2AMLogic/sky130-gcedram/design/README.md

# design

First design-sources increment (issue #14, T1 item 1 of the gap tracker,
#13): the 2T gain-cell bitcell schematic and its derived SPICE netlist.
Per [`docs/design-evidence-tiers.md`](https://github.com/2AMLogic/klayout-tools/blob/main/docs/design-evidence-tiers.md),
the pass condition is committed design sources **plus** a derived netlist
that is regenerated on design change -- presence and reproducibility, not a
one-off drop. This directory establishes that convention for the block; it
has no prior xschem usage to pattern-match against.

## What's here

| File | Purpose |
|---|---|
| [`gain_cell_2t.sch`](gain_cell_2t.sch) | xschem schematic: the ratified 2T gain-cell bitcell (see "Topology" below). |
| [`gain_cell_2t.spice`](gain_cell_2t.spice) | SPICE netlist **derived** from the schematic above via [`regen_netlist.sh`](regen_netlist.sh) -- not hand-written. Carries a provenance header (sha256 of the source `.sch`). |
| [`sense_latch.sch`](sense_latch.sch) / [`sense_latch.spice`](sense_latch.spice) | xschem schematic and derived netlist (same provenance-header convention) of the sense latch with footer/header (issue #109); see "Sense latch" below. |
| [`column_periphery.sch`](column_periphery.sch) / [`column_periphery.spice`](column_periphery.spice) | xschem schematic and derived netlist (issue #114, revised by #117) of the column-periphery slice: RBL and reference-side precharge PMOS, WBL write driver, rbl/ref nfet isolation gates. Sizing rationale, the ideal-vs-real comparison and the #117 isolation/driver sweep: [`sim/column-periphery/README.md`](../sim/column-periphery/README.md). |
| [`test_column_periphery.py`](test_column_periphery.py) | Stdlib drift test: the slice devices of the final variant (`f00_*`) of the #117 study deck must equal `column_periphery.spice`; the study baseline (`i00_*`) must equal the frozen #114 deck (which the revised schematic no longer equals); the latch devices of every instance must equal `sense_latch.sch`'s netlist; the netlist provenance hash must match the schematic. |
| [`regen_netlist.sh`](regen_netlist.sh) | Regenerates every netlist (bitcell, sense latch, column periphery) from its schematic (`--check` verifies each committed netlist is not stale). This is the "reproducible on design change" mechanism. |
| [`normalize_netlist.py`](normalize_netlist.py) | Evaluates xschem `expr()` geometry params and rewraps lines, so the netlist is identical across xschem versions (3.4.4 leaves them unevaluated). |
| [`test_sense_latch.py`](test_sense_latch.py) | Stdlib drift test: the latch devices in `sense_latch.spice` must equal those in `sim/sense-stage/sense_stage.spice`. |
| [`xschemrc`](xschemrc) | Project-local xschem config: resolves the sky130 PDK's symbol library without depending on `~/.xschem`. |
| [`env.sh`](env.sh) | Exports `PDK_ROOT`/`PDK` for interactive `xschem` sessions and for `regen_netlist.sh`. |

The PDK version pin itself (same `open_pdks` commit as `sim/leakage/` and
`sim/bitcell-transient/`) lives in [`docs/pdk-pin.md`](../docs/pdk-pin.md),
not a per-directory `pdk.json` -- see that doc for the single canonical
source and the shell/Tcl mirror `env.sh`/`xschemrc` above carry.

## Topology: 2T, ratified

This is the **2T** gain-cell bitcell (`2T-min`), per
[`spec/retention-refresh-budget.md`](../spec/retention-refresh-budget.md)
Section 6 ("this macro's baseline bitcell topology is ratified as 2T
(`2T-min`)"). It is **not** 3T -- the schematic deliberately has no third,
dedicated read-access device between the read transistor's drain and the
read bitline (the classic 3T addition that spec Section 6 explicitly
declines to adopt as the baseline).

Two devices, both `sky130_fd_pr__nfet_01v8` (the sky130 core 1.8 V NMOS --
no other `sky130_fd_pr` flavour appears anywhere in this schematic):

| Device | Gate | Drain | Source | Body | Sizing |
|---|---|---|---|---|---|
| `M_WR` (write-access) | `wl` | `sn` | `bl` | GND | W=0.42 µm, L=0.15 µm |
| `M_RD` (read) | `sn` | `rbl` | `rwl` | GND | W=0.42 µm, L=0.15 µm |

`M_WR`'s geometry is **identical, not merely similar**, to the access
device already measured in
[`sim/leakage/tb_access_leakage.spice.tmpl`](../sim/leakage/tb_access_leakage.spice.tmpl)
(W=0.42 µm, L=0.15 µm, the minimum drawn size the shipped model supports --
see [`sim/leakage/README.md`](../sim/leakage/README.md) "Device choice").
This is a deliberate reuse, not a fresh/independent sizing choice: it keeps
this schematic's write-access device the same physical device the
retention/refresh evidence chain
([`spec/retention-refresh-budget.md`](../spec/retention-refresh-budget.md))
already characterized, so capturing this schematic does not imply or
require a new leakage re-derivation.

`M_RD`'s sizing reuses the same minimum geometry as a first-pass
placeholder. This is **not** yet driven by a read-current or sense-margin
analysis -- no sense-amplifier design exists yet in this repo (the same
pre-design caveat [`sim/retention/README.md`](../sim/retention/README.md)
already carries for its `C_SN`/`delta_V` assumptions). Read-path sizing is
out of scope for this issue and expected to be revisited once sense-amp
work begins.

## Node naming

Kept consistent with [`sim/leakage/README.md`](../sim/leakage/README.md)'s
bias-condition table, since downstream testbenches reference those exact
names:

- **`wl`** -- (write) wordline, gate of `M_WR`. Same name/role as the
  leakage testbench's `wl`.
- **`sn`** -- storage node, drain of `M_WR` / gate of `M_RD`. Same name as
  the leakage testbench's `sn`. **Intentionally not a hierarchical port** --
  it is a genuine internal 2-pin net in the schematic (no external pin),
  matching real silicon, where the storage node has no accessible pin.
- **`bl`** -- (write) bitline, source of `M_WR`. Same name as the leakage
  testbench's `bl`.
- **`rwl`, `rbl`** -- read wordline / read bitline, source/drain of `M_RD`.
  New names (the leakage testbench only exercises the write/access device
  in isolation, so it has no read-path nodes to match); the `r`-prefix
  keeps them unambiguous against `wl`/`bl` while staying in the same
  naming family.

## Wordline drive scheme: plain 1.8 V (not boosted)

Recorded explicitly, per the repo README's "Supply" row ("boosted wordline
is a design decision to record"): **this schematic assumes a plain 1.8 V
wordline** -- `wl` and `rwl` both swing 0 V / `VDD` (the sky130 standard
core rail), **not** a boosted-above-`VDD` scheme.

Consequence, stated rather than silently absorbed: an NMOS pass device
(`M_WR`) driven by a plain-`VDD` wordline can only pull the storage node up
to `VDD - Vgs(M_WR)`, a threshold-voltage drop below a full logic '1' --
now measured and committed across all 15 PVT corners by
[`sim/bitcell-transient/`](../sim/bitcell-transient/README.md) (issue #27),
which supersedes the earlier uncommitted `tt`-only DC smoke check quoted
here (`v(sn) ≈ 1.39 V`): that figure is the `t -> infinity` DC asymptote, and
a real 20 ns wordline pulse reaches only 1.184 V at `tt`/27 °C, of which
wordline-to-storage-node feedthrough leaves 1.030 V retained -- with the
0.9 V sense margin `sim/retention/` assumes unattainable at three corners
(`fs`/-40 °C, `ss`/-40 °C, `fs`/27 °C). This schematic does not attempt to
compensate for that drop
(no charge pump / level-shifter is included) -- that is an open item for a
future write-margin analysis, not a claim that plain-`VDD` writing is
lossless. It does **not** change any already-ratified retention number:
[`spec/retention-refresh-budget.md`](../spec/retention-refresh-budget.md)'s
worst-case leakage/retention chain evaluates the storage node held at a
full `VDD` (a written logic '1'), independent of how that level got
written.

## Regenerating the netlist

Requires a stock `open_pdks` sky130 install (via `volare`, pinned in
[`docs/pdk-pin.md`](../docs/pdk-pin.md)) and `xschem` on `PATH`.

```bash
# 1. Install/enable the pinned PDK commit (skip if already enabled):
volare enable --pdk sky130 c6d73a35f524070e85faff4a6a9eef49553ebc2b

# 2. Export PDK_ROOT / PDK (defaults to ~/.volare / sky130A if unset):
source design/env.sh

# 3. Regenerate design/gain_cell_2t.spice and design/sense_latch.spice
#    from their .sch sources:
./design/regen_netlist.sh

# 4. Verify the committed netlist is not stale relative to the schematic
#    (no diff => reproducible; this is the check to run in CI/pre-merge):
./design/regen_netlist.sh --check
```

`regen_netlist.sh` also fails if any device instance in the regenerated
netlist resolves to a `sky130_fd_pr` flavour other than `nfet_01v8` -- a
deliberate deviation from the leakage study's device choice would need
this check updated alongside a PR description explicitly calling it out,
per this issue's acceptance criteria.

Interactive editing:

```bash
source design/env.sh
xschem --rcfile design/xschemrc design/gain_cell_2t.sch
```

## Sense latch (issue #109)

[`sense_latch.sch`](sense_latch.sch) is the design source of record for the
latch sense stage that `sim/sense-stage/`, `sim/sense-mismatch/` and
`sim/loaded-column/` characterize (previously it existed only as generated
SPICE under `sim/`). Ports: `rbl`, `ref`, `en`, `enb`, `vdd` (global `GND`);
`vn`/`vp` are internal virtual rails. The ideal precharge switch and the
matched dummy reference are **testbench elements and are not part of this
cell**.

| Device | Type | W (um) | L (um) | D | G | S | B |
|---|---|---|---|---|---|---|---|
| `MN1` | nfet_01v8 (latch) | 1.0 | 0.15 | `rbl` | `ref` | `vn` | GND |
| `MN2` | nfet_01v8 (latch) | 1.0 | 0.15 | `ref` | `rbl` | `vn` | GND |
| `MP1` | pfet_01v8 (latch) | 2.0 | 0.15 | `rbl` | `ref` | `vp` | `vdd` |
| `MP2` | pfet_01v8 (latch) | 2.0 | 0.15 | `ref` | `rbl` | `vp` | `vdd` |
| `MNF` | nfet_01v8 (footer) | 2.0 | 0.15 | `vn` | `en` | GND | GND |
| `MPH` | pfet_01v8 (header) | 4.0 | 0.15 | `vp` | `enb` | `vdd` | `vdd` |

**These sizes are provisional first-pass choices, not optimized.** They are
frozen exactly as `sim/sense-stage/gen_sense_stage.py` instantiates them so
provenance is fixed; this schematic makes no sizing claim, and a later
sizing issue may change them. `python3 -I design/test_sense_latch.py`
fails if the derived netlist and the sense-stage deck (names, model, W/L,
nets) ever diverge. In the deck, per-instance nets carry an `_<instance>`
suffix and ground is `0` (schematic `GND`); the test normalizes both.

## What's out of scope here

Per this issue's non-goals: layout, DRC/LVS, PVT corner sweeps of the full
cell, sense-amplifier design, and array/periphery integration are all
follow-on increments (items 2-7 of the #13 gap tracker) once these design
sources exist. This directory is schematic-capture + netlist-derivation
only.
