2AMLogic/sky130-gcedram/layout/README.md

# layout

First layout increment (issue #15, T1 item 2 of the gap tracker, #13): the
sky130 geometry for the ratified 2T gain-cell bitcell, built from the
schematic/netlist committed by issue #14
([`design/gain_cell_2t.sch`](../design/gain_cell_2t.sch),
[`design/gain_cell_2t.spice`](../design/gain_cell_2t.spice)). Per
[`docs/design-evidence-tiers.md`](https://github.com/2AMLogic/klayout-tools/blob/main/docs/design-evidence-tiers.md)
item 2, the pass condition is a committed GDS **plus** reproducibility from
sources -- presence and reproducibility, not a one-off manual drop, the same
bar item 1 (#14) already established for the schematic/netlist pair.

**Scope**: geometry capture only. This is *not* a formal, reported-and-signed
-off DRC/LVS pass, a PVT corner sweep, or characterization -- those are
separate, later T1 items (#13's checklist items 3-8). The informal `klt
drc`/`klt extract`/`klt lvs` iteration below exists to get the geometry
right, per this issue's own non-goals. Post-layout storage-node *parasitic
extraction* (previously also out of scope here) was added by issue #7 --
see [`gain_cell_2t.extract.parasitics.json`](gain_cell_2t.extract.parasitics.json)
below and [`sim/retention/README.md`](../sim/retention/README.md) for how
it feeds the retention-time re-derivation.

## What's here

| File | Purpose |
|---|---|
| [`gain_cell_2t.gds`](gain_cell_2t.gds) | The `2T-min` bitcell layout -- the top cell (`gain_cell_2t_layout_0`) this issue delivers. |
| [`generate.sh`](generate.sh) | Regenerates every artifact in this directory from `design/gain_cell_2t.spice`'s topology via `klt gen`/`klt gen-compose` (this is the "reproducible from sources" mechanism -- not a one-off manual drop). `--check` reruns into a scratch directory and asserts DRC-clean + LVS-match without touching the committed files. |
| [`gain_cell_2t_mos.gds`](gain_cell_2t_mos.gds) / [`.json`](gain_cell_2t_mos.json) | Intermediate `klt gen mos_array` block: the two transistors (`U0`=`M_WR`, `U1`=`M_RD`), before placement/routing. |
| [`gain_cell_2t_tap.gds`](gain_cell_2t_tap.gds) / [`.json`](gain_cell_2t_tap.json) | Intermediate `klt gen guard_ring` block: a P-substrate tap (`add_well=false`), so extraction resolves both devices' body terminal to a real `GND` net instead of the deck's synthesized global substrate net -- see "Topology mapping" below. |
| [`gain_cell_2t.layout.request.json`](gain_cell_2t.layout.request.json) | `klt gen-compose` request: places the two blocks above, routes the `sn` net, and labels `wl`/`bl`/`rwl`/`rbl`/`GND` as top-level pins. |
| [`gain_cell_2t.layout.json`](gain_cell_2t.layout.json) | `klt gen-compose` response for `gain_cell_2t.gds` -- placement/routing/port record. |
| [`gain_cell_2t.lvs_reference.spice`](gain_cell_2t.lvs_reference.spice) | Hand-transcribed plain-element (schematic-equivalent) copy of `design/gain_cell_2t.spice`'s two devices, in the shape `klt lvs` requires (see "Informal DRC/LVS iteration" below). A check fixture, not a second design source. |
| [`gain_cell_2t.lvs.request.json`](gain_cell_2t.lvs.request.json) | `klt lvs` request comparing `gain_cell_2t.gds` against `gain_cell_2t.lvs_reference.spice`. |
| [`gain_cell_2t.drc.result.json`](gain_cell_2t.drc.result.json), [`gain_cell_2t.extract.spice`](gain_cell_2t.extract.spice) / [`.json`](gain_cell_2t.extract.json), [`gain_cell_2t.lvs.result.json`](gain_cell_2t.lvs.result.json) | Captured results of the informal `klt drc`/`klt extract`/`klt lvs` iteration used to get this geometry right -- see below. Informal evidence, not a formal sign-off record. |
| [`gain_cell_2t.extract.parasitics.spice`](gain_cell_2t.extract.parasitics.spice) / [`.json`](gain_cell_2t.extract.parasitics.json) | Issue #7: post-layout first-order lumped RC parasitics extraction (`klt extract --parasitics --critical-net sn`) against this GDS, feeding the extracted `2T-min` storage-node capacitance (`C_SN`) used in [`sim/retention/derive_retention.py`](../sim/retention/derive_retention.py)'s retention-time re-derivation. Not part of the informal DRC/LVS iteration below (a separate, later extraction run against the same committed geometry). |

## Topology mapping: exactly #14's 2T schematic, no extra devices

`gain_cell_2t.gds`'s top cell (`gain_cell_2t_layout_0`) draws exactly the two
`sky130_fd_pr__nfet_01v8` devices `design/gain_cell_2t.sch` declares, same
connectivity, same sizing (W=0.42 um, L=0.15 um) -- built from two `klt gen
mos_array` unit devices (`U0`, `U1`), not a hand-drawn or one-off layout:

| Schematic device (#14) | Layout instance | Gate | Drain | Source | Body |
|---|---|---|---|---|---|
| `M_WR` (write-access) | `mos_array` unit `U0` | `wl` | `sn` | `bl` | `GND` (via the tap block) |
| `M_RD` (read) | `mos_array` unit `U1` | `sn` | `rbl` | `rwl` | `GND` (via the tap block) |

No third device is drawn -- this is the ratified `2T-min` topology per
[`spec/retention-refresh-budget.md`](../spec/retention-refresh-budget.md)
Section 6, not the 3T alternative that section explicitly declines to adopt
as baseline. `klt extract --deck sky130` against `gain_cell_2t.gds` confirms
`device_count: 2`, both class `nfet`:

```
$ klt extract gain_cell_2t.gds --deck sky130 --top gain_cell_2t_layout_0 -o gain_cell_2t.extract.spice
.SUBCKT gain_cell_2t_layout_0 GND bl rbl rwl sn wl
M$1 sn wl bl GND nfet L=0.15U W=0.42U AS=0.1974P AD=0.1974P PS=1.78U PD=1.78U
M$2 rbl sn rwl GND nfet L=0.15U W=0.42U AS=0.1974P AD=0.1974P PS=1.78U PD=1.78U
.ENDS gain_cell_2t_layout_0
```

`M$1`'s `d/g/s/b` = `sn/wl/bl/GND` and `M$2`'s `d/g/s/b` = `rbl/sn/rwl/GND`
match `design/gain_cell_2t.spice`'s `XM_WR sn wl bl GND ...` / `XM_RD rbl sn
rwl GND ...` node-for-node (`sn` is `M_WR`'s drain **and** `M_RD`'s gate in
both the schematic and this extraction, exactly the "gain" connection
[`design/README.md`](../design/README.md) describes). Both devices'
`b` (body) terminal resolves to the real net `GND`, matching the schematic's
explicit `body=GND` on both instances -- sky130's curated deck otherwise ties
an un-tapped NMOS body to a synthesized global substrate net rather than a
named one (see `klt extract`'s own "NMOS body" documentation in
[2AMLogic/klayout-tools](https://github.com/2AMLogic/klayout-tools/blob/main/docs/cli/extract.md)),
which is exactly why `generate.sh` composes a P-substrate tap
(`gain_cell_2t_tap.gds`, `add_well=false`) alongside the two transistors and
labels it `GND`.

`sn` (the storage node) is **not** promoted as a top-level pin here either --
consistent with `design/gain_cell_2t.sch`'s own choice (see that schematic's
"Node naming": no hierarchical port for `sn`, matching real silicon, where
the storage node has no accessible pin). `klt extract`'s default behaviour
promotes every top-level-labelled net to a `.SUBCKT` pin regardless
(`sn` included, above) -- a layout-tool-level difference from the schematic's
own pin list, not a topology difference; every *device* connection is
unchanged.

## Bill of devices / layers (informational)

`gain_cell_2t.gds`'s bounding box is `5.42 x 1.84` um -- a `mos_array` block
(`U0`/`U1`, `2.58 x 1.24` um) placed beside a `guard_ring` substrate-tap
block (`1.84 x 1.84` um), 1.0 um apart, per
[`gain_cell_2t.layout.request.json`](gain_cell_2t.layout.request.json)'s
`placement.strategy: "row"`. This is a single bitcell in isolation, not an
array cell with a shared tap row -- array/periphery integration (sharing one
tap ring across many bitcells) was explicitly out of scope for *this*
issue (see `design/README.md`'s own "What's out of scope here", items 2-7 of
the #13 gap tracker). A first, proof-of-technique shared-tap array built
from this same ratified cell now exists (issue #34, "Array (issue #34)"
below) -- see that section for how the shared tap changes this picture; full
macro-level array/periphery integration remains out of scope here.

## Regenerating the layout

Requires `klt` (klayout-tools) on `PATH` and a resolvable sky130A PDK (same
pin as `design/`'s -- see [`docs/pdk-pin.md`](../docs/pdk-pin.md)):

```bash
# 1. Install/enable the pinned PDK commit (skip if already enabled) and
#    export PDK_ROOT/PDK:
pip install ciel==2.6.1
ciel enable --pdk-family sky130 -l sky130_fd_pr f6eeac7dad085ffcc829ccfd721f7b4ce39edcf7
source design/env.sh

# 2. Regenerate every layout/*.gds/*.json artifact in place:
./layout/generate.sh

# 3. Check-only mode: regenerate into a scratch directory and assert
#    DRC-clean + LVS-match, without touching the committed files:
./layout/generate.sh --check
```

`generate.sh` runs, in order: `klt gen mos_array` (the two transistors),
`klt gen guard_ring` (the substrate tap), `klt gen-compose` (placement +
routing + pin labelling), then the informal `klt drc`/`klt extract`/`klt lvs`
iteration below -- failing loudly (nonzero exit) if DRC is not `clean` or LVS
is not `match`, so "reproducible from sources" is a checkable fact here too,
the same spirit as `design/regen_netlist.sh --check`'s staleness gate (though
not a byte-for-byte diff: a GDSII stream embeds a generation timestamp per
the format's own spec, so unlike `design/gain_cell_2t.spice`'s plain-text
netlist, a fresh `gain_cell_2t.gds` is not expected to diff byte-identical
against the committed one -- DRC/LVS status is the reproducibility gate
instead).

### Manual visual verification

Open the committed layout directly in KLayout to confirm the topology above
by eye (device count, gate/source/drain routing, the `sn` connection from
`M_WR`'s drain to `M_RD`'s gate):

```bash
klayout layout/gain_cell_2t.gds
```

## Informal DRC/LVS iteration (not a formal sign-off)

Per this issue's non-goals, the results below are the informal iteration
used to get this geometry right -- not a formally reported, signed-off
verification pass (that is a separate, later T1 item). Captured by
`generate.sh`, reproducible via `./layout/generate.sh --check`:

- **`klt drc --deck sky130`**
  ([`gain_cell_2t.drc.result.json`](gain_cell_2t.drc.result.json)): `status:
  "clean"`, `violation_count: 0` under klt 0.9.1 (the committed report's pin
  since #275) and under klt 0.8.0 after the issue #244 regeneration (the
  0.4.0-generated geometry gave `violations`, 34, under 0.8.0; it was `clean`,
  0, under 0.5.0) -- see "DRC under klt 0.8.0" and "DRC/LVS/ERC under klt
  0.9.1" below.
- **`klt extract --deck sky130`**
  ([`gain_cell_2t.extract.json`](gain_cell_2t.extract.json) /
  [`.spice`](gain_cell_2t.extract.spice)): `device_count: 2`, both `nfet`,
  connectivity as shown above.
- **`klt lvs`**
  ([`gain_cell_2t.lvs.result.json`](gain_cell_2t.lvs.result.json)) against
  [`gain_cell_2t.lvs_reference.spice`](gain_cell_2t.lvs_reference.spice) (a
  plain-element transcription of `design/gain_cell_2t.spice`'s two devices,
  in the schematic-equivalent shape `klt lvs` requires -- see that file's own
  header comment for why a transcription is needed rather than comparing
  against `design/gain_cell_2t.spice` directly): `status: "match"`,
  `devices: 2/2 matched`, `nets: 6/6 matched`. The nonzero `mismatch_count:
  2` is two `severity: "warning"` `topology` entries for the deck's
  always-registered-but-unused `pfet` device class (this bitcell is
  NMOS-only) -- the same known, non-blocking quirk
  [2AMLogic/klayout-tools' own worked example](https://github.com/2AMLogic/klayout-tools/blob/main/examples/design-pipeline/README.md)
  documents, not a real mismatch.

## Post-layout storage-node parasitic extraction (issue #7)

Not part of the informal DRC/LVS iteration above -- a separate, later
extraction run against the same committed `gain_cell_2t.gds`, feeding
`sim/retention/derive_retention.py`'s retention-time re-derivation:

```
$ klt extract layout/gain_cell_2t.gds --deck sky130 \
    --top gain_cell_2t_layout_0 --parasitics --critical-net sn \
    -o layout/gain_cell_2t.extract.parasitics.spice --format json \
    > layout/gain_cell_2t.extract.parasitics.json
```

Verified against the locally installed `klt 0.3.0` as of 2026-08-25 --
matches the flags documented in
[docs/cli/extract.md](https://github.com/2AMLogic/klayout-tools/blob/main/docs/cli/extract.md)
in 2AMLogic/klayout-tools, no discrepancy to file. `--parasitics` adds one
series R + one ground C per net (from the deck's curated sheet-resistance/
capacitance table); `--critical-net sn` additionally scopes the lateral
(same-layer sidewall) coupling-capacitance pass onto the storage node,
since `sn` couples to the adjacent `bl`/`rwl` routing. The storage node
`sn`'s reported parasitics
([`gain_cell_2t.extract.parasitics.json`](gain_cell_2t.extract.parasitics.json)'s
`parasitics.nets[]` entry for `sn`):

| Component | Value |
|---|---|
| Ground capacitance (junction + overlap + routing-to-substrate) | 0.586490 fF |
| Lateral coupling to `bl` | 0.010710 fF |
| Lateral coupling to `rwl` | 0.008154 fF |
| **Total `C_SN` (extracted)** | **0.605354 fF** |
| Series resistance (star, both device terminals) | 170.3519 Ω |

**Superseded by issue #244.** The table above records the extraction of the
pre-#244 geometry (klt 0.3.0). The committed
[`gain_cell_2t.extract.parasitics.json`](gain_cell_2t.extract.parasitics.json)
now holds the extraction of the klt-0.8.0-regenerated cell (klt 0.8.0): ground
0.655316 fF + coupling 0.017425 fF (`bl` + `rwl`) = **0.672741 fF**, star
resistance 199.3743 Ω. The pre-#244 GDS extracted with klt 0.8.0 reproduces
0.605354 fF exactly
([`results/gain_cell_2t.extract.parasitics_pre244_geometry_klt0.8.0_20261028.json`](results/gain_cell_2t.extract.parasitics_pre244_geometry_klt0.8.0_20261028.json)),
so the +0.067 fF is geometry, not the extractor. Re-ratifying 0.672741 fF is a
proposed spec decision, not yet ratified:
[`spec/c-sn-re-ratification-PROPOSED.md`](../spec/c-sn-re-ratification-PROPOSED.md).
See [`sim/retention/README.md`](../sim/retention/README.md) "Storage-node
capacitance" for how this total feeds the retention-time re-derivation.

## klayout-tools friction encountered

None blocking. `klt gen`/`klt gen-compose` (headless PCell generation +
placement/routing, see
[docs/cli/gen.md](https://github.com/2AMLogic/klayout-tools/blob/main/docs/cli/gen.md)
/
[docs/cli/gen-compose.md](https://github.com/2AMLogic/klayout-tools/blob/main/docs/cli/gen-compose.md)
in that repo) covered this two-transistor cell's geometry capture directly --
no hand-drawn polygons were needed. Two non-blocking rough edges worth
recording here for context (neither filed against klayout-tools: both are
already-documented, expected behaviour of shipped features, not gaps):

- `gen-compose`'s router rejects a same-block self-net (here, `sn`: `M_WR`'s
  drain to `M_RD`'s gate, both unit ports of the *same* `mos_array` block)
  on the base metal layer, since the Manhattan backbone would cross the
  intervening unit's own pad and draw a silent short -- resolved by routing
  that one net on a second metal level via `routing.cross_block_layer_role`
  (documented under gen-compose.md's "Cross-block bus routing"), not by
  filing anything.
- `klt lvs` requires the plain-element (schematic-equivalent) netlist form;
  `design/gain_cell_2t.spice` is in the simulation (X-card subcircuit-call)
  form with its `.subckt`/`.ends` wrapper deliberately commented out (`sn`
  has no external pin), so a hand-transcribed
  [`gain_cell_2t.lvs_reference.spice`](gain_cell_2t.lvs_reference.spice) was
  written for this comparison instead -- the same pattern
  klayout-tools' own worked example
  ([`examples/design-pipeline/07-reference.spice`](https://github.com/2AMLogic/klayout-tools/blob/main/examples/design-pipeline/07-reference.spice))
  already uses for exactly this reason, documented in `klt lvs`'s own
  "Netlist form" section rather than a surprise.

**Issue #7 (post-layout parasitics extraction) update**: no friction. `klt
extract --parasitics --critical-net sn` (see "Post-layout storage-node
parasitic extraction" above) behaved exactly as documented in
`docs/cli/extract.md` -- flag names, JSON `parasitics` block shape, and the
per-net ground/coupling capacitance breakdown all matched with no surprises.
Nothing filed against 2AMLogic/klayout-tools for this step.

## Array (issue #34): a shared-tap N_ROWS x N_COLS bitcell array

A second layout artifact, built from the **same** ratified 2T-min bitcell
above, replicated into a shared-tap array -- the first step of #24's item 1
("Array") toward a Chipalooza-submittable macro. This is a
**proof-of-technique increment, not a macro-sized array**: it demonstrates
that a shared substrate tap and per-row/per-column bus routing compose
cleanly from the same ratified device, at a size chosen to exercise that
technique -- it is explicitly **not** a ratification of
[`spec/retention-refresh-budget.md`](../spec/retention-refresh-budget.md)
Section 7's `N_rows`/`t_row_refresh_op` (that section states plainly neither
is ratified "until an array/periphery design lands" -- this is that design's
first increment, not its sign-off). Sense amplifier, refresh controller, SPI
interface, and formal macro-level DRC/LVS sign-off (#24 items 2-5) are all
still out of scope here.

### What's here

| File | Purpose |
|---|---|
| [`array_topology.py`](array_topology.py) | Single source of truth for the array's net map (row/column buses, per-cell `sn`), consumed by both the `klt gen-compose` request and the generated LVS reference netlist below -- so those two artifacts can never silently drift apart. Run standalone (`python3 array_topology.py --help`) or via `generate_array.sh`. |
| [`generate_array.sh`](generate_array.sh) | Regenerates every `gain_cell_2t_array*` artifact from `design/gain_cell_2t.spice`'s topology, mirroring [`generate.sh`](generate.sh)'s pattern (`klt gen mos_array` -> `klt gen-compose` -> `klt drc`/`extract`/`lvs`). `--check` reruns into a scratch directory and asserts DRC-clean + LVS-match without touching committed files. `N_ROWS`/`N_COLS` env vars override the default `4x4` (verified sizes: `2x2` and `4x4` -- see "Array dimensions" below). |
| [`gain_cell_2t_array_mos.gds`](gain_cell_2t_array_mos.gds) / [`.json`](gain_cell_2t_array_mos.json) | The intermediate `klt gen mos_array` block: all `2 * N_ROWS * N_COLS` transistors on one uniform grid, `add_guard_ring=true` -- **one** shared substrate tap ring around the whole array (contrast with the single-cell layout's own per-cell tap, "Bill of devices/layers" above). |
| [`gain_cell_2t_array.layout.request.json`](gain_cell_2t_array.layout.request.json) | `klt gen-compose` request generated by `array_topology.py --emit compose-request`: places the one `mos_array` block and routes every `wl_<r>`/`rwl_<r>`/`bl_<c>`/`rbl_<c>`/`sn_<r>_<c>` net. |
| [`gain_cell_2t_array.layout.json`](gain_cell_2t_array.layout.json) | `klt gen-compose` response for `gain_cell_2t_array.gds` -- placement/routing/port record; `unrouted_nets: []`. |
| [`gain_cell_2t_array.gds`](gain_cell_2t_array.gds) | The array layout -- the top cell (`gain_cell_2t_array_<R>x<C>_layout_0`) this issue delivers. |
| [`gain_cell_2t_array.lvs_reference.spice`](gain_cell_2t_array.lvs_reference.spice) | **Generated** (not hand-transcribed) plain-element LVS reference netlist -- `array_topology.py --emit lvs-reference` mechanically replicates `design/gain_cell_2t.spice`'s two-device subcircuit `N_ROWS x N_COLS` times with the same row/column bus net renaming the compose request uses, mirroring [`design/regen_netlist.sh`](../design/regen_netlist.sh)'s and [`gain_cell_2t.lvs_reference.spice`](gain_cell_2t.lvs_reference.spice)'s own precedent (a generated/transcribed check fixture, never a second hand-authored design source). Carries a sha256 provenance header against `design/gain_cell_2t.spice`, same convention as `design/gain_cell_2t.spice`'s own header. |
| [`gain_cell_2t_array.lvs.request.json`](gain_cell_2t_array.lvs.request.json), [`gain_cell_2t_array.drc.result.json`](gain_cell_2t_array.drc.result.json), [`gain_cell_2t_array.lvs.result.json`](gain_cell_2t_array.lvs.result.json) | Captured results of the informal `klt drc`/`klt lvs` iteration -- see below. Informal evidence, not a formal macro-level sign-off record (that is #24 item 5). |
| [`gain_cell_2t_array.extract.parasitics.spice`](gain_cell_2t_array.extract.parasitics.spice) / [`.json`](gain_cell_2t_array.extract.parasitics.json) | Issue #80: `klt extract --parasitics` of the committed `4x4` GDS, every signal net named `--critical-net`. See "Array bitline/wordline/storage-node parasitics (issue #80)" below. |
| [`gain_cell_2t_array.parasitics.summary.json`](gain_cell_2t_array.parasitics.summary.json) | Issue #80: per-net table, comparison against the 10 fF `C_RBL` and 0.605354 fF `C_SN` values, and the row-count scaling fit. Written by [`array_parasitics.py`](array_parasitics.py). |
| [`extract_array_parasitics.sh`](extract_array_parasitics.sh) | Issue #80: regenerates the three files above. It also rebuilds `2x4`/`4x4`/`8x4` arrays in a scratch directory for the scaling fit. |

### Array dimensions chosen, and why

`generate_array.sh` defaults to **`N_ROWS=4, N_COLS=4`** (32 transistors, 16
bitcells). This repo verified the technique at two sizes during this issue:

- **`2x2`** first, to validate the shared-tap + bus-routing mechanism with
  the smallest non-trivial case (every row/column bus still has 2 distinct
  endpoints, i.e. is a genuine multi-cell shared net, not a single pin).
- **`4x4`** next (`N_ROWS=2 N_COLS=2 ./layout/generate_array.sh --check` and
  the default `./layout/generate_array.sh --check` both pass as of this
  commit), chosen as the **committed** size because it is the larger of the
  two sizes issue #34's own implementation guidance suggested prototyping,
  and because it exercises a genuine 4-endpoint bus per row/column (not just
  2), a materially stronger proof that the technique -- not merely a
  2-cell special case -- generalizes.

Neither size is a macro-level commitment: `spec/retention-refresh-budget.md`
Section 7 explicitly defers ratifying `N_rows`/`t_row_refresh_op` to a later
array/periphery design pass, and this issue's own non-goals exclude that
ratification. `4x4` is a size chosen to be checkable in one CI-speed `klt
drc`/`klt lvs` iteration, nothing more.

### Topology mapping

Every bitcell (row `r`, column `c`) is exactly the single-cell layout's own
`M_WR`/`M_RD` pair (same device sizing, same connectivity shape), replicated
onto a `rows=N_ROWS, cols=2*N_COLS` `mos_array` grid (`topology="array"`,
row-major unit numbering): grid column `2*c` is `M_WR`, grid column `2*c+1`
is `M_RD` (unit index `idx = r*(2*N_COLS) + grid_col`) -- see
`array_topology.py`'s `mos_idx()`. This is the single-cell `mos_array`
shape (`cols=2`, `U0`=`M_WR`, `U1`=`M_RD`) tiled `N_ROWS x N_COLS` times, not
a new indexing scheme.

| Net | Connects | Shared across |
|---|---|---|
| `wl_<r>` | every `M_WR` gate in row `r` | every column `c` in that row |
| `rwl_<r>` | every `M_RD` source in row `r` | every column `c` in that row |
| `bl_<c>` | every `M_WR` source in column `c` | every row `r` in that column |
| `rbl_<c>` | every `M_RD` drain in column `c` | every row `r` in that column |
| `sn_<r>_<c>` | that one bitcell's `M_WR` drain to its own `M_RD` gate | nothing -- per-cell, internal |
| `GND` | the shared tap ring's `TAP_W` port | the whole array (one ring, not one tap per cell) |

`sn_<r>_<c>` is **not** promoted as a top-level pin (no `pins[]` entry) --
matching `design/gain_cell_2t.sch`'s and the single-cell layout's own
convention for `sn` ("Topology mapping" above). `klt gen-compose` still
labels every routed `connectivity[]` net (including `sn_<r>_<c>`) with its
net name, and `klt extract`'s default behaviour promotes every labelled net
to a `.SUBCKT` pin regardless -- the same layout-tool-level (not
topology-level) quirk already documented above for the single cell, not new
here. Every device's body terminal resolves to the real net `GND` via the
one shared tap ring, the same check "Topology mapping" above performs for
the single cell's own dedicated tap.

### Bill of devices/layers (informational, `4x4`)

`gain_cell_2t_array.gds`'s bounding box is `13.91 x 9.75` um (`bbox_um`
`{-1.195, -1.195}` to `{12.715, 8.555}`; `13.66 x 8.30` before issue #244) -- one `mos_array` block (32 transistors
on a uniform grid, `add_guard_ring=true`) with its own shared tap ring drawn
around it. `klt extract --deck sky130` confirms `device_count: 32`, all
class `nfet`, matching `2 * N_ROWS * N_COLS = 2*4*4 = 32`.

### Regenerating the array layout

Prerequisites: `source design/env.sh` (PDK at the pinned open_pdks commit)
and the two pinned klt toolchains below. Since issue #91 the script does
**not** use `klt` from `PATH`. See "Reproducing the committed array" next.

```bash
# One-time: create the pinned toolchain venvs (under .toolchains/, gitignored)
python3 layout/generation_toolchain.py install --role generation
python3 layout/generation_toolchain.py install --role check

# Regenerate every gain_cell_2t_array* artifact in place (default 4x4):
./layout/generate_array.sh

# Check-only mode (scratch dir, does not touch committed files): compares the
# regenerated geometry/connectivity with the committed 4x4 AND gates on
# routing/DRC/LVS/ERC. --record writes the run record.
./layout/generate_array.sh --check [--record PATH]

# A different array size (only 2x2/4x4 verified as of #34). This validates
# the generated size only; it does not reproduce the committed 4x4 baseline.
N_ROWS=2 N_COLS=2 ./layout/generate_array.sh --check
```

### Reproducing the committed array (issue #91)

The committed `gain_cell_2t_array.gds` (sha256 `4a1155...d4cd`) was built
in #34 with a klt that the scripts never recorded. The DRC/LVS reports
committed with it said `0.4.0`, and later ones said `0.6.0`, but neither
release reproduces it:

| Generation toolchain (KLayout 0.30.12) | `gain_cell_2t_array.gds` vs committed |
|---|---|
| PyPI `klayout-tools==0.4.0` | fails: `mos_array` has no `add_guard_ring` parameter |
| PyPI `0.5.0` / `0.6.0` | 24 met1 cross-block route segments drawn 140 nm wide, committed 170 nm |
| PyPI `0.7.0` | as above, plus every licon/mcon cut 0.17 um, committed 0.22 um |
| git `5826244d` (parent of the #1620 width change) | GDS byte-identical; `_mos.gds` has extra PCell context params |
| **git `2dd24b09e756`** | **all 7 compared artifacts byte-identical** |

The cause is two documented generator changes in klayout-tools, not
nondeterminism. klayout-tools #1620 (in 0.5.0) gave
`cross_block_layer_role` legs their own width, which defaults to the
layer minimum. klayout-tools #2594 (in 0.7.0) clamps sky130 licon/mcon cuts
to 0.17 um. The extra `_mos.gds` PCell parameters come from klayout-tools
#1577/#1580. The pin is therefore the last revision before #1577:

- **generation** (`klt gen`, `klt gen-compose`): PyPI `klayout-tools==0.8.0`
  with `klayout==0.30.12` (issue #244). The table above records why the
  pre-#244 pin was the 0.4.0-era git revision `2dd24b09e756`; that revision's
  guard-ring and `mos_array` output violates the 0.8.0 deck's
  `licon1.ongrid.1` and `poly.endcap.diff.1`, and the 0.8.0 generators do not.
  The 4x4 array regenerated in a scratch directory reproduces the committed
  array byte-for-byte (`baseline comparison: match`). 0.8.0 is still the newest
  release that does -- see "Generation and check pins diverge at klt 0.9.1"
  below. KLayout stays pinned (with `klayout==0.30.10` PCell
  context serialization differs).
- **check** (`klt drc`, `klt lvs`, `klt erc`): PyPI `klayout-tools==0.9.1`
  with `klayout==0.30.12` (issue #275). This is the same release
  `.github/workflows/signoff.yml` grades with (`KLT_VERSION`), and the one the
  committed DRC/LVS/ERC reports record. It is a release pin, so
  `generation_toolchain.py` checks the exact
  package version and rejects a git install (no commit is probed). klt 0.7.0
  could not run this ERC spec: it rejected the spec's `_comment` key
  (klayout-tools #2822). 0.8.0 accepts it unchanged (measured, #242), and so
  does 0.9.1 (measured, #275).
- **PDK**: sky130A at open_pdks `f6eeac7d...` (`docs/pdk-pin.md`), read from
  `$PDK_ROOT/$PDK/SOURCES`.

Both pins live in [`generation-toolchain.json`](generation-toolchain.json).
[`generation_toolchain.py`](generation_toolchain.py) checks them before
`generate_array.sh` or `extract_array_parasitics.sh` writes anything. It
probes the interpreter's installed `klayout-tools` commit (from pip's
`direct_url.json`), its package version and its `klayout` version. If the
toolchain is missing or different, the script exits 2, prints the expected
and actual values plus the install command, and writes nothing. Set
`GCEDRAM_KLT_GENERATION_PYTHON` / `GCEDRAM_KLT_CHECK_PYTHON` to use an
existing environment instead of the default `.toolchains/` venvs; it still
has to pass the same identity check. To set one up by hand:

```bash
uv venv .toolchains/klt-generation-2dd24b09e756-klayout-0.30.12
uv pip install --python .toolchains/klt-generation-2dd24b09e756-klayout-0.30.12/bin/python \
  "klayout-tools @ git+https://github.com/2AMLogic/klayout-tools@2dd24b09e7569581297aabf9738594e9791210f1" \
  "klayout==0.30.12"
```

**What `--check` compares**
([`compare_array_layout.py`](compare_array_layout.py)), at the committed
4x4 size only:

- **Geometry and labels**: `gain_cell_2t_array.gds` and
  `gain_cell_2t_array_mos.gds`. Every BOUNDARY, PATH, BOX, TEXT, SREF and
  AREF element is compared record by record: layer, datatype, every vertex,
  path width, text string and position, transforms and properties (including
  PCell context). Structure names and the library units are compared too.
- **Connectivity**: the generator reports `gain_cell_2t_array.layout.json`
  (per-net pins, legs, route status and length, unrouted nets) and
  `gain_cell_2t_array_mos.json` (ports, device count), compared as parsed
  JSON. The connectivity inputs `gain_cell_2t_array.layout.request.json`,
  `gain_cell_2t_array.lvs_reference.spice` and
  `gain_cell_2t_array.lvs.request.json` are compared exactly. LVS `match`
  against the reference is still required on top.
- **Normalization, and nothing else**: GDS BGNLIB/BGNSTR timestamps,
  element order within a structure (compared as a multiset, so a duplicate
  or missing element still fails), null padding after ENDLIB, and JSON
  whitespace/key order. Nothing is merged, snapped or rounded.
- Raw sha256 hashes are reported separately from the canonical comparison.
  A timestamp-only change shows as "raw differs, MATCH".

Any difference fails `--check`, even when routing, DRC, LVS and ERC all
pass. As a negative control, `main`'s old status-only `--check` run with
klt 0.7.0 passed routing, DRC (`clean`) and LVS (`match`) on the drifted
geometry. It then crashed at ERC on the `_comment` key. At other sizes
(`N_ROWS`/`N_COLS` not 4x4) there is no committed baseline. The comparison
is skipped, and the script says that it only validated the generated size.

**Reproduction run** (committed:
[`results/generation_reproduction_20261011.json`](results/generation_reproduction_20261011.json),
from `./layout/generate_array.sh --check --record ...`): it records the
source commit, both toolchain identities, the PDK identity, every klt
command, the full comparison and the statuses. All 7 artifacts are
byte-identical (comparison `match`). Routing is complete, DRC is `clean`,
LVS is `match` and ERC is `clean`. In a kept scratch copy of the same run, the
regenerated `gain_cell_2t_array.drc.result.json` and `.lvs.result.json` were
also byte-identical to the committed reports. The ERC report differed only in
its `file`/`spec` path fields, because scratch runs use cwd-relative paths. No
committed layout, evidence or manifest file is changed by issue #91.

Fixtures, with no klt or PDK needed:
`python3 -I layout/test_generation_reproducibility.py`. They cover a moved
vertex, a route width or layer change, a renamed or moved label, a moved
instance, deleted and duplicated elements, changed units, a changed pin
connection or route length in the report, and timestamp-only, reorder-only
and padding-only changes that must still match. They also cover absent,
mismatched and wrong-role toolchains and a mismatched PDK, with both scripts
exiting before any file under `layout/` changes. The fixtures also check that
the check pin equals `signoff.yml`'s `KLT_VERSION` and that the PDK pin equals
`sim/_evidence_common.py`.

The single-cell `generate.sh` is not covered by this pin; it is outside
#91's scope.

### Informal DRC/LVS iteration (not a formal sign-off), `4x4`

Same informal bar as the single-cell layout above -- not a formally
reported, signed-off verification pass (#24 item 5):

- **`klt drc --deck sky130`**
  ([`gain_cell_2t_array.drc.result.json`](gain_cell_2t_array.drc.result.json)):
  `status: "clean"`, `violation_count: 0` under klt 0.9.1 (the committed
  report's pin since #275) and under klt 0.8.0 after the issue #244
  regeneration (the 0.4.0-generated geometry gave `violations`, 64, under
  0.8.0; it was `clean`, 0, under 0.6.0) -- see "DRC under klt 0.8.0" and
  "DRC/LVS/ERC under klt 0.9.1" below.
- **`klt lvs`**
  ([`gain_cell_2t_array.lvs.result.json`](gain_cell_2t_array.lvs.result.json))
  against the generated
  [`gain_cell_2t_array.lvs_reference.spice`](gain_cell_2t_array.lvs_reference.spice):
  `status: "match"`, `devices: 32/32 matched`, `nets: 33/33 matched`. The
  nonzero `mismatch_count: 2` is the same two `severity: "warning"`
  `topology` entries for the deck's always-registered-but-unused `pfet`
  device class already documented above for the single cell -- not a real
  mismatch, not new to the array.

### DRC under klt 0.8.0 (issue #242)

Bumping the check toolchain from 0.6.0 to 0.8.0 re-ran DRC against the
*unchanged* committed GDS and the verdict got worse; the reports record it as
found, the layout and the spec were not touched to make it pass:

| Report | 0.6.0 | 0.8.0 |
|---|---|---|
| `gain_cell_2t.drc.result.json` | clean, 0 | violations, 34: `licon1.ongrid.1` x32, `poly.endcap.diff.1` x2 |
| `gain_cell_2t_array.drc.result.json` | clean, 0 | violations, 64: `licon1.ongrid.1` x32, `poly.endcap.diff.1` x32 |

Both rules are new in the 0.8.0 deck (`licon1.ongrid.1` flags licon vertices
off the 0.005 um grid, all in the generator-drawn `guard_ring`/`mos_array`
cells). LVS stays `match` and ERC stays `clean`. As a result T1 item 3 (DRC)
in `block-manifest.signoff.json` flipped from `met` to `unmet`
(`t1_met_count` 3 -> 2). `generate_array.sh` and `generate.sh` require
a `clean` DRC from the check toolchain, so their `--check` runs failed.

**Resolved (issue #244).** Regenerating with the klt 0.8.0 generators (the
`generation` pin in `generation-toolchain.json` is now `klayout-tools==0.8.0`,
params unchanged, no GDS post-edit, no rule waived, deck untouched) gives a
layout that is DRC clean under the 0.8.0 deck:

| Report | 0.4.0-generated geometry, 0.8.0 deck | 0.8.0-generated geometry, 0.8.0 deck |
|---|---|---|
| `gain_cell_2t.drc.result.json` | violations, 34 | clean, 0 |
| `gain_cell_2t_array.drc.result.json` | violations, 64 | clean, 0 |

The cause was in the generators, as suspected (the off-grid licon pitch of the
guard ring and the short gate endcap); a newer release fixes both. LVS stays
`match` (2/2 devices, 32/32 for the array) and ERC stays `clean`. T1 item 3 is
`met` again (`t1_met_count` 3). The cost is geometry: the single cell is
1.84 -> 2.115 um tall (bbox 5.92 x 2.115 um, was 5.42 x 1.84), the array
bitcell pitch grew 1.64 -> 1.94 um (`results/density_20261028_v244.json`), and
the extracted single-cell `C_SN` moved 0.605354 -> 0.672741 fF. Operator ruling
2026-10-28 (option a) accepted the regenerated layout; the `C_SN`
re-ratification is a separate, still-proposed spec decision
([`spec/c-sn-re-ratification-PROPOSED.md`](../spec/c-sn-re-ratification-PROPOSED.md)).
Refreshed evidence: DRC/LVS/ERC reports, `gain_cell_2t.extract.json`, both
parasitics extractions, `gain_cell_2t_array.parasitics.summary.json`,
`block-manifest.json` content hashes, `block-manifest.signoff.json`. The
earlier failure history above is kept; superseded git history holds the old
reports.

### DRC/LVS/ERC under klt 0.9.1 (issue #275)

The check pin moved 0.8.0 -> 0.9.1 to track
`.github/workflows/signoff.yml`'s `KLT_VERSION`. The 0.9.1 sky130 deck is a
different deck (`provenance.deck.content_hash`
`sha256:ba0f9788...` -> `sha256:029ef177...`), so every committed DRC/LVS
report read `status: drifted` under `klt drc --check` / `klt lvs --check`
until it was regenerated. Re-run against the **unchanged** committed GDS,
every verdict holds:

| Report | 0.8.0 | 0.9.1 |
|---|---|---|
| `gain_cell_2t.drc.result.json` | clean, 0 | clean, 0 |
| `gain_cell_2t_array.drc.result.json` | clean, 0 | clean, 0 |
| `gain_cell_2t.lvs.result.json` | match (2 `pfet` warnings) | match (2 `pfet` warnings) |
| `gain_cell_2t_array.lvs.result.json` | match (2 `pfet` warnings) | match (2 `pfet` warnings) |
| `gain_cell_2t_array.erc.result.json` | clean, 0 findings | clean, 0 findings |

The 0.9.1 deck checks **three rules more** on this geometry
(`diff.space.1`, `poly.space.1`, `tap.space.1`: 44 -> 47 rules checked), all
passing, and discloses 21 more `unmodeled_rules` (33 -> 54, e.g. `poly.3`,
`licon.13`, the `capm`/`cap2m` family) -- a wider, more honest coverage
statement over the same geometry, not a relaxation. The LVS report schema
moved 2 -> 3 (`reference` became a `{path, scope}` object; an
`excluded_pins` field was added) and the ERC coverage block gained
`missing_tie_checked: true`. T1 items 3, 4 and 11 stay `met`.

### Generation and check pins diverge at klt 0.9.1 (issue #275)

The two pins in [`generation-toolchain.json`](generation-toolchain.json)
coincided from #244 until #275. They no longer do: **generation stays
`0.8.0`, check moves to `0.9.1`.**

Measured on 2026-11-14 with a 0.9.1 generation toolchain (same
`klayout==0.30.12`, same `array_topology.py` params, same PDK pin),
`./layout/generate_array.sh --check` reports `baseline comparison:
mismatch`. The cause is **naming, not geometry**: klt 0.9.1's `gen mos_array`
emits its inner PCell structure as `<cell-name>__core`
(`gain_cell_2t_array_mos__core`) where 0.8.0 emitted the library name
`mos_array`, and it adds a `dogbone_terminals` PCell parameter to the
`$$$CONTEXT_INFO$$$` record. Structure names and PCell context live in the
GDS, so the bytes differ.

What is drawn does not. Flattening the committed and the 0.9.1-regenerated
`gain_cell_2t_array_4x4_layout_0` and XOR-ing them layer by layer gives an
**empty XOR on all 10 layers**, with identical bounding box
(`-1.195,-1.195 ; 12.715,8.555` um) and an identical set of 33 labels; the
scratch run is DRC `clean`, LVS `match`, ERC `clean`. So the committed
geometry remains the geometry 0.9.1 would produce, and no density, `C_SN`,
parasitic or retention number is affected.

Bumping the generation pin to 0.9.1 was therefore rejected: it would make
`generate_array.sh --check` fail against the committed baseline, and
re-generating the array to satisfy it would change
`gain_cell_2t_array.gds`'s content hash for a cell rename, invalidating every
extraction, parasitics, density and sim-side report that cites that hash --
cost with no geometric benefit. The generation pin's contract is "the release
that reproduces the committed GDS byte-for-byte", and that release is still
0.8.0. `layout/test_generation_reproducibility.py::ToolchainGuard::test_config_pins`
no longer asserts the two pins are equal; it requires the generation pin to
carry its reproduction evidence in `verified` and, when the pins differ, to
name the check pin and say why.

Filed upstream as klayout-tools #5627: a generator whose emitted inner-cell
name changes between releases cannot reproduce a committed GDS byte-for-byte
even when the drawn geometry is unchanged, and there is no flag to pin the
emitted name.

A second gap surfaced while regenerating the attestation envelopes, filed as
klayout-tools #5628: `klt signoff --attest` strips its own venv `bin` from
`PATH` for the commands an inventory declares (so a bare `python3` is the
repo's), which also means a declared `klt drc --check ...` audit runs whatever
*other* `klt` is on `PATH` rather than the attesting one. On a host whose
`~/.local/bin/klt` is a dev build, `attest 10` therefore refused a correct
envelope for a deck drift that does not exist under the pinned release. Until
that is fixed, regenerate envelopes with a symlink to the pinned `klt` in a
directory that is **not** the tool venv's `bin`, prepended to `PATH`:

```bash
python3 layout/generation_toolchain.py install --role check   # .toolchains/klt-check-v<ver>-klayout-<ver>
mkdir -p /tmp/klt-pinned && ln -sf "$PWD/.toolchains/klt-check-v0.9.1-klayout-0.30.12/bin/klt" /tmp/klt-pinned/klt
PATH=/tmp/klt-pinned:$PATH klt signoff --attest 10 --inventory attest/item10.json -o attest/item10.envelope.json
```

### `klt erc` supply spec (structural power delivery, T1 item 11; issue #39)

The structural power-delivery evidence T1's item 11 grades -- distinct from
the informal DRC/LVS iteration above, it is the graded artifact, not geometry
debugging (issue #39). Two committed files:

- **[`erc-supply-spec.json`](erc-supply-spec.json)** -- the supply spec: the
  gate-poly/li1/met1 stackup this block actually draws (with
  `active_layer` diff 65/20 for a physical `poly ∩ diff` gate-area
  denominator), the `licon1`/`mcon` vias, one declared supply net, `GND`
  (the array's only rail is the substrate/bulk, `.GLOBAL GND` in the LVS
  reference, tapped by the shared guard ring), and (issue #54) one
  `ties[]` entry, `psub_guard_ring`. The spec's own `_comment` block
  justifies every entry.
- **[`gain_cell_2t_array.erc.result.json`](gain_cell_2t_array.erc.result.json)** --
  the run against the committed GDS, produced by klt v0.9.1
  (PyPI `klayout-tools==0.9.1`, previously `0.8.0`, before that
  `c622e8addb36`/0.6.0) **from the repository root**
  (`klt signoff` re-reads the spec the report names relative to its own
  working directory, so the report must record `layout/erc-supply-spec.json`):

  ```
  klt erc layout/gain_cell_2t_array.gds layout/erc-supply-spec.json \
    --pdk sky130 --format json > layout/gain_cell_2t_array.erc.result.json
  ```

  - `status: "clean"`, `erc_status: "clean"`, `erc_finding_count: 0` --
    **GND resolved to exactly one electrical island** (no
    `erc.unconnected_net`, no `erc.supply_short`; the
    `erc.net_connectivity:["GND"]` check is in `erc_coverage.checked`).
  - All 20 gate nets pass the antenna-ratio verdict against sky130's real
    table (li1 75, met1 400) -- carried in the same report, not graded by
    item 11.
  - **Substrate tie, checked by well assertion (issue #54).** sky130's
    p-substrate is not a drawn layer and this all-NMOS stream draws no
    nwell, so the tie is declared with `well_layer: null` and `well_boxes`
    (klayout-tools#2255) against the tap-only layer 65/44
    (`tap_is_dedicated: true`, `connect_to: li1`, `net: GND`).
    `well_boxes` are the four edge strips of the guard ring, read from the
    committed GDS: the merged 65/44 shape is one ring, outer edge
    (-1.07, -1.07)-(12.59, 8.43) um, inner edge (-0.65, -0.65)-(12.17, 8.01) um
    (0.42 um wide). These coordinates are the 4x4 regenerated in issue #244
    (the pre-#244 array was 7.23 / 6.81 um tall); the spec's `well_boxes`
    were moved with the ring, because a stale box set would still grade
    `clean` while asserting a region that is no longer the ring. The identity `erc.missing_tie:["psub_guard_ring"]`
    appears in both `erc_coverage.checked` and
    `erc_coverage.checked_by_well_assertion`; `skipped` and `inapplicable`
    are empty; there are zero `erc.missing_tie` findings.
  - **What the assertion does and does not cover.** It asserts that the
    substrate under the guard ring is tied to GND through a tap that reaches
    the GND conductor, and `klt erc` verified that against the drawn tap.
    It does not claim every point of substrate inside the ring is tied;
    that continuity runs through bulk silicon, which `klt erc` does not
    model, and rests on the array LVS (bulk terminals matched, `GND` paired).
    The ring's enclosing rectangle is deliberately not asserted: it equals
    the top-cell extent (before issue #244; within 0.125 um of it since) and
    is skipped as `degenerate_well_assertion`.
  - Fresh: `provenance.input.content_hash`
    `sha256:2bcd6e1bb7eff7b248d77b45500972448f050089d4cf3f38300915b612fcdcce`
    matches the committed `gain_cell_2t_array.gds` (regenerated in #244; it
    was `4a1155...d4cd`), and
    the spec's content hash is pinned in `provenance.spec`.
- **[`gain_cell_2t_array.lvs.result.json`](gain_cell_2t_array.lvs.result.json)**
  and **[`gain_cell_2t_array.drc.result.json`](gain_cell_2t_array.drc.result.json)**
  -- refreshed with klt v0.9.1 (#275) against the committed GDS regenerated in #244
  (`klt lvs gain_cell_2t_array.lvs.request.json`, `klt drc
  gain_cell_2t_array.gds --deck sky130`, from `layout/`): LVS `match` with
  `GND` paired, carrying `provenance.input`; DRC **`clean`** (0; it was 64
  violations on the pre-#244 geometry, see
  "DRC under klt 0.8.0" below).

#### Item 11 in the signoff record

`block-manifest.json` cites `"11.analog"` only: the ERC report and the array
LVS report as separate parts, each pinned (`content_hash`) to the array
layout hash above, so the digital partition borrows nothing. The graded
state is in [`block-manifest.signoff.json`](../block-manifest.signoff.json)
(`klt signoff --manifest block-manifest.json --format json`, from the repo
root): item 11 is `met` for analog, with
`power_delivery.ties_checked_by_well_assertion` naming `psub_guard_ring`
(the weaker, asserted-region provenance is stated in the verdict), and
`unmet`/`no_evidence` for digital. This is one T1 row, not tier completion.

Controls (run in scratch, not committed; results recorded in the issue #54 pull request):
a stream with 65/44 removed, and a spec whose `well_boxes` exclude the ring,
each raise `erc.missing_tie`; a spec asserting the whole top-cell bounding
box is skipped as `degenerate_well_assertion` and item 11 renders
`supply_spec_incomplete`.

### klayout-tools friction encountered

Real friction this time, but **already tracked upstream** -- nothing new
filed against [2AMLogic/klayout-tools](https://github.com/2AMLogic/klayout-tools):

- Routing the four `wl_<r>`/`rwl_<r>`/`bl_<c>`/`rbl_<c>` buses plus every
  per-cell `sn_<r>_<c>` net in one `gen-compose` call, all as same-block
  self-nets on one `mos_array` block, hit exactly the two gaps
  [2AMLogic/klayout-tools#1467](https://github.com/2AMLogic/klayout-tools/issues/1467)
  ("no track or layer assignment between nets, so the first routed net
  rejects the rest") and
  [2AMLogic/klayout-tools#1531](https://github.com/2AMLogic/klayout-tools/issues/1531)
  ("`mos_array`'s own multi-row/column footprint blocks routing to interior
  unit pins") already describe -- both closed (`completed`) the same day
  this issue was built, independently of this repo's own work. Naively
  routing the buses and every `sn_<r>_<c>` together (any connectivity
  order, with or without `routing.cross_block_layer_role`) left some subset
  of `sn_<r>_<c>` nets `unrouted` (`crosses already-routed net '<bus>'`),
  or, once forced onto a caller-chosen path via `connectivity[].waypoints_um`
  to dodge that, tripped an `li1.space.1` `klt drc` violation against a
  neighbouring unit's own gate-contact landing pad -- exactly the "single
  generator's own emitted geometry making some of its own declared pins
  structurally unreachable" and "no track assignment between nets"
  symptoms those two issues already document.
- **Workaround used** (matches the workaround pattern those issues
  describe, not a new technique): route the four bus types first, left to
  `gen-compose`'s own automatic same-block routing (every bus composed
  cleanly with no explicit help, at both `2x2` and `4x4`); route each
  per-cell `sn_<r>_<c>` net **last**, with one explicit
  `connectivity[].waypoints_um` point (`M_WR`'s own drain x + a small fixed
  clearance, `M_RD`'s own gate y -- see `array_topology.py`'s
  `SN_WAYPOINT_X_OFFSET_UM`) forcing a "rise, then jog" backbone shape that
  reaches `M_RD`'s gate without crossing the neighbouring unit's own pads or
  the already-routed buses. The `0.2um` offset was tuned by `klt drc`
  iteration (the smallest of a few tried values that cleared
  `li1.space.1`) -- `array_topology.py`'s own comment on that constant
  records this was not derivable from a value `klt gen-compose` exposes to
  a caller, itself an instance of the gap those two upstream issues
  describe.

## Array bitline/wordline/storage-node parasitics (issue #80)

> **Numbers below are the pre-#244 geometry.** The committed array extraction
> and [`gain_cell_2t_array.parasitics.summary.json`](gain_cell_2t_array.parasitics.summary.json)
> were regenerated on the klt-0.8.0 layout (issue #244, extractor klt 0.8.0,
> was `0.7.0+gd1e9e119331f`); the tables and hashes in this section describe
> the earlier extraction and are kept as the record of what #80 found. For the
> current per-net values read the summary JSON. Storage node, current:
> single cell 0.672741 fF, array `sn_<r>_<c>` 0.538402 -- 0.568080 fF
> (`sim/retention/results/array_c_sn_comparison_20261028T070954Z.json`).

This is an extraction of the committed `4x4` array. It changes no layout.
Its job is to replace the read-bitline load that the sense path currently
assumes with an extracted number, and to check the storage-node value in
the array. It does **not** edit the sense input contract, the sense-stage
deck, or any spec file. Re-running the sense stage with the extracted load
is a separate follow-up.

```bash
source design/env.sh
./layout/extract_array_parasitics.sh
# same, writing the extraction + summary to a scratch dir instead of layout/
# (issue #91; needs the pinned generation/check toolchains, see above):
./layout/extract_array_parasitics.sh --out-dir /tmp/array-parasitics
# freshness of the committed extraction, without re-running (repo root):
klt extract --check layout/gain_cell_2t_array.extract.parasitics.json
```

Part 1 runs this against the committed `gain_cell_2t_array.gds`:

```
klt extract layout/gain_cell_2t_array.gds --deck sky130 \
  --top gain_cell_2t_array_4x4_layout_0 --parasitics \
  --critical-net wl_0 ... --critical-net sn_3_3    # all 32 signal nets
  -o layout/gain_cell_2t_array.extract.parasitics.spice --format json
```

Every `wl_<r>`, `rwl_<r>`, `bl_<c>`, `rbl_<c>` and `sn_<r>_<c>` net is named
`--critical-net`. That way the lateral coupling pass covers every
signal-net pair, not just the storage node as in the single-cell run (#7).
The run used klt `0.7.0+gd1e9e119331f` (KLayout 0.30.12). Status is
`extracted` with 32 devices, all `nfet`, and no warnings. The input hash
`sha256:4a1155...d4cd` matches the committed GDS, the same hash the ERC
report records.

**Convention.** `total = ground + every coupling capacitor reported on the
net`. This is the same sum `sim/retention/derive_retention.py`'s
`load_extracted_c_sn()` uses. Counting coupling as load assumes the
neighbouring nets are quiet, which slightly overstates the load. The
extractor also adds lateral coupling on top of the substrate fringe term
instead of subtracting it, so the coupling column leans pessimistic.
**These are wiring parasitics only.** `by_layer` lists poly, li1 (`metal0`)
and met1 (`metal1`), and no diffusion. Device junction and gate
capacitance are not included here. They come from the extracted device
cards (`AD/AS/PD/PS`, `W/L`) and the BSIM model at simulation time.

### Per-column bitlines (`4x4`)

| Net | Ground (fF) | Coupling (fF) | Total (fF) | Lumped R (ohm) |
|---|---|---|---|---|
| `rbl_0`, `rbl_1`, `rbl_2` | 0.581168 | 0.278011 | **0.859179** | 385.481 |
| `rbl_3` (array edge) | 0.596076 | 0.102204 | 0.698280 | 385.481 |
| `bl_0` (array edge) | 0.596076 | 0.115821 | 0.711897 | 385.481 |
| `bl_1`, `bl_2`, `bl_3` | 0.581168 | 0.291628 | 0.872796 | 385.481 |

The largest single coupling on an interior `rbl_<c>` is 0.129795 fF to the
next column's write bitline `bl_<c+1>`. The two are adjacent li1 column
buses. The rest is 4 x 0.019738 fF to `rwl_*`, 0.01071 + 2 x 0.024327 fF to
three of its column's `sn_*`, and 3 x 0.0033 fF to `wl_*`.

### Per-row wordlines (`4x4`, 4 columns per row)

| Net | Ground (fF) | Coupling (fF) | Total (fF) | Lumped R (ohm) |
|---|---|---|---|---|
| `wl_0` | 1.909279 | 0.189768 | 2.099047 | 434.2748 |
| `wl_1`, `wl_2` | 1.909279 | 0.180892 | 2.090171 | 434.2748 |
| `wl_3` (array edge) | 1.913750 | 0.063784 | 1.977534 | 434.2748 |
| `rwl_0` .. `rwl_3` | 1.187129 | 0.166126 | 1.353255 | 57.8391 |

The ground term of `wl_<r>` splits into 0.695682 fF poly (the gates'
poly runs), 0.299611 fF li1 and about 0.914 fF met1. `rwl_<r>` has no poly
term: 0.299611 fF li1 and 0.887517 fF met1. Wordline loads grow with
`N_COLS`, not `N_ROWS`. Only `N_COLS = 4` was extracted, so no column-count
scaling is reported.

### Comparison with the `C_RBL` = 10 fF assumption

[`sim/sense-stage/gen_sense_stage.py`](../sim/sense-stage/gen_sense_stage.py)
line 46 sets `C_RBL_F = 10e-15`, labelled "ASSUMPTION (contract; not
extracted)". That deck puts the four rows' `M_RD` devices on the read
bitline as explicit transistors and adds `C_RBL` as a lumped capacitor
beside them. So the extracted quantity to compare against is the
**wiring** load, which is what this table reports.

- **Extracted, 4 rows: worst-case `rbl_<c>` total is 0.859179 fF**
  (0.581168 fF ground + 0.278011 fF coupling). That is **0.086x the
  assumption**, about 11.6 times smaller. Ground capacitance alone is
  0.058x.
- So, for the 4-row column the contract studies, the 10 fF value is not
  supported by extraction. It overstates the read-bitline wiring load by
  about an order of magnitude. Which way that moves each sense result
  (separation, decision time, the ss/-40 C sensitivity the contract notes)
  can only be settled by re-running those decks. That re-run is the
  follow-up and is not done here.
- Device junction caveat. The extracted `M_RD`/`M_WR` cards carry the
  drawn diffusion, `AD = AS = 0.1974 um^2` and `PD = PS = 1.78 um`, in all
  32 devices and in the single cell. `design/gain_cell_2t.spice`, whose
  cards the sense and loaded-column decks reuse, sets
  `ad = as = 0.1218 um^2` and `pd = ps = 1.42 um`. So the layout draws
  about 62% more drain/source junction area per device than the decks
  model.
  This is a **finding**, not a correction made here. It affects the
  device-side bitline load and the `sn` junction alike.

### Row-count scaling (`N_COLS = 4`)

Part 2 of the script rebuilds `2x4`, `4x4` and `8x4` arrays in a scratch
directory with `generate_array.sh`'s exact recipe (`array_topology.py` ->
`klt gen mos_array` -> `klt gen-compose`). Each build must pass
`unrouted_nets: []`, DRC `clean` and LVS `match` before it is extracted
with the same flags. Only the reduced numbers are committed, in
`gain_cell_2t_array.parasitics.summary.json` `row_scaling`; the scratch
layouts are not. Worst-column `rbl` totals:

| `N_ROWS` | Ground (fF) | Coupling (fF) | Total (fF) | Source |
|---|---|---|---|---|
| 2 | 0.245560 | 0.095871 | 0.341431 | extracted (scratch) |
| 4 | 0.583799 | 0.269889 | 0.853688 | extracted (scratch) |
| 8 | 1.260277 | 0.617925 | 1.878202 | extracted (scratch) |

The three points sit on a straight line (residual below 1e-6 fF):
**+0.169120 fF ground and +0.256128 fF total per row**. The intercepts are
-0.092679 and -0.170826 fF. They are slightly negative because the bus
end stubs are shorter than one row pitch, so they are fit constants, not
physical components. `bl` has the same numbers.

Why scratch `4x4` differs from the committed one: a fresh `4x4` built with
the current klt is not geometrically identical to the committed GDS (input
hash `5d5609...` vs `4a1155...`). The largest net-total difference between
the two is 0.061 fF. Interior `rbl` is 0.853688 vs 0.859179 fF, and the
committed `rwl` met1 run is slightly shorter. The committed `4x4` numbers
above are the evidence. The scratch set is used only for the per-row slope.

**Issue #91 update (the historical numbers above are kept).** The
difference came from the generator version (see "Reproducing the committed
array"). The script now builds the scaling set with the pinned generation
toolchain, gates it with the pinned check toolchain, and fails unless the
scratch `4x4` geometry and connectivity match the committed array. Extraction
still runs on its own toolchain (`KLT_EXTRACT`, default `klt` on `PATH`). The
generation pin predates the extraction features this script uses, and the
committed extraction records `0.7.0+gd1e9e119331f`. A re-run on 2026-10-11 with
`./layout/extract_array_parasitics.sh --out-dir <scratch>` (extraction klt
`0.7.0+g0d0312b30708`) gave these results:

- Part 1 on the committed GDS: `parasitics` and `devices` identical to the
  committed `gain_cell_2t_array.extract.parasitics.json`. Only
  `netlist_path` and `provenance` differ.
- Scratch `4x4` vs committed: max net-total difference **0.0 fF**
  (historically 0.061 fF).
- Pinned-geometry scaling, worst `rbl` total: 0.343980 / 0.859179 /
  1.889578 fF at 2 / 4 / 8 rows. The fit is **+0.257600 fF total and
  +0.168415 fF ground per row**, against +0.256128 / +0.169120 in the
  committed summary. Wiring alone reaches 10 fF at about 39.5 rows
  (committed: 39.7).

The committed `gain_cell_2t_array.parasitics.summary.json` is **not**
replaced. Its `row_scaling` block still comes from the klt-0.7.0-drawn
scratch arrays, which is a retained historical mismatch of under 0.6% in
the per-row slope. The re-run's output is committed separately as
[`results/parasitics_summary_pinned_generation_20261011.json`](results/parasitics_summary_pinned_generation_20261011.json).
Its `source.extraction`/`netlist` paths point at the scratch out-dir. That
file's part-1 extraction matched the committed one, as stated above. Moving
consumers to the pinned-geometry slope would be a separate, explicitly scoped
evidence refresh.

**Extrapolation (ASSUMPTION, not extracted).** This applies the linear
fit beyond `N_ROWS = 8` and assumes the column keeps this exact bus
geometry: an li1 column bus at the same pitch, with no strapping,
segmenting, column mux or periphery wiring. A macro is not required to
keep any of that. Wiring only:

| `N_ROWS` | Worst `rbl` total, wiring only (fF) -- ASSUMPTION |
|---|---|
| 16 | 3.93 |
| 32 | 8.03 |
| 64 | 16.22 |
| 128 | 32.61 |
| 256 | 65.40 |

Under this assumption, wiring alone reaches 10 fF at about 40 rows. This
is not a ratified `N_rows`. `spec/retention-refresh-budget.md` Section 7
leaves it unratified, and nothing here changes that.

### Storage node in the array vs the single cell (finding)

The single-cell `C_SN` that retention uses is **0.605354 fF**
(`gain_cell_2t.extract.parasitics.json`, issue #7). The same convention
applied in the array gives:

| | Ground (fF) | Coupling (fF) | Total (fF) | vs 0.605354 fF |
|---|---|---|---|---|
| `sn_<r>_<c>`, range over 16 cells | 0.430576 -- 0.433689 | 0.040446 -- 0.071424 | **0.473620 -- 0.502000** | **-21.8% to -17.1%** |

**(Pre-#244 numbers: after the regeneration the single cell is 0.672741 fF
and the array range is 0.538402 -- 0.568080 fF, i.e. 15.6--20.0 % lower; see
the note at the top of this section.)**

**Finding: array-context `C_SN` is 17--22% lower than the single-cell
value used by retention.** The `by_layer` split explains the gap.

- Single cell: 0.173920 fF poly + 0.149806 fF li1 + 0.262764 fF met1.
  `sn` crosses a 1.0 um gap between the device block and the tap block on
  met1.
- Array: the same 0.173920 fF poly + about 0.257--0.260 fF li1, and no
  met1. `sn` is a short local li1 jog.

Re-running the single-cell extraction with today's klt reproduces
0.605354 fF exactly, so tool-version drift is ruled out. The difference
comes from routing, not from the extractor. Retention is proportional to
`C_SN` at fixed leakage and fixed sense margin, so an array-built bitcell
would retain proportionally shorter. **Nothing is re-ratified here.**
`derive_retention.py` still reads the single-cell file, and whether
retention should move to an array-context value is a separate decision
for `spec/`. Both numbers are wiring-only, like the bitline numbers above.
The `M_WR` drain junction and the `M_RD` gate are evaluated by the device
models, and the AD/PD mismatch noted above applies to them too.

**Follow-up (issue #89).** A reproducible all-node reduction and a
capacitance-only retention comparison now exist:
[`sim/retention/compare_array_c_sn.py`](../sim/retention/compare_array_c_sn.py)
and its committed snapshot under `sim/retention/results/`. The limiting
node is `sn_3_3`, at 0.782x the single-cell value. The trace also found
that the leakage testbench passes no `AD/AS/PD/PS`, so the leakage used
neither the schematic nor the extracted geometry. The proposed (not
ratified) decision on which inputs an array retention study should use is
[`spec/retention-refresh-budget.md`](../spec/retention-refresh-budget.md)
Section 9.

### klayout-tools friction (issue #80)

Giving every signal net lateral coupling took 32 repeated `--critical-net`
flags for `4x4` and 56 for `8x4`. The script generates them with a shell
function. `--critical-net`/`--parasitics-net` take exact names only: no
pattern and no all-nets selector. An unmatched name is only a warning, so
a typo in a long hand-written list silently drops a net. Filed generically
as
[2AMLogic/klayout-tools#2974](https://github.com/2AMLogic/klayout-tools/issues/2974).
Everything else (`--parasitics`, `by_layer`, `coupled[]`, `--check`)
behaved as documented.
