2AMLogic/sky130-gcedram/sim/refresh-replay/README.md

# RTL-strobe replay: does the phase-sequencer REFRESH waveform restore data? (issues #128, #131)

Epic #24 item 3 / integration prerequisite for item 6. The phase sequencer
([`digital/phase-control`](../../digital/phase-control/CONTRACT.md)) and the closed-loop refresh study
([`sim/refresh-op`](../refresh-op/README.md)) use different waveforms, so their separate passes do not show that
controller-driven refresh restores data. This study exports the **actual edges** of one `phase_seq` REFRESH,
converts them deterministically to PWL sources and replays them in the **same circuit** as `sim/refresh-op`.
**PROPOSED, unratified scope** (27/125 C, tt/ss/ff/sf/fs, 1.8 V, no mismatch, ideal drivers). No spec,
contract, scheduler timing, overlap rule or prior result was changed. 1 cycle = 1 ns is a study assumption.

## Headline result (run `20261010T094617Z`)

**The unmodified RTL waveform does not restore the stored level at any of the 10 corners** (0/10 at restore
fractions 0.90, 0.95 and 0.98), with or without the explicit latch-hold adapter. The latch decision itself is
correct everywhere (10/10, all four patterns), the PWL conversion is valid (10/10), and the matched baseline
(the existing analog sequence at SENSE 10 ns / WWL 20 ns, same deck) restores at 10/10 and agrees with the prior
`sim/refresh-op` report to 1e-5 V. The failure is preserved, not tuned away; see "Proposed follow-up".

Stored '1' pre-read 0.9 V, SN(end) in V (SN_ref = in-deck reference write; fraction of SN_ref in brackets):

| Corner | T (C) | SN_ref | baseline analog | RTL + latch-hold adapter | RTL raw (1-cycle sample pulse) |
|---|---:|---:|---:|---:|---:|
| tt | 27 | 1.284 | 1.325 (1.03) | 1.112 (0.866) | 1.015 (0.790) |
| tt | 125 | 1.410 | 1.463 | 1.229 (0.872) | 1.105 (0.784) |
| ss | 27 | 1.179 | 1.202 | 1.024 (0.868) | 0.969 (0.822) |
| ss | 125 | 1.295 | 1.328 | 1.128 (0.871) | 1.039 (0.802) |
| ff | 27 | 1.377 | 1.437 | 1.192 (0.866) | 1.063 (0.772) |
| ff | 125 | 1.508 | 1.584 | 1.317 (0.873) | 1.156 (0.767) |
| sf | 27 | 1.436 | 1.505 | 1.249 (0.870) | 1.104 (0.768) |
| sf | 125 | 1.563 | 1.644 | 1.366 (0.874) | 1.180 (0.755) |
| fs | 27 | 1.138 | 1.154 | 0.988 (0.868) | 0.957 (0.841) |
| fs | 125 | 1.262 | 1.291 | 1.098 (0.870) | 1.020 (0.808) |

All four patterns are in `results/20261010T094617Z/points.csv` (stored '1' at 0.9 V and 1.0 V, stored '0' at
-0.1 V and 0.0 V). Stored '0' is "restored" by the sim/refresh-op criterion (<= 50 mV) in every RTL variant, but note it
ends at about **-0.11 to -0.14 V** (baseline: ~0 V): a signed observation worth knowing, not a failure of the criterion.

What the probes show (diagnostic, not an isolated cause): with the hold adapter the WBL is driven to 1.8 V and
SN just before WWL falls (1.08-1.37 V) is close to the baseline's value at the same point. In the baseline SN
then *rises* 0.08-0.27 V after WWL falls (RWL, still held low, is released afterwards); in the RTL sequence RWL
was released 20 ns earlier, WWL falls last and SN *drops* by 0.01-0.10 V. In the raw variant the 1 ns enable
lets the latch decide but then floats: the latch complement node shares charge with WBL
(WBL 1.28-1.36 V before WWL falls instead of 1.8 V). Whether the RWL-hold ordering or the WWL-fall
feedthrough dominates was **not** isolated; that needs a separate experiment.

## Release-order attribution experiment (issue #131, run `20261010T130000Z`)

Question left open above: is the restoration failure caused by the RWL release ordering, by the latch-enable
release, or by ideal-driver coupling? The RTL, `CONTRACT.md`, scheduler defaults, restoration criteria
(0.90/0.95/0.98 of the in-deck SN_ref; stored '0' <= 50 mV) and the circuit are unchanged. Five **experimental**
waveforms were added to the same deck (10 variants x 4 patterns + reference write = 41 instances, 5 corners x
27/125 C, 1.8 V). They are experiments, **not** approved overlap-rule changes. Run-pinned provenance as before
(klt 0.6.0, ngspice 46, model lib sha256 `48de7c67...133c84`, open_pdks `c6d73a35...`; deck sha256 equals klt's
`netlist_sha256`). Ten of ten corners simulated for every variant; failures are preserved in `points.csv` and `summary.json`.

| Variant | Parent | Only change (verified: `consistency_check.json` -> `experiment_diff`) |
|---|---|---|
| `rwl_late_raw` | `rtl_raw` | RWL release 12 -> 34 ns (2 ns after WWL falls at 32; coincident with BL-drive release / `busy` fall) |
| `rwl_late_hold` | `rtl_hold` | RWL release 12 -> 34 ns; latch-hold adapter unchanged |
| `latch_early_hold` | `rtl_hold` | latch-enable release 34 -> 30 ns (before WWL fall); RWL unchanged |
| `latch_late_hold` | `rtl_hold` | latch-enable release 34 -> 36 ns (after WWL fall and BL release); RWL unchanged |
| `combined_hold` | `rtl_hold` | both late releases (RWL 34, latch 36), run only after the individual controls |

Write-pulse width (WWL 12-32 = 20 ns), precharge, initial levels, sense edge, WWL/BL-drive edges and circuit are
identical across variants. Tests (`Experiments`) prove each control moves only its intended edge(s), that the
individual controls leave the other node untouched, that `combined_hold` is exactly their composition, and that an
unintended extra change is flagged. The deck-to-waveform check still passes for 41/41 instances (10/10 corners conversion-valid for every variant).

### Results (restore at 0.95 / 0.90 / 0.98; corners restored out of 10)

| Variant | restore 0.95 | 0.90 | 0.98 | sense | worst stored-1 SN/SN_ref (mean over corners) | stored-0 SN_end range (V) | op end / `done` seen / settled meas. (ns) |
|---|---:|---:|---:|---:|---:|---|---|
| `baseline_analog` | 10 | 10 | 10 | 10 | 1.03 | -0.015 .. +0.027 | 37 / 37 / 39 |
| `rtl_raw` | 0 | 0 | 0 | 10 | 0.79 | -0.140 .. -0.027 | 34 / 35 / 36 |
| `rtl_hold` | 0 | 0 | 0 | 10 | 0.87 | -0.139 .. -0.113 | 34 / 35 / 36 |
| `rwl_late_raw` | 8 | 9 | 0 | 10 | 0.97 | -0.021 .. +0.114 | 34 / 35 / 36 |
| `rwl_late_hold` | **10** | 10 | 10 | 10 | 1.03 | -0.015 .. +0.027 | 34 / 35 / 36 |
| `latch_early_hold` | 0 | 0 | 0 | 10 | 0.88 | -0.169 .. -0.144 | 34 / 35 / 36 |
| `latch_late_hold` | 0 | 0 | 0 | 10 | 0.87 | -0.139 .. -0.113 | 36 / 37 / 38 |
| `combined_hold` | 10 | 10 | 10 | 10 | 1.03 | -0.015 .. +0.027 | 36 / 37 / 38 |
| `neg_missing_wb` | 0 | 0 | 0 | 10 | 0.73 | +0.03 .. +0.15 | negative control OK 10/10 |
| `neg_short_wb` | 0 | 0 | 0 | 10 | 0.72 | | negative control OK 10/10 |

Reproduced controls: the baseline restores 10/10 and matches the prior `sim/refresh-op` report (<= 0.01 V,
`baseline_matches_prior_all_corners` true); `rtl_raw`/`rtl_hold` fail 0/10, as in run `20261010T094617Z`. The
`rwl_late_raw` failures at 0.95 are `ff/125` (a stored '0' ends above 50 mV) and `sf/125` (stored '1').

SN probes, stored '1' from 0.9 V, tt/27 C (V; SN_ref 1.284): SN just before / after WWL falls: baseline 1.175 / 1.051,
`rtl_hold` 1.179 / 1.042, `rwl_late_hold` 1.175 / 1.051 -- the write itself and the WWL-fall drop (0.12-0.14 V) are the
same in all of them. RWL release: `rtl_hold` releases at 12 ns (SN 0.77 -> 1.03, before the write, which then overwrites it);
`rwl_late_hold` releases after the write: SN 1.051 -> 1.269 (+0.22 V) within 0.2 ns and settles at 1.325-1.340. Latch
state after WWL falls is still decided in all variants (`dla`), but with the latch released early the WBL overshoots to 1.89-1.95 V
(charge injection of the latch turning off through the open write-back switch) and gains only +0.01 of SN/SN_ref.

### Causal attribution (`summary.json` -> `causal_attribution`; mechanical labels over all 10 corners)

| Question | Evidence | Verdict |
|---|---|---|
| RWL release **after** WWL fall | `rwl_late_hold` vs `rtl_hold`: +0.15..+0.18 of SN_ref in every corner, 0 -> 10/10 restored; `rwl_late_raw` vs `rtl_raw`: +0.13..+0.21, 0 -> 8/10 | **Isolated, sufficient** (with the latch held); the dominant effect |
| Latch-hold (enable 11 -> 34) | with RWL early: +0.03..+0.11, 0/10 -> 0/10; with RWL late: +0.04..+0.11, 8/10 -> 10/10 | **Contributing, not sufficient alone**; needed to restore the ff/sf 125 C corners and the 0.98 fraction |
| Latch-enable release 30 vs 34 vs 36 ns | +0.012 / reference / 0.000 of SN_ref; `combined_hold` = `rwl_late_hold` to 1e-4 | **No resolvable effect** of the release edge itself (early release disturbs WBL, +0.01 only) |
| Combined ordering | `combined_hold` 10/10, identical to `rwl_late_hold` and to the analog baseline (SN_end within 0.1 mV of baseline at the same point) | Adds nothing beyond the RWL release; costs +2 ns |

Mechanism consistent with the traces (**not** separately isolated): the read-select (read-device source) edge couples onto
SN through the read device; an RWL release after WWL fall lifts SN by about 0.2 V and cancels the WWL-fall droop, whereas
releasing it at 12 ns spends that coupling before the write. This is a **capacitive-coupling effect in the ideal-driver
circuit** (0.1 ns ideal edge, 100 ohm switches, C_RBL = C_WBL = 10 fF assumed, extracted C_SN, one row's RWL driven ideally).
The stored-'1' end level of the restoring variants is 1.01-1.05 x SN_ref because SN_ref is written with the read select idle (no bootstrap);
so passing the criterion partly reflects the lifting edge, not a larger write-back. Which share is intrinsic to the cell
and which follows from the ideal edge rate/driver impedance remains **confounded** (needs the physical column/row driver
work, #114/#117, and extracted loads, #88/#89). Also untested: RWL release times between WWL fall (32 ns) and 34 ns.
Stored-0 levels also improve with the late release (no more -0.11..-0.14 V undershoot), except `rwl_late_raw` which can exceed +50 mV.

### Timing budget (provisional `T_ROW` = 34, ASSUMPTION; ideal 0 ns adapter/launch latency)

`rwl_late_hold` ends at 34 ns (the RWL release shares the existing `busy`-fall edge): op end fits with **zero slack**, `done`
observed at 35, settled measurement at 36 -- identical to `rtl_hold`, i.e. the ordering change that restores costs no
additional operation cycles *in this ideal model*, but it requires the 34-cycle window to include the post-write RWL hold and
(by the same accounting as before) does not fit once the `done` cycle or the 2 ns settle is counted. `combined_hold`/`latch_late_hold` end at 36 (+2 over budget).
The analog baseline needs 37. Nothing in `scheduler`/`CONTRACT.md` was changed.

### Contract implications (PROPOSED, requires a separate approved decision; none applied)

* The restoring ordering moves read-select release from the end of the sense phase (12 cycles) to at/after WWL fall
  (RWL overlaps the whole 20-cycle write). That reverses the current non-overlap rule in `CONTRACT.md` and must be decided separately.
* The latch enable must be held through the write-back (the explicit adapter, which has no RTL counterpart today).
* Both are valid only for this ideal-driver circuit. They are **not** evidence of a working macro: a physical read-select
  driver (finite edge rate/impedance), column driver and extracted RBL/WBL loads must be checked before any macro claim.
  No ratified specification or digital overlap rule was revised.

## RWL driver slew / impedance / release-delay sensitivity (issue #134, run `driver_sweep_results/20261010T141816Z`)

**Experimental stimulus model, not a designed physical driver.** Question left open by #131: is the late-RWL restoration
benefit an artifact of the ideal 0.1 ns edge and a zero-impedance read-wordline source? The selected row's RWL source (the
read-device source pin of row 0, active-low) now has a **declared ramp time** (0 -> 100 %, applied to every RWL edge) and a
**declared series resistor** to the cell pin; everything else (circuit, loads `C_RBL = C_WBL = 10 fF` assumed, extracted `C_SN`, 100 ohm
switches, 20 ns write pulse, latch hold, initial levels, thresholds, **fixed gating probe time**) is the unchanged #131 deck. Nothing in
the ratified spec, `phase_seq` RTL, `CONTRACT.md` overlap rule or scheduler defaults was changed. **All sweep values are ASSUMPTIONS**
(no driver design exists); the bounds need human review. Scope: tt/ss/ff/sf/fs x 27/125 C, 1.8 V, no mismatch (PROPOSED, not ratified).
Voltages are recorded **at the cell pin** (`rwls_<inst>`), and the **programmed source edge** (start, 50 %, end; `manifest.json`) is kept
distinct from the **measured pin crossings** (`summary.json` -> `results[].pin`).

Sweep (`gen_rwl_driver_sweep.py`; 80 points x 4 patterns + the 41 unchanged #131 control instances = 361 instances, **one** batch request):
slew-only 0.5/1/2/5 ns at R = 0; R-only 1k/3k/10k/30k/100k/300k/1M ohm at 0.1 ns; **then** combined {1, 2 ns} x {10k, 100k}; each for the
analog baseline (`an_`), unchanged RTL + latch hold (`rh_`, RWL release 12 ns) and late-RWL + latch hold (`rl_`, release 34 ns). Release
delay (RWL release start minus WWL fall start at 32 ns) -16/-8/-4/-2/0/+1/+2/+3 ns for `rl_` with the ideal driver, (1 ns, 10k) and
(2 ns, 100k). Negative controls: missing write-back with release 12 ns and with the late release, at three driver settings.

### Controls, provenance

* The ten original #131 variants run unchanged in the same deck: **100 control results (10 variants x 10 corners) reproduce their recorded
  restore / sense / simulator verdicts and negative-control verdicts with 0 mismatches**; max |SN_end| difference to the recorded run 4e-5 V
  (`summary.json` -> `controls_reproduction`). Both original missing-write-back controls and all six new ones (including **late RWL release
  with no write-back**, worst stored-1 fraction 0.65) remain failures at 10/10 corners: the late-release lift alone is not read as restoration.
* Source sha256s (generator, analyzer-at-analysis, `replay_lib`, RTL, circuit generators), git head, deck/request sha256 (deck sha256 =
  klt `netlist_sha256`), model library sha256 `48de7c67...`, open_pdks `c6d73a35...`, klt 0.6.0, ngspice 46, batch job id
  `klt-sim-7e6455aebff7` (c7i.4xlarge spot, 649 s, 10/10 corners) are pinned in `manifest.json` / `summary.json`. `fleet_attempts.json`
  lists every submission, including the superseded ones (below). The committed report is gzip-compressed with the bucket name redacted.
* `test_refresh_replay.py` (`DriverSweep`): every sweep instance is compared with its parent control instance; **only** the declared RWL ramp
  time, series resistor, RWL release time and (group `ic_artifact_check`) pin initial condition may differ. Unintended changes to another source, the
  circuit, an initial condition or a probe time are flagged (tamper tests). `replay_lib.edges_to_pwl` keeps the 0.1 ns default byte-for-byte.
* Same effective start regime: SN just before the RWL assert differs from the parent control by <= 0.42 mV at every non-`ic` sweep point
  (`start_regime_check`).

### Results (restore at 0.95 / 0.90 / 0.98 of the in-deck SN_ref, corners restored out of 10; gating probe fixed at 36 ns)

`rl_` (late RWL release, latch held), ideal other axis. Slack = 34 ns minus the worst (conservative, interpolated; see below) **cell-pin 90 %
release crossing**, a time-budget number reported separately from restoration. "first" = earliest sampled time at which all patterns restore
(a quantized upper bound; the gating verdict is only the 36 ns probe).

| Slew (ns), R = 0 | sense | restore 0.95 / 0.90 / 0.98 | worst stored-1 SN/SN_ref | stored-0 SN_end (V) | pin-90 ns (slack) | first |
|---|---:|---|---:|---|---|---:|
| 0.1 (control) | 10 | 10 / 10 / 10 | 1.014 | -0.015 .. +0.027 | 34.1 (-0.1) | 34.5 |
| 0.5 | 10 | 10 / 10 / 10 | 1.013 | -0.015 .. +0.027 | 34.5 (-0.5) | 34.5 |
| 1 | 10 | 10 / 10 / 10 | 1.012 | -0.015 .. +0.027 | 34.9 (-0.9) | 35.0 |
| 2 | 10 | 10 / 10 / 10 | 1.005 | -0.015 .. +0.027 | 35.8 (-1.8) | 36.0 |
| **5** | 10 | **0** / 10 / 0 | 0.927 | -0.090 .. -0.057 | 38.5 (-4.5) | 38.0 |

| R (ohm), slew 0.1 | sense | restore 0.95 / 0.90 / 0.98 | worst stored-1 SN/SN_ref | stored-0 SN_end (V) | pin-90 ns (slack) | first |
|---|---:|---|---:|---|---|---:|
| 1k | 10 | 10 / 10 / 10 | 1.014 | -0.015 .. +0.027 | 34.2 (-0.2) | 34.5 |
| 10k | 10 | 10 / 10 / 10 | 1.012 | -0.015 .. +0.027 | 34.3 (-0.3) | 34.5 |
| 100k | 10 | 10 / 10 / 10 | 1.001 | -0.015 .. +0.028 | 35.9 (-1.9) | 35.0 |
| 300k | 10 | 10 / 10 / **5** | 0.963 | -0.015 .. +0.028 | 39.3 (-5.3) | 36.0 |
| **1M** | **5** | **0** / 5 / 0 | -0.011 | -0.015 .. +0.028 | 49.9 (-15.9) | never |

(3k and 30k behave between their neighbours; all in `summary.json`.) Combined {1, 2 ns} x {10k, 100k}: all four restore 10/10 at 0.95
(worst fraction 0.980-1.009). The analog baseline `an_` (release 37 ns) behaves the same way (restores up to 2 ns / 300k; fails at 5 ns / 1M).
**Failed sweep points** (`failed_sweep_points`: 24 of 74 non-negative-control points, none removed): `rl_`/`an_` at 5 ns slew (stored-1 below 0.95 at the 36 / 39 ns
gate while the pin is still mid-ramp; they restore later, see "first"); `rl_`/`an_` at 1 Mohm (the series resistor starves the read: the latch decides wrongly at 5 corners);
`rl_` (2 ns, 100k) at +3 ns release (pin still releasing at the gate); 14 `rh_` points (unchanged RTL release order: every slew-only point, every R <= 10k point and the
combined points still fail, as in #131; R = 30k restores 3/10, 100k 9/10, 300k 10/10, 1M fails the read); and the five `ic_artifact_check` points (sense failures, below).

**Release-delay sweep** (`rl_`, restore 0.95 / 0.98, stored-0 range, worst pin-90 slack against 34 ns):

| delay (ns) | ideal driver | (1 ns, 10k) | (2 ns, 100k) |
|---|---|---|---|
| -16 | 10 / 4, SN/ref 0.954, stored-0 -0.139..-0.113, +17.9 | 10 / 0, 0.954, -4.1 | 10 / 6, 0.969, -5.2 |
| -8 | 10 / 10, 0.996, +9.9 | 10 / 10, 0.993, -1.1 | 10 / 10, 0.991, -1.9 |
| -2 | 10 / 10, 1.011, +3.9 | 10 / 10, 1.009, -1.5 | 10 / 10, 0.999, -2.0 |
| 0 | 10 / 10, 1.014, stored-0 -0.068..-0.051, +1.9 | 10 / 10, 1.012, -0.8 | 10 / 10, 1.001, -1.9 |
| +1 | 10 / 10, 1.014, stored-0 -0.015..+0.027, +0.9 | 10 / 10, 1.012, -0.4 | 10 / 10, 0.999, -2.0 |
| +2 (= #131) | 10 / 10, 1.014, -0.1 | 10 / 10, 1.009, -0.9 | 10 / 10, 0.980, -2.9 |
| +3 | 10 / 10, 1.008, -1.1 | 10 / 10, 0.996, -1.9 | **0** / 0, 0.897, -3.9 |

SN probes, stored '1' 0.9 V, tt/27 C (SN_ref 1.284; V): SN before / after WWL fall, before / after RWL release, end: baseline 1.175 / 1.051, 1.051 /
1.269, 1.325; `rtl_hold` 1.179 / 1.042, 0.770 / 1.026, 1.112; `rl_` ideal (+2 ns) = baseline to 1e-3; release 16 ns early: 1.294 / 1.158, 1.121 / 1.293,
1.251 (0.975); `rl_` 300k: 1.175 / 1.051, 1.051 / 1.111, 1.264 (0.984).

### What this says (and does not)

1. **The late-release restoration survives finite edge rate and finite driver impedance within the tested box, and is not a pure ideal-edge
   artifact.** At the gating probe, restoration holds at 10/10 corners for slew <= 2 ns at R = 0, R <= 300 kohm at 0.1 ns, and all four combined
   points. Tested-grid envelope (`robustness_envelope`, restoration only): slew in [0.1, 2] ns bounded above by the failing 5 ns point; R in [0, 300k]
   bounded above by the failing 1 Mohm point (at 300k the 0.98 fraction is already only 5/10). The envelope is the tested grid, not a continuous
   bound, and the first failure above it (5 ns, 1 Mohm) is a *different* failure each (gate probe mid-ramp; read path).
2. **The mechanism is pin timing, not source-edge timing.** The unchanged RTL order (`rh_`, source release at 12 ns, which fails in #131) *starts restoring* when
   the series resistance delays the pin: 3/10 corners at 30k, 9/10 at 100k, 10/10 at 300k, even though the programmed source edge is untouched. With 300k the pin
   50 % crossing is 0.3-2.8 ns **after** WWL falls (at 100k the 50 % crossing is earlier but the 90 % crossing, the slow tail, is at 35.8 ns).
   Binning every sense-correct corner record by the measured pin 90 % crossing relative to the WWL fall (`restoration_vs_pin_crossing`): records whose pin finishes
   releasing later than 2 ns after WWL fall restore 426/435 (2..4 ns) and 77/117 (> 4 ns; the late ones fail at the fixed probe), and those finishing earlier
   than -10 ns restore 10/116 (the ten are the ideal-driver -16 ns point, marginal at 0.954); the programmed source release time alone does not predict restoration (compare the `rh_` rows). This is an association over this
   stimulus model.
3. **Release-delay margin (per driver):** restoration at 0.95 holds for every tested release from 16 ns before to 3 ns after the WWL
   fall for the ideal driver and for (1 ns, 10k), and from 16 ns before to 2 ns after for (2 ns, 100k), which fails at +3 ns (0/10 corners)
   (the unchanged RTL release is 20 ns before and fails), i.e. the stored-1 benefit does **not** require the release to follow the WWL fall, which narrows
   the #131 reading ("release after WWL fall"). The lower boundary is only bracketed between -20 ns (fails) and -16 ns (passes at 0.954, the 0.98 fraction at
   only 4/10): it is a thin margin there. A separate constraint is the **signed stored-0 level**: it returns to the clean -0.015..+0.027 V only when the release is
   >= +1 ns after the WWL fall (undershoot -0.14..-0.11 V for releases before it, -0.07..-0.05 V at 0 ns). The restoration criterion (stored 0 <= 50 mV) does not
   penalize the undershoot, so both are reported. The upper end is set by the gating probe (and time budget), not by the cell: `(2 ns, 100k)` at +3 ns fails because the
   pin is still releasing at 36 ns. No restore probe was moved to obtain a pass (the gating probe is 36 ns for the RTL-derived points and 39 ns for the analog baseline,
   as in #131).
4. **Time budget, reported separately.** The source edge *starts* at the 34 ns budget edge for the +2 ns point, but the cell pin reaches 90 % at 34.1 ns (ideal),
   34.2-35.9 ns for R = 1k-100k, 35.8 ns at 2 ns slew and 39.3 ns at 300k; counting the one-cycle `done` observation after the operation end, **no** sweep point
   completes within 34 ns (as in #131: 34 + 1). Earlier release recovers pin-90 slack (ideal driver: +17.9 ns at -16, still positive to +1 ns), but
   the gating probe (36 ns) and the completion accounting still exceed 34 ns; restoration and budget are independent verdicts here
   (the budget-inclusive envelope, `restoration_and_pin_release_90_within_budget`, is empty or anchored on a reference that itself does not fit). The pin 90 % time of
   series-R instances is interpolated from pin samples (+0.2 .. +32 ns after the release start); on a concave tail the chord lies below the curve, so the true crossing is
   **earlier or equal** (a conservative slack). **Correction (review of PR #137):** the committed `summary.json` took the pin 90 % time from one reference pattern
   (stored 1 at 0.9 V) only, but the finite-R pin is data dependent. The aggregate budget is recomputed from the **slowest of the four patterns** (a pattern
   that never crosses makes the point unknown, never fitting) in the append-only re-analysis
   `driver_sweep_reanalysis/20261010T141816Z-pattern-aware/` (`analyze_rwl_driver_sweep.py --out-dir`); the original run is untouched. Seven corner/point records
   flip to not-fitting or unknown (e.g. `rh_s0p1_r1000k` tt/27 C: 12.8 ns reference, 43.5 ns slowest; `nr_s2_r100k` tt/27 C: 33.7 ns vs 34.4 ns). At point level the
   fit flags are unchanged except `rh_s0p1_r1000k` (worst crossing unknown); no restoration verdict, envelope or `rl_` slack in the tables above changes.
5. **Not shown:** a physical driver, its size or its shared-row loading; extracted RBL/WBL/RWL loads (#88/#89, #114/#117); mismatch/offset; column-driver behaviour;
   any decision about the `CONTRACT.md` overlap rule. This study is one more input to that decision, not the decision.

### Start-up artifact in the shared deck (found while building this study; affects #128/#131 as well)

The #128/#131 controls (and `sim/refresh-op`) give the idle-high RWL pin no initial condition. Under `uic` the forced pin steps 0 -> VDD in the
first step and injects charge onto SN through the read device, so the stored level at the read is **about 0.07-0.12 V above its label** (tt/27: '1' 0.9 V reads from
1.024 V, stored '0' -0.1 V from -0.033 V). The group `ic_artifact_check` adds an explicit idle-high pin IC (declared change; everything else identical): the pre-read levels
fall by 0.12-0.26 V, the stored-'1' 0.9 V pattern is then **sensed wrongly at ss/27 and fs/27** (even with the ideal driver, 8/10 corners sense-correct), and the
restoration verdicts of the sense-correct corners are unchanged (`rl_` ideal 8/8, `rh_` 0/8). So the earlier sense margin of the 0.9 V pattern leaned on
the artifact. All sweep points deliberately keep the legacy start regime (no pin IC) so that they compare with the recorded controls; the artifact is *not* corrected in the
existing results and the legacy runs were not touched. This belongs in the read-path/circuit follow-up work, not in this PR.

### Discarded runs and fleet notes

Four batch submissions were made for this study; only the last is recorded. (1) `klt-sim-2480fb15ca17` / `klt-sim-96abb903ed99`: an earlier whole study whose series-R
instances carried a pin IC the controls lack (the artifact above made its R-axis sense failures a start-level confound); discarded and not committed. (2) `klt-sim-a0ce12190c1f`:
a point id containing an upper-case letter (`r1M`) made the fleet runner return "no value" for those instances (ngspice lower-cases `.meas` names; already filed as
klayout-tools#2914) and graded all corners `error`; ids are lower case now and a test enforces it. (3) `klt-sim-c8004da21637`: 10/10 corners ran, but the `.meas WHEN ... RISE=1`
pin-crossing probes of series-R instances locked onto the t = 0 start-up charge of the unclamped pin; replaced by sampled pin voltages (exact `WHEN` only for R = 0, where it cannot fail).
Single-corner local runs of small subset decks (and of the failed full deck) were diagnostics only. No grid was run locally.

## Matched initialization controls (issue #139, run `init_control_results/20261010T163500Z`)

Question: the start-up artifact above means every recorded sense / restore verdict of #128/#131/#134 was obtained from a storage-node level
that is **not** its label. Which conclusions depend on that legacy start, and which survive when the stored level is prepared differently?
The circuit, nominal data targets (labels), operation waveforms, loads, criteria and probes are the unchanged #131 ones. Nothing in the
ratified spec, topology, refresh interval, operating range, sense thresholds, `CONTRACT.md` overlap rule or scheduler was changed.
Scope as before: tt/ss/ff/sf/fs x 27/125 C, 1.8 V, no mismatch, ideal drivers (PROPOSED range, not ratified).

| Regime | Initialization (declared changes vs legacy, verified per instance: `consistency_check.json`, 52/52 `declared_changes_only`) |
|---|---|
| `legacy` | the #131 control instances, byte-identical deck lines: SN = label as `.ic`, no RWL pin IC, `tran ... uic` |
| `pin_ic` (`pic_`) | legacy + explicit idle-high RWL pin IC (the #134 `ic_artifact_check` change); nothing else |
| `physical` (`pw_`) | **zero-hold physical write/settle preparation.** Row-0 SN starts at the **opposite** data level (0 V for a '1' target, 1.2 V for a '0' target; ASSUMPTION, so that a write that does not happen is visible); RWL pin IC idle-high; a declared ideal preparation driver drives WBL to the **label voltage** through the existing 100 ohm switch model while row 0's WWL is pulsed 1-21 ns (the op's 20 ns write width); WBL is returned to 0 V (the legacy WBL start) at 22 ns and disconnected at 23 ns; the operation starts at 24 ns. No hold. **Unavoidable preparation-time changes, part of the variant:** every op edge, probe and the gating probe move by +24 ns, and the latch / bitline nodes float for 24 ns before the op's precharge |
| `pwnw_rwl_late_hold` | **initialization negative control**: the physical `rwl_late_hold` with the preparation WWL pulse deleted (no write) |

Variants per regime (curator-verified set): `baseline_analog`, `rtl_hold`, `rwl_late_hold`, restoration negative control `neg_missing_wb`;
patterns `op1` 0.9 / 1.0 V and `op0` -0.1 / 0.0 V (`GR.PATTERNS`). 52 instances + the in-deck reference write (the restoration criterion's
SN_ref is the unchanged legacy `refw`). Per record (`points.csv`, 520 rows) the analysis keeps **separate**: intended level (label), achieved
post-write level (physical: SN after the prep WWL fall), **measured pre-read level** (SN 0.1 ns before the read-select assert; the label never
stands in for it), the **signed** decision d = V(rbl) - V(ref), sense correctness, restore fraction SN_end / SN_ref and the 0.90/0.95/0.98 verdicts
(which require the correct decision: a restore ratio can never pass a wrong read; `restore_ratio_high_but_sense_wrong` is empty here).

### Controls and reproduction (`summary.json` -> `reproduction`, `documented_claims`, `negative_controls`)

* `legacy` reproduces the recorded #131 controls: 40/40 (corner, variant) sense / restore / simulator / per-fraction verdicts, max |SN_end|
  difference 54 uV. `pin_ic` reproduces the #134 `ic_artifact_check` points (`an_`/`rh_`/`rl_s0p1_r0_ic`): 30/30 verdicts incl. per-pattern
  sense, max |SN_end| difference 52 uV, pre-read 2 uV.
* **Start-up uplift reproduced, but wider than the documented "about 0.07-0.12 V":** legacy pre-read minus label is **+0.10..+0.18 V** for stored '1'
  (0.9 V reads from 1.003-1.062 V, 1.0 V from 1.118-1.181 V) and +0.06..+0.07 V for stored '0', over the ten corners. Pin IC minus legacy:
  -0.26..-0.12 V (as documented).
* **Corrected sense failures reproduced:** with the pin IC, stored '1' 0.9 V is sensed wrongly at exactly **ss/27 and fs/27** for all three variants
  (8/10 corners sense-correct each). These failures stay in the result set.
* The pin-IC pre-read is itself **not** the label: -0.07..-0.08 V below it in every corner/pattern (stored '1' 0.9 V reads from 0.821-0.830 V). This is
  the precharge step at op start (RBL `.ic` = VDD pulled to VRBL) coupling onto SN; it is common to all three regimes and remains an
  initialization assumption of the shared circuit (not removed here).
* Negative controls: `neg_missing_wb` never restores a stored '1' in any regime (30/30). The no-write control `pwnw_rwl_late_hold` is caught at 10/10
  corners: every pre-read is flagged as not its label (stored-'1' targets read from about -0.07 V, stored-'0' targets from about 1.13 V) and every decision is wrong.

### Results (corners out of 10; `survival`, `restore_among_sense_correct_records`)

| Variant | legacy: sense / restore 0.95 | pin IC: sense / restore | physical: sense / restore | stored-'1' records restored **among sense-correct** (legacy / pin IC / physical) |
|---|---|---|---|---|
| `baseline_analog` | 10 / 10 | 8 / 8 | **1** / 1 | 20/20 / 18/18 / 5/5 (fraction 1.01-1.05) |
| `rtl_hold` | 10 / 0 | 8 / 0 | 1 / 0 | 0/20 / 0/18 / 0/5 (0.86-0.93) |
| `rwl_late_hold` | 10 / 10 | 8 / 8 | **1** / 1 | 20/20 / 18/18 / 5/5 (1.01-1.05) |
| `neg_missing_wb` (neg.) | 10 / 0 | 8 / 0 | 1 / 0 | 0 / 0 / 0 |

Physical preparation (all variants alike; V): writing the **label voltage** onto WBL achieves a post-write level of **0.70-0.74** (label 0.9),
**0.81-0.85** (1.0), -0.19..-0.23 (-0.1) and -0.11..-0.14 (0.0) -- the WWL-fall feedthrough of the write device lowers every written level by
0.11-0.20 V. The label is **not tuned** to compensate. The pre-read levels are then 0.60-0.66 / 0.70-0.77 / -0.24..-0.31 / -0.18..-0.22 V. Stored '1'
written at 0.9 V is sensed wrongly at **9/10** corners (correct only at sf/125), at 1.0 V at **6/10** (correct at tt/125, ff/125, sf/27, sf/125);
stored '0' is sensed correctly everywhere in every regime.

**Attribution (`sense_vs_pre_read`):** in all 20 (corner, sense-timing family) groups the signed decision is a **monotone function of the measured
pre-read level** across all regimes, variants and patterns (every level read as '0' lies below every level read as '1'; no unresolved decision).
The regime differences in sense correctness are therefore attributable to the **preparation** (the level presented to the unchanged sense path),
not to a change in sensing. Effective stored-'1' threshold brackets (max pre-read read as '0', min read as '1'], V: ss/27 (0.829, 0.929], fs/27
(0.828, 0.928], ff/27 (0.718, 0.821], tt/27 (0.733, 0.825], sf/27 (0.597, 0.705], 125 C corners lower (sf/125 below 0.609).

### Which historical claims depend on the legacy initialization, and which survive

| Recorded claim | Status under matched controls |
|---|---|
| #128/#131 "latch decision correct everywhere (10/10, all four patterns)"; the `sense` = 10 column of every #131 variant and of every #134 sweep point (legacy start) | **Depends on the legacy start-up uplift.** With the pin IC: 8/10 (ss/27, fs/27 fail on stored '1' 0.9 V); with physical preparation of the same labels: 1/10. The sense margin of the 0.9 V pattern in those runs is an artifact of the start regime. `sim/refresh-op` (whose sequence is `baseline_analog`) shares the legacy start and therefore the same caveat for its sense claims (not re-run here) |
| The stored-'1' 0.9 V / 1.0 V labels describe the level read | **Does not hold in any regime** (+0.10..+0.18 V legacy, -0.07..-0.08 V pin IC, -0.24..-0.30 V physical); all 520 records differ from their label by more than 25 mV (`mislabeled_pre_read_records`). Labels are targets, not measured levels |
| #128/#131 restoration ordering: `rtl_hold` does not restore, `rwl_late_hold` / the analog baseline do; #131 causal attribution of the RWL release | **Survives, conditional on a correct read:** among sense-correct stored-'1' records, `rwl_late_hold` and `baseline_analog` restore 100 % in all three regimes (fraction 1.01-1.05), `rtl_hold` 0 % (0.86-0.93), the missing write-back never restores. Restore verdicts are only meaningful alongside sense correctness and the actual pre-read level |
| #134 driver-sweep restoration envelope (slew / R / release delay) | Not re-run under the new regimes. Its restoration verdicts are of sense-correct legacy records; given the result above (restoration among sense-correct records is regime-independent for the ideal-driver controls), it is expected to carry over **only where the read is correct**, which with matched initialization it is not at ss/27, fs/27 for the 0.9 V label. Unverified; a re-run would be a separate study |

### What this does not show / follow-up (not done here)

* The physical regime writes the **label voltage** (a degraded-level stand-in), not a full-rail write; it is a zero-hold preparation control, not the
  long-hold / mixed-neighbour study (#94). The opposite-level start, the 24 ns preparation timing and the ideal preparation driver are assumptions.
* The RBL start (`.ic` = VDD, precharged to VRBL at op start) is a remaining common initialization assumption that lowers SN by about 0.07 V in every regime.
* Read-path consequence (a separate decision, nothing changed): at ss/27 and fs/27 a stored '1' must present about 0.83-0.93 V at the read to be sensed,
  so the read path, not the write-back ordering, is what the matched controls expose. The retention end-level / sense-threshold interplay needs its own issue
  and evidence; no spec, threshold or operating range was adjusted.

Fleet: one `klt sim` batch request, first and only submission (`uvx --from klayout-tools==0.6.0 klt sim --backend batch --format json`, job
`klt-sim-525deb23471f`, m6i.4xlarge spot, 110 s, 10/10 corners; report from stdout, bucket name redacted; `fleet_attempts.json`). Deck sha256 =
klt `netlist_sha256` (`1acf25c0...`); klt 0.6.0, ngspice 46, model lib sha256 `48de7c67...133c84`, open_pdks `c6d73a35...`; source sha256s and
git head in `manifest.json` / `summary.json`. The only local simulation was a single-corner (tt/27 C, `--backend local`) probe of a scratch deck of the
same generator, used to check the probes; it is not a result. No grid was run locally.

## Files

| File | Role |
|---|---|
| [`../../digital/phase-control/tb_trace_export.v`](../../digital/phase-control/tb_trace_export.v) | runs one operation of the committed `phase_seq.v` and prints every strobe edge (sampled 0.1 ns after each rising clock edge; relative to the accepting edge) |
| [`export_rtl_trace.py`](export_rtl_trace.py) | runs iverilog/vvp, writes the JSON trace with source/tool pins (refuses to overwrite) |
| [`replay_lib.py`](replay_lib.py) | `PIN_MAP`, edge -> PWL converter, latch-hold adapter, reverse PWL parser, trace-consistency check, negative-control mutations |
| [`gen_refresh_replay.py`](gen_refresh_replay.py) | builds a NEW `results/<RUN_ID>/` with deck, `klt sim` request, waveforms, consistency check, manifest |
| [`analyze_refresh_replay.py`](analyze_refresh_replay.py) | reduces the klt report into `points.csv` + `summary.json` (refuses to overwrite) |
| [`gen_rwl_driver_sweep.py`](gen_rwl_driver_sweep.py) | #134: RWL-driver sweep generator (declared slew / series R / release delay, declared-change-only verification, probes at the cell pin); writes a NEW `driver_sweep_results/<RUN_ID>/` |
| [`analyze_rwl_driver_sweep.py`](analyze_rwl_driver_sweep.py) | #134: reduces the klt report into `points.csv` + `summary.json` (separate restoration / time-budget verdicts, controls reproduction, envelope, pin-crossing view) |
| [`gen_init_control.py`](gen_init_control.py) | #139: matched initialization-control generator (legacy / pin IC / physical write-settle regimes, no-write negative control, declared-change-only verification against the legacy instance); writes a NEW `init_control_results/<RUN_ID>/` |
| [`analyze_init_control.py`](analyze_init_control.py) | #139: per-record intended / achieved post-write / pre-read level, signed decision, restore fraction; reproduction of #131/#134, documented-claim check, sense-vs-pre-read attribution, negative controls (`--out-dir` for append-only re-analysis) |
| [`test_init_control.py`](test_init_control.py) | #139: generator tamper tests, analyzer tests (mislabeled pre-read, wrong sense hidden by a restore ratio, init negative control), committed-run self-consistency |
| [`test_refresh_replay.py`](test_refresh_replay.py) | stdlib tests (converter, consistency check, analysis logic, committed-run self-consistency); wired into `evidence-checks.yml` |

## Pin mapping (explicit; `replay_lib.PIN_MAP`)

| RTL strobe | Deck source (per instance) | Polarity | Meaning in the unchanged circuit |
|---|---|---|---|
| `pre_en` | `vctl` -> switch control `ctl` | active-high | closes the 100 ohm precharge switches (rbl -> VRBL, ref -> VREF) |
| `rwl_sel` | `vrs` -> `rwls` (read-device source of the selected row) | **inverted**: asserted = 0 V, idle = VDD | read select |
| `sense_en` | `ven` -> `en`; `venb` is its exact complement | active-high | latch footer/header enable |
| `wwl_en` | `vww` -> `wwl` | active-high | write wordline of the selected row |
| `bl_drive` | `vwc` -> `wbc` | active-high | closes the switch connecting the latch complement node `ref` to WBL. The existing circuit has no separate column driver; that is #114/#117, out of scope |

Converter rules (no implicit behaviour): an edge at T starts a 0.1 ns linear ramp at T (same as sim/refresh-op);
edges at exactly t = 0 set the initial value; edges closer than 0.1 ns, repeated values and negative times are errors.
Nothing is stretched, delayed or held by the converter.

## Variants (same deck, circuit, initial levels, loads, criteria; only the control PWL differs)

| Variant | Waveform |
|---|---|
| `baseline_analog` | the sim/refresh-op sequence for SENSE 10 ns / WWL 20 ns: precharge 0-2 ns, 2 ns dead gap, select at 4 ns, enable at 14 ns held with RWL and bitline connect until 2 ns after WWL falls (37 ns) |
| `rtl_raw` | the RTL edges only: PRE 0-2, RWL 2-12, 1-cycle `sense_en` at 11-12, WWL 12-32, BL drive 12-34 |
| `rtl_hold` | `rtl_raw` plus the **explicit adapter** `latch_en_held`: enable set at the `sense_en` rise (11 ns), cleared at the `busy` fall (34 ns). Recorded as its own waveform in `waveforms.json`. 0 ns added latency (assumption). RWL is deliberately NOT held (that would change the RTL ordering) |
| `neg_missing_wb` | `rtl_hold` with the `wwl_en`/`bl_drive` edges deleted (negative control) |
| `neg_short_wb` | `rtl_hold` with a 0.2 ns write-back pulse (negative control) |

## Consistency checks and negative controls

* `consistency_check.json` (per instance): `deck_matches_trace` re-parses the generated deck's PWL sources
  and compares them to the variant's edge list; `trace_matches_golden_rtl` compares the variant's edges with the
  golden RTL export. The checker reports `omitted`, `extra`, `shifted`, `value_mismatch`, `reordered`, `initial_mismatch`.
  Unit tests cover each kind and a tampered deck.
* The negative controls differ from the golden trace by design: `neg_missing_wb` is flagged `omitted` (4 edges),
  `neg_short_wb` `shifted`. `negative_control_ok` additionally requires every stored-'1' pattern to be
  flagged **not restored**: true at 10/10 corners for both. Simulator success never counts as restoration.

## Machine-readable result (`summary.json`, `points.csv`)

Per (corner, variant): `simulator_ok`, `conversion_valid`, `sense_correct` (+ per pattern), `restore_success` (headline
FRAC 0.95; also 0.90/0.98 and per pattern), `duration`, `overall_pass` = all four verdicts. Also the run pins:
generated-deck sha256 (equals klt's `netlist_sha256`), request sha256, git head and source file sha256s,
phase_seq/testbench sha256, iverilog version, report provenance (klt 0.6.0, ngspice 46, model library sha256
`48de7c67...133c84`, open_pdks `c6d73a35...` per [`docs/pdk-pin.md`](../../docs/pdk-pin.md)), batch job id.

## Duration vs the provisional 34-cycle budget (`T_ROW` = 34, ASSUMPTION)

| Variant | Last control edge / op end | Completion observed (`done` rise + 1 cycle) | SN read at (end + 2 ns) | Fits 34 ns? |
|---|---:|---:|---:|---|
| `rtl_raw`, `rtl_hold` | 34 ns (busy fall) | 35 ns | 36 ns | op end: yes, **zero slack**; with the `done` observation cycle: no (35); with the 2 ns settle used for the restore measurement: no (36) |
| `baseline_analog` | 37 ns | 37 ns (no digital completion strobe) | 39 ns | no (+3 ns) |

Launch, adapter and completion latency are modelled as 0 ns (ideal; stated assumption), so these are lower
bounds; the `done`-cycle row is the only completion delay in the RTL. These numbers say nothing about whether a
restoring waveform fits: the RTL waveform fits the budget but did not restore; the waveform that restores (baseline) does not fit.
Scheduler timing was not changed.

## Proposed follow-up (not done here; needs its own issue and evidence)

Because the RTL waveform fails restoration, a contract change must be proposed separately with evidence.
Candidates this data motivates, none applied: (a) hold the read select until after WWL falls (overlap rule
change), (b) a latch-hold adapter plus a post-write settle/RWL-release phase, (c) re-defining the restore
measurement point. The 0.08-0.27 V post-WWL-fall rise that lifts the baseline is a candidate cause
of the difference and may be an artifact of the ideal-driver study circuit; that matters before any contract is
changed (#114/#117, #88/#89 for physical drivers and loads, #94 for mixed-pattern trajectories).

## Notes on reproducibility and the host

* Fleet: the 10-corner grid is **one `klt sim` batch request**. Job `klt-sim-d93e7ee207ea` (c7i.4xlarge spot,
  94 s). Earlier submissions of the same request were refused (`batch_no_capacity`; then "8 instance(s) already
  running ... exceeds BATCH_MAX_CONCURRENT_INSTANCES=8") and one failed with `batch_runner_version_mismatch`
  (runner klt 0.5.0 vs client 0.7.0, job `klt-sim-ecd96902de94`); the accepted run used
  `uvx --from klayout-tools==0.6.0 klt`. Log: `results/20261010T094617Z/fleet_attempts.json`. No local fallback
  of the grid occurred. The only local run was an uncommitted tt/27 C single-corner probe on an earlier deck revision.
* The committed report is gzip-compressed with the bucket name redacted.
* klayout-tools friction (already known, tool gap not design): the installed client (0.7.0) is rejected by
  the fleet runner (0.5.0); the working client had to be pinned to 0.6.0.

```
python3 -I sim/refresh-replay/export_rtl_trace.py /tmp/rtl_trace.json
python3 -I sim/refresh-replay/gen_refresh_replay.py /tmp/rtl_trace.json          # new results/<RUN_ID>/
uvx --from klayout-tools==0.6.0 klt sim --backend batch --format json results/<RUN_ID>/request.json   # from the repo root
python3 -I sim/refresh-replay/analyze_refresh_replay.py sim/refresh-replay/results/<RUN_ID>
python3 -I sim/refresh-replay/test_refresh_replay.py

# #134 driver sweep (new run directory under driver_sweep_results/)
python3 -I sim/refresh-replay/gen_rwl_driver_sweep.py /tmp/rtl_trace.json
uvx --from klayout-tools==0.6.0 klt sim --backend batch --format json sim/refresh-replay/driver_sweep_results/<RUN_ID>/request.json
python3 -I sim/refresh-replay/analyze_rwl_driver_sweep.py sim/refresh-replay/driver_sweep_results/<RUN_ID>

# #139 matched initialization controls (new run directory under init_control_results/)
python3 -I sim/refresh-replay/gen_init_control.py /tmp/rtl_trace.json
uvx --from klayout-tools==0.6.0 klt sim --backend batch --format json sim/refresh-replay/init_control_results/<RUN_ID>/request.json > report.json
python3 -I sim/refresh-replay/analyze_init_control.py sim/refresh-replay/init_control_results/<RUN_ID> --report report.json
python3 -I sim/refresh-replay/test_init_control.py
```

Run `20261010T130000Z` (issue #131): one `klt sim` batch request (`uvx --from klayout-tools==0.6.0 klt sim --backend batch --format json`,
job `klt-sim-b8ad51731243`, c7i.4xlarge spot, 95 s, 10/10 corners; first and only submission, no local simulation, no fallback;
`fleet_attempts.json`). The report arrived on stdout (the `-o` file was not written by this client); the bucket name is redacted in the gzip.

Rerun with a **new** run id; never edit `results/`.
