2AMLogic/sky130-gcedram/digital/sched-phase-integration/TIMING_REPORT.md

# Scheduler/sequencer timing report (PROPOSED, behavioral)

Issue #135. Generated by `run_tests.sh`; logs in
[`results/run_tests_2026-10-10.txt`](results/run_tests_2026-10-10.txt) and
[`results/run_mutation_2026-10-10.txt`](results/run_mutation_2026-10-10.txt)
(Icarus Verilog 13.0, pinned `v13_0`). Time base 1 cycle = 1 ns is an
ASSUMPTION inherited from the scheduler. All phase durations are ASSUMPTION or
SOURCED-by-deck as tagged in `../phase-control/CONTRACT.md`. Scheduler:
`T_ROW` = `T_ACC` = 34, 32 rows, ratified `INTERVAL` 5029. Nothing here is
analog restoration, CDC, synthesis or sign-off evidence, and no spec or
production module was changed.

## 1. Observed boundary (anchored 2+10+20+2, GAP=0)

The scheduler registers `op_busy`/`op_row`/kind on its decision edge. The
adapter turns the first `op_busy` cycle into `start`; the sequencer registers
it, so its `busy` rises one cycle after the scheduler's. Cycle trace of one
REFRESH (row 0) from `+TRACE` (cycle numbers from the harness; row 1 launches
immediately after):
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
