2AMLogic/sky130-gcedram/sim/append_only_inventory.txt

# Append-only evidence inventory (read by sim/check_append_only.py, issue #67)
#
# Every tracked file under sim/ with a directory component named `results`
# is protected automatically and does NOT need to be listed here.
#
# List here, one repository-relative path per line, any committed
# result-summary file that lives OUTSIDE a `results` directory. Do not list
# configuration or input files (e.g. config JSON) -- only results.
# Lines starting with `#` and blank lines are ignored.
#
# The checker reads this file from the merge-base commit, so removing an
# entry in a PR does not remove protection within that PR.
#
# Inventory as of 2026-10-09 (origin/main @ e69a94a): empty -- every tracked
# result summary under sim/ is already inside a `results` directory.
layout/results/density_20261009.json
#
# sim/refresh-energy (issue #115): array-boundary refresh energy / standby power.
# These live inside a `results` directory and are therefore already protected by
# the rule above; they are listed explicitly so the study's evidence is registered.
sim/refresh-energy/results/klt_report_20261010T055142Z.json.gz
sim/refresh-energy/results/klt_report_fine_20261010T055550Z.json.gz
sim/refresh-energy/results/refresh_energy_sources_20261010T055142Z.csv
sim/refresh-energy/results/refresh_energy_points_20261010T055142Z.csv
sim/refresh-energy/results/refresh_energy_scaling_20261010T055142Z.csv
sim/refresh-energy/results/refresh_energy_summary_20261010T055142Z.json
#
# sim/retention (issue #89): array-context C_SN capacitance-only comparison.
# Inside a `results` directory (already protected); listed to register it.
sim/retention/results/array_c_sn_comparison_20261011T020547Z.json
#
# layout/compact (issue #100): bitcell-compaction density results.
layout/results/density_20261015_v1.json
layout/results/density_20261015_v2.json
#
# issue #161: compact-layout (#100) parasitics, geometry-matched leakage and retention-budget re-check.
# The sim/ files are inside `results` directories (already protected); listed to register them.
layout/results/compact_parasitics_20261020T171849Z.json
sim/leakage/compact-geometry/results/klt_report_20261020T1716Z.json
sim/leakage/compact-geometry/results/compact_leakage_points_20261020T1716Z.csv
sim/leakage/compact-geometry/results/compact_leakage_summary_20261020T1716Z.json
sim/retention/results/compact_c_sn_20261020T172043Z.json
#
# issue #208: device-inclusive C_SN of the compact v2 array (measurement only; no ruling).
# Inside `results` directories (already protected); listed to register them.
sim/retention/results/klt_report_20261022T0533Z.json
sim/retention/results/compact_device_c_sn_20261022T0533Z.json
