2AMLogic/sky130-gcedram/sim/bitcell-transient/results/bitcell_transient_results.csv

timestamp_utc | repo_git_sha | pdk_open_pdks_commit | ngspice_version | corner | temp_c | stored_value | c_sn_ff | c_sn_source | vdd_v | vrbl_bias_v | t_edge_ns | t_wl_pulse_ns | t_rwl_pulse_ns | tmax_s | tstop_s | v_sn_end_wl_pulse_v | v_sn_after_write_settled_v | v_sn_read_gate_v | i_read_a | i_rbl_deselect_a | i_read_ratio_1_over_0 | v_sn_read_disturb_v | v_sn_hold_start_v | v_sn_hold_end_v | hold_window_s | dvdt_hold_start_v_per_s | delta_v_sense_margin_v_ASSUMPTION | t_ret_tran_s | t_ret_linear_extrap_s | notes
2026-09-09T23:13:47+00:00 | c972c05 | c6d73a35f524070e85faff4a6a9eef49553ebc2b | ** ngspice-46 : Circuit level simulation program | tt | -40 | 1 | 0.605354 | extracted | 1.8 | 0.9 | 0.1 | 20.0 | 20.0 | 2.700979e-06 | 5.402012e-03 | 1.114414 | 0.960983 | 0.788438 | 1.995982e-06 | 4.673615e-11 | 7.439381e+02 | 0.000008 | 0.960991 | 0.016527 | 5.401957e-03 | -7.420646e+02 | 0.9 | 3.620912e-03 | 1.212832e-03 | EXTRACTED post-layout total for net `sn` from layout/gain_cell_2t.extract.parasitics.json (klt 0.3.0, input sha256:f55f08e3a2f85199d04d90f9007b5724b0d013604f054ce0dbf656f9f954d259): ground 0.586490 fF + lateral coupling to bl,rwl 0.018864 fF
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
