2AMLogic/sky130-gcedram/sim/leakage/results/leakage_results.csv

timestamp_utc | repo_git_sha | pdk_open_pdks_commit | corner | temp_c | device | w_um | l_um | vgs_v | vds_v | vbs_v | ileak_a | ngspice_version | notes
2026-08-20T21:10:17+00:00 | fe7b7ba | c6d73a35f524070e85faff4a6a9eef49553ebc2b | tt | -40 | sky130_fd_pr__nfet_01v8 | 0.42 | 0.15 | 0.0 | 1.8 | 0.0 | 1.810052e-12 | ** ngspice-47 : Circuit level simulation program
2026-08-20T21:10:17+00:00 | fe7b7ba | c6d73a35f524070e85faff4a6a9eef49553ebc2b | tt | 27 | sky130_fd_pr__nfet_01v8 | 0.42 | 0.15 | 0.0 | 1.8 | 0.0 | 1.845210e-12 | ** ngspice-47 : Circuit level simulation program
2026-08-20T21:10:17+00:00 | fe7b7ba | c6d73a35f524070e85faff4a6a9eef49553ebc2b | tt | 125 | sky130_fd_pr__nfet_01v8 | 0.42 | 0.15 | 0.0 | 1.8 | 0.0 | 1.152052e-11 | ** ngspice-47 : Circuit level simulation program
2026-08-20T21:10:17+00:00 | fe7b7ba | c6d73a35f524070e85faff4a6a9eef49553ebc2b | ss | -40 | sky130_fd_pr__nfet_01v8 | 0.42 | 0.15 | 0.0 | 1.8 | 0.0 | 1.810001e-12 | ** ngspice-47 : Circuit level simulation program
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
