2AMLogic/sky130-gcedram/sim/loaded-column/cold-corner/results/phase2_reproduction.csv

run_id | timestamp_utc | repo_git_sha | pdk_open_pdks_commit | ngspice_version | corner | temp_c | age_label | sel_row | stored_value | pattern_rows3210 | other_rows_pattern | status | reason | c_sn_ff | c_rbl_ff_ASSUMPTION | vdd_v | vrbl_precharge_v | t_read_s | t_sense_s_ASSUMPTION | dv_latency_v_ASSUMPTION | sel_row_age_at_read_s | max_row_age_at_read_s | v_sn_r0_wl_off_v | v_sn_r1_wl_off_v | v_sn_r2_wl_off_v | v_sn_r3_wl_off_v | v_sn_r0_after_write_v | v_sn_r1_after_write_v | v_sn_r2_after_write_v | v_sn_r3_after_write_v | v_sn_r0_preread_v | v_sn_r1_preread_v | v_sn_r2_preread_v | v_sn_r3_preread_v | v_rbl_preread_float_v | i_into_rbl_r0_preread_a | i_into_rbl_r1_preread_a | i_into_rbl_r2_preread_a | i_into_rbl_r3_preread_a | i_desel_sum_preread_a | i_into_rbl_r0_sense_a | i_into_rbl_r1_sense_a | i_into_rbl_r2_sense_a | i_into_rbl_r3_sense_a | i_desel_sum_sense_a | v_rbl_sense_v | v_rbl_end_v | dv_rbl_sense_v | latency_s | latency_reason | dv_sn_sel_read_disturb_v | dv_sn_unsel_worst_signed_v | notes
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
