2AMLogic/sky130-gcedram/sim/column-periphery/results/periphery_points_20261009T205913Z.csv

corner | temp_c | instance | settle_s | vrel_v | sn_v | din_v | dend_v | tdec_s
ff | 27 | ideal_w1 | 1.0999999999999859e-11 | 0.9 | 1.08833 | -0.305947 | -1.61236 | 1.0630000000000407e-10
ff | 27 | ideal_w0 | 1.105999999999996e-11 | 0.9 | -0.128406 | 0.101123 | 1.79999 | 1.4280000000000575e-10
ff | 27 | real_w1 | 5.541599999999999e-10 | 0.900017 | 1.08831 | -0.33712 | -1.79998 | 5.830000000000258e-11
ff | 27 | real_w0 | 5.848899999999998e-10 | 0.900012 | -0.148516 | 0.184919 | 1.79998 | 6.590000000000326e-11
ff | 27 | sw_0100 | 1.4903e-09 | 0.900059
ff | 27 | sw_0200 | 9.0014e-10 | 0.900032
ff | 27 | sw_0400 | 5.541599999999999e-10 | 0.900017
ff | 27 | sw_0800 | 3.5706e-10 | 0.900009
ff | 125 | ideal_w1 | 1.0889999999999949e-11 | 0.900007 | 1.19004 | -0.371714 | -1.58964 | 8.269999999999848e-11
ff | 125 | ideal_w0 | 1.0999999999999859e-11 | 0.900004 | -0.119868 | 0.118825 | 1.79932 | 1.2540000000000455e-10
ff | 125 | real_w1 | 2.9073999999999997e-10 | 0.900185 | 1.19002 | -0.42087 | -1.7992 | 4.6600000000005195e-11
ff | 125 | real_w0 | 3.133099999999998e-10 | 0.900102 | -0.137599 | 0.230509 | 1.79922 | 5.420000000000587e-11
ff | 125 | sw_0100 | 8.065099999999999e-10 | 0.90074
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
