2AMLogic/sky130-gcedram/sim/column-periphery/results/periphery_points_20261028T085441Z.csv

corner | temp_c | instance | settle_s | vrel_v | sn_v | din_v | dend_v | tdec_s
ff | 27 | ideal_w1 | 1.1019999999999823e-11 | 0.9 | 1.09517 | -0.329742 | -1.61777 | 1.0210000000000195e-10
ff | 27 | ideal_w0 | 1.1069999999999839e-11 | 0.9 | -0.123883 | 0.101262 | 1.79999 | 1.4270000000000034e-10
ff | 27 | real_w1 | 5.626999999999999e-10 | 0.900015 | 1.09515 | -0.36131 | -1.79998 | 5.6700000000008707e-11
ff | 27 | real_w0 | 5.919499999999998e-10 | 0.900012 | -0.144271 | 0.185098 | 1.79998 | 6.580000000001108e-11
ff | 27 | sw_0100 | 1.5229e-09 | 0.900053
ff | 27 | sw_0200 | 9.1743e-10 | 0.900029
ff | 27 | sw_0400 | 5.626999999999999e-10 | 0.900015
ff | 27 | sw_0800 | 3.609199999999998e-10 | 0.900008
ff | 125 | ideal_w1 | 1.092e-11 | 0.900006 | 1.19627 | -0.392525 | -1.59576 | 7.960000000000291e-11
ff | 125 | ideal_w0 | 1.1019999999999823e-11 | 0.900004 | -0.116494 | 0.118927 | 1.79932 | 1.2540000000000455e-10
ff | 125 | real_w1 | 2.9691999999999984e-10 | 0.90016 | 1.19624 | -0.441963 | -1.7992 | 4.500000000001132e-11
ff | 125 | real_w0 | 3.1644e-10 | 0.900102 | -0.134613 | 0.230655 | 1.79922 | 5.4100000000000465e-11
ff | 125 | sw_0100 | 8.319299999999998e-10 | 0.90064
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
