2AMLogic/sky130-gcedram/sim/loaded-column/cold-corner/results/pass_fail_20261005T145658Z.csv

variant_id | class | corner | temp_c | age | PASS | complete | separation_ok | latency_ok | read_disturb_ok | worst_case_separation_v | stored1_highest_rbl_v | stored1_worst_sel_row | stored1_worst_pattern_rows3210 | stored0_lowest_rbl_v | latency_stored1_max_s | n_latency_missing_stored1 | read_disturb_sel_abs_max_v | read_disturb_unsel_abs_max_v | v_sn1_after_write_min_v | v_sn1_preread_min_v | v_sn1_at_sense_min_v
phase2_baseline | phase2_committed | tt | -40 | fresh | True | True | True | True | True | 0.6477059000000001 | 0.2510849 | 0 | 1111 | 0.8987908 | 7.428302e-10 | 0 | 0.06430857 | 0.05992859 | 0.9593929 | 0.9593867
phase2_baseline | phase2_committed | tt | -40 | refresh_bound | True | True | True | True | True | 0.6331718000000001 | 0.2656189 | 0 | 1111 | 0.8987907 | 7.822542e-10 | 0 | 0.06449356 | 0.06013572 | 0.9593929 | 0.9555626
phase2_baseline | phase2_committed | tt | 27 | fresh | True | True | True | True | True | 0.6505377 | 0.248271 | 0 | 1111 | 0.8988087 | 2.533985e-10 | 0 | 0.05719923 | 0.05259554 | 1.027961 | 1.027955
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
