2AMLogic/sky130-gcedram/sim/refresh-replay/driver_sweep_reanalysis/20261010T141816Z-pattern-aware/points.csv

corner | temp_c | instance | variant | group | slew_ns | r_ohm | release_delay_ns | kind | sn_pre_v | pin_ic | snpre_v | dec_v | decided | snend_v | sn_ref_v | snend_over_sn_ref | snrd_v | sn_before_wwl_fall_v | sn_after_wwl_fall_v | sn_before_rwl_release_v | sn_after_rwl_release_v | sn_settle_v | pin_v_at_gating_probe | pin_v_at_release_plus_0p2ns | pin_release_50_ns | pin_release_90_ns | pin_crossing_method | pin_assert_50_ns | pins0_v | pins1_v | pins2_v | pins3_v | pins4_v | pins5_v | pins6_v | pins7_v | pins8_v | pins9_v | pins10_v | pins11_v | pins12_v | pins13_v | pins14_v | wwl_fall_50_ns | t_src_release_start_ns | t_src_release_50_ns | t_gating_probe_ns | sense_correct | snt0_v | snt1_v | snt2_v | snt3_v | snt4_v | snt5_v | snt6_v | restored_90 | restored_95 | restored_98
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
