2AMLogic/sky130-gcedram/sim/refresh-replay/init_control_results/20261010T163500Z/init_control.spice

* refresh_replay.spice -- RTL-strobe replay of one REFRESH op in the refresh-op circuit, issue #128
* GENERATED by gen_refresh_replay.py; do not edit by hand.
*
* PROPOSED/UNRATIFIED SCOPE: 27 C and 125 C, tt/ss/ff/sf/fs global corners, 1.8 V, no mismatch.
* Circuit body identical to sim/refresh-op/refresh_op.spice (ideal drivers, 100 ohm switches,
* C_RBL = C_WBL = 10 fF assumed, 4-row column, ref = VRBL - 100 mV, same latch); ONLY the control
* PWL sources differ. Sources per instance: ctl<-pre_en, rwls<-rwl_sel (inverted), en/enb<-sense_en
* (or the latch-hold adapter waveform), wwl<-wwl_en, wbc<-bl_drive. Instance suffix = variant.

.param VDD   = 1.8
.param VRBL  = 0.9   $ ASSUMPTION (contract)
.param C_RBL = 1e-14   $ ASSUMPTION (contract; not extracted)
.param C_WBL = 1e-14   $ ASSUMPTION (not extracted)
.param C_SN  = 6.05354e-16   $ extracted-from-netlist (layout/gain_cell_2t.extract.parasitics.json)

* ---- shared static drivers (ideal) ----
vdd   vdd 0 dc {VDD}
vrwld rwl_des 0 dc {VDD}
vwwld wwl_des 0 dc 0
vpre  prea 0 dc {VRBL}
vref  pref 0 dc 0.8   $ reference = VRBL - 0.1 (ASSUMPTION)
.model swpre sw(vt=0.9 vh=0.1 ron=100 roff=1e12)
.model swwbl sw(vt=0.9 vh=0.1 ron=100 roff=1e12)

* ---- instance 0: op1_0900_baseline_analog (variant baseline_analog; probe dec 14.9 ns, release 37 ns, meas 39 ns) ----
vctl_op1_0900_baseline_analog ctl_op1_0900_baseline_analog 0 pwl(0.0000e+00 {VDD} 2.0000e-09 {VDD} 2.1000e-09 0)
vrs_op1_0900_baseline_analog rwls_op1_0900_baseline_analog 0 pwl(0.0000e+00 {VDD} 4.0000e-09 {VDD} 4.1000e-09 0 3.7000e-08 0 3.7100e-08 {VDD})
ven_op1_0900_baseline_analog en_op1_0900_baseline_analog 0 pwl(0.0000e+00 0 1.4000e-08 0 1.4100e-08 {VDD} 3.7000e-08 {VDD} 3.7100e-08 0)
venb_op1_0900_baseline_analog enb_op1_0900_baseline_analog 0 pwl(0.0000e+00 {VDD} 1.4000e-08 {VDD} 1.4100e-08 0 3.7000e-08 0 3.7100e-08 {VDD})
vww_op1_0900_baseline_analog wwl_op1_0900_baseline_analog 0 pwl(0.0000e+00 0 1.5000e-08 0 1.5100e-08 {VDD} 3.5000e-08 {VDD} 3.5100e-08 0)
vwc_op1_0900_baseline_analog wbc_op1_0900_baseline_analog 0 pwl(0.0000e+00 0 1.5000e-08 0 1.5100e-08 {VDD} 3.7000e-08 {VDD} 3.7100e-08 0)
swb_op1_0900_baseline_analog ref_op1_0900_baseline_analog wbl_op1_0900_baseline_analog wbc_op1_0900_baseline_analog 0 swwbl
cwbl_op1_0900_baseline_analog wbl_op1_0900_baseline_analog 0 {C_WBL}
spa_op1_0900_baseline_analog prea rbl_op1_0900_baseline_analog ctl_op1_0900_baseline_analog 0 swpre
spr_op1_0900_baseline_analog pref ref_op1_0900_baseline_analog ctl_op1_0900_baseline_analog 0 swpre
crbl_op1_0900_baseline_analog rbl_op1_0900_baseline_analog 0 {C_RBL}
cref_op1_0900_baseline_analog ref_op1_0900_baseline_analog 0 {C_RBL}   $ ASSUMPTION: ideal matched dummy load
XMWR_op1_0900_baseline_analog_0 sn_op1_0900_baseline_analog_0 wwl_op1_0900_baseline_analog wbl_op1_0900_baseline_analog 0 sky130_fd_pr__nfet_01v8 L=0.15 W=0.42 nf=1 ad=0.1218 as=0.1218 pd=1.42 ps=1.42 nrd=0.69047619047619  nrs=0.69047619047619 sa=0 sb=0 sd=0 mult=1 m=1
XMRD_op1_0900_baseline_analog_0 rbl_op1_0900_baseline_analog sn_op1_0900_baseline_analog_0 rwls_op1_0900_baseline_analog 0 sky130_fd_pr__nfet_01v8 L=0.15 W=0.42 nf=1 ad=0.1218 as=0.1218 pd=1.42 ps=1.42 nrd=0.69047619047619  nrs=0.69047619047619 sa=0 sb=0 sd=0 mult=1 m=1
csn_op1_0900_baseline_analog_0 sn_op1_0900_baseline_analog_0 0 {C_SN}
XMWR_op1_0900_baseline_analog_1 sn_op1_0900_baseline_analog_1 wwl_des wbl_op1_0900_baseline_analog 0 sky130_fd_pr__nfet_01v8 L=0.15 W=0.42 nf=1 ad=0.1218 as=0.1218 pd=1.42 ps=1.42 nrd=0.69047619047619  nrs=0.69047619047619 sa=0 sb=0 sd=0 mult=1 m=1
XMRD_op1_0900_baseline_analog_1 rbl_op1_0900_baseline_analog sn_op1_0900_baseline_analog_1 rwl_des 0 sky130_fd_pr__nfet_01v8 L=0.15 W=0.42 nf=1 ad=0.1218 as=0.1218 pd=1.42 ps=1.42 nrd=0.69047619047619  nrs=0.69047619047619 sa=0 sb=0 sd=0 mult=1 m=1
csn_op1_0900_baseline_analog_1 sn_op1_0900_baseline_analog_1 0 {C_SN}
XMWR_op1_0900_baseline_analog_2 sn_op1_0900_baseline_analog_2 wwl_des wbl_op1_0900_baseline_analog 0 sky130_fd_pr__nfet_01v8 L=0.15 W=0.42 nf=1 ad=0.1218 as=0.1218 pd=1.42 ps=1.42 nrd=0.69047619047619  nrs=0.69047619047619 sa=0 sb=0 sd=0 mult=1 m=1
XMRD_op1_0900_baseline_analog_2 rbl_op1_0900_baseline_analog sn_op1_0900_baseline_analog_2 rwl_des 0 sky130_fd_pr__nfet_01v8 L=0.15 W=0.42 nf=1 ad=0.1218 as=0.1218 pd=1.42 ps=1.42 nrd=0.69047619047619  nrs=0.69047619047619 sa=0 sb=0 sd=0 mult=1 m=1
csn_op1_0900_baseline_analog_2 sn_op1_0900_baseline_analog_2 0 {C_SN}
XMWR_op1_0900_baseline_analog_3 sn_op1_0900_baseline_analog_3 wwl_des wbl_op1_0900_baseline_analog 0 sky130_fd_pr__nfet_01v8 L=0.15 W=0.42 nf=1 ad=0.1218 as=0.1218 pd=1.42 ps=1.42 nrd=0.69047619047619  nrs=0.69047619047619 sa=0 sb=0 sd=0 mult=1 m=1
XMRD_op1_0900_baseline_analog_3 rbl_op1_0900_baseline_analog sn_op1_0900_baseline_analog_3 rwl_des 0 sky130_fd_pr__nfet_01v8 L=0.15 W=0.42 nf=1 ad=0.1218 as=0.1218 pd=1.42 ps=1.42 nrd=0.69047619047619  nrs=0.69047619047619 sa=0 sb=0 sd=0 mult=1 m=1
csn_op1_0900_baseline_analog_3 sn_op1_0900_baseline_analog_3 0 {C_SN}
XMN1_op1_0900_baseline_analog rbl_op1_0900_baseline_analog ref_op1_0900_baseline_analog vn_op1_0900_baseline_analog 0 sky130_fd_pr__nfet_01v8 L=0.15 W=1 nf=1 ad=0.29 as=0.29 pd=2.58 ps=2.58 mult=1 m=1
XMN2_op1_0900_baseline_analog ref_op1_0900_baseline_analog rbl_op1_0900_baseline_analog vn_op1_0900_baseline_analog 0 sky130_fd_pr__nfet_01v8 L=0.15 W=1 nf=1 ad=0.29 as=0.29 pd=2.58 ps=2.58 mult=1 m=1
XMP1_op1_0900_baseline_analog rbl_op1_0900_baseline_analog ref_op1_0900_baseline_analog vp_op1_0900_baseline_analog vdd sky130_fd_pr__pfet_01v8 L=0.15 W=2 nf=1 ad=0.58 as=0.58 pd=4.58 ps=4.58 mult=1 m=1
XMP2_op1_0900_baseline_analog ref_op1_0900_baseline_analog rbl_op1_0900_baseline_analog vp_op1_0900_baseline_analog vdd sky130_fd_pr__pfet_01v8 L=0.15 W=2 nf=1 ad=0.58 as=0.58 pd=4.58 ps=4.58 mult=1 m=1
XMNF_op1_0900_baseline_analog vn_op1_0900_baseline_analog en_op1_0900_baseline_analog 0 0 sky130_fd_pr__nfet_01v8 L=0.15 W=2 nf=1 ad=0.58 as=0.58 pd=4.58 ps=4.58 mult=1 m=1
XMPH_op1_0900_baseline_analog vp_op1_0900_baseline_analog enb_op1_0900_baseline_analog vdd vdd sky130_fd_pr__pfet_01v8 L=0.15 W=4 nf=1 ad=1.16 as=1.16 pd=8.58 ps=8.58 mult=1 m=1
bd_op1_0900_baseline_analog d_op1_0900_baseline_analog 0 v=v(rbl_op1_0900_baseline_analog)-v(ref_op1_0900_baseline_analog)

* ---- instance 1: op1_1000_baseline_analog (variant baseline_analog; probe dec 14.9 ns, release 37 ns, meas 39 ns) ----
vctl_op1_1000_baseline_analog ctl_op1_1000_baseline_analog 0 pwl(0.0000e+00 {VDD} 2.0000e-09 {VDD} 2.1000e-09 0)
vrs_op1_1000_baseline_analog rwls_op1_1000_baseline_analog 0 pwl(0.0000e+00 {VDD} 4.0000e-09 {VDD} 4.1000e-09 0 3.7000e-08 0 3.7100e-08 {VDD})
ven_op1_1000_baseline_analog en_op1_1000_baseline_analog 0 pwl(0.0000e+00 0 1.4000e-08 0 1.4100e-08 {VDD} 3.7000e-08 {VDD} 3.7100e-08 0)
venb_op1_1000_baseline_analog enb_op1_1000_baseline_analog 0 pwl(0.0000e+00 {VDD} 1.4000e-08 {VDD} 1.4100e-08 0 3.7000e-08 0 3.7100e-08 {VDD})
vww_op1_1000_baseline_analog wwl_op1_1000_baseline_analog 0 pwl(0.0000e+00 0 1.5000e-08 0 1.5100e-08 {VDD} 3.5000e-08 {VDD} 3.5100e-08 0)
vwc_op1_1000_baseline_analog wbc_op1_1000_baseline_analog 0 pwl(0.0000e+00 0 1.5000e-08 0 1.5100e-08 {VDD} 3.7000e-08 {VDD} 3.7100e-08 0)
swb_op1_1000_baseline_analog ref_op1_1000_baseline_analog wbl_op1_1000_baseline_analog wbc_op1_1000_baseline_analog 0 swwbl
cwbl_op1_1000_baseline_analog wbl_op1_1000_baseline_analog 0 {C_WBL}
spa_op1_1000_baseline_analog prea rbl_op1_1000_baseline_analog ctl_op1_1000_baseline_analog 0 swpre
spr_op1_1000_baseline_analog pref ref_op1_1000_baseline_analog ctl_op1_1000_baseline_analog 0 swpre
crbl_op1_1000_baseline_analog rbl_op1_1000_baseline_analog 0 {C_RBL}
cref_op1_1000_baseline_analog ref_op1_1000_baseline_analog 0 {C_RBL}   $ ASSUMPTION: ideal matched dummy load
XMWR_op1_1000_baseline_analog_0 sn_op1_1000_baseline_analog_0 wwl_op1_1000_baseline_analog wbl_op1_1000_baseline_analog 0 sky130_fd_pr__nfet_01v8 L=0.15 W=0.42 nf=1 ad=0.1218 as=0.1218 pd=1.42 ps=1.42 nrd=0.69047619047619  nrs=0.69047619047619 sa=0 sb=0 sd=0 mult=1 m=1
XMRD_op1_1000_baseline_analog_0 rbl_op1_1000_baseline_analog sn_op1_1000_baseline_analog_0 rwls_op1_1000_baseline_analog 0 sky130_fd_pr__nfet_01v8 L=0.15 W=0.42 nf=1 ad=0.1218 as=0.1218 pd=1.42 ps=1.42 nrd=0.69047619047619  nrs=0.69047619047619 sa=0 sb=0 sd=0 mult=1 m=1
csn_op1_1000_baseline_analog_0 sn_op1_1000_baseline_analog_0 0 {C_SN}
XMWR_op1_1000_baseline_analog_1 sn_op1_1000_baseline_analog_1 wwl_des wbl_op1_1000_baseline_analog 0 sky130_fd_pr__nfet_01v8 L=0.15 W=0.42 nf=1 ad=0.1218 as=0.1218 pd=1.42 ps=1.42 nrd=0.69047619047619  nrs=0.69047619047619 sa=0 sb=0 sd=0 mult=1 m=1
XMRD_op1_1000_baseline_analog_1 rbl_op1_1000_baseline_analog sn_op1_1000_baseline_analog_1 rwl_des 0 sky130_fd_pr__nfet_01v8 L=0.15 W=0.42 nf=1 ad=0.1218 as=0.1218 pd=1.42 ps=1.42 nrd=0.69047619047619  nrs=0.69047619047619 sa=0 sb=0 sd=0 mult=1 m=1
csn_op1_1000_baseline_analog_1 sn_op1_1000_baseline_analog_1 0 {C_SN}
XMWR_op1_1000_baseline_analog_2 sn_op1_1000_baseline_analog_2 wwl_des wbl_op1_1000_baseline_analog 0 sky130_fd_pr__nfet_01v8 L=0.15 W=0.42 nf=1 ad=0.1218 as=0.1218 pd=1.42 ps=1.42 nrd=0.69047619047619  nrs=0.69047619047619 sa=0 sb=0 sd=0 mult=1 m=1
XMRD_op1_1000_baseline_analog_2 rbl_op1_1000_baseline_analog sn_op1_1000_baseline_analog_2 rwl_des 0 sky130_fd_pr__nfet_01v8 L=0.15 W=0.42 nf=1 ad=0.1218 as=0.1218 pd=1.42 ps=1.42 nrd=0.69047619047619  nrs=0.69047619047619 sa=0 sb=0 sd=0 mult=1 m=1
csn_op1_1000_baseline_analog_2 sn_op1_1000_baseline_analog_2 0 {C_SN}
XMWR_op1_1000_baseline_analog_3 sn_op1_1000_baseline_analog_3 wwl_des wbl_op1_1000_baseline_analog 0 sky130_fd_pr__nfet_01v8 L=0.15 W=0.42 nf=1 ad=0.1218 as=0.1218 pd=1.42 ps=1.42 nrd=0.69047619047619  nrs=0.69047619047619 sa=0 sb=0 sd=0 mult=1 m=1
XMRD_op1_1000_baseline_analog_3 rbl_op1_1000_baseline_analog sn_op1_1000_baseline_analog_3 rwl_des 0 sky130_fd_pr__nfet_01v8 L=0.15 W=0.42 nf=1 ad=0.1218 as=0.1218 pd=1.42 ps=1.42 nrd=0.69047619047619  nrs=0.69047619047619 sa=0 sb=0 sd=0 mult=1 m=1
csn_op1_1000_baseline_analog_3 sn_op1_1000_baseline_analog_3 0 {C_SN}
XMN1_op1_1000_baseline_analog rbl_op1_1000_baseline_analog ref_op1_1000_baseline_analog vn_op1_1000_baseline_analog 0 sky130_fd_pr__nfet_01v8 L=0.15 W=1 nf=1 ad=0.29 as=0.29 pd=2.58 ps=2.58 mult=1 m=1
XMN2_op1_1000_baseline_analog ref_op1_1000_baseline_analog rbl_op1_1000_baseline_analog vn_op1_1000_baseline_analog 0 sky130_fd_pr__nfet_01v8 L=0.15 W=1 nf=1 ad=0.29 as=0.29 pd=2.58 ps=2.58 mult=1 m=1
XMP1_op1_1000_baseline_analog rbl_op1_1000_baseline_analog ref_op1_1000_baseline_analog vp_op1_1000_baseline_analog vdd sky130_fd_pr__pfet_01v8 L=0.15 W=2 nf=1 ad=0.58 as=0.58 pd=4.58 ps=4.58 mult=1 m=1
XMP2_op1_1000_baseline_analog ref_op1_1000_baseline_analog rbl_op1_1000_baseline_analog vp_op1_1000_baseline_analog vdd sky130_fd_pr__pfet_01v8 L=0.15 W=2 nf=1 ad=0.58 as=0.58 pd=4.58 ps=4.58 mult=1 m=1
XMNF_op1_1000_baseline_analog vn_op1_1000_baseline_analog en_op1_1000_baseline_analog 0 0 sky130_fd_pr__nfet_01v8 L=0.15 W=2 nf=1 ad=0.58 as=0.58 pd=4.58 ps=4.58 mult=1 m=1
XMPH_op1_1000_baseline_analog vp_op1_1000_baseline_analog enb_op1_1000_baseline_analog vdd vdd sky130_fd_pr__pfet_01v8 L=0.15 W=4 nf=1 ad=1.16 as=1.16 pd=8.58 ps=8.58 mult=1 m=1
bd_op1_1000_baseline_analog d_op1_1000_baseline_analog 0 v=v(rbl_op1_1000_baseline_analog)-v(ref_op1_1000_baseline_analog)

* ---- instance 2: op0_n100_baseline_analog (variant baseline_analog; probe dec 14.9 ns, release 37 ns, meas 39 ns) ----
vctl_op0_n100_baseline_analog ctl_op0_n100_baseline_analog 0 pwl(0.0000e+00 {VDD} 2.0000e-09 {VDD} 2.1000e-09 0)
vrs_op0_n100_baseline_analog rwls_op0_n100_baseline_analog 0 pwl(0.0000e+00 {VDD} 4.0000e-09 {VDD} 4.1000e-09 0 3.7000e-08 0 3.7100e-08 {VDD})
ven_op0_n100_baseline_analog en_op0_n100_baseline_analog 0 pwl(0.0000e+00 0 1.4000e-08 0 1.4100e-08 {VDD} 3.7000e-08 {VDD} 3.7100e-08 0)
venb_op0_n100_baseline_analog enb_op0_n100_baseline_analog 0 pwl(0.0000e+00 {VDD} 1.4000e-08 {VDD} 1.4100e-08 0 3.7000e-08 0 3.7100e-08 {VDD})
vww_op0_n100_baseline_analog wwl_op0_n100_baseline_analog 0 pwl(0.0000e+00 0 1.5000e-08 0 1.5100e-08 {VDD} 3.5000e-08 {VDD} 3.5100e-08 0)
vwc_op0_n100_baseline_analog wbc_op0_n100_baseline_analog 0 pwl(0.0000e+00 0 1.5000e-08 0 1.5100e-08 {VDD} 3.7000e-08 {VDD} 3.7100e-08 0)
swb_op0_n100_baseline_analog ref_op0_n100_baseline_analog wbl_op0_n100_baseline_analog wbc_op0_n100_baseline_analog 0 swwbl
cwbl_op0_n100_baseline_analog wbl_op0_n100_baseline_analog 0 {C_WBL}
spa_op0_n100_baseline_analog prea rbl_op0_n100_baseline_analog ctl_op0_n100_baseline_analog 0 swpre
spr_op0_n100_baseline_analog pref ref_op0_n100_baseline_analog ctl_op0_n100_baseline_analog 0 swpre
crbl_op0_n100_baseline_analog rbl_op0_n100_baseline_analog 0 {C_RBL}
cref_op0_n100_baseline_analog ref_op0_n100_baseline_analog 0 {C_RBL}   $ ASSUMPTION: ideal matched dummy load
XMWR_op0_n100_baseline_analog_0 sn_op0_n100_baseline_analog_0 wwl_op0_n100_baseline_analog wbl_op0_n100_baseline_analog 0 sky130_fd_pr__nfet_01v8 L=0.15 W=0.42 nf=1 ad=0.1218 as=0.1218 pd=1.42 ps=1.42 nrd=0.69047619047619  nrs=0.69047619047619 sa=0 sb=0 sd=0 mult=1 m=1
XMRD_op0_n100_baseline_analog_0 rbl_op0_n100_baseline_analog sn_op0_n100_baseline_analog_0 rwls_op0_n100_baseline_analog 0 sky130_fd_pr__nfet_01v8 L=0.15 W=0.42 nf=1 ad=0.1218 as=0.1218 pd=1.42 ps=1.42 nrd=0.69047619047619  nrs=0.69047619047619 sa=0 sb=0 sd=0 mult=1 m=1
csn_op0_n100_baseline_analog_0 sn_op0_n100_baseline_analog_0 0 {C_SN}
XMWR_op0_n100_baseline_analog_1 sn_op0_n100_baseline_analog_1 wwl_des wbl_op0_n100_baseline_analog 0 sky130_fd_pr__nfet_01v8 L=0.15 W=0.42 nf=1 ad=0.1218 as=0.1218 pd=1.42 ps=1.42 nrd=0.69047619047619  nrs=0.69047619047619 sa=0 sb=0 sd=0 mult=1 m=1
XMRD_op0_n100_baseline_analog_1 rbl_op0_n100_baseline_analog sn_op0_n100_baseline_analog_1 rwl_des 0 sky130_fd_pr__nfet_01v8 L=0.15 W=0.42 nf=1 ad=0.1218 as=0.1218 pd=1.42 ps=1.42 nrd=0.69047619047619  nrs=0.69047619047619 sa=0 sb=0 sd=0 mult=1 m=1
csn_op0_n100_baseline_analog_1 sn_op0_n100_baseline_analog_1 0 {C_SN}
XMWR_op0_n100_baseline_analog_2 sn_op0_n100_baseline_analog_2 wwl_des wbl_op0_n100_baseline_analog 0 sky130_fd_pr__nfet_01v8 L=0.15 W=0.42 nf=1 ad=0.1218 as=0.1218 pd=1.42 ps=1.42 nrd=0.69047619047619  nrs=0.69047619047619 sa=0 sb=0 sd=0 mult=1 m=1
XMRD_op0_n100_baseline_analog_2 rbl_op0_n100_baseline_analog sn_op0_n100_baseline_analog_2 rwl_des 0 sky130_fd_pr__nfet_01v8 L=0.15 W=0.42 nf=1 ad=0.1218 as=0.1218 pd=1.42 ps=1.42 nrd=0.69047619047619  nrs=0.69047619047619 sa=0 sb=0 sd=0 mult=1 m=1
csn_op0_n100_baseline_analog_2 sn_op0_n100_baseline_analog_2 0 {C_SN}
XMWR_op0_n100_baseline_analog_3 sn_op0_n100_baseline_analog_3 wwl_des wbl_op0_n100_baseline_analog 0 sky130_fd_pr__nfet_01v8 L=0.15 W=0.42 nf=1 ad=0.1218 as=0.1218 pd=1.42 ps=1.42 nrd=0.69047619047619  nrs=0.69047619047619 sa=0 sb=0 sd=0 mult=1 m=1
XMRD_op0_n100_baseline_analog_3 rbl_op0_n100_baseline_analog sn_op0_n100_baseline_analog_3 rwl_des 0 sky130_fd_pr__nfet_01v8 L=0.15 W=0.42 nf=1 ad=0.1218 as=0.1218 pd=1.42 ps=1.42 nrd=0.69047619047619  nrs=0.69047619047619 sa=0 sb=0 sd=0 mult=1 m=1
csn_op0_n100_baseline_analog_3 sn_op0_n100_baseline_analog_3 0 {C_SN}
XMN1_op0_n100_baseline_analog rbl_op0_n100_baseline_analog ref_op0_n100_baseline_analog vn_op0_n100_baseline_analog 0 sky130_fd_pr__nfet_01v8 L=0.15 W=1 nf=1 ad=0.29 as=0.29 pd=2.58 ps=2.58 mult=1 m=1
XMN2_op0_n100_baseline_analog ref_op0_n100_baseline_analog rbl_op0_n100_baseline_analog vn_op0_n100_baseline_analog 0 sky130_fd_pr__nfet_01v8 L=0.15 W=1 nf=1 ad=0.29 as=0.29 pd=2.58 ps=2.58 mult=1 m=1
XMP1_op0_n100_baseline_analog rbl_op0_n100_baseline_analog ref_op0_n100_baseline_analog vp_op0_n100_baseline_analog vdd sky130_fd_pr__pfet_01v8 L=0.15 W=2 nf=1 ad=0.58 as=0.58 pd=4.58 ps=4.58 mult=1 m=1
XMP2_op0_n100_baseline_analog ref_op0_n100_baseline_analog rbl_op0_n100_baseline_analog vp_op0_n100_baseline_analog vdd sky130_fd_pr__pfet_01v8 L=0.15 W=2 nf=1 ad=0.58 as=0.58 pd=4.58 ps=4.58 mult=1 m=1
XMNF_op0_n100_baseline_analog vn_op0_n100_baseline_analog en_op0_n100_baseline_analog 0 0 sky130_fd_pr__nfet_01v8 L=0.15 W=2 nf=1 ad=0.58 as=0.58 pd=4.58 ps=4.58 mult=1 m=1
XMPH_op0_n100_baseline_analog vp_op0_n100_baseline_analog enb_op0_n100_baseline_analog vdd vdd sky130_fd_pr__pfet_01v8 L=0.15 W=4 nf=1 ad=1.16 as=1.16 pd=8.58 ps=8.58 mult=1 m=1
bd_op0_n100_baseline_analog d_op0_n100_baseline_analog 0 v=v(rbl_op0_n100_baseline_analog)-v(ref_op0_n100_baseline_analog)

* ---- instance 3: op0_0000_baseline_analog (variant baseline_analog; probe dec 14.9 ns, release 37 ns, meas 39 ns) ----
vctl_op0_0000_baseline_analog ctl_op0_0000_baseline_analog 0 pwl(0.0000e+00 {VDD} 2.0000e-09 {VDD} 2.1000e-09 0)
vrs_op0_0000_baseline_analog rwls_op0_0000_baseline_analog 0 pwl(0.0000e+00 {VDD} 4.0000e-09 {VDD} 4.1000e-09 0 3.7000e-08 0 3.7100e-08 {VDD})
ven_op0_0000_baseline_analog en_op0_0000_baseline_analog 0 pwl(0.0000e+00 0 1.4000e-08 0 1.4100e-08 {VDD} 3.7000e-08 {VDD} 3.7100e-08 0)
venb_op0_0000_baseline_analog enb_op0_0000_baseline_analog 0 pwl(0.0000e+00 {VDD} 1.4000e-08 {VDD} 1.4100e-08 0 3.7000e-08 0 3.7100e-08 {VDD})
vww_op0_0000_baseline_analog wwl_op0_0000_baseline_analog 0 pwl(0.0000e+00 0 1.5000e-08 0 1.5100e-08 {VDD} 3.5000e-08 {VDD} 3.5100e-08 0)
vwc_op0_0000_baseline_analog wbc_op0_0000_baseline_analog 0 pwl(0.0000e+00 0 1.5000e-08 0 1.5100e-08 {VDD} 3.7000e-08 {VDD} 3.7100e-08 0)
swb_op0_0000_baseline_analog ref_op0_0000_baseline_analog wbl_op0_0000_baseline_analog wbc_op0_0000_baseline_analog 0 swwbl
cwbl_op0_0000_baseline_analog wbl_op0_0000_baseline_analog 0 {C_WBL}
spa_op0_0000_baseline_analog prea rbl_op0_0000_baseline_analog ctl_op0_0000_baseline_analog 0 swpre
spr_op0_0000_baseline_analog pref ref_op0_0000_baseline_analog ctl_op0_0000_baseline_analog 0 swpre
crbl_op0_0000_baseline_analog rbl_op0_0000_baseline_analog 0 {C_RBL}
cref_op0_0000_baseline_analog ref_op0_0000_baseline_analog 0 {C_RBL}   $ ASSUMPTION: ideal matched dummy load
XMWR_op0_0000_baseline_analog_0 sn_op0_0000_baseline_analog_0 wwl_op0_0000_baseline_analog wbl_op0_0000_baseline_analog 0 sky130_fd_pr__nfet_01v8 L=0.15 W=0.42 nf=1 ad=0.1218 as=0.1218 pd=1.42 ps=1.42 nrd=0.69047619047619  nrs=0.69047619047619 sa=0 sb=0 sd=0 mult=1 m=1
XMRD_op0_0000_baseline_analog_0 rbl_op0_0000_baseline_analog sn_op0_0000_baseline_analog_0 rwls_op0_0000_baseline_analog 0 sky130_fd_pr__nfet_01v8 L=0.15 W=0.42 nf=1 ad=0.1218 as=0.1218 pd=1.42 ps=1.42 nrd=0.69047619047619  nrs=0.69047619047619 sa=0 sb=0 sd=0 mult=1 m=1
csn_op0_0000_baseline_analog_0 sn_op0_0000_baseline_analog_0 0 {C_SN}
XMWR_op0_0000_baseline_analog_1 sn_op0_0000_baseline_analog_1 wwl_des wbl_op0_0000_baseline_analog 0 sky130_fd_pr__nfet_01v8 L=0.15 W=0.42 nf=1 ad=0.1218 as=0.1218 pd=1.42 ps=1.42 nrd=0.69047619047619  nrs=0.69047619047619 sa=0 sb=0 sd=0 mult=1 m=1
XMRD_op0_0000_baseline_analog_1 rbl_op0_0000_baseline_analog sn_op0_0000_baseline_analog_1 rwl_des 0 sky130_fd_pr__nfet_01v8 L=0.15 W=0.42 nf=1 ad=0.1218 as=0.1218 pd=1.42 ps=1.42 nrd=0.69047619047619  nrs=0.69047619047619 sa=0 sb=0 sd=0 mult=1 m=1
csn_op0_0000_baseline_analog_1 sn_op0_0000_baseline_analog_1 0 {C_SN}
XMWR_op0_0000_baseline_analog_2 sn_op0_0000_baseline_analog_2 wwl_des wbl_op0_0000_baseline_analog 0 sky130_fd_pr__nfet_01v8 L=0.15 W=0.42 nf=1 ad=0.1218 as=0.1218 pd=1.42 ps=1.42 nrd=0.69047619047619  nrs=0.69047619047619 sa=0 sb=0 sd=0 mult=1 m=1
XMRD_op0_0000_baseline_analog_2 rbl_op0_0000_baseline_analog sn_op0_0000_baseline_analog_2 rwl_des 0 sky130_fd_pr__nfet_01v8 L=0.15 W=0.42 nf=1 ad=0.1218 as=0.1218 pd=1.42 ps=1.42 nrd=0.69047619047619  nrs=0.69047619047619 sa=0 sb=0 sd=0 mult=1 m=1
csn_op0_0000_baseline_analog_2 sn_op0_0000_baseline_analog_2 0 {C_SN}
XMWR_op0_0000_baseline_analog_3 sn_op0_0000_baseline_analog_3 wwl_des wbl_op0_0000_baseline_analog 0 sky130_fd_pr__nfet_01v8 L=0.15 W=0.42 nf=1 ad=0.1218 as=0.1218 pd=1.42 ps=1.42 nrd=0.69047619047619  nrs=0.69047619047619 sa=0 sb=0 sd=0 mult=1 m=1
XMRD_op0_0000_baseline_analog_3 rbl_op0_0000_baseline_analog sn_op0_0000_baseline_analog_3 rwl_des 0 sky130_fd_pr__nfet_01v8 L=0.15 W=0.42 nf=1 ad=0.1218 as=0.1218 pd=1.42 ps=1.42 nrd=0.69047619047619  nrs=0.69047619047619 sa=0 sb=0 sd=0 mult=1 m=1
csn_op0_0000_baseline_analog_3 sn_op0_0000_baseline_analog_3 0 {C_SN}
XMN1_op0_0000_baseline_analog rbl_op0_0000_baseline_analog ref_op0_0000_baseline_analog vn_op0_0000_baseline_analog 0 sky130_fd_pr__nfet_01v8 L=0.15 W=1 nf=1 ad=0.29 as=0.29 pd=2.58 ps=2.58 mult=1 m=1
XMN2_op0_0000_baseline_analog ref_op0_0000_baseline_analog rbl_op0_0000_baseline_analog vn_op0_0000_baseline_analog 0 sky130_fd_pr__nfet_01v8 L=0.15 W=1 nf=1 ad=0.29 as=0.29 pd=2.58 ps=2.58 mult=1 m=1
XMP1_op0_0000_baseline_analog rbl_op0_0000_baseline_analog ref_op0_0000_baseline_analog vp_op0_0000_baseline_analog vdd sky130_fd_pr__pfet_01v8 L=0.15 W=2 nf=1 ad=0.58 as=0.58 pd=4.58 ps=4.58 mult=1 m=1
XMP2_op0_0000_baseline_analog ref_op0_0000_baseline_analog rbl_op0_0000_baseline_analog vp_op0_0000_baseline_analog vdd sky130_fd_pr__pfet_01v8 L=0.15 W=2 nf=1 ad=0.58 as=0.58 pd=4.58 ps=4.58 mult=1 m=1
XMNF_op0_0000_baseline_analog vn_op0_0000_baseline_analog en_op0_0000_baseline_analog 0 0 sky130_fd_pr__nfet_01v8 L=0.15 W=2 nf=1 ad=0.58 as=0.58 pd=4.58 ps=4.58 mult=1 m=1
XMPH_op0_0000_baseline_analog vp_op0_0000_baseline_analog enb_op0_0000_baseline_analog vdd vdd sky130_fd_pr__pfet_01v8 L=0.15 W=4 nf=1 ad=1.16 as=1.16 pd=8.58 ps=8.58 mult=1 m=1
bd_op0_0000_baseline_analog d_op0_0000_baseline_analog 0 v=v(rbl_op0_0000_baseline_analog)-v(ref_op0_0000_baseline_analog)

* ---- instance 4: op1_0900_rtl_hold (variant rtl_hold; probe dec 11.9 ns, release 34 ns, meas 36 ns) ----
vctl_op1_0900_rtl_hold ctl_op1_0900_rtl_hold 0 pwl(0.0000e+00 {VDD} 2.0000e-09 {VDD} 2.1000e-09 0)
vrs_op1_0900_rtl_hold rwls_op1_0900_rtl_hold 0 pwl(0.0000e+00 {VDD} 2.0000e-09 {VDD} 2.1000e-09 0 1.2000e-08 0 1.2100e-08 {VDD})
ven_op1_0900_rtl_hold en_op1_0900_rtl_hold 0 pwl(0.0000e+00 0 1.1000e-08 0 1.1100e-08 {VDD} 3.4000e-08 {VDD} 3.4100e-08 0)
venb_op1_0900_rtl_hold enb_op1_0900_rtl_hold 0 pwl(0.0000e+00 {VDD} 1.1000e-08 {VDD} 1.1100e-08 0 3.4000e-08 0 3.4100e-08 {VDD})
vww_op1_0900_rtl_hold wwl_op1_0900_rtl_hold 0 pwl(0.0000e+00 0 1.2000e-08 0 1.2100e-08 {VDD} 3.2000e-08 {VDD} 3.2100e-08 0)
vwc_op1_0900_rtl_hold wbc_op1_0900_rtl_hold 0 pwl(0.0000e+00 0 1.2000e-08 0 1.2100e-08 {VDD} 3.4000e-08 {VDD} 3.4100e-08 0)
swb_op1_0900_rtl_hold ref_op1_0900_rtl_hold wbl_op1_0900_rtl_hold wbc_op1_0900_rtl_hold 0 swwbl
cwbl_op1_0900_rtl_hold wbl_op1_0900_rtl_hold 0 {C_WBL}
spa_op1_0900_rtl_hold prea rbl_op1_0900_rtl_hold ctl_op1_0900_rtl_hold 0 swpre
spr_op1_0900_rtl_hold pref ref_op1_0900_rtl_hold ctl_op1_0900_rtl_hold 0 swpre
crbl_op1_0900_rtl_hold rbl_op1_0900_rtl_hold 0 {C_RBL}
cref_op1_0900_rtl_hold ref_op1_0900_rtl_hold 0 {C_RBL}   $ ASSUMPTION: ideal matched dummy load
XMWR_op1_0900_rtl_hold_0 sn_op1_0900_rtl_hold_0 wwl_op1_0900_rtl_hold wbl_op1_0900_rtl_hold 0 sky130_fd_pr__nfet_01v8 L=0.15 W=0.42 nf=1 ad=0.1218 as=0.1218 pd=1.42 ps=1.42 nrd=0.69047619047619  nrs=0.69047619047619 sa=0 sb=0 sd=0 mult=1 m=1
XMRD_op1_0900_rtl_hold_0 rbl_op1_0900_rtl_hold sn_op1_0900_rtl_hold_0 rwls_op1_0900_rtl_hold 0 sky130_fd_pr__nfet_01v8 L=0.15 W=0.42 nf=1 ad=0.1218 as=0.1218 pd=1.42 ps=1.42 nrd=0.69047619047619  nrs=0.69047619047619 sa=0 sb=0 sd=0 mult=1 m=1
csn_op1_0900_rtl_hold_0 sn_op1_0900_rtl_hold_0 0 {C_SN}
XMWR_op1_0900_rtl_hold_1 sn_op1_0900_rtl_hold_1 wwl_des wbl_op1_0900_rtl_hold 0 sky130_fd_pr__nfet_01v8 L=0.15 W=0.42 nf=1 ad=0.1218 as=0.1218 pd=1.42 ps=1.42 nrd=0.69047619047619  nrs=0.69047619047619 sa=0 sb=0 sd=0 mult=1 m=1
XMRD_op1_0900_rtl_hold_1 rbl_op1_0900_rtl_hold sn_op1_0900_rtl_hold_1 rwl_des 0 sky130_fd_pr__nfet_01v8 L=0.15 W=0.42 nf=1 ad=0.1218 as=0.1218 pd=1.42 ps=1.42 nrd=0.69047619047619  nrs=0.69047619047619 sa=0 sb=0 sd=0 mult=1 m=1
csn_op1_0900_rtl_hold_1 sn_op1_0900_rtl_hold_1 0 {C_SN}
XMWR_op1_0900_rtl_hold_2 sn_op1_0900_rtl_hold_2 wwl_des wbl_op1_0900_rtl_hold 0 sky130_fd_pr__nfet_01v8 L=0.15 W=0.42 nf=1 ad=0.1218 as=0.1218 pd=1.42 ps=1.42 nrd=0.69047619047619  nrs=0.69047619047619 sa=0 sb=0 sd=0 mult=1 m=1
XMRD_op1_0900_rtl_hold_2 rbl_op1_0900_rtl_hold sn_op1_0900_rtl_hold_2 rwl_des 0 sky130_fd_pr__nfet_01v8 L=0.15 W=0.42 nf=1 ad=0.1218 as=0.1218 pd=1.42 ps=1.42 nrd=0.69047619047619  nrs=0.69047619047619 sa=0 sb=0 sd=0 mult=1 m=1
csn_op1_0900_rtl_hold_2 sn_op1_0900_rtl_hold_2 0 {C_SN}
XMWR_op1_0900_rtl_hold_3 sn_op1_0900_rtl_hold_3 wwl_des wbl_op1_0900_rtl_hold 0 sky130_fd_pr__nfet_01v8 L=0.15 W=0.42 nf=1 ad=0.1218 as=0.1218 pd=1.42 ps=1.42 nrd=0.69047619047619  nrs=0.69047619047619 sa=0 sb=0 sd=0 mult=1 m=1
XMRD_op1_0900_rtl_hold_3 rbl_op1_0900_rtl_hold sn_op1_0900_rtl_hold_3 rwl_des 0 sky130_fd_pr__nfet_01v8 L=0.15 W=0.42 nf=1 ad=0.1218 as=0.1218 pd=1.42 ps=1.42 nrd=0.69047619047619  nrs=0.69047619047619 sa=0 sb=0 sd=0 mult=1 m=1
csn_op1_0900_rtl_hold_3 sn_op1_0900_rtl_hold_3 0 {C_SN}
XMN1_op1_0900_rtl_hold rbl_op1_0900_rtl_hold ref_op1_0900_rtl_hold vn_op1_0900_rtl_hold 0 sky130_fd_pr__nfet_01v8 L=0.15 W=1 nf=1 ad=0.29 as=0.29 pd=2.58 ps=2.58 mult=1 m=1
XMN2_op1_0900_rtl_hold ref_op1_0900_rtl_hold rbl_op1_0900_rtl_hold vn_op1_0900_rtl_hold 0 sky130_fd_pr__nfet_01v8 L=0.15 W=1 nf=1 ad=0.29 as=0.29 pd=2.58 ps=2.58 mult=1 m=1
XMP1_op1_0900_rtl_hold rbl_op1_0900_rtl_hold ref_op1_0900_rtl_hold vp_op1_0900_rtl_hold vdd sky130_fd_pr__pfet_01v8 L=0.15 W=2 nf=1 ad=0.58 as=0.58 pd=4.58 ps=4.58 mult=1 m=1
XMP2_op1_0900_rtl_hold ref_op1_0900_rtl_hold rbl_op1_0900_rtl_hold vp_op1_0900_rtl_hold vdd sky130_fd_pr__pfet_01v8 L=0.15 W=2 nf=1 ad=0.58 as=0.58 pd=4.58 ps=4.58 mult=1 m=1
XMNF_op1_0900_rtl_hold vn_op1_0900_rtl_hold en_op1_0900_rtl_hold 0 0 sky130_fd_pr__nfet_01v8 L=0.15 W=2 nf=1 ad=0.58 as=0.58 pd=4.58 ps=4.58 mult=1 m=1
XMPH_op1_0900_rtl_hold vp_op1_0900_rtl_hold enb_op1_0900_rtl_hold vdd vdd sky130_fd_pr__pfet_01v8 L=0.15 W=4 nf=1 ad=1.16 as=1.16 pd=8.58 ps=8.58 mult=1 m=1
bd_op1_0900_rtl_hold d_op1_0900_rtl_hold 0 v=v(rbl_op1_0900_rtl_hold)-v(ref_op1_0900_rtl_hold)
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
