2AMLogic/sky130-gcedram/layout/gain_cell_2t_array.extract.parasitics.spice

* extracted by klt extract --deck sky130
* parasitic model (--parasitics):
* - capacitance: net-to-ground for every net's own (non-coupled) area/perimeter, plus net-to-net for the vertical-overlap coupling `coupling` describes below -- a coupled net pair gets a direct capacitor between their two hub nodes, not just capacitors to the deck's ground/substrate net
* - coupling: vertical overlap (crossover) unconditionally -- where one net's conductor on an adjacent metal level sits directly over another *distinct* net's conductor, that overlap area is charged between the two nets instead of to ground (issue #760) -- plus lateral (same-layer, sidewall) coupling, but only for a net pair naming one of the caller's declared `--critical-net` nets (issue #976): facing-edge length within that layer's own minimum-spacing lookback is charged between the two nets, *additively* (not deducted from either net's substrate fringe term, unlike the vertical case -- a known simplification). Any same-layer pair with neither side named `--critical-net`, and fringe shielding in general, are still not modelled
* - resistance: single lumped series resistance per net, distributed as a star across that net's device terminals (issue #592) -- not a per-segment, distributed RC ladder, *unless* `--distributed-rc` names this net via `--critical-net` (issue #977, Epic #709 Phase 2b): then the net's terminals are ordered along their approximate physical spread and its total R/C is broken into a chain of per-segment resistors (segment length proportional to inter-terminal distance) with a ground capacitor at each terminal node (proportional to its adjacent segment length/2), instead of one star hub -- still an approximation (terminal position is a device-placement proxy, not true per-segment routing geometry), but a strictly finer-grained one than the single-hub star
* - frequency: quasi-static -- one frequency-independent R and C per net; no skin effect, no distributed transmission-line behavior
.GLOBAL vsubs

* cell gain_cell_2t_array_4x4_layout_0
* pin GND
* pin bl_0
* pin bl_1
* pin bl_2
* pin bl_3
* pin rbl_0
* pin rbl_1
* pin rbl_2
* pin rbl_3
* pin rwl_0
* pin rwl_1
* pin rwl_2
* pin rwl_3
* pin sn_0_0
* pin sn_0_1
* pin sn_0_2
* pin sn_0_3
* pin sn_1_0
* pin sn_1_1
* pin sn_1_2
* pin sn_1_3
* pin sn_2_0
* pin sn_2_1
* pin sn_2_2
* pin sn_2_3
* pin sn_3_0
* pin sn_3_1
* pin sn_3_2
* pin sn_3_3
* pin wl_0
* pin wl_1
* pin wl_2
* pin wl_3
.SUBCKT gain_cell_2t_array_4x4_layout_0 GND bl_0 bl_1 bl_2 bl_3 rbl_0 rbl_1
+ rbl_2 rbl_3 rwl_0 rwl_1 rwl_2 rwl_3 sn_0_0 sn_0_1 sn_0_2 sn_0_3 sn_1_0 sn_1_1
+ sn_1_2 sn_1_3 sn_2_0 sn_2_1 sn_2_2 sn_2_3 sn_3_0 sn_3_1 sn_3_2 sn_3_3 wl_0
+ wl_1 wl_2 wl_3
* device instance $1 r0 *1 0.545,0.21 nfet
M$1 sn_0_0__t0 wl_0__t3 bl_0__t0 GND__t0 nfet L=0.15U W=0.42U AS=0.1974P
+ AD=0.1974P PS=1.78U PD=1.78U
* device instance $2 r0 *1 2.035,0.21 nfet
M$2 rbl_0__t0 sn_0_0__t1 rwl_0__t0 GND__t1 nfet L=0.15U W=0.42U AS=0.1974P
+ AD=0.1974P PS=1.78U PD=1.78U
* device instance $3 r0 *1 3.525,0.21 nfet
M$3 sn_0_1__t1 wl_0__t0 bl_1__t0 GND__t2 nfet L=0.15U W=0.42U AS=0.1974P
+ AD=0.1974P PS=1.78U PD=1.78U
* device instance $4 r0 *1 5.015,0.21 nfet
M$4 rbl_1__t0 sn_0_1__t0 rwl_0__t1 GND__t3 nfet L=0.15U W=0.42U AS=0.1974P
+ AD=0.1974P PS=1.78U PD=1.78U
* device instance $5 r0 *1 6.505,0.21 nfet
M$5 sn_0_2__t1 wl_0__t1 bl_2__t0 GND__t4 nfet L=0.15U W=0.42U AS=0.1974P
+ AD=0.1974P PS=1.78U PD=1.78U
* device instance $6 r0 *1 7.995,0.21 nfet
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
* device instance cc_sn_3_2_wl_3 r0 *1 0,0 
Ccc_sn_3_2_wl_3 sn_3_2 wl_3 1.6705e-17
* device instance cc_sn_3_3_wl_3 r0 *1 0,0 
Ccc_sn_3_3_wl_3 sn_3_3 wl_3 1.071e-17
* device instance vsubs_dctie r0 *1 0,0 
Rvsubs_dctie vsubs 0 1e+12
.ENDS gain_cell_2t_array_4x4_layout_0
