2AMLogic/sky130-gcedram/sim/sense-mismatch/sense_mismatch_cell.spice

* sense_mismatch_cell.spice -- end-to-end (4-row column + latch) Monte Carlo at fs/27 C
* GENERATED by sim/sense-mismatch/gen_sense_mismatch.py (issue #81); do not edit by hand.
*
* PROPOSED/UNRATIFIED SCOPE: corners/temperatures from spec/operating-range-decision-PROPOSED.md.
* CIRCUIT BODY for `klt sim`: no .control/.end; klt appends the .lib (a *_mm mismatch section,
* MC_MM_SWITCH=1), .temp and the per-sample `.options seed` cards.
* Latch/footer/header devices, sizes, timing and bias are those of sim/sense-stage/gen_sense_stage.py.
* Every sky130 FET instance gets its own AGAUSS Vth-mismatch draw (the PDK switch is global per
* section: footer/header/cell devices also carry mismatch, see README).
* Instance kinds: c1_* stored '1', c0_* stored '0'; r<mV> = reference offset; last field = replica
*
* ASSUMPTIONS (labelled; none is a spec value): C_RBL, VRBL, reference level, sense instant,
* latch/footer/header sizes, ideal precharge switch, ideal drivers, ideal matched dummy load.

.param VDD     = 1.8
.param VRBL    = 0.9   $ ASSUMPTION (contract)
.param TEDGE   = 1e-10
.param T_READ  = 1e-08   $ select edge
.param T_PGAP  = 2e-09   $ precharge released this long before T_READ
.param T_EN    = 2e-08   $ ASSUMPTION: latch enable = contract sense instant (T_READ+10n)
.param C_RBL   = 1e-14   $ ASSUMPTION (contract; not extracted)

* ---- shared drivers (ideal) ----
vdd   vdd 0 dc {VDD}
vctl  ctl 0 pwl(0 {VDD} {T_READ-T_PGAP} {VDD} {T_READ-T_PGAP+TEDGE} 0)
ven   en  0 pwl(0 0 {T_EN} 0 {T_EN+TEDGE} {VDD})
venb  enb 0 pwl(0 {VDD} {T_EN} {VDD} {T_EN+TEDGE} 0)
.model swpre sw(vt=0.9 vh=0.1 ron=100 roff=1e12)
.param C_SN    = 6.72741e-16   $ extracted-from-netlist (layout/gain_cell_2t.extract.parasitics.json)
vrwls rwl_sel 0 pwl(0 {VDD} {T_READ} {VDD} {T_READ+TEDGE} 0)
vrwld rwl_des 0 dc {VDD}
vpre  prea 0 dc {VRBL}
vref_050 pref_050 0 dc 0.85   $ reference = VRBL - 0.05 (ASSUMPTION)
vref_100 pref_100 0 dc 0.8   $ reference = VRBL - 0.1 (ASSUMPTION)

* ---- c0_r050_0000_0: cell0 SN = 0.0 V, ref offset 0.05 V, replica 0 ----
spa_c0_r050_0000_0 prea rbl_c0_r050_0000_0 ctl 0 swpre
XMWR_c0_r050_0000_0_0 sn_c0_r050_0000_0_0 0 0 0 sky130_fd_pr__nfet_01v8 L=0.15 W=0.42 nf=1 ad=0.1218 as=0.1218 pd=1.42 ps=1.42 nrd=0.69047619047619  nrs=0.69047619047619 sa=0 sb=0 sd=0 mult=1 m=1
XMRD_c0_r050_0000_0_0 rbl_c0_r050_0000_0 sn_c0_r050_0000_0_0 rwl_sel 0 sky130_fd_pr__nfet_01v8 L=0.15 W=0.42 nf=1 ad=0.1218 as=0.1218 pd=1.42 ps=1.42 nrd=0.69047619047619  nrs=0.69047619047619 sa=0 sb=0 sd=0 mult=1 m=1
csn_c0_r050_0000_0_0 sn_c0_r050_0000_0_0 0 {C_SN}
XMWR_c0_r050_0000_0_1 sn_c0_r050_0000_0_1 0 0 0 sky130_fd_pr__nfet_01v8 L=0.15 W=0.42 nf=1 ad=0.1218 as=0.1218 pd=1.42 ps=1.42 nrd=0.69047619047619  nrs=0.69047619047619 sa=0 sb=0 sd=0 mult=1 m=1
XMRD_c0_r050_0000_0_1 rbl_c0_r050_0000_0 sn_c0_r050_0000_0_1 rwl_des 0 sky130_fd_pr__nfet_01v8 L=0.15 W=0.42 nf=1 ad=0.1218 as=0.1218 pd=1.42 ps=1.42 nrd=0.69047619047619  nrs=0.69047619047619 sa=0 sb=0 sd=0 mult=1 m=1
csn_c0_r050_0000_0_1 sn_c0_r050_0000_0_1 0 {C_SN}
XMWR_c0_r050_0000_0_2 sn_c0_r050_0000_0_2 0 0 0 sky130_fd_pr__nfet_01v8 L=0.15 W=0.42 nf=1 ad=0.1218 as=0.1218 pd=1.42 ps=1.42 nrd=0.69047619047619  nrs=0.69047619047619 sa=0 sb=0 sd=0 mult=1 m=1
XMRD_c0_r050_0000_0_2 rbl_c0_r050_0000_0 sn_c0_r050_0000_0_2 rwl_des 0 sky130_fd_pr__nfet_01v8 L=0.15 W=0.42 nf=1 ad=0.1218 as=0.1218 pd=1.42 ps=1.42 nrd=0.69047619047619  nrs=0.69047619047619 sa=0 sb=0 sd=0 mult=1 m=1
csn_c0_r050_0000_0_2 sn_c0_r050_0000_0_2 0 {C_SN}
XMWR_c0_r050_0000_0_3 sn_c0_r050_0000_0_3 0 0 0 sky130_fd_pr__nfet_01v8 L=0.15 W=0.42 nf=1 ad=0.1218 as=0.1218 pd=1.42 ps=1.42 nrd=0.69047619047619  nrs=0.69047619047619 sa=0 sb=0 sd=0 mult=1 m=1
XMRD_c0_r050_0000_0_3 rbl_c0_r050_0000_0 sn_c0_r050_0000_0_3 rwl_des 0 sky130_fd_pr__nfet_01v8 L=0.15 W=0.42 nf=1 ad=0.1218 as=0.1218 pd=1.42 ps=1.42 nrd=0.69047619047619  nrs=0.69047619047619 sa=0 sb=0 sd=0 mult=1 m=1
csn_c0_r050_0000_0_3 sn_c0_r050_0000_0_3 0 {C_SN}
crbl_c0_r050_0000_0 rbl_c0_r050_0000_0 0 {C_RBL}
spr_c0_r050_0000_0 pref_050 ref_c0_r050_0000_0 ctl 0 swpre
cref_c0_r050_0000_0 ref_c0_r050_0000_0 0 {C_RBL}   $ ASSUMPTION: ideal matched dummy load
XMN1_c0_r050_0000_0 rbl_c0_r050_0000_0 ref_c0_r050_0000_0 vn_c0_r050_0000_0 0 sky130_fd_pr__nfet_01v8 L=0.15 W=1 nf=1 ad=0.29 as=0.29 pd=2.58 ps=2.58 mult=1 m=1
XMN2_c0_r050_0000_0 ref_c0_r050_0000_0 rbl_c0_r050_0000_0 vn_c0_r050_0000_0 0 sky130_fd_pr__nfet_01v8 L=0.15 W=1 nf=1 ad=0.29 as=0.29 pd=2.58 ps=2.58 mult=1 m=1
XMP1_c0_r050_0000_0 rbl_c0_r050_0000_0 ref_c0_r050_0000_0 vp_c0_r050_0000_0 vdd sky130_fd_pr__pfet_01v8 L=0.15 W=2 nf=1 ad=0.58 as=0.58 pd=4.58 ps=4.58 mult=1 m=1
XMP2_c0_r050_0000_0 ref_c0_r050_0000_0 rbl_c0_r050_0000_0 vp_c0_r050_0000_0 vdd sky130_fd_pr__pfet_01v8 L=0.15 W=2 nf=1 ad=0.58 as=0.58 pd=4.58 ps=4.58 mult=1 m=1
XMNF_c0_r050_0000_0 vn_c0_r050_0000_0 en 0 0 sky130_fd_pr__nfet_01v8 L=0.15 W=2 nf=1 ad=0.58 as=0.58 pd=4.58 ps=4.58 mult=1 m=1
XMPH_c0_r050_0000_0 vp_c0_r050_0000_0 enb vdd vdd sky130_fd_pr__pfet_01v8 L=0.15 W=4 nf=1 ad=1.16 as=1.16 pd=8.58 ps=8.58 mult=1 m=1
bd_c0_r050_0000_0 d_c0_r050_0000_0 0 v=v(rbl_c0_r050_0000_0)-v(ref_c0_r050_0000_0)
bdabs_c0_r050_0000_0 dabs_c0_r050_0000_0 0 v=abs(v(rbl_c0_r050_0000_0)-v(ref_c0_r050_0000_0))

* ---- c0_r050_0000_1: cell0 SN = 0.0 V, ref offset 0.05 V, replica 1 ----
spa_c0_r050_0000_1 prea rbl_c0_r050_0000_1 ctl 0 swpre
XMWR_c0_r050_0000_1_0 sn_c0_r050_0000_1_0 0 0 0 sky130_fd_pr__nfet_01v8 L=0.15 W=0.42 nf=1 ad=0.1218 as=0.1218 pd=1.42 ps=1.42 nrd=0.69047619047619  nrs=0.69047619047619 sa=0 sb=0 sd=0 mult=1 m=1
XMRD_c0_r050_0000_1_0 rbl_c0_r050_0000_1 sn_c0_r050_0000_1_0 rwl_sel 0 sky130_fd_pr__nfet_01v8 L=0.15 W=0.42 nf=1 ad=0.1218 as=0.1218 pd=1.42 ps=1.42 nrd=0.69047619047619  nrs=0.69047619047619 sa=0 sb=0 sd=0 mult=1 m=1
csn_c0_r050_0000_1_0 sn_c0_r050_0000_1_0 0 {C_SN}
XMWR_c0_r050_0000_1_1 sn_c0_r050_0000_1_1 0 0 0 sky130_fd_pr__nfet_01v8 L=0.15 W=0.42 nf=1 ad=0.1218 as=0.1218 pd=1.42 ps=1.42 nrd=0.69047619047619  nrs=0.69047619047619 sa=0 sb=0 sd=0 mult=1 m=1
XMRD_c0_r050_0000_1_1 rbl_c0_r050_0000_1 sn_c0_r050_0000_1_1 rwl_des 0 sky130_fd_pr__nfet_01v8 L=0.15 W=0.42 nf=1 ad=0.1218 as=0.1218 pd=1.42 ps=1.42 nrd=0.69047619047619  nrs=0.69047619047619 sa=0 sb=0 sd=0 mult=1 m=1
csn_c0_r050_0000_1_1 sn_c0_r050_0000_1_1 0 {C_SN}
XMWR_c0_r050_0000_1_2 sn_c0_r050_0000_1_2 0 0 0 sky130_fd_pr__nfet_01v8 L=0.15 W=0.42 nf=1 ad=0.1218 as=0.1218 pd=1.42 ps=1.42 nrd=0.69047619047619  nrs=0.69047619047619 sa=0 sb=0 sd=0 mult=1 m=1
XMRD_c0_r050_0000_1_2 rbl_c0_r050_0000_1 sn_c0_r050_0000_1_2 rwl_des 0 sky130_fd_pr__nfet_01v8 L=0.15 W=0.42 nf=1 ad=0.1218 as=0.1218 pd=1.42 ps=1.42 nrd=0.69047619047619  nrs=0.69047619047619 sa=0 sb=0 sd=0 mult=1 m=1
csn_c0_r050_0000_1_2 sn_c0_r050_0000_1_2 0 {C_SN}
XMWR_c0_r050_0000_1_3 sn_c0_r050_0000_1_3 0 0 0 sky130_fd_pr__nfet_01v8 L=0.15 W=0.42 nf=1 ad=0.1218 as=0.1218 pd=1.42 ps=1.42 nrd=0.69047619047619  nrs=0.69047619047619 sa=0 sb=0 sd=0 mult=1 m=1
XMRD_c0_r050_0000_1_3 rbl_c0_r050_0000_1 sn_c0_r050_0000_1_3 rwl_des 0 sky130_fd_pr__nfet_01v8 L=0.15 W=0.42 nf=1 ad=0.1218 as=0.1218 pd=1.42 ps=1.42 nrd=0.69047619047619  nrs=0.69047619047619 sa=0 sb=0 sd=0 mult=1 m=1
csn_c0_r050_0000_1_3 sn_c0_r050_0000_1_3 0 {C_SN}
crbl_c0_r050_0000_1 rbl_c0_r050_0000_1 0 {C_RBL}
spr_c0_r050_0000_1 pref_050 ref_c0_r050_0000_1 ctl 0 swpre
cref_c0_r050_0000_1 ref_c0_r050_0000_1 0 {C_RBL}   $ ASSUMPTION: ideal matched dummy load
XMN1_c0_r050_0000_1 rbl_c0_r050_0000_1 ref_c0_r050_0000_1 vn_c0_r050_0000_1 0 sky130_fd_pr__nfet_01v8 L=0.15 W=1 nf=1 ad=0.29 as=0.29 pd=2.58 ps=2.58 mult=1 m=1
XMN2_c0_r050_0000_1 ref_c0_r050_0000_1 rbl_c0_r050_0000_1 vn_c0_r050_0000_1 0 sky130_fd_pr__nfet_01v8 L=0.15 W=1 nf=1 ad=0.29 as=0.29 pd=2.58 ps=2.58 mult=1 m=1
XMP1_c0_r050_0000_1 rbl_c0_r050_0000_1 ref_c0_r050_0000_1 vp_c0_r050_0000_1 vdd sky130_fd_pr__pfet_01v8 L=0.15 W=2 nf=1 ad=0.58 as=0.58 pd=4.58 ps=4.58 mult=1 m=1
XMP2_c0_r050_0000_1 ref_c0_r050_0000_1 rbl_c0_r050_0000_1 vp_c0_r050_0000_1 vdd sky130_fd_pr__pfet_01v8 L=0.15 W=2 nf=1 ad=0.58 as=0.58 pd=4.58 ps=4.58 mult=1 m=1
XMNF_c0_r050_0000_1 vn_c0_r050_0000_1 en 0 0 sky130_fd_pr__nfet_01v8 L=0.15 W=2 nf=1 ad=0.58 as=0.58 pd=4.58 ps=4.58 mult=1 m=1
XMPH_c0_r050_0000_1 vp_c0_r050_0000_1 enb vdd vdd sky130_fd_pr__pfet_01v8 L=0.15 W=4 nf=1 ad=1.16 as=1.16 pd=8.58 ps=8.58 mult=1 m=1
bd_c0_r050_0000_1 d_c0_r050_0000_1 0 v=v(rbl_c0_r050_0000_1)-v(ref_c0_r050_0000_1)
bdabs_c0_r050_0000_1 dabs_c0_r050_0000_1 0 v=abs(v(rbl_c0_r050_0000_1)-v(ref_c0_r050_0000_1))

* ---- c0_r050_0000_2: cell0 SN = 0.0 V, ref offset 0.05 V, replica 2 ----
spa_c0_r050_0000_2 prea rbl_c0_r050_0000_2 ctl 0 swpre
XMWR_c0_r050_0000_2_0 sn_c0_r050_0000_2_0 0 0 0 sky130_fd_pr__nfet_01v8 L=0.15 W=0.42 nf=1 ad=0.1218 as=0.1218 pd=1.42 ps=1.42 nrd=0.69047619047619  nrs=0.69047619047619 sa=0 sb=0 sd=0 mult=1 m=1
XMRD_c0_r050_0000_2_0 rbl_c0_r050_0000_2 sn_c0_r050_0000_2_0 rwl_sel 0 sky130_fd_pr__nfet_01v8 L=0.15 W=0.42 nf=1 ad=0.1218 as=0.1218 pd=1.42 ps=1.42 nrd=0.69047619047619  nrs=0.69047619047619 sa=0 sb=0 sd=0 mult=1 m=1
csn_c0_r050_0000_2_0 sn_c0_r050_0000_2_0 0 {C_SN}
XMWR_c0_r050_0000_2_1 sn_c0_r050_0000_2_1 0 0 0 sky130_fd_pr__nfet_01v8 L=0.15 W=0.42 nf=1 ad=0.1218 as=0.1218 pd=1.42 ps=1.42 nrd=0.69047619047619  nrs=0.69047619047619 sa=0 sb=0 sd=0 mult=1 m=1
XMRD_c0_r050_0000_2_1 rbl_c0_r050_0000_2 sn_c0_r050_0000_2_1 rwl_des 0 sky130_fd_pr__nfet_01v8 L=0.15 W=0.42 nf=1 ad=0.1218 as=0.1218 pd=1.42 ps=1.42 nrd=0.69047619047619  nrs=0.69047619047619 sa=0 sb=0 sd=0 mult=1 m=1
csn_c0_r050_0000_2_1 sn_c0_r050_0000_2_1 0 {C_SN}
XMWR_c0_r050_0000_2_2 sn_c0_r050_0000_2_2 0 0 0 sky130_fd_pr__nfet_01v8 L=0.15 W=0.42 nf=1 ad=0.1218 as=0.1218 pd=1.42 ps=1.42 nrd=0.69047619047619  nrs=0.69047619047619 sa=0 sb=0 sd=0 mult=1 m=1
XMRD_c0_r050_0000_2_2 rbl_c0_r050_0000_2 sn_c0_r050_0000_2_2 rwl_des 0 sky130_fd_pr__nfet_01v8 L=0.15 W=0.42 nf=1 ad=0.1218 as=0.1218 pd=1.42 ps=1.42 nrd=0.69047619047619  nrs=0.69047619047619 sa=0 sb=0 sd=0 mult=1 m=1
csn_c0_r050_0000_2_2 sn_c0_r050_0000_2_2 0 {C_SN}
XMWR_c0_r050_0000_2_3 sn_c0_r050_0000_2_3 0 0 0 sky130_fd_pr__nfet_01v8 L=0.15 W=0.42 nf=1 ad=0.1218 as=0.1218 pd=1.42 ps=1.42 nrd=0.69047619047619  nrs=0.69047619047619 sa=0 sb=0 sd=0 mult=1 m=1
XMRD_c0_r050_0000_2_3 rbl_c0_r050_0000_2 sn_c0_r050_0000_2_3 rwl_des 0 sky130_fd_pr__nfet_01v8 L=0.15 W=0.42 nf=1 ad=0.1218 as=0.1218 pd=1.42 ps=1.42 nrd=0.69047619047619  nrs=0.69047619047619 sa=0 sb=0 sd=0 mult=1 m=1
csn_c0_r050_0000_2_3 sn_c0_r050_0000_2_3 0 {C_SN}
crbl_c0_r050_0000_2 rbl_c0_r050_0000_2 0 {C_RBL}
spr_c0_r050_0000_2 pref_050 ref_c0_r050_0000_2 ctl 0 swpre
cref_c0_r050_0000_2 ref_c0_r050_0000_2 0 {C_RBL}   $ ASSUMPTION: ideal matched dummy load
XMN1_c0_r050_0000_2 rbl_c0_r050_0000_2 ref_c0_r050_0000_2 vn_c0_r050_0000_2 0 sky130_fd_pr__nfet_01v8 L=0.15 W=1 nf=1 ad=0.29 as=0.29 pd=2.58 ps=2.58 mult=1 m=1
XMN2_c0_r050_0000_2 ref_c0_r050_0000_2 rbl_c0_r050_0000_2 vn_c0_r050_0000_2 0 sky130_fd_pr__nfet_01v8 L=0.15 W=1 nf=1 ad=0.29 as=0.29 pd=2.58 ps=2.58 mult=1 m=1
XMP1_c0_r050_0000_2 rbl_c0_r050_0000_2 ref_c0_r050_0000_2 vp_c0_r050_0000_2 vdd sky130_fd_pr__pfet_01v8 L=0.15 W=2 nf=1 ad=0.58 as=0.58 pd=4.58 ps=4.58 mult=1 m=1
XMP2_c0_r050_0000_2 ref_c0_r050_0000_2 rbl_c0_r050_0000_2 vp_c0_r050_0000_2 vdd sky130_fd_pr__pfet_01v8 L=0.15 W=2 nf=1 ad=0.58 as=0.58 pd=4.58 ps=4.58 mult=1 m=1
XMNF_c0_r050_0000_2 vn_c0_r050_0000_2 en 0 0 sky130_fd_pr__nfet_01v8 L=0.15 W=2 nf=1 ad=0.58 as=0.58 pd=4.58 ps=4.58 mult=1 m=1
XMPH_c0_r050_0000_2 vp_c0_r050_0000_2 enb vdd vdd sky130_fd_pr__pfet_01v8 L=0.15 W=4 nf=1 ad=1.16 as=1.16 pd=8.58 ps=8.58 mult=1 m=1
bd_c0_r050_0000_2 d_c0_r050_0000_2 0 v=v(rbl_c0_r050_0000_2)-v(ref_c0_r050_0000_2)
bdabs_c0_r050_0000_2 dabs_c0_r050_0000_2 0 v=abs(v(rbl_c0_r050_0000_2)-v(ref_c0_r050_0000_2))

* ---- c0_r050_0000_3: cell0 SN = 0.0 V, ref offset 0.05 V, replica 3 ----
spa_c0_r050_0000_3 prea rbl_c0_r050_0000_3 ctl 0 swpre
XMWR_c0_r050_0000_3_0 sn_c0_r050_0000_3_0 0 0 0 sky130_fd_pr__nfet_01v8 L=0.15 W=0.42 nf=1 ad=0.1218 as=0.1218 pd=1.42 ps=1.42 nrd=0.69047619047619  nrs=0.69047619047619 sa=0 sb=0 sd=0 mult=1 m=1
XMRD_c0_r050_0000_3_0 rbl_c0_r050_0000_3 sn_c0_r050_0000_3_0 rwl_sel 0 sky130_fd_pr__nfet_01v8 L=0.15 W=0.42 nf=1 ad=0.1218 as=0.1218 pd=1.42 ps=1.42 nrd=0.69047619047619  nrs=0.69047619047619 sa=0 sb=0 sd=0 mult=1 m=1
csn_c0_r050_0000_3_0 sn_c0_r050_0000_3_0 0 {C_SN}
XMWR_c0_r050_0000_3_1 sn_c0_r050_0000_3_1 0 0 0 sky130_fd_pr__nfet_01v8 L=0.15 W=0.42 nf=1 ad=0.1218 as=0.1218 pd=1.42 ps=1.42 nrd=0.69047619047619  nrs=0.69047619047619 sa=0 sb=0 sd=0 mult=1 m=1
XMRD_c0_r050_0000_3_1 rbl_c0_r050_0000_3 sn_c0_r050_0000_3_1 rwl_des 0 sky130_fd_pr__nfet_01v8 L=0.15 W=0.42 nf=1 ad=0.1218 as=0.1218 pd=1.42 ps=1.42 nrd=0.69047619047619  nrs=0.69047619047619 sa=0 sb=0 sd=0 mult=1 m=1
csn_c0_r050_0000_3_1 sn_c0_r050_0000_3_1 0 {C_SN}
XMWR_c0_r050_0000_3_2 sn_c0_r050_0000_3_2 0 0 0 sky130_fd_pr__nfet_01v8 L=0.15 W=0.42 nf=1 ad=0.1218 as=0.1218 pd=1.42 ps=1.42 nrd=0.69047619047619  nrs=0.69047619047619 sa=0 sb=0 sd=0 mult=1 m=1
XMRD_c0_r050_0000_3_2 rbl_c0_r050_0000_3 sn_c0_r050_0000_3_2 rwl_des 0 sky130_fd_pr__nfet_01v8 L=0.15 W=0.42 nf=1 ad=0.1218 as=0.1218 pd=1.42 ps=1.42 nrd=0.69047619047619  nrs=0.69047619047619 sa=0 sb=0 sd=0 mult=1 m=1
csn_c0_r050_0000_3_2 sn_c0_r050_0000_3_2 0 {C_SN}
XMWR_c0_r050_0000_3_3 sn_c0_r050_0000_3_3 0 0 0 sky130_fd_pr__nfet_01v8 L=0.15 W=0.42 nf=1 ad=0.1218 as=0.1218 pd=1.42 ps=1.42 nrd=0.69047619047619  nrs=0.69047619047619 sa=0 sb=0 sd=0 mult=1 m=1
XMRD_c0_r050_0000_3_3 rbl_c0_r050_0000_3 sn_c0_r050_0000_3_3 rwl_des 0 sky130_fd_pr__nfet_01v8 L=0.15 W=0.42 nf=1 ad=0.1218 as=0.1218 pd=1.42 ps=1.42 nrd=0.69047619047619  nrs=0.69047619047619 sa=0 sb=0 sd=0 mult=1 m=1
csn_c0_r050_0000_3_3 sn_c0_r050_0000_3_3 0 {C_SN}
crbl_c0_r050_0000_3 rbl_c0_r050_0000_3 0 {C_RBL}
spr_c0_r050_0000_3 pref_050 ref_c0_r050_0000_3 ctl 0 swpre
cref_c0_r050_0000_3 ref_c0_r050_0000_3 0 {C_RBL}   $ ASSUMPTION: ideal matched dummy load
XMN1_c0_r050_0000_3 rbl_c0_r050_0000_3 ref_c0_r050_0000_3 vn_c0_r050_0000_3 0 sky130_fd_pr__nfet_01v8 L=0.15 W=1 nf=1 ad=0.29 as=0.29 pd=2.58 ps=2.58 mult=1 m=1
XMN2_c0_r050_0000_3 ref_c0_r050_0000_3 rbl_c0_r050_0000_3 vn_c0_r050_0000_3 0 sky130_fd_pr__nfet_01v8 L=0.15 W=1 nf=1 ad=0.29 as=0.29 pd=2.58 ps=2.58 mult=1 m=1
XMP1_c0_r050_0000_3 rbl_c0_r050_0000_3 ref_c0_r050_0000_3 vp_c0_r050_0000_3 vdd sky130_fd_pr__pfet_01v8 L=0.15 W=2 nf=1 ad=0.58 as=0.58 pd=4.58 ps=4.58 mult=1 m=1
XMP2_c0_r050_0000_3 ref_c0_r050_0000_3 rbl_c0_r050_0000_3 vp_c0_r050_0000_3 vdd sky130_fd_pr__pfet_01v8 L=0.15 W=2 nf=1 ad=0.58 as=0.58 pd=4.58 ps=4.58 mult=1 m=1
XMNF_c0_r050_0000_3 vn_c0_r050_0000_3 en 0 0 sky130_fd_pr__nfet_01v8 L=0.15 W=2 nf=1 ad=0.58 as=0.58 pd=4.58 ps=4.58 mult=1 m=1
XMPH_c0_r050_0000_3 vp_c0_r050_0000_3 enb vdd vdd sky130_fd_pr__pfet_01v8 L=0.15 W=4 nf=1 ad=1.16 as=1.16 pd=8.58 ps=8.58 mult=1 m=1
bd_c0_r050_0000_3 d_c0_r050_0000_3 0 v=v(rbl_c0_r050_0000_3)-v(ref_c0_r050_0000_3)
bdabs_c0_r050_0000_3 dabs_c0_r050_0000_3 0 v=abs(v(rbl_c0_r050_0000_3)-v(ref_c0_r050_0000_3))

* ---- c1_r050_0600_0: cell1 SN = 0.6 V, ref offset 0.05 V, replica 0 ----
spa_c1_r050_0600_0 prea rbl_c1_r050_0600_0 ctl 0 swpre
XMWR_c1_r050_0600_0_0 sn_c1_r050_0600_0_0 0 0 0 sky130_fd_pr__nfet_01v8 L=0.15 W=0.42 nf=1 ad=0.1218 as=0.1218 pd=1.42 ps=1.42 nrd=0.69047619047619  nrs=0.69047619047619 sa=0 sb=0 sd=0 mult=1 m=1
XMRD_c1_r050_0600_0_0 rbl_c1_r050_0600_0 sn_c1_r050_0600_0_0 rwl_sel 0 sky130_fd_pr__nfet_01v8 L=0.15 W=0.42 nf=1 ad=0.1218 as=0.1218 pd=1.42 ps=1.42 nrd=0.69047619047619  nrs=0.69047619047619 sa=0 sb=0 sd=0 mult=1 m=1
csn_c1_r050_0600_0_0 sn_c1_r050_0600_0_0 0 {C_SN}
XMWR_c1_r050_0600_0_1 sn_c1_r050_0600_0_1 0 0 0 sky130_fd_pr__nfet_01v8 L=0.15 W=0.42 nf=1 ad=0.1218 as=0.1218 pd=1.42 ps=1.42 nrd=0.69047619047619  nrs=0.69047619047619 sa=0 sb=0 sd=0 mult=1 m=1
XMRD_c1_r050_0600_0_1 rbl_c1_r050_0600_0 sn_c1_r050_0600_0_1 rwl_des 0 sky130_fd_pr__nfet_01v8 L=0.15 W=0.42 nf=1 ad=0.1218 as=0.1218 pd=1.42 ps=1.42 nrd=0.69047619047619  nrs=0.69047619047619 sa=0 sb=0 sd=0 mult=1 m=1
csn_c1_r050_0600_0_1 sn_c1_r050_0600_0_1 0 {C_SN}
XMWR_c1_r050_0600_0_2 sn_c1_r050_0600_0_2 0 0 0 sky130_fd_pr__nfet_01v8 L=0.15 W=0.42 nf=1 ad=0.1218 as=0.1218 pd=1.42 ps=1.42 nrd=0.69047619047619  nrs=0.69047619047619 sa=0 sb=0 sd=0 mult=1 m=1
XMRD_c1_r050_0600_0_2 rbl_c1_r050_0600_0 sn_c1_r050_0600_0_2 rwl_des 0 sky130_fd_pr__nfet_01v8 L=0.15 W=0.42 nf=1 ad=0.1218 as=0.1218 pd=1.42 ps=1.42 nrd=0.69047619047619  nrs=0.69047619047619 sa=0 sb=0 sd=0 mult=1 m=1
csn_c1_r050_0600_0_2 sn_c1_r050_0600_0_2 0 {C_SN}
XMWR_c1_r050_0600_0_3 sn_c1_r050_0600_0_3 0 0 0 sky130_fd_pr__nfet_01v8 L=0.15 W=0.42 nf=1 ad=0.1218 as=0.1218 pd=1.42 ps=1.42 nrd=0.69047619047619  nrs=0.69047619047619 sa=0 sb=0 sd=0 mult=1 m=1
XMRD_c1_r050_0600_0_3 rbl_c1_r050_0600_0 sn_c1_r050_0600_0_3 rwl_des 0 sky130_fd_pr__nfet_01v8 L=0.15 W=0.42 nf=1 ad=0.1218 as=0.1218 pd=1.42 ps=1.42 nrd=0.69047619047619  nrs=0.69047619047619 sa=0 sb=0 sd=0 mult=1 m=1
csn_c1_r050_0600_0_3 sn_c1_r050_0600_0_3 0 {C_SN}
crbl_c1_r050_0600_0 rbl_c1_r050_0600_0 0 {C_RBL}
spr_c1_r050_0600_0 pref_050 ref_c1_r050_0600_0 ctl 0 swpre
cref_c1_r050_0600_0 ref_c1_r050_0600_0 0 {C_RBL}   $ ASSUMPTION: ideal matched dummy load
XMN1_c1_r050_0600_0 rbl_c1_r050_0600_0 ref_c1_r050_0600_0 vn_c1_r050_0600_0 0 sky130_fd_pr__nfet_01v8 L=0.15 W=1 nf=1 ad=0.29 as=0.29 pd=2.58 ps=2.58 mult=1 m=1
XMN2_c1_r050_0600_0 ref_c1_r050_0600_0 rbl_c1_r050_0600_0 vn_c1_r050_0600_0 0 sky130_fd_pr__nfet_01v8 L=0.15 W=1 nf=1 ad=0.29 as=0.29 pd=2.58 ps=2.58 mult=1 m=1
XMP1_c1_r050_0600_0 rbl_c1_r050_0600_0 ref_c1_r050_0600_0 vp_c1_r050_0600_0 vdd sky130_fd_pr__pfet_01v8 L=0.15 W=2 nf=1 ad=0.58 as=0.58 pd=4.58 ps=4.58 mult=1 m=1
XMP2_c1_r050_0600_0 ref_c1_r050_0600_0 rbl_c1_r050_0600_0 vp_c1_r050_0600_0 vdd sky130_fd_pr__pfet_01v8 L=0.15 W=2 nf=1 ad=0.58 as=0.58 pd=4.58 ps=4.58 mult=1 m=1
XMNF_c1_r050_0600_0 vn_c1_r050_0600_0 en 0 0 sky130_fd_pr__nfet_01v8 L=0.15 W=2 nf=1 ad=0.58 as=0.58 pd=4.58 ps=4.58 mult=1 m=1
XMPH_c1_r050_0600_0 vp_c1_r050_0600_0 enb vdd vdd sky130_fd_pr__pfet_01v8 L=0.15 W=4 nf=1 ad=1.16 as=1.16 pd=8.58 ps=8.58 mult=1 m=1
bd_c1_r050_0600_0 d_c1_r050_0600_0 0 v=v(rbl_c1_r050_0600_0)-v(ref_c1_r050_0600_0)
bdabs_c1_r050_0600_0 dabs_c1_r050_0600_0 0 v=abs(v(rbl_c1_r050_0600_0)-v(ref_c1_r050_0600_0))

* ---- c1_r050_0600_1: cell1 SN = 0.6 V, ref offset 0.05 V, replica 1 ----
spa_c1_r050_0600_1 prea rbl_c1_r050_0600_1 ctl 0 swpre
XMWR_c1_r050_0600_1_0 sn_c1_r050_0600_1_0 0 0 0 sky130_fd_pr__nfet_01v8 L=0.15 W=0.42 nf=1 ad=0.1218 as=0.1218 pd=1.42 ps=1.42 nrd=0.69047619047619  nrs=0.69047619047619 sa=0 sb=0 sd=0 mult=1 m=1
XMRD_c1_r050_0600_1_0 rbl_c1_r050_0600_1 sn_c1_r050_0600_1_0 rwl_sel 0 sky130_fd_pr__nfet_01v8 L=0.15 W=0.42 nf=1 ad=0.1218 as=0.1218 pd=1.42 ps=1.42 nrd=0.69047619047619  nrs=0.69047619047619 sa=0 sb=0 sd=0 mult=1 m=1
csn_c1_r050_0600_1_0 sn_c1_r050_0600_1_0 0 {C_SN}
XMWR_c1_r050_0600_1_1 sn_c1_r050_0600_1_1 0 0 0 sky130_fd_pr__nfet_01v8 L=0.15 W=0.42 nf=1 ad=0.1218 as=0.1218 pd=1.42 ps=1.42 nrd=0.69047619047619  nrs=0.69047619047619 sa=0 sb=0 sd=0 mult=1 m=1
XMRD_c1_r050_0600_1_1 rbl_c1_r050_0600_1 sn_c1_r050_0600_1_1 rwl_des 0 sky130_fd_pr__nfet_01v8 L=0.15 W=0.42 nf=1 ad=0.1218 as=0.1218 pd=1.42 ps=1.42 nrd=0.69047619047619  nrs=0.69047619047619 sa=0 sb=0 sd=0 mult=1 m=1
csn_c1_r050_0600_1_1 sn_c1_r050_0600_1_1 0 {C_SN}
XMWR_c1_r050_0600_1_2 sn_c1_r050_0600_1_2 0 0 0 sky130_fd_pr__nfet_01v8 L=0.15 W=0.42 nf=1 ad=0.1218 as=0.1218 pd=1.42 ps=1.42 nrd=0.69047619047619  nrs=0.69047619047619 sa=0 sb=0 sd=0 mult=1 m=1
XMRD_c1_r050_0600_1_2 rbl_c1_r050_0600_1 sn_c1_r050_0600_1_2 rwl_des 0 sky130_fd_pr__nfet_01v8 L=0.15 W=0.42 nf=1 ad=0.1218 as=0.1218 pd=1.42 ps=1.42 nrd=0.69047619047619  nrs=0.69047619047619 sa=0 sb=0 sd=0 mult=1 m=1
csn_c1_r050_0600_1_2 sn_c1_r050_0600_1_2 0 {C_SN}
XMWR_c1_r050_0600_1_3 sn_c1_r050_0600_1_3 0 0 0 sky130_fd_pr__nfet_01v8 L=0.15 W=0.42 nf=1 ad=0.1218 as=0.1218 pd=1.42 ps=1.42 nrd=0.69047619047619  nrs=0.69047619047619 sa=0 sb=0 sd=0 mult=1 m=1
XMRD_c1_r050_0600_1_3 rbl_c1_r050_0600_1 sn_c1_r050_0600_1_3 rwl_des 0 sky130_fd_pr__nfet_01v8 L=0.15 W=0.42 nf=1 ad=0.1218 as=0.1218 pd=1.42 ps=1.42 nrd=0.69047619047619  nrs=0.69047619047619 sa=0 sb=0 sd=0 mult=1 m=1
csn_c1_r050_0600_1_3 sn_c1_r050_0600_1_3 0 {C_SN}
crbl_c1_r050_0600_1 rbl_c1_r050_0600_1 0 {C_RBL}
spr_c1_r050_0600_1 pref_050 ref_c1_r050_0600_1 ctl 0 swpre
cref_c1_r050_0600_1 ref_c1_r050_0600_1 0 {C_RBL}   $ ASSUMPTION: ideal matched dummy load
XMN1_c1_r050_0600_1 rbl_c1_r050_0600_1 ref_c1_r050_0600_1 vn_c1_r050_0600_1 0 sky130_fd_pr__nfet_01v8 L=0.15 W=1 nf=1 ad=0.29 as=0.29 pd=2.58 ps=2.58 mult=1 m=1
XMN2_c1_r050_0600_1 ref_c1_r050_0600_1 rbl_c1_r050_0600_1 vn_c1_r050_0600_1 0 sky130_fd_pr__nfet_01v8 L=0.15 W=1 nf=1 ad=0.29 as=0.29 pd=2.58 ps=2.58 mult=1 m=1
XMP1_c1_r050_0600_1 rbl_c1_r050_0600_1 ref_c1_r050_0600_1 vp_c1_r050_0600_1 vdd sky130_fd_pr__pfet_01v8 L=0.15 W=2 nf=1 ad=0.58 as=0.58 pd=4.58 ps=4.58 mult=1 m=1
XMP2_c1_r050_0600_1 ref_c1_r050_0600_1 rbl_c1_r050_0600_1 vp_c1_r050_0600_1 vdd sky130_fd_pr__pfet_01v8 L=0.15 W=2 nf=1 ad=0.58 as=0.58 pd=4.58 ps=4.58 mult=1 m=1
XMNF_c1_r050_0600_1 vn_c1_r050_0600_1 en 0 0 sky130_fd_pr__nfet_01v8 L=0.15 W=2 nf=1 ad=0.58 as=0.58 pd=4.58 ps=4.58 mult=1 m=1
XMPH_c1_r050_0600_1 vp_c1_r050_0600_1 enb vdd vdd sky130_fd_pr__pfet_01v8 L=0.15 W=4 nf=1 ad=1.16 as=1.16 pd=8.58 ps=8.58 mult=1 m=1
bd_c1_r050_0600_1 d_c1_r050_0600_1 0 v=v(rbl_c1_r050_0600_1)-v(ref_c1_r050_0600_1)
bdabs_c1_r050_0600_1 dabs_c1_r050_0600_1 0 v=abs(v(rbl_c1_r050_0600_1)-v(ref_c1_r050_0600_1))

* ---- c1_r050_0600_2: cell1 SN = 0.6 V, ref offset 0.05 V, replica 2 ----
spa_c1_r050_0600_2 prea rbl_c1_r050_0600_2 ctl 0 swpre
XMWR_c1_r050_0600_2_0 sn_c1_r050_0600_2_0 0 0 0 sky130_fd_pr__nfet_01v8 L=0.15 W=0.42 nf=1 ad=0.1218 as=0.1218 pd=1.42 ps=1.42 nrd=0.69047619047619  nrs=0.69047619047619 sa=0 sb=0 sd=0 mult=1 m=1
XMRD_c1_r050_0600_2_0 rbl_c1_r050_0600_2 sn_c1_r050_0600_2_0 rwl_sel 0 sky130_fd_pr__nfet_01v8 L=0.15 W=0.42 nf=1 ad=0.1218 as=0.1218 pd=1.42 ps=1.42 nrd=0.69047619047619  nrs=0.69047619047619 sa=0 sb=0 sd=0 mult=1 m=1
csn_c1_r050_0600_2_0 sn_c1_r050_0600_2_0 0 {C_SN}
XMWR_c1_r050_0600_2_1 sn_c1_r050_0600_2_1 0 0 0 sky130_fd_pr__nfet_01v8 L=0.15 W=0.42 nf=1 ad=0.1218 as=0.1218 pd=1.42 ps=1.42 nrd=0.69047619047619  nrs=0.69047619047619 sa=0 sb=0 sd=0 mult=1 m=1
XMRD_c1_r050_0600_2_1 rbl_c1_r050_0600_2 sn_c1_r050_0600_2_1 rwl_des 0 sky130_fd_pr__nfet_01v8 L=0.15 W=0.42 nf=1 ad=0.1218 as=0.1218 pd=1.42 ps=1.42 nrd=0.69047619047619  nrs=0.69047619047619 sa=0 sb=0 sd=0 mult=1 m=1
csn_c1_r050_0600_2_1 sn_c1_r050_0600_2_1 0 {C_SN}
XMWR_c1_r050_0600_2_2 sn_c1_r050_0600_2_2 0 0 0 sky130_fd_pr__nfet_01v8 L=0.15 W=0.42 nf=1 ad=0.1218 as=0.1218 pd=1.42 ps=1.42 nrd=0.69047619047619  nrs=0.69047619047619 sa=0 sb=0 sd=0 mult=1 m=1
XMRD_c1_r050_0600_2_2 rbl_c1_r050_0600_2 sn_c1_r050_0600_2_2 rwl_des 0 sky130_fd_pr__nfet_01v8 L=0.15 W=0.42 nf=1 ad=0.1218 as=0.1218 pd=1.42 ps=1.42 nrd=0.69047619047619  nrs=0.69047619047619 sa=0 sb=0 sd=0 mult=1 m=1
csn_c1_r050_0600_2_2 sn_c1_r050_0600_2_2 0 {C_SN}
XMWR_c1_r050_0600_2_3 sn_c1_r050_0600_2_3 0 0 0 sky130_fd_pr__nfet_01v8 L=0.15 W=0.42 nf=1 ad=0.1218 as=0.1218 pd=1.42 ps=1.42 nrd=0.69047619047619  nrs=0.69047619047619 sa=0 sb=0 sd=0 mult=1 m=1
XMRD_c1_r050_0600_2_3 rbl_c1_r050_0600_2 sn_c1_r050_0600_2_3 rwl_des 0 sky130_fd_pr__nfet_01v8 L=0.15 W=0.42 nf=1 ad=0.1218 as=0.1218 pd=1.42 ps=1.42 nrd=0.69047619047619  nrs=0.69047619047619 sa=0 sb=0 sd=0 mult=1 m=1
csn_c1_r050_0600_2_3 sn_c1_r050_0600_2_3 0 {C_SN}
crbl_c1_r050_0600_2 rbl_c1_r050_0600_2 0 {C_RBL}
spr_c1_r050_0600_2 pref_050 ref_c1_r050_0600_2 ctl 0 swpre
cref_c1_r050_0600_2 ref_c1_r050_0600_2 0 {C_RBL}   $ ASSUMPTION: ideal matched dummy load
XMN1_c1_r050_0600_2 rbl_c1_r050_0600_2 ref_c1_r050_0600_2 vn_c1_r050_0600_2 0 sky130_fd_pr__nfet_01v8 L=0.15 W=1 nf=1 ad=0.29 as=0.29 pd=2.58 ps=2.58 mult=1 m=1
XMN2_c1_r050_0600_2 ref_c1_r050_0600_2 rbl_c1_r050_0600_2 vn_c1_r050_0600_2 0 sky130_fd_pr__nfet_01v8 L=0.15 W=1 nf=1 ad=0.29 as=0.29 pd=2.58 ps=2.58 mult=1 m=1
XMP1_c1_r050_0600_2 rbl_c1_r050_0600_2 ref_c1_r050_0600_2 vp_c1_r050_0600_2 vdd sky130_fd_pr__pfet_01v8 L=0.15 W=2 nf=1 ad=0.58 as=0.58 pd=4.58 ps=4.58 mult=1 m=1
XMP2_c1_r050_0600_2 ref_c1_r050_0600_2 rbl_c1_r050_0600_2 vp_c1_r050_0600_2 vdd sky130_fd_pr__pfet_01v8 L=0.15 W=2 nf=1 ad=0.58 as=0.58 pd=4.58 ps=4.58 mult=1 m=1
XMNF_c1_r050_0600_2 vn_c1_r050_0600_2 en 0 0 sky130_fd_pr__nfet_01v8 L=0.15 W=2 nf=1 ad=0.58 as=0.58 pd=4.58 ps=4.58 mult=1 m=1
XMPH_c1_r050_0600_2 vp_c1_r050_0600_2 enb vdd vdd sky130_fd_pr__pfet_01v8 L=0.15 W=4 nf=1 ad=1.16 as=1.16 pd=8.58 ps=8.58 mult=1 m=1
bd_c1_r050_0600_2 d_c1_r050_0600_2 0 v=v(rbl_c1_r050_0600_2)-v(ref_c1_r050_0600_2)
bdabs_c1_r050_0600_2 dabs_c1_r050_0600_2 0 v=abs(v(rbl_c1_r050_0600_2)-v(ref_c1_r050_0600_2))

* ---- c1_r050_0600_3: cell1 SN = 0.6 V, ref offset 0.05 V, replica 3 ----
spa_c1_r050_0600_3 prea rbl_c1_r050_0600_3 ctl 0 swpre
XMWR_c1_r050_0600_3_0 sn_c1_r050_0600_3_0 0 0 0 sky130_fd_pr__nfet_01v8 L=0.15 W=0.42 nf=1 ad=0.1218 as=0.1218 pd=1.42 ps=1.42 nrd=0.69047619047619  nrs=0.69047619047619 sa=0 sb=0 sd=0 mult=1 m=1
XMRD_c1_r050_0600_3_0 rbl_c1_r050_0600_3 sn_c1_r050_0600_3_0 rwl_sel 0 sky130_fd_pr__nfet_01v8 L=0.15 W=0.42 nf=1 ad=0.1218 as=0.1218 pd=1.42 ps=1.42 nrd=0.69047619047619  nrs=0.69047619047619 sa=0 sb=0 sd=0 mult=1 m=1
csn_c1_r050_0600_3_0 sn_c1_r050_0600_3_0 0 {C_SN}
XMWR_c1_r050_0600_3_1 sn_c1_r050_0600_3_1 0 0 0 sky130_fd_pr__nfet_01v8 L=0.15 W=0.42 nf=1 ad=0.1218 as=0.1218 pd=1.42 ps=1.42 nrd=0.69047619047619  nrs=0.69047619047619 sa=0 sb=0 sd=0 mult=1 m=1
XMRD_c1_r050_0600_3_1 rbl_c1_r050_0600_3 sn_c1_r050_0600_3_1 rwl_des 0 sky130_fd_pr__nfet_01v8 L=0.15 W=0.42 nf=1 ad=0.1218 as=0.1218 pd=1.42 ps=1.42 nrd=0.69047619047619  nrs=0.69047619047619 sa=0 sb=0 sd=0 mult=1 m=1
csn_c1_r050_0600_3_1 sn_c1_r050_0600_3_1 0 {C_SN}
XMWR_c1_r050_0600_3_2 sn_c1_r050_0600_3_2 0 0 0 sky130_fd_pr__nfet_01v8 L=0.15 W=0.42 nf=1 ad=0.1218 as=0.1218 pd=1.42 ps=1.42 nrd=0.69047619047619  nrs=0.69047619047619 sa=0 sb=0 sd=0 mult=1 m=1
XMRD_c1_r050_0600_3_2 rbl_c1_r050_0600_3 sn_c1_r050_0600_3_2 rwl_des 0 sky130_fd_pr__nfet_01v8 L=0.15 W=0.42 nf=1 ad=0.1218 as=0.1218 pd=1.42 ps=1.42 nrd=0.69047619047619  nrs=0.69047619047619 sa=0 sb=0 sd=0 mult=1 m=1
csn_c1_r050_0600_3_2 sn_c1_r050_0600_3_2 0 {C_SN}
XMWR_c1_r050_0600_3_3 sn_c1_r050_0600_3_3 0 0 0 sky130_fd_pr__nfet_01v8 L=0.15 W=0.42 nf=1 ad=0.1218 as=0.1218 pd=1.42 ps=1.42 nrd=0.69047619047619  nrs=0.69047619047619 sa=0 sb=0 sd=0 mult=1 m=1
XMRD_c1_r050_0600_3_3 rbl_c1_r050_0600_3 sn_c1_r050_0600_3_3 rwl_des 0 sky130_fd_pr__nfet_01v8 L=0.15 W=0.42 nf=1 ad=0.1218 as=0.1218 pd=1.42 ps=1.42 nrd=0.69047619047619  nrs=0.69047619047619 sa=0 sb=0 sd=0 mult=1 m=1
csn_c1_r050_0600_3_3 sn_c1_r050_0600_3_3 0 {C_SN}
crbl_c1_r050_0600_3 rbl_c1_r050_0600_3 0 {C_RBL}
spr_c1_r050_0600_3 pref_050 ref_c1_r050_0600_3 ctl 0 swpre
cref_c1_r050_0600_3 ref_c1_r050_0600_3 0 {C_RBL}   $ ASSUMPTION: ideal matched dummy load
XMN1_c1_r050_0600_3 rbl_c1_r050_0600_3 ref_c1_r050_0600_3 vn_c1_r050_0600_3 0 sky130_fd_pr__nfet_01v8 L=0.15 W=1 nf=1 ad=0.29 as=0.29 pd=2.58 ps=2.58 mult=1 m=1
XMN2_c1_r050_0600_3 ref_c1_r050_0600_3 rbl_c1_r050_0600_3 vn_c1_r050_0600_3 0 sky130_fd_pr__nfet_01v8 L=0.15 W=1 nf=1 ad=0.29 as=0.29 pd=2.58 ps=2.58 mult=1 m=1
XMP1_c1_r050_0600_3 rbl_c1_r050_0600_3 ref_c1_r050_0600_3 vp_c1_r050_0600_3 vdd sky130_fd_pr__pfet_01v8 L=0.15 W=2 nf=1 ad=0.58 as=0.58 pd=4.58 ps=4.58 mult=1 m=1
XMP2_c1_r050_0600_3 ref_c1_r050_0600_3 rbl_c1_r050_0600_3 vp_c1_r050_0600_3 vdd sky130_fd_pr__pfet_01v8 L=0.15 W=2 nf=1 ad=0.58 as=0.58 pd=4.58 ps=4.58 mult=1 m=1
XMNF_c1_r050_0600_3 vn_c1_r050_0600_3 en 0 0 sky130_fd_pr__nfet_01v8 L=0.15 W=2 nf=1 ad=0.58 as=0.58 pd=4.58 ps=4.58 mult=1 m=1
XMPH_c1_r050_0600_3 vp_c1_r050_0600_3 enb vdd vdd sky130_fd_pr__pfet_01v8 L=0.15 W=4 nf=1 ad=1.16 as=1.16 pd=8.58 ps=8.58 mult=1 m=1
bd_c1_r050_0600_3 d_c1_r050_0600_3 0 v=v(rbl_c1_r050_0600_3)-v(ref_c1_r050_0600_3)
bdabs_c1_r050_0600_3 dabs_c1_r050_0600_3 0 v=abs(v(rbl_c1_r050_0600_3)-v(ref_c1_r050_0600_3))
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
