2AMLogic/sky130-gcedram/sim/sense-stage/sense_stage.spice

* sense_stage.spice -- single-ended latch sense stage on the 2T gain-cell read bitline
* (issue #60, Epic #24 item 2). GENERATED by gen_sense_stage.py; do not edit by hand.
*
* PROPOSED/UNRATIFIED SCOPE: the corners/temperatures this deck is run over come from
* spec/operating-range-decision-PROPOSED.md (27 C and 125 C only). Inputs follow
* sim/loaded-column/cold-corner/SENSE_INPUT_CONTRACT.md (baseline column).
* CIRCUIT BODY for `klt sim`: no .control/.end; the PDK .lib/.temp cards are appended per
* corner by klt. Flat and self-contained (batch fleet gets only this file + request.json).
*
* Every swept point is an independent parallel instance (own rbl/ref/latch/cells), so a
* corner needs ONE tran. Instance kinds:
*   st_*     stage-only: rbl precharged to VREF+d, no cells (offset / resolution of the latch)
*   cell1_*  end-to-end: 4-row column, all four SN pre-read at the stated level (stored '1')
*   cell0_*  same, stored '0' level
* Naming r<mV> = reference offset below the precharge level (VREF = VRBL - r).
*
* ASSUMPTIONS (all labelled; none is a spec value): C_RBL, VRBL, 4-row column, sense instant,
* reference level, latch/footer/header sizes, ideal precharge switch, ideal drivers, ideal
* matched dummy load on the reference side, all four SN at one level, global corners only.

.param VDD     = 1.8
.param VRBL    = 0.9   $ ASSUMPTION (contract)
.param TEDGE   = 1e-10
.param T_READ  = 1e-08   $ select edge
.param T_PGAP  = 2e-09   $ precharge released this long before T_READ
.param T_EN    = 2e-08   $ ASSUMPTION: latch enable = contract sense instant (T_READ+10n)
.param C_RBL   = 1e-14   $ ASSUMPTION (contract; not extracted)
.param C_SN    = 6.72741e-16   $ extracted-from-netlist (layout/gain_cell_2t.extract.parasitics.json)

* ---- shared drivers (ideal) ----
vdd   vdd 0 dc {VDD}
vctl  ctl 0 pwl(0 {VDD} {T_READ-T_PGAP} {VDD} {T_READ-T_PGAP+TEDGE} 0)
ven   en  0 pwl(0 0 {T_EN} 0 {T_EN+TEDGE} {VDD})
venb  enb 0 pwl(0 {VDD} {T_EN} {VDD} {T_EN+TEDGE} 0)
vrwls rwl_sel 0 pwl(0 {VDD} {T_READ} {VDD} {T_READ+TEDGE} 0)
vrwld rwl_des 0 dc {VDD}
vpre  prea 0 dc {VRBL}
vref_020 pref_020 0 dc 0.88   $ reference = VRBL - 0.02 (ASSUMPTION)
vref_050 pref_050 0 dc 0.85   $ reference = VRBL - 0.05 (ASSUMPTION)
vref_100 pref_100 0 dc 0.8   $ reference = VRBL - 0.1 (ASSUMPTION)
vref_200 pref_200 0 dc 0.7   $ reference = VRBL - 0.2 (ASSUMPTION)
.model swpre sw(vt=0.9 vh=0.1 ron=100 roff=1e12)

* ---- instance 0: st_m100mv ----
vpa_st_m100mv pa_st_m100mv 0 dc 0.700000
spa_st_m100mv pa_st_m100mv rbl_st_m100mv ctl 0 swpre
crbl_st_m100mv rbl_st_m100mv 0 {C_RBL}
spr_st_m100mv pref_100 ref_st_m100mv ctl 0 swpre
cref_st_m100mv ref_st_m100mv 0 {C_RBL}   $ ASSUMPTION: ideal matched dummy load
XMN1_st_m100mv rbl_st_m100mv ref_st_m100mv vn_st_m100mv 0 sky130_fd_pr__nfet_01v8 L=0.15 W=1 nf=1 ad=0.29 as=0.29 pd=2.58 ps=2.58 mult=1 m=1
XMN2_st_m100mv ref_st_m100mv rbl_st_m100mv vn_st_m100mv 0 sky130_fd_pr__nfet_01v8 L=0.15 W=1 nf=1 ad=0.29 as=0.29 pd=2.58 ps=2.58 mult=1 m=1
XMP1_st_m100mv rbl_st_m100mv ref_st_m100mv vp_st_m100mv vdd sky130_fd_pr__pfet_01v8 L=0.15 W=2 nf=1 ad=0.58 as=0.58 pd=4.58 ps=4.58 mult=1 m=1
XMP2_st_m100mv ref_st_m100mv rbl_st_m100mv vp_st_m100mv vdd sky130_fd_pr__pfet_01v8 L=0.15 W=2 nf=1 ad=0.58 as=0.58 pd=4.58 ps=4.58 mult=1 m=1
XMNF_st_m100mv vn_st_m100mv en 0 0 sky130_fd_pr__nfet_01v8 L=0.15 W=2 nf=1 ad=0.58 as=0.58 pd=4.58 ps=4.58 mult=1 m=1
XMPH_st_m100mv vp_st_m100mv enb vdd vdd sky130_fd_pr__pfet_01v8 L=0.15 W=4 nf=1 ad=1.16 as=1.16 pd=8.58 ps=8.58 mult=1 m=1
bd_st_m100mv d_st_m100mv 0 v=v(rbl_st_m100mv)-v(ref_st_m100mv)
bdabs_st_m100mv dabs_st_m100mv 0 v=abs(v(rbl_st_m100mv)-v(ref_st_m100mv))

* ---- instance 1: st_m50mv ----
vpa_st_m50mv pa_st_m50mv 0 dc 0.750000
spa_st_m50mv pa_st_m50mv rbl_st_m50mv ctl 0 swpre
crbl_st_m50mv rbl_st_m50mv 0 {C_RBL}
spr_st_m50mv pref_100 ref_st_m50mv ctl 0 swpre
cref_st_m50mv ref_st_m50mv 0 {C_RBL}   $ ASSUMPTION: ideal matched dummy load
XMN1_st_m50mv rbl_st_m50mv ref_st_m50mv vn_st_m50mv 0 sky130_fd_pr__nfet_01v8 L=0.15 W=1 nf=1 ad=0.29 as=0.29 pd=2.58 ps=2.58 mult=1 m=1
XMN2_st_m50mv ref_st_m50mv rbl_st_m50mv vn_st_m50mv 0 sky130_fd_pr__nfet_01v8 L=0.15 W=1 nf=1 ad=0.29 as=0.29 pd=2.58 ps=2.58 mult=1 m=1
XMP1_st_m50mv rbl_st_m50mv ref_st_m50mv vp_st_m50mv vdd sky130_fd_pr__pfet_01v8 L=0.15 W=2 nf=1 ad=0.58 as=0.58 pd=4.58 ps=4.58 mult=1 m=1
XMP2_st_m50mv ref_st_m50mv rbl_st_m50mv vp_st_m50mv vdd sky130_fd_pr__pfet_01v8 L=0.15 W=2 nf=1 ad=0.58 as=0.58 pd=4.58 ps=4.58 mult=1 m=1
XMNF_st_m50mv vn_st_m50mv en 0 0 sky130_fd_pr__nfet_01v8 L=0.15 W=2 nf=1 ad=0.58 as=0.58 pd=4.58 ps=4.58 mult=1 m=1
XMPH_st_m50mv vp_st_m50mv enb vdd vdd sky130_fd_pr__pfet_01v8 L=0.15 W=4 nf=1 ad=1.16 as=1.16 pd=8.58 ps=8.58 mult=1 m=1
bd_st_m50mv d_st_m50mv 0 v=v(rbl_st_m50mv)-v(ref_st_m50mv)
bdabs_st_m50mv dabs_st_m50mv 0 v=abs(v(rbl_st_m50mv)-v(ref_st_m50mv))

* ---- instance 2: st_m20mv ----
vpa_st_m20mv pa_st_m20mv 0 dc 0.780000
spa_st_m20mv pa_st_m20mv rbl_st_m20mv ctl 0 swpre
crbl_st_m20mv rbl_st_m20mv 0 {C_RBL}
spr_st_m20mv pref_100 ref_st_m20mv ctl 0 swpre
cref_st_m20mv ref_st_m20mv 0 {C_RBL}   $ ASSUMPTION: ideal matched dummy load
XMN1_st_m20mv rbl_st_m20mv ref_st_m20mv vn_st_m20mv 0 sky130_fd_pr__nfet_01v8 L=0.15 W=1 nf=1 ad=0.29 as=0.29 pd=2.58 ps=2.58 mult=1 m=1
XMN2_st_m20mv ref_st_m20mv rbl_st_m20mv vn_st_m20mv 0 sky130_fd_pr__nfet_01v8 L=0.15 W=1 nf=1 ad=0.29 as=0.29 pd=2.58 ps=2.58 mult=1 m=1
XMP1_st_m20mv rbl_st_m20mv ref_st_m20mv vp_st_m20mv vdd sky130_fd_pr__pfet_01v8 L=0.15 W=2 nf=1 ad=0.58 as=0.58 pd=4.58 ps=4.58 mult=1 m=1
XMP2_st_m20mv ref_st_m20mv rbl_st_m20mv vp_st_m20mv vdd sky130_fd_pr__pfet_01v8 L=0.15 W=2 nf=1 ad=0.58 as=0.58 pd=4.58 ps=4.58 mult=1 m=1
XMNF_st_m20mv vn_st_m20mv en 0 0 sky130_fd_pr__nfet_01v8 L=0.15 W=2 nf=1 ad=0.58 as=0.58 pd=4.58 ps=4.58 mult=1 m=1
XMPH_st_m20mv vp_st_m20mv enb vdd vdd sky130_fd_pr__pfet_01v8 L=0.15 W=4 nf=1 ad=1.16 as=1.16 pd=8.58 ps=8.58 mult=1 m=1
bd_st_m20mv d_st_m20mv 0 v=v(rbl_st_m20mv)-v(ref_st_m20mv)
bdabs_st_m20mv dabs_st_m20mv 0 v=abs(v(rbl_st_m20mv)-v(ref_st_m20mv))

* ---- instance 3: st_m10mv ----
vpa_st_m10mv pa_st_m10mv 0 dc 0.790000
spa_st_m10mv pa_st_m10mv rbl_st_m10mv ctl 0 swpre
crbl_st_m10mv rbl_st_m10mv 0 {C_RBL}
spr_st_m10mv pref_100 ref_st_m10mv ctl 0 swpre
cref_st_m10mv ref_st_m10mv 0 {C_RBL}   $ ASSUMPTION: ideal matched dummy load
XMN1_st_m10mv rbl_st_m10mv ref_st_m10mv vn_st_m10mv 0 sky130_fd_pr__nfet_01v8 L=0.15 W=1 nf=1 ad=0.29 as=0.29 pd=2.58 ps=2.58 mult=1 m=1
XMN2_st_m10mv ref_st_m10mv rbl_st_m10mv vn_st_m10mv 0 sky130_fd_pr__nfet_01v8 L=0.15 W=1 nf=1 ad=0.29 as=0.29 pd=2.58 ps=2.58 mult=1 m=1
XMP1_st_m10mv rbl_st_m10mv ref_st_m10mv vp_st_m10mv vdd sky130_fd_pr__pfet_01v8 L=0.15 W=2 nf=1 ad=0.58 as=0.58 pd=4.58 ps=4.58 mult=1 m=1
XMP2_st_m10mv ref_st_m10mv rbl_st_m10mv vp_st_m10mv vdd sky130_fd_pr__pfet_01v8 L=0.15 W=2 nf=1 ad=0.58 as=0.58 pd=4.58 ps=4.58 mult=1 m=1
XMNF_st_m10mv vn_st_m10mv en 0 0 sky130_fd_pr__nfet_01v8 L=0.15 W=2 nf=1 ad=0.58 as=0.58 pd=4.58 ps=4.58 mult=1 m=1
XMPH_st_m10mv vp_st_m10mv enb vdd vdd sky130_fd_pr__pfet_01v8 L=0.15 W=4 nf=1 ad=1.16 as=1.16 pd=8.58 ps=8.58 mult=1 m=1
bd_st_m10mv d_st_m10mv 0 v=v(rbl_st_m10mv)-v(ref_st_m10mv)
bdabs_st_m10mv dabs_st_m10mv 0 v=abs(v(rbl_st_m10mv)-v(ref_st_m10mv))

* ---- instance 4: st_m5mv ----
vpa_st_m5mv pa_st_m5mv 0 dc 0.795000
spa_st_m5mv pa_st_m5mv rbl_st_m5mv ctl 0 swpre
crbl_st_m5mv rbl_st_m5mv 0 {C_RBL}
spr_st_m5mv pref_100 ref_st_m5mv ctl 0 swpre
cref_st_m5mv ref_st_m5mv 0 {C_RBL}   $ ASSUMPTION: ideal matched dummy load
XMN1_st_m5mv rbl_st_m5mv ref_st_m5mv vn_st_m5mv 0 sky130_fd_pr__nfet_01v8 L=0.15 W=1 nf=1 ad=0.29 as=0.29 pd=2.58 ps=2.58 mult=1 m=1
XMN2_st_m5mv ref_st_m5mv rbl_st_m5mv vn_st_m5mv 0 sky130_fd_pr__nfet_01v8 L=0.15 W=1 nf=1 ad=0.29 as=0.29 pd=2.58 ps=2.58 mult=1 m=1
XMP1_st_m5mv rbl_st_m5mv ref_st_m5mv vp_st_m5mv vdd sky130_fd_pr__pfet_01v8 L=0.15 W=2 nf=1 ad=0.58 as=0.58 pd=4.58 ps=4.58 mult=1 m=1
XMP2_st_m5mv ref_st_m5mv rbl_st_m5mv vp_st_m5mv vdd sky130_fd_pr__pfet_01v8 L=0.15 W=2 nf=1 ad=0.58 as=0.58 pd=4.58 ps=4.58 mult=1 m=1
XMNF_st_m5mv vn_st_m5mv en 0 0 sky130_fd_pr__nfet_01v8 L=0.15 W=2 nf=1 ad=0.58 as=0.58 pd=4.58 ps=4.58 mult=1 m=1
XMPH_st_m5mv vp_st_m5mv enb vdd vdd sky130_fd_pr__pfet_01v8 L=0.15 W=4 nf=1 ad=1.16 as=1.16 pd=8.58 ps=8.58 mult=1 m=1
bd_st_m5mv d_st_m5mv 0 v=v(rbl_st_m5mv)-v(ref_st_m5mv)
bdabs_st_m5mv dabs_st_m5mv 0 v=abs(v(rbl_st_m5mv)-v(ref_st_m5mv))

* ---- instance 5: st_m2mv ----
vpa_st_m2mv pa_st_m2mv 0 dc 0.798000
spa_st_m2mv pa_st_m2mv rbl_st_m2mv ctl 0 swpre
crbl_st_m2mv rbl_st_m2mv 0 {C_RBL}
spr_st_m2mv pref_100 ref_st_m2mv ctl 0 swpre
cref_st_m2mv ref_st_m2mv 0 {C_RBL}   $ ASSUMPTION: ideal matched dummy load
XMN1_st_m2mv rbl_st_m2mv ref_st_m2mv vn_st_m2mv 0 sky130_fd_pr__nfet_01v8 L=0.15 W=1 nf=1 ad=0.29 as=0.29 pd=2.58 ps=2.58 mult=1 m=1
XMN2_st_m2mv ref_st_m2mv rbl_st_m2mv vn_st_m2mv 0 sky130_fd_pr__nfet_01v8 L=0.15 W=1 nf=1 ad=0.29 as=0.29 pd=2.58 ps=2.58 mult=1 m=1
XMP1_st_m2mv rbl_st_m2mv ref_st_m2mv vp_st_m2mv vdd sky130_fd_pr__pfet_01v8 L=0.15 W=2 nf=1 ad=0.58 as=0.58 pd=4.58 ps=4.58 mult=1 m=1
XMP2_st_m2mv ref_st_m2mv rbl_st_m2mv vp_st_m2mv vdd sky130_fd_pr__pfet_01v8 L=0.15 W=2 nf=1 ad=0.58 as=0.58 pd=4.58 ps=4.58 mult=1 m=1
XMNF_st_m2mv vn_st_m2mv en 0 0 sky130_fd_pr__nfet_01v8 L=0.15 W=2 nf=1 ad=0.58 as=0.58 pd=4.58 ps=4.58 mult=1 m=1
XMPH_st_m2mv vp_st_m2mv enb vdd vdd sky130_fd_pr__pfet_01v8 L=0.15 W=4 nf=1 ad=1.16 as=1.16 pd=8.58 ps=8.58 mult=1 m=1
bd_st_m2mv d_st_m2mv 0 v=v(rbl_st_m2mv)-v(ref_st_m2mv)
bdabs_st_m2mv dabs_st_m2mv 0 v=abs(v(rbl_st_m2mv)-v(ref_st_m2mv))

* ---- instance 6: st_m1mv ----
vpa_st_m1mv pa_st_m1mv 0 dc 0.799000
spa_st_m1mv pa_st_m1mv rbl_st_m1mv ctl 0 swpre
crbl_st_m1mv rbl_st_m1mv 0 {C_RBL}
spr_st_m1mv pref_100 ref_st_m1mv ctl 0 swpre
cref_st_m1mv ref_st_m1mv 0 {C_RBL}   $ ASSUMPTION: ideal matched dummy load
XMN1_st_m1mv rbl_st_m1mv ref_st_m1mv vn_st_m1mv 0 sky130_fd_pr__nfet_01v8 L=0.15 W=1 nf=1 ad=0.29 as=0.29 pd=2.58 ps=2.58 mult=1 m=1
XMN2_st_m1mv ref_st_m1mv rbl_st_m1mv vn_st_m1mv 0 sky130_fd_pr__nfet_01v8 L=0.15 W=1 nf=1 ad=0.29 as=0.29 pd=2.58 ps=2.58 mult=1 m=1
XMP1_st_m1mv rbl_st_m1mv ref_st_m1mv vp_st_m1mv vdd sky130_fd_pr__pfet_01v8 L=0.15 W=2 nf=1 ad=0.58 as=0.58 pd=4.58 ps=4.58 mult=1 m=1
XMP2_st_m1mv ref_st_m1mv rbl_st_m1mv vp_st_m1mv vdd sky130_fd_pr__pfet_01v8 L=0.15 W=2 nf=1 ad=0.58 as=0.58 pd=4.58 ps=4.58 mult=1 m=1
XMNF_st_m1mv vn_st_m1mv en 0 0 sky130_fd_pr__nfet_01v8 L=0.15 W=2 nf=1 ad=0.58 as=0.58 pd=4.58 ps=4.58 mult=1 m=1
XMPH_st_m1mv vp_st_m1mv enb vdd vdd sky130_fd_pr__pfet_01v8 L=0.15 W=4 nf=1 ad=1.16 as=1.16 pd=8.58 ps=8.58 mult=1 m=1
bd_st_m1mv d_st_m1mv 0 v=v(rbl_st_m1mv)-v(ref_st_m1mv)
bdabs_st_m1mv dabs_st_m1mv 0 v=abs(v(rbl_st_m1mv)-v(ref_st_m1mv))

* ---- instance 7: st_p1mv ----
vpa_st_p1mv pa_st_p1mv 0 dc 0.801000
spa_st_p1mv pa_st_p1mv rbl_st_p1mv ctl 0 swpre
crbl_st_p1mv rbl_st_p1mv 0 {C_RBL}
spr_st_p1mv pref_100 ref_st_p1mv ctl 0 swpre
cref_st_p1mv ref_st_p1mv 0 {C_RBL}   $ ASSUMPTION: ideal matched dummy load
XMN1_st_p1mv rbl_st_p1mv ref_st_p1mv vn_st_p1mv 0 sky130_fd_pr__nfet_01v8 L=0.15 W=1 nf=1 ad=0.29 as=0.29 pd=2.58 ps=2.58 mult=1 m=1
XMN2_st_p1mv ref_st_p1mv rbl_st_p1mv vn_st_p1mv 0 sky130_fd_pr__nfet_01v8 L=0.15 W=1 nf=1 ad=0.29 as=0.29 pd=2.58 ps=2.58 mult=1 m=1
XMP1_st_p1mv rbl_st_p1mv ref_st_p1mv vp_st_p1mv vdd sky130_fd_pr__pfet_01v8 L=0.15 W=2 nf=1 ad=0.58 as=0.58 pd=4.58 ps=4.58 mult=1 m=1
XMP2_st_p1mv ref_st_p1mv rbl_st_p1mv vp_st_p1mv vdd sky130_fd_pr__pfet_01v8 L=0.15 W=2 nf=1 ad=0.58 as=0.58 pd=4.58 ps=4.58 mult=1 m=1
XMNF_st_p1mv vn_st_p1mv en 0 0 sky130_fd_pr__nfet_01v8 L=0.15 W=2 nf=1 ad=0.58 as=0.58 pd=4.58 ps=4.58 mult=1 m=1
XMPH_st_p1mv vp_st_p1mv enb vdd vdd sky130_fd_pr__pfet_01v8 L=0.15 W=4 nf=1 ad=1.16 as=1.16 pd=8.58 ps=8.58 mult=1 m=1
bd_st_p1mv d_st_p1mv 0 v=v(rbl_st_p1mv)-v(ref_st_p1mv)
bdabs_st_p1mv dabs_st_p1mv 0 v=abs(v(rbl_st_p1mv)-v(ref_st_p1mv))

* ---- instance 8: st_p2mv ----
vpa_st_p2mv pa_st_p2mv 0 dc 0.802000
spa_st_p2mv pa_st_p2mv rbl_st_p2mv ctl 0 swpre
crbl_st_p2mv rbl_st_p2mv 0 {C_RBL}
spr_st_p2mv pref_100 ref_st_p2mv ctl 0 swpre
cref_st_p2mv ref_st_p2mv 0 {C_RBL}   $ ASSUMPTION: ideal matched dummy load
XMN1_st_p2mv rbl_st_p2mv ref_st_p2mv vn_st_p2mv 0 sky130_fd_pr__nfet_01v8 L=0.15 W=1 nf=1 ad=0.29 as=0.29 pd=2.58 ps=2.58 mult=1 m=1
XMN2_st_p2mv ref_st_p2mv rbl_st_p2mv vn_st_p2mv 0 sky130_fd_pr__nfet_01v8 L=0.15 W=1 nf=1 ad=0.29 as=0.29 pd=2.58 ps=2.58 mult=1 m=1
XMP1_st_p2mv rbl_st_p2mv ref_st_p2mv vp_st_p2mv vdd sky130_fd_pr__pfet_01v8 L=0.15 W=2 nf=1 ad=0.58 as=0.58 pd=4.58 ps=4.58 mult=1 m=1
XMP2_st_p2mv ref_st_p2mv rbl_st_p2mv vp_st_p2mv vdd sky130_fd_pr__pfet_01v8 L=0.15 W=2 nf=1 ad=0.58 as=0.58 pd=4.58 ps=4.58 mult=1 m=1
XMNF_st_p2mv vn_st_p2mv en 0 0 sky130_fd_pr__nfet_01v8 L=0.15 W=2 nf=1 ad=0.58 as=0.58 pd=4.58 ps=4.58 mult=1 m=1
XMPH_st_p2mv vp_st_p2mv enb vdd vdd sky130_fd_pr__pfet_01v8 L=0.15 W=4 nf=1 ad=1.16 as=1.16 pd=8.58 ps=8.58 mult=1 m=1
bd_st_p2mv d_st_p2mv 0 v=v(rbl_st_p2mv)-v(ref_st_p2mv)
bdabs_st_p2mv dabs_st_p2mv 0 v=abs(v(rbl_st_p2mv)-v(ref_st_p2mv))

* ---- instance 9: st_p5mv ----
vpa_st_p5mv pa_st_p5mv 0 dc 0.805000
spa_st_p5mv pa_st_p5mv rbl_st_p5mv ctl 0 swpre
crbl_st_p5mv rbl_st_p5mv 0 {C_RBL}
spr_st_p5mv pref_100 ref_st_p5mv ctl 0 swpre
cref_st_p5mv ref_st_p5mv 0 {C_RBL}   $ ASSUMPTION: ideal matched dummy load
XMN1_st_p5mv rbl_st_p5mv ref_st_p5mv vn_st_p5mv 0 sky130_fd_pr__nfet_01v8 L=0.15 W=1 nf=1 ad=0.29 as=0.29 pd=2.58 ps=2.58 mult=1 m=1
XMN2_st_p5mv ref_st_p5mv rbl_st_p5mv vn_st_p5mv 0 sky130_fd_pr__nfet_01v8 L=0.15 W=1 nf=1 ad=0.29 as=0.29 pd=2.58 ps=2.58 mult=1 m=1
XMP1_st_p5mv rbl_st_p5mv ref_st_p5mv vp_st_p5mv vdd sky130_fd_pr__pfet_01v8 L=0.15 W=2 nf=1 ad=0.58 as=0.58 pd=4.58 ps=4.58 mult=1 m=1
XMP2_st_p5mv ref_st_p5mv rbl_st_p5mv vp_st_p5mv vdd sky130_fd_pr__pfet_01v8 L=0.15 W=2 nf=1 ad=0.58 as=0.58 pd=4.58 ps=4.58 mult=1 m=1
XMNF_st_p5mv vn_st_p5mv en 0 0 sky130_fd_pr__nfet_01v8 L=0.15 W=2 nf=1 ad=0.58 as=0.58 pd=4.58 ps=4.58 mult=1 m=1
XMPH_st_p5mv vp_st_p5mv enb vdd vdd sky130_fd_pr__pfet_01v8 L=0.15 W=4 nf=1 ad=1.16 as=1.16 pd=8.58 ps=8.58 mult=1 m=1
bd_st_p5mv d_st_p5mv 0 v=v(rbl_st_p5mv)-v(ref_st_p5mv)
bdabs_st_p5mv dabs_st_p5mv 0 v=abs(v(rbl_st_p5mv)-v(ref_st_p5mv))

* ---- instance 10: st_p10mv ----
vpa_st_p10mv pa_st_p10mv 0 dc 0.810000
spa_st_p10mv pa_st_p10mv rbl_st_p10mv ctl 0 swpre
crbl_st_p10mv rbl_st_p10mv 0 {C_RBL}
spr_st_p10mv pref_100 ref_st_p10mv ctl 0 swpre
cref_st_p10mv ref_st_p10mv 0 {C_RBL}   $ ASSUMPTION: ideal matched dummy load
XMN1_st_p10mv rbl_st_p10mv ref_st_p10mv vn_st_p10mv 0 sky130_fd_pr__nfet_01v8 L=0.15 W=1 nf=1 ad=0.29 as=0.29 pd=2.58 ps=2.58 mult=1 m=1
XMN2_st_p10mv ref_st_p10mv rbl_st_p10mv vn_st_p10mv 0 sky130_fd_pr__nfet_01v8 L=0.15 W=1 nf=1 ad=0.29 as=0.29 pd=2.58 ps=2.58 mult=1 m=1
XMP1_st_p10mv rbl_st_p10mv ref_st_p10mv vp_st_p10mv vdd sky130_fd_pr__pfet_01v8 L=0.15 W=2 nf=1 ad=0.58 as=0.58 pd=4.58 ps=4.58 mult=1 m=1
XMP2_st_p10mv ref_st_p10mv rbl_st_p10mv vp_st_p10mv vdd sky130_fd_pr__pfet_01v8 L=0.15 W=2 nf=1 ad=0.58 as=0.58 pd=4.58 ps=4.58 mult=1 m=1
XMNF_st_p10mv vn_st_p10mv en 0 0 sky130_fd_pr__nfet_01v8 L=0.15 W=2 nf=1 ad=0.58 as=0.58 pd=4.58 ps=4.58 mult=1 m=1
XMPH_st_p10mv vp_st_p10mv enb vdd vdd sky130_fd_pr__pfet_01v8 L=0.15 W=4 nf=1 ad=1.16 as=1.16 pd=8.58 ps=8.58 mult=1 m=1
bd_st_p10mv d_st_p10mv 0 v=v(rbl_st_p10mv)-v(ref_st_p10mv)
bdabs_st_p10mv dabs_st_p10mv 0 v=abs(v(rbl_st_p10mv)-v(ref_st_p10mv))

* ---- instance 11: st_p20mv ----
vpa_st_p20mv pa_st_p20mv 0 dc 0.820000
spa_st_p20mv pa_st_p20mv rbl_st_p20mv ctl 0 swpre
crbl_st_p20mv rbl_st_p20mv 0 {C_RBL}
spr_st_p20mv pref_100 ref_st_p20mv ctl 0 swpre
cref_st_p20mv ref_st_p20mv 0 {C_RBL}   $ ASSUMPTION: ideal matched dummy load
XMN1_st_p20mv rbl_st_p20mv ref_st_p20mv vn_st_p20mv 0 sky130_fd_pr__nfet_01v8 L=0.15 W=1 nf=1 ad=0.29 as=0.29 pd=2.58 ps=2.58 mult=1 m=1
XMN2_st_p20mv ref_st_p20mv rbl_st_p20mv vn_st_p20mv 0 sky130_fd_pr__nfet_01v8 L=0.15 W=1 nf=1 ad=0.29 as=0.29 pd=2.58 ps=2.58 mult=1 m=1
XMP1_st_p20mv rbl_st_p20mv ref_st_p20mv vp_st_p20mv vdd sky130_fd_pr__pfet_01v8 L=0.15 W=2 nf=1 ad=0.58 as=0.58 pd=4.58 ps=4.58 mult=1 m=1
XMP2_st_p20mv ref_st_p20mv rbl_st_p20mv vp_st_p20mv vdd sky130_fd_pr__pfet_01v8 L=0.15 W=2 nf=1 ad=0.58 as=0.58 pd=4.58 ps=4.58 mult=1 m=1
XMNF_st_p20mv vn_st_p20mv en 0 0 sky130_fd_pr__nfet_01v8 L=0.15 W=2 nf=1 ad=0.58 as=0.58 pd=4.58 ps=4.58 mult=1 m=1
XMPH_st_p20mv vp_st_p20mv enb vdd vdd sky130_fd_pr__pfet_01v8 L=0.15 W=4 nf=1 ad=1.16 as=1.16 pd=8.58 ps=8.58 mult=1 m=1
bd_st_p20mv d_st_p20mv 0 v=v(rbl_st_p20mv)-v(ref_st_p20mv)
bdabs_st_p20mv dabs_st_p20mv 0 v=abs(v(rbl_st_p20mv)-v(ref_st_p20mv))

* ---- instance 12: st_p50mv ----
vpa_st_p50mv pa_st_p50mv 0 dc 0.850000
spa_st_p50mv pa_st_p50mv rbl_st_p50mv ctl 0 swpre
crbl_st_p50mv rbl_st_p50mv 0 {C_RBL}
spr_st_p50mv pref_100 ref_st_p50mv ctl 0 swpre
cref_st_p50mv ref_st_p50mv 0 {C_RBL}   $ ASSUMPTION: ideal matched dummy load
XMN1_st_p50mv rbl_st_p50mv ref_st_p50mv vn_st_p50mv 0 sky130_fd_pr__nfet_01v8 L=0.15 W=1 nf=1 ad=0.29 as=0.29 pd=2.58 ps=2.58 mult=1 m=1
XMN2_st_p50mv ref_st_p50mv rbl_st_p50mv vn_st_p50mv 0 sky130_fd_pr__nfet_01v8 L=0.15 W=1 nf=1 ad=0.29 as=0.29 pd=2.58 ps=2.58 mult=1 m=1
XMP1_st_p50mv rbl_st_p50mv ref_st_p50mv vp_st_p50mv vdd sky130_fd_pr__pfet_01v8 L=0.15 W=2 nf=1 ad=0.58 as=0.58 pd=4.58 ps=4.58 mult=1 m=1
XMP2_st_p50mv ref_st_p50mv rbl_st_p50mv vp_st_p50mv vdd sky130_fd_pr__pfet_01v8 L=0.15 W=2 nf=1 ad=0.58 as=0.58 pd=4.58 ps=4.58 mult=1 m=1
XMNF_st_p50mv vn_st_p50mv en 0 0 sky130_fd_pr__nfet_01v8 L=0.15 W=2 nf=1 ad=0.58 as=0.58 pd=4.58 ps=4.58 mult=1 m=1
XMPH_st_p50mv vp_st_p50mv enb vdd vdd sky130_fd_pr__pfet_01v8 L=0.15 W=4 nf=1 ad=1.16 as=1.16 pd=8.58 ps=8.58 mult=1 m=1
bd_st_p50mv d_st_p50mv 0 v=v(rbl_st_p50mv)-v(ref_st_p50mv)
bdabs_st_p50mv dabs_st_p50mv 0 v=abs(v(rbl_st_p50mv)-v(ref_st_p50mv))

* ---- instance 13: st_p100mv ----
vpa_st_p100mv pa_st_p100mv 0 dc 0.900000
spa_st_p100mv pa_st_p100mv rbl_st_p100mv ctl 0 swpre
crbl_st_p100mv rbl_st_p100mv 0 {C_RBL}
spr_st_p100mv pref_100 ref_st_p100mv ctl 0 swpre
cref_st_p100mv ref_st_p100mv 0 {C_RBL}   $ ASSUMPTION: ideal matched dummy load
XMN1_st_p100mv rbl_st_p100mv ref_st_p100mv vn_st_p100mv 0 sky130_fd_pr__nfet_01v8 L=0.15 W=1 nf=1 ad=0.29 as=0.29 pd=2.58 ps=2.58 mult=1 m=1
XMN2_st_p100mv ref_st_p100mv rbl_st_p100mv vn_st_p100mv 0 sky130_fd_pr__nfet_01v8 L=0.15 W=1 nf=1 ad=0.29 as=0.29 pd=2.58 ps=2.58 mult=1 m=1
XMP1_st_p100mv rbl_st_p100mv ref_st_p100mv vp_st_p100mv vdd sky130_fd_pr__pfet_01v8 L=0.15 W=2 nf=1 ad=0.58 as=0.58 pd=4.58 ps=4.58 mult=1 m=1
XMP2_st_p100mv ref_st_p100mv rbl_st_p100mv vp_st_p100mv vdd sky130_fd_pr__pfet_01v8 L=0.15 W=2 nf=1 ad=0.58 as=0.58 pd=4.58 ps=4.58 mult=1 m=1
XMNF_st_p100mv vn_st_p100mv en 0 0 sky130_fd_pr__nfet_01v8 L=0.15 W=2 nf=1 ad=0.58 as=0.58 pd=4.58 ps=4.58 mult=1 m=1
XMPH_st_p100mv vp_st_p100mv enb vdd vdd sky130_fd_pr__pfet_01v8 L=0.15 W=4 nf=1 ad=1.16 as=1.16 pd=8.58 ps=8.58 mult=1 m=1
bd_st_p100mv d_st_p100mv 0 v=v(rbl_st_p100mv)-v(ref_st_p100mv)
bdabs_st_p100mv dabs_st_p100mv 0 v=abs(v(rbl_st_p100mv)-v(ref_st_p100mv))

* ---- instance 14: cell0_r020_n100 ----
spa_cell0_r020_n100 prea rbl_cell0_r020_n100 ctl 0 swpre
XMWR_cell0_r020_n100_0 sn_cell0_r020_n100_0 0 0 0 sky130_fd_pr__nfet_01v8 L=0.15 W=0.42 nf=1 ad=0.1218 as=0.1218 pd=1.42 ps=1.42 nrd=0.69047619047619  nrs=0.69047619047619 sa=0 sb=0 sd=0 mult=1 m=1
XMRD_cell0_r020_n100_0 rbl_cell0_r020_n100 sn_cell0_r020_n100_0 rwl_sel 0 sky130_fd_pr__nfet_01v8 L=0.15 W=0.42 nf=1 ad=0.1218 as=0.1218 pd=1.42 ps=1.42 nrd=0.69047619047619  nrs=0.69047619047619 sa=0 sb=0 sd=0 mult=1 m=1
csn_cell0_r020_n100_0 sn_cell0_r020_n100_0 0 {C_SN}
XMWR_cell0_r020_n100_1 sn_cell0_r020_n100_1 0 0 0 sky130_fd_pr__nfet_01v8 L=0.15 W=0.42 nf=1 ad=0.1218 as=0.1218 pd=1.42 ps=1.42 nrd=0.69047619047619  nrs=0.69047619047619 sa=0 sb=0 sd=0 mult=1 m=1
XMRD_cell0_r020_n100_1 rbl_cell0_r020_n100 sn_cell0_r020_n100_1 rwl_des 0 sky130_fd_pr__nfet_01v8 L=0.15 W=0.42 nf=1 ad=0.1218 as=0.1218 pd=1.42 ps=1.42 nrd=0.69047619047619  nrs=0.69047619047619 sa=0 sb=0 sd=0 mult=1 m=1
csn_cell0_r020_n100_1 sn_cell0_r020_n100_1 0 {C_SN}
XMWR_cell0_r020_n100_2 sn_cell0_r020_n100_2 0 0 0 sky130_fd_pr__nfet_01v8 L=0.15 W=0.42 nf=1 ad=0.1218 as=0.1218 pd=1.42 ps=1.42 nrd=0.69047619047619  nrs=0.69047619047619 sa=0 sb=0 sd=0 mult=1 m=1
XMRD_cell0_r020_n100_2 rbl_cell0_r020_n100 sn_cell0_r020_n100_2 rwl_des 0 sky130_fd_pr__nfet_01v8 L=0.15 W=0.42 nf=1 ad=0.1218 as=0.1218 pd=1.42 ps=1.42 nrd=0.69047619047619  nrs=0.69047619047619 sa=0 sb=0 sd=0 mult=1 m=1
csn_cell0_r020_n100_2 sn_cell0_r020_n100_2 0 {C_SN}
XMWR_cell0_r020_n100_3 sn_cell0_r020_n100_3 0 0 0 sky130_fd_pr__nfet_01v8 L=0.15 W=0.42 nf=1 ad=0.1218 as=0.1218 pd=1.42 ps=1.42 nrd=0.69047619047619  nrs=0.69047619047619 sa=0 sb=0 sd=0 mult=1 m=1
XMRD_cell0_r020_n100_3 rbl_cell0_r020_n100 sn_cell0_r020_n100_3 rwl_des 0 sky130_fd_pr__nfet_01v8 L=0.15 W=0.42 nf=1 ad=0.1218 as=0.1218 pd=1.42 ps=1.42 nrd=0.69047619047619  nrs=0.69047619047619 sa=0 sb=0 sd=0 mult=1 m=1
csn_cell0_r020_n100_3 sn_cell0_r020_n100_3 0 {C_SN}
crbl_cell0_r020_n100 rbl_cell0_r020_n100 0 {C_RBL}
spr_cell0_r020_n100 pref_020 ref_cell0_r020_n100 ctl 0 swpre
cref_cell0_r020_n100 ref_cell0_r020_n100 0 {C_RBL}   $ ASSUMPTION: ideal matched dummy load
XMN1_cell0_r020_n100 rbl_cell0_r020_n100 ref_cell0_r020_n100 vn_cell0_r020_n100 0 sky130_fd_pr__nfet_01v8 L=0.15 W=1 nf=1 ad=0.29 as=0.29 pd=2.58 ps=2.58 mult=1 m=1
XMN2_cell0_r020_n100 ref_cell0_r020_n100 rbl_cell0_r020_n100 vn_cell0_r020_n100 0 sky130_fd_pr__nfet_01v8 L=0.15 W=1 nf=1 ad=0.29 as=0.29 pd=2.58 ps=2.58 mult=1 m=1
XMP1_cell0_r020_n100 rbl_cell0_r020_n100 ref_cell0_r020_n100 vp_cell0_r020_n100 vdd sky130_fd_pr__pfet_01v8 L=0.15 W=2 nf=1 ad=0.58 as=0.58 pd=4.58 ps=4.58 mult=1 m=1
XMP2_cell0_r020_n100 ref_cell0_r020_n100 rbl_cell0_r020_n100 vp_cell0_r020_n100 vdd sky130_fd_pr__pfet_01v8 L=0.15 W=2 nf=1 ad=0.58 as=0.58 pd=4.58 ps=4.58 mult=1 m=1
XMNF_cell0_r020_n100 vn_cell0_r020_n100 en 0 0 sky130_fd_pr__nfet_01v8 L=0.15 W=2 nf=1 ad=0.58 as=0.58 pd=4.58 ps=4.58 mult=1 m=1
XMPH_cell0_r020_n100 vp_cell0_r020_n100 enb vdd vdd sky130_fd_pr__pfet_01v8 L=0.15 W=4 nf=1 ad=1.16 as=1.16 pd=8.58 ps=8.58 mult=1 m=1
bd_cell0_r020_n100 d_cell0_r020_n100 0 v=v(rbl_cell0_r020_n100)-v(ref_cell0_r020_n100)
bdabs_cell0_r020_n100 dabs_cell0_r020_n100 0 v=abs(v(rbl_cell0_r020_n100)-v(ref_cell0_r020_n100))

* ---- instance 15: cell0_r020_0000 ----
spa_cell0_r020_0000 prea rbl_cell0_r020_0000 ctl 0 swpre
XMWR_cell0_r020_0000_0 sn_cell0_r020_0000_0 0 0 0 sky130_fd_pr__nfet_01v8 L=0.15 W=0.42 nf=1 ad=0.1218 as=0.1218 pd=1.42 ps=1.42 nrd=0.69047619047619  nrs=0.69047619047619 sa=0 sb=0 sd=0 mult=1 m=1
XMRD_cell0_r020_0000_0 rbl_cell0_r020_0000 sn_cell0_r020_0000_0 rwl_sel 0 sky130_fd_pr__nfet_01v8 L=0.15 W=0.42 nf=1 ad=0.1218 as=0.1218 pd=1.42 ps=1.42 nrd=0.69047619047619  nrs=0.69047619047619 sa=0 sb=0 sd=0 mult=1 m=1
csn_cell0_r020_0000_0 sn_cell0_r020_0000_0 0 {C_SN}
XMWR_cell0_r020_0000_1 sn_cell0_r020_0000_1 0 0 0 sky130_fd_pr__nfet_01v8 L=0.15 W=0.42 nf=1 ad=0.1218 as=0.1218 pd=1.42 ps=1.42 nrd=0.69047619047619  nrs=0.69047619047619 sa=0 sb=0 sd=0 mult=1 m=1
XMRD_cell0_r020_0000_1 rbl_cell0_r020_0000 sn_cell0_r020_0000_1 rwl_des 0 sky130_fd_pr__nfet_01v8 L=0.15 W=0.42 nf=1 ad=0.1218 as=0.1218 pd=1.42 ps=1.42 nrd=0.69047619047619  nrs=0.69047619047619 sa=0 sb=0 sd=0 mult=1 m=1
csn_cell0_r020_0000_1 sn_cell0_r020_0000_1 0 {C_SN}
XMWR_cell0_r020_0000_2 sn_cell0_r020_0000_2 0 0 0 sky130_fd_pr__nfet_01v8 L=0.15 W=0.42 nf=1 ad=0.1218 as=0.1218 pd=1.42 ps=1.42 nrd=0.69047619047619  nrs=0.69047619047619 sa=0 sb=0 sd=0 mult=1 m=1
XMRD_cell0_r020_0000_2 rbl_cell0_r020_0000 sn_cell0_r020_0000_2 rwl_des 0 sky130_fd_pr__nfet_01v8 L=0.15 W=0.42 nf=1 ad=0.1218 as=0.1218 pd=1.42 ps=1.42 nrd=0.69047619047619  nrs=0.69047619047619 sa=0 sb=0 sd=0 mult=1 m=1
csn_cell0_r020_0000_2 sn_cell0_r020_0000_2 0 {C_SN}
XMWR_cell0_r020_0000_3 sn_cell0_r020_0000_3 0 0 0 sky130_fd_pr__nfet_01v8 L=0.15 W=0.42 nf=1 ad=0.1218 as=0.1218 pd=1.42 ps=1.42 nrd=0.69047619047619  nrs=0.69047619047619 sa=0 sb=0 sd=0 mult=1 m=1
XMRD_cell0_r020_0000_3 rbl_cell0_r020_0000 sn_cell0_r020_0000_3 rwl_des 0 sky130_fd_pr__nfet_01v8 L=0.15 W=0.42 nf=1 ad=0.1218 as=0.1218 pd=1.42 ps=1.42 nrd=0.69047619047619  nrs=0.69047619047619 sa=0 sb=0 sd=0 mult=1 m=1
csn_cell0_r020_0000_3 sn_cell0_r020_0000_3 0 {C_SN}
crbl_cell0_r020_0000 rbl_cell0_r020_0000 0 {C_RBL}
spr_cell0_r020_0000 pref_020 ref_cell0_r020_0000 ctl 0 swpre
cref_cell0_r020_0000 ref_cell0_r020_0000 0 {C_RBL}   $ ASSUMPTION: ideal matched dummy load
XMN1_cell0_r020_0000 rbl_cell0_r020_0000 ref_cell0_r020_0000 vn_cell0_r020_0000 0 sky130_fd_pr__nfet_01v8 L=0.15 W=1 nf=1 ad=0.29 as=0.29 pd=2.58 ps=2.58 mult=1 m=1
XMN2_cell0_r020_0000 ref_cell0_r020_0000 rbl_cell0_r020_0000 vn_cell0_r020_0000 0 sky130_fd_pr__nfet_01v8 L=0.15 W=1 nf=1 ad=0.29 as=0.29 pd=2.58 ps=2.58 mult=1 m=1
XMP1_cell0_r020_0000 rbl_cell0_r020_0000 ref_cell0_r020_0000 vp_cell0_r020_0000 vdd sky130_fd_pr__pfet_01v8 L=0.15 W=2 nf=1 ad=0.58 as=0.58 pd=4.58 ps=4.58 mult=1 m=1
XMP2_cell0_r020_0000 ref_cell0_r020_0000 rbl_cell0_r020_0000 vp_cell0_r020_0000 vdd sky130_fd_pr__pfet_01v8 L=0.15 W=2 nf=1 ad=0.58 as=0.58 pd=4.58 ps=4.58 mult=1 m=1
XMNF_cell0_r020_0000 vn_cell0_r020_0000 en 0 0 sky130_fd_pr__nfet_01v8 L=0.15 W=2 nf=1 ad=0.58 as=0.58 pd=4.58 ps=4.58 mult=1 m=1
XMPH_cell0_r020_0000 vp_cell0_r020_0000 enb vdd vdd sky130_fd_pr__pfet_01v8 L=0.15 W=4 nf=1 ad=1.16 as=1.16 pd=8.58 ps=8.58 mult=1 m=1
bd_cell0_r020_0000 d_cell0_r020_0000 0 v=v(rbl_cell0_r020_0000)-v(ref_cell0_r020_0000)
bdabs_cell0_r020_0000 dabs_cell0_r020_0000 0 v=abs(v(rbl_cell0_r020_0000)-v(ref_cell0_r020_0000))

* ---- instance 16: cell1_r020_0300 ----
spa_cell1_r020_0300 prea rbl_cell1_r020_0300 ctl 0 swpre
XMWR_cell1_r020_0300_0 sn_cell1_r020_0300_0 0 0 0 sky130_fd_pr__nfet_01v8 L=0.15 W=0.42 nf=1 ad=0.1218 as=0.1218 pd=1.42 ps=1.42 nrd=0.69047619047619  nrs=0.69047619047619 sa=0 sb=0 sd=0 mult=1 m=1
XMRD_cell1_r020_0300_0 rbl_cell1_r020_0300 sn_cell1_r020_0300_0 rwl_sel 0 sky130_fd_pr__nfet_01v8 L=0.15 W=0.42 nf=1 ad=0.1218 as=0.1218 pd=1.42 ps=1.42 nrd=0.69047619047619  nrs=0.69047619047619 sa=0 sb=0 sd=0 mult=1 m=1
csn_cell1_r020_0300_0 sn_cell1_r020_0300_0 0 {C_SN}
XMWR_cell1_r020_0300_1 sn_cell1_r020_0300_1 0 0 0 sky130_fd_pr__nfet_01v8 L=0.15 W=0.42 nf=1 ad=0.1218 as=0.1218 pd=1.42 ps=1.42 nrd=0.69047619047619  nrs=0.69047619047619 sa=0 sb=0 sd=0 mult=1 m=1
XMRD_cell1_r020_0300_1 rbl_cell1_r020_0300 sn_cell1_r020_0300_1 rwl_des 0 sky130_fd_pr__nfet_01v8 L=0.15 W=0.42 nf=1 ad=0.1218 as=0.1218 pd=1.42 ps=1.42 nrd=0.69047619047619  nrs=0.69047619047619 sa=0 sb=0 sd=0 mult=1 m=1
csn_cell1_r020_0300_1 sn_cell1_r020_0300_1 0 {C_SN}
XMWR_cell1_r020_0300_2 sn_cell1_r020_0300_2 0 0 0 sky130_fd_pr__nfet_01v8 L=0.15 W=0.42 nf=1 ad=0.1218 as=0.1218 pd=1.42 ps=1.42 nrd=0.69047619047619  nrs=0.69047619047619 sa=0 sb=0 sd=0 mult=1 m=1
XMRD_cell1_r020_0300_2 rbl_cell1_r020_0300 sn_cell1_r020_0300_2 rwl_des 0 sky130_fd_pr__nfet_01v8 L=0.15 W=0.42 nf=1 ad=0.1218 as=0.1218 pd=1.42 ps=1.42 nrd=0.69047619047619  nrs=0.69047619047619 sa=0 sb=0 sd=0 mult=1 m=1
csn_cell1_r020_0300_2 sn_cell1_r020_0300_2 0 {C_SN}
XMWR_cell1_r020_0300_3 sn_cell1_r020_0300_3 0 0 0 sky130_fd_pr__nfet_01v8 L=0.15 W=0.42 nf=1 ad=0.1218 as=0.1218 pd=1.42 ps=1.42 nrd=0.69047619047619  nrs=0.69047619047619 sa=0 sb=0 sd=0 mult=1 m=1
XMRD_cell1_r020_0300_3 rbl_cell1_r020_0300 sn_cell1_r020_0300_3 rwl_des 0 sky130_fd_pr__nfet_01v8 L=0.15 W=0.42 nf=1 ad=0.1218 as=0.1218 pd=1.42 ps=1.42 nrd=0.69047619047619  nrs=0.69047619047619 sa=0 sb=0 sd=0 mult=1 m=1
csn_cell1_r020_0300_3 sn_cell1_r020_0300_3 0 {C_SN}
crbl_cell1_r020_0300 rbl_cell1_r020_0300 0 {C_RBL}
spr_cell1_r020_0300 pref_020 ref_cell1_r020_0300 ctl 0 swpre
cref_cell1_r020_0300 ref_cell1_r020_0300 0 {C_RBL}   $ ASSUMPTION: ideal matched dummy load
XMN1_cell1_r020_0300 rbl_cell1_r020_0300 ref_cell1_r020_0300 vn_cell1_r020_0300 0 sky130_fd_pr__nfet_01v8 L=0.15 W=1 nf=1 ad=0.29 as=0.29 pd=2.58 ps=2.58 mult=1 m=1
XMN2_cell1_r020_0300 ref_cell1_r020_0300 rbl_cell1_r020_0300 vn_cell1_r020_0300 0 sky130_fd_pr__nfet_01v8 L=0.15 W=1 nf=1 ad=0.29 as=0.29 pd=2.58 ps=2.58 mult=1 m=1
XMP1_cell1_r020_0300 rbl_cell1_r020_0300 ref_cell1_r020_0300 vp_cell1_r020_0300 vdd sky130_fd_pr__pfet_01v8 L=0.15 W=2 nf=1 ad=0.58 as=0.58 pd=4.58 ps=4.58 mult=1 m=1
XMP2_cell1_r020_0300 ref_cell1_r020_0300 rbl_cell1_r020_0300 vp_cell1_r020_0300 vdd sky130_fd_pr__pfet_01v8 L=0.15 W=2 nf=1 ad=0.58 as=0.58 pd=4.58 ps=4.58 mult=1 m=1
XMNF_cell1_r020_0300 vn_cell1_r020_0300 en 0 0 sky130_fd_pr__nfet_01v8 L=0.15 W=2 nf=1 ad=0.58 as=0.58 pd=4.58 ps=4.58 mult=1 m=1
XMPH_cell1_r020_0300 vp_cell1_r020_0300 enb vdd vdd sky130_fd_pr__pfet_01v8 L=0.15 W=4 nf=1 ad=1.16 as=1.16 pd=8.58 ps=8.58 mult=1 m=1
bd_cell1_r020_0300 d_cell1_r020_0300 0 v=v(rbl_cell1_r020_0300)-v(ref_cell1_r020_0300)
bdabs_cell1_r020_0300 dabs_cell1_r020_0300 0 v=abs(v(rbl_cell1_r020_0300)-v(ref_cell1_r020_0300))
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
