2AMLogic/sky130-gcedram/sim/refresh-energy/refresh_energy.spice

* refresh_energy.spice -- ideal-driver array-boundary energy of one row refresh of the extracted
* 4x4 2T gain-cell array, and matched idle control (issue #115). GENERATED by gen_refresh_energy.py;
* do not edit by hand.
*
* PROPOSED/UNRATIFIED SCOPE: 27 C / 125 C, five global corners, 1.8 V (spec/operating-range-decision-PROPOSED.md).
* CIRCUIT BODY for `klt sim`: no .control/.end; .lib/.temp are appended per corner by klt.
*
* Instances (each the committed extracted array, own sources, no shared drivers):
*   act_<p>  refresh of row 0 (precharge -> RWL0 select -> 10 ns sense -> 10 ns WWL0 write-back of the
*            stored bit -> release); idl_<p> matched idle (standby levels, no pulses); nop_c active code
*            path with every pulse at its standby level (control); refw = #110 reference write (SN 0 V,
*            ideal 1.8 V WBL, 20 ns WWL) -- its energy is NOT measured.
*   <p> = z all-zero, o all-one, c checkerboard (bit = (r+c) even), i inverse checkerboard.
* Power nodes p{n,g,r}_<source> = net / max(p,0) / max(-p,0) of p = -v*i in W.
* ASSUMPTIONS (none is a spec value): ideal drivers, ideal 100 ohm precharge switch, stored '1' 0.9 V,
* idle WBL 0 V, standby RBL precharged, ideal decision, global corners only (no mismatch).

.options method=trap gmin=1e-15 abstol=1e-15 chgtol=1e-18
.model swpre sw(vt=0.9 vh=0.1 ron=100 roff=1e12)

* ---- instance act_z: mode active, pattern zero ----
xm1_act_z sn_0_0__t0_act_z wl_0__t3_act_z bl_0__t0_act_z gnd__t0_act_z sky130_fd_pr__nfet_01v8 L=0.15 W=0.42 nf=1 ad=0.1974 as=0.1974 pd=1.78 ps=1.78 mult=1 m=1
xm2_act_z rbl_0__t0_act_z sn_0_0__t1_act_z rwl_0__t0_act_z gnd__t1_act_z sky130_fd_pr__nfet_01v8 L=0.15 W=0.42 nf=1 ad=0.1974 as=0.1974 pd=1.78 ps=1.78 mult=1 m=1
xm3_act_z sn_0_1__t1_act_z wl_0__t0_act_z bl_1__t0_act_z gnd__t2_act_z sky130_fd_pr__nfet_01v8 L=0.15 W=0.42 nf=1 ad=0.1974 as=0.1974 pd=1.78 ps=1.78 mult=1 m=1
xm4_act_z rbl_1__t0_act_z sn_0_1__t0_act_z rwl_0__t1_act_z gnd__t3_act_z sky130_fd_pr__nfet_01v8 L=0.15 W=0.42 nf=1 ad=0.1974 as=0.1974 pd=1.78 ps=1.78 mult=1 m=1
xm5_act_z sn_0_2__t1_act_z wl_0__t1_act_z bl_2__t0_act_z gnd__t4_act_z sky130_fd_pr__nfet_01v8 L=0.15 W=0.42 nf=1 ad=0.1974 as=0.1974 pd=1.78 ps=1.78 mult=1 m=1
xm6_act_z rbl_2__t0_act_z sn_0_2__t0_act_z rwl_0__t2_act_z gnd__t5_act_z sky130_fd_pr__nfet_01v8 L=0.15 W=0.42 nf=1 ad=0.1974 as=0.1974 pd=1.78 ps=1.78 mult=1 m=1
xm7_act_z sn_0_3__t1_act_z wl_0__t2_act_z bl_3__t0_act_z gnd__t6_act_z sky130_fd_pr__nfet_01v8 L=0.15 W=0.42 nf=1 ad=0.1974 as=0.1974 pd=1.78 ps=1.78 mult=1 m=1
xm8_act_z rbl_3__t0_act_z sn_0_3__t0_act_z rwl_0__t3_act_z gnd__t7_act_z sky130_fd_pr__nfet_01v8 L=0.15 W=0.42 nf=1 ad=0.1974 as=0.1974 pd=1.78 ps=1.78 mult=1 m=1
xm9_act_z sn_1_0__t1_act_z wl_1__t0_act_z bl_0__t1_act_z gnd__t8_act_z sky130_fd_pr__nfet_01v8 L=0.15 W=0.42 nf=1 ad=0.1974 as=0.1974 pd=1.78 ps=1.78 mult=1 m=1
xm10_act_z rbl_0__t1_act_z sn_1_0__t0_act_z rwl_1__t0_act_z gnd__t9_act_z sky130_fd_pr__nfet_01v8 L=0.15 W=0.42 nf=1 ad=0.1974 as=0.1974 pd=1.78 ps=1.78 mult=1 m=1
xm11_act_z sn_1_1__t1_act_z wl_1__t1_act_z bl_1__t1_act_z gnd__t10_act_z sky130_fd_pr__nfet_01v8 L=0.15 W=0.42 nf=1 ad=0.1974 as=0.1974 pd=1.78 ps=1.78 mult=1 m=1
xm12_act_z rbl_1__t1_act_z sn_1_1__t0_act_z rwl_1__t1_act_z gnd__t11_act_z sky130_fd_pr__nfet_01v8 L=0.15 W=0.42 nf=1 ad=0.1974 as=0.1974 pd=1.78 ps=1.78 mult=1 m=1
xm13_act_z sn_1_2__t1_act_z wl_1__t2_act_z bl_2__t1_act_z gnd__t12_act_z sky130_fd_pr__nfet_01v8 L=0.15 W=0.42 nf=1 ad=0.1974 as=0.1974 pd=1.78 ps=1.78 mult=1 m=1
xm14_act_z rbl_2__t1_act_z sn_1_2__t0_act_z rwl_1__t2_act_z gnd__t13_act_z sky130_fd_pr__nfet_01v8 L=0.15 W=0.42 nf=1 ad=0.1974 as=0.1974 pd=1.78 ps=1.78 mult=1 m=1
xm15_act_z sn_1_3__t1_act_z wl_1__t3_act_z bl_3__t1_act_z gnd__t14_act_z sky130_fd_pr__nfet_01v8 L=0.15 W=0.42 nf=1 ad=0.1974 as=0.1974 pd=1.78 ps=1.78 mult=1 m=1
xm16_act_z rbl_3__t1_act_z sn_1_3__t0_act_z rwl_1__t3_act_z gnd__t15_act_z sky130_fd_pr__nfet_01v8 L=0.15 W=0.42 nf=1 ad=0.1974 as=0.1974 pd=1.78 ps=1.78 mult=1 m=1
xm17_act_z sn_2_0__t1_act_z wl_2__t3_act_z bl_0__t3_act_z gnd__t16_act_z sky130_fd_pr__nfet_01v8 L=0.15 W=0.42 nf=1 ad=0.1974 as=0.1974 pd=1.78 ps=1.78 mult=1 m=1
xm18_act_z rbl_0__t2_act_z sn_2_0__t0_act_z rwl_2__t0_act_z gnd__t17_act_z sky130_fd_pr__nfet_01v8 L=0.15 W=0.42 nf=1 ad=0.1974 as=0.1974 pd=1.78 ps=1.78 mult=1 m=1
xm19_act_z sn_2_1__t1_act_z wl_2__t0_act_z bl_1__t2_act_z gnd__t18_act_z sky130_fd_pr__nfet_01v8 L=0.15 W=0.42 nf=1 ad=0.1974 as=0.1974 pd=1.78 ps=1.78 mult=1 m=1
xm20_act_z rbl_1__t2_act_z sn_2_1__t0_act_z rwl_2__t1_act_z gnd__t19_act_z sky130_fd_pr__nfet_01v8 L=0.15 W=0.42 nf=1 ad=0.1974 as=0.1974 pd=1.78 ps=1.78 mult=1 m=1
xm21_act_z sn_2_2__t1_act_z wl_2__t1_act_z bl_2__t2_act_z gnd__t20_act_z sky130_fd_pr__nfet_01v8 L=0.15 W=0.42 nf=1 ad=0.1974 as=0.1974 pd=1.78 ps=1.78 mult=1 m=1
xm22_act_z rbl_2__t2_act_z sn_2_2__t0_act_z rwl_2__t2_act_z gnd__t21_act_z sky130_fd_pr__nfet_01v8 L=0.15 W=0.42 nf=1 ad=0.1974 as=0.1974 pd=1.78 ps=1.78 mult=1 m=1
xm23_act_z sn_2_3__t1_act_z wl_2__t2_act_z bl_3__t2_act_z gnd__t22_act_z sky130_fd_pr__nfet_01v8 L=0.15 W=0.42 nf=1 ad=0.1974 as=0.1974 pd=1.78 ps=1.78 mult=1 m=1
xm24_act_z rbl_3__t2_act_z sn_2_3__t0_act_z rwl_2__t3_act_z gnd__t23_act_z sky130_fd_pr__nfet_01v8 L=0.15 W=0.42 nf=1 ad=0.1974 as=0.1974 pd=1.78 ps=1.78 mult=1 m=1
xm25_act_z sn_3_0__t1_act_z wl_3__t0_act_z bl_0__t2_act_z gnd__t24_act_z sky130_fd_pr__nfet_01v8 L=0.15 W=0.42 nf=1 ad=0.1974 as=0.1974 pd=1.78 ps=1.78 mult=1 m=1
xm26_act_z rbl_0__t3_act_z sn_3_0__t0_act_z rwl_3__t0_act_z gnd__t25_act_z sky130_fd_pr__nfet_01v8 L=0.15 W=0.42 nf=1 ad=0.1974 as=0.1974 pd=1.78 ps=1.78 mult=1 m=1
xm27_act_z sn_3_1__t1_act_z wl_3__t1_act_z bl_1__t3_act_z gnd__t26_act_z sky130_fd_pr__nfet_01v8 L=0.15 W=0.42 nf=1 ad=0.1974 as=0.1974 pd=1.78 ps=1.78 mult=1 m=1
xm28_act_z rbl_1__t3_act_z sn_3_1__t0_act_z rwl_3__t1_act_z gnd__t27_act_z sky130_fd_pr__nfet_01v8 L=0.15 W=0.42 nf=1 ad=0.1974 as=0.1974 pd=1.78 ps=1.78 mult=1 m=1
xm29_act_z sn_3_2__t1_act_z wl_3__t2_act_z bl_2__t3_act_z gnd__t28_act_z sky130_fd_pr__nfet_01v8 L=0.15 W=0.42 nf=1 ad=0.1974 as=0.1974 pd=1.78 ps=1.78 mult=1 m=1
xm30_act_z rbl_2__t3_act_z sn_3_2__t0_act_z rwl_3__t2_act_z gnd__t29_act_z sky130_fd_pr__nfet_01v8 L=0.15 W=0.42 nf=1 ad=0.1974 as=0.1974 pd=1.78 ps=1.78 mult=1 m=1
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
