2AMLogic/sky130-gcedram/(commit log)

2026-08-20 Initial commit: 2T/3T gain-cell eDRAM macro on SkyWater sky130
    Scaffolds the block: spec, schematics, ngspice sim, and klayout-tools-driven
    layout signoff.
    A new block, not a port. Gain-cell eDRAM is a mature, publicly documented
    topology — two decades of academic literature, buildable on a standard logic
    process with no special DRAM step — but no implementation exists on an open
    PDK. That gap is the repo's reason to exist.
    sky130 first because it is fully supported plain CMOS with shipped device
    models the retention study can run against directly. The block is dynamic by
    nature, so the retention/refresh budget is the spec's centerpiece: every
    retention claim carries its evidence chain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
2026-08-20 feat: add sky130 access-device off-state leakage testbench (#6)
    Sweeps sky130_fd_pr__nfet_01v8 (candidate 2T/3T gain-cell access
    device) off-state leakage across the 5 shipped MOS process corners and
    the -40/27/125 C temperature range, using only the shipped open_pdks
    sky130 model library. Records raw results and identifies sf/125C as
    the worst-case leakage corner for the retention derivation in #3.
    [leakage_results.csv]
2026-08-20 feat: derive retention-time estimates for 2T/3T gain-cell geometries (#8)
    * feat: derive retention-time estimates for 2T/3T gain-cell geometries
    Adds sim/retention/, the second and third links in the retention/refresh
    evidence chain: derive_retention.py combines the measured worst-case
    access-device leakage from sim/leakage/ (issue #2) with an explicitly
    labelled storage-node capacitance ASSUMPTION to compute retention-time
    estimates for a 2T-min and a 3T-min candidate gain-cell geometry, at the
    worst-case (sf, 125C) corner. The gate-oxide capacitance term is computed
    (not assumed) from toxe/epsrox in the shipped sky130 model card; only the
    total storage-node margin and the sense margin are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
    [retention_results.csv]
2026-08-20 docs: cross-check sky130 gain-cell retention numbers against literature (#9)
    Adds spec/retention-literature-crosscheck.md, comparing this repo's
    pre-layout 2T-min/3T-min retention estimates (sim/retention/, issue #3)
    against three IEEE-published, silicon-measured gain-cell results (65nm
    2T, 16nm 3T, 28nm 4T-IFGC), verified via Crossref/OpenAlex public
    bibliographic APIs. Flags the ~4-11x divergence explicitly and labels
    each candidate explanation (storage-node capacitance assumption,
    worst-case corner choice, device sizing, sense-margin definition) as a
    hypothesis, not a settled finding.
2026-08-21 docs: ratify retention/refresh budget and 2T bitcell topology decision (#10)
    Assembles the full evidence chain (device leakage -> capacitance
    assumption -> retention derivation -> literature cross-check) into a
    spec/ decision record: ratifies ~10.06 us worst-case retention time,
    decides 2T as the baseline bitcell topology (retention evidence is
    topology-neutral once the pre-layout capacitance-margin assumption is
    discounted; density decides it), and states the refresh budget as a
    bandwidth-overhead formula with a ~5.03 us worst-case refresh interval.
    Updates README's target-specification table to match.
    Closes #5
2026-08-21 refactor: consolidate duplicated evidence-chain helpers into sim/_evidence_common.py (#12)
    resolve_pdk_root(), repo_git_sha(), and append_result() were byte-identical
    (or near-identical) between sim/leakage/run_leakage_sweep.py and
    sim/retention/derive_retention.py. Extract them into a shared stdlib-only
    sim/_evidence_common.py so a future fix to the append-only guarantee, the
    PDK-root resolution, or the git-sha provenance stamp applies to both links
    of the retention evidence chain at once instead of silently drifting.
    Closes #11
2026-08-24 design: capture 2T gain-cell bitcell schematic + derived netlist (#17)
    First design-sources increment (T1 item 1 of the #13 gap tracker): an
    xschem schematic for the ratified 2T (`2T-min`, spec/retention-refresh-budget.md
    Sec.6) gain-cell bitcell, with its SPICE netlist mechanically derived via
    xschem's own netlister (design/regen_netlist.sh), not hand-written.
    - design/gain_cell_2t.sch: M_WR (write-access) + M_RD (read), both
    sky130_fd_pr__nfet_01v8. M_WR reuses the exact W=0.42um/L=0.15um geometry
    already measured in sim/leakage/tb_access_leakage.spice.tmpl. Node names
    (wl, sn, bl) match sim/leakage/README.md's bias-condition table so
    downstream testbenches can reference the same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
    [gain_cell_2t.sch]
2026-08-25 layout: capture sky130 2T gain-cell bitcell geometry (issue #15, T1 item 2) (#18)
    Builds the ratified 2T-min bitcell layout from design/gain_cell_2t.spice's
    topology (issue #14) entirely via klayout-tools: klt gen mos_array for the
    two nfet_01v8 devices, klt gen guard_ring (add_well=false) for a
    P-substrate tap so the extracted NMOS body resolves to a real GND net, and
    klt gen-compose to place/route/label the composed cell. layout/generate.sh
    regenerates every artifact from these committed inputs; --check reruns into
    a scratch dir and asserts DRC-clean + LVS-match without touching the
    committed files. Informal klt drc/extract/lvs iteration confirms the
    composed layout is DRC-clean and LVS-ma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
2026-08-25 feat(retention): extract post-layout storage-node parasitics for 2T-min (#19)
    Runs `klt extract --parasitics --critical-net sn` against the committed
    2T-min bitcell layout and replaces derive_retention.py's MARGIN_FACTORS
    ASSUMPTION for C_SN with the extracted value (ground + lateral coupling
    to bl/rwl) for 2T-min, keeping 3T-min on the assumption path since no 3T
    layout exists. Appends the re-derived retention numbers to
    retention_results.csv without touching prior rows, and updates
    sim/retention/README.md and layout/README.md's evidence-chain
    documentation accordingly.
    Closes #7
    [retention_results.csv]
2026-09-05 docs: add Chipalooza Challenge #4 (Sky130) proposal document (#25)
    Adds docs/chipalooza/challenge-4-proposal.md for #20 (Epic 2AMLogic/2am#542,
    Phase 4B): block type, I/O mapped honestly against the assumed slot budget
    (1.8V/3.3V rail reconciliation included), functional description, and a
    spec table with every row re-derived from what sim/ and layout/ actually
    contain -- including the one row that is genuinely met (single-cell
    retention time, fully evidenced per spec/retention-refresh-budget.md) and
    every other row honestly stated unmet (macro-level PVT sim, formal DRC/LVS,
    refresh-bandwidth percentage, density-vs-SRAM) rather than fabricated.
    This repo does not yet have an array, sense am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
2026-09-05 feat(champion): standing authorization for design-evidence auto-merge (#6850)
    Operator ruling 2026-09-05: Judge-approved, green-CI PRs whose entire
    changed-file set lives in design/, sim/, layout/, measurements/,
    verification/, or docs/ auto-merge without the four-axis human hold.
    Rationale: canary design evidence is fully revertible with no fleet-infra
    blast radius, and the held-PR pattern (sky130-sar-adc#123 sat mergeable for
    days as the sole blocker of a layout chain) costs more than it protects
    here. spec/ and every tool surface fall outside the patterns, so the
    exact-subset rule keeps them on the four-axis judgment automatically.
    C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
2026-09-10 T1 items 5/9: transient write/read/hold PVT testbench for the 2T-min bitcell (#28)
    * sim: add 2T-min bitcell transient write/read/hold testbench and driver
    * sim: correct write-margin note wording and round pulse-timing columns
    * sim: commit the 2T-min bitcell transient PVT records
    Append-only evidence for sim/bitcell-transient/ (issue #27), produced by
    run_bitcell_transient.py against ngspice-46 and open_pdks
    c6d73a35f524070e85faff4a6a9eef49553ebc2b:
    - 30 rows: the primary sweep, tt/ss/ff/sf/fs x -40/27/125 C x stored
    {0,1}, with the extracted C_SN = 0.605354 fF from
    layout/gain_cell_2t.extract.parasitics.json (issue #7).
    - 18 rows: the --c-sn-ff 0 edge case (intrinsic device-model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
    [bitcell_transient_results.csv]
2026-09-12 docs: refresh stale README status and maturity-ladder position (#30)
    The Status paragraph claimed "No schematics or layout exist yet" and that
    "bitcell + array simulation is the next work"; the maturity ladder's
    current position said the same. Both predate work that has since landed:
    - design/gain_cell_2t.sch + derived design/gain_cell_2t.spice (#17)
    - layout/gain_cell_2t.gds with DRC status "clean" (0 violations) and LVS
    status "match" (#18)
    - sim/bitcell-transient/ — write/read/hold transient over a 15-corner PVT
    grid (#28)
    Status now states what is actually committed, keeps the DRC/LVS pass
    labelled as an informal pass against klayout-tools' unreleased sky130 deck
    (consistent with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
2026-09-15 layout: build a shared-tap 4x4 bitcell array from the ratified 2T-min cell (#36)
    Replicates the ratified 2T-min bitcell (design/gain_cell_2t.sch/.spice,
    issue #14) into a 4x4 shared-tap array via one klt gen mos_array block
    (add_guard_ring=true) sized for all 32 transistors, wired by
    array_topology.py + klt gen-compose: per-row wl/rwl buses, per-column
    bl/rbl buses, per-cell sn nets left unpromoted (matching the single-cell
    convention). generate_array.sh mirrors generate.sh's 4-step pattern and
    regenerates every artifact, including a GENERATED (not hand-transcribed)
    array-level LVS reference netlist from array_topology.py.
    klt drc --deck sky130: clean, 0 violations.
    klt lvs: match, 32/32 de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
2026-09-15 Consolidate duplicated sky130 PDK pin config (#37) (#38)
    Collapses the sky130 PDK pin (open_pdks commit / variant / default
    PDK_ROOT), previously hand-duplicated across seven independent
    locations, down to the practical minimum given Python/shell/Tcl can't
    share one constant file directly:
    - Delete design/pdk.json, sim/leakage/pdk.json, and
    sim/bitcell-transient/pdk.json -- confirmed unread by any script,
    and stale documentation the moment the canonical value changes.
    Their rationale (why the pin must match across design/, leakage,
    and bitcell-transient) is folded into new docs/pdk-pin.md.
    - sim/_evidence_common.py's PDK_OPEN_PDKS_COMMIT stays the canonical,
    code-consumed Python v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
2026-09-21 layout: add klt erc supply spec and report for the array (issue #39, T1 item 11) (#42)
    Commit the structural power-delivery (T1 item 11) evidence for
    layout/gain_cell_2t_array.gds:
    - layout/erc-supply-spec.json -- the supply spec: gate poly/li1/met1
    stackup with a physical poly-intersect-diff gate-area denominator
    (active_layer 65/20), licon1/mcon vias, and the one supply net GND
    (the array's only rail: the substrate/bulk, tapped by the shared
    mos_array guard ring). The inline _comment justifies each stackup
    entry, both label_layers, and the deliberate no-ties[] gap (sky130
    psub is not a drawn layer and this all-NMOS stream has no nwell;
    klayout-tools#2169 records the false er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
2026-10-01 chore: resync installed Loom surfaces
    resynced_by: fleet-resync
    invocation: fleet-resync.sh --fleet-only --push
    <!-- loom:provenance v1 build=unknown 19f4e67fd0a0afbd3d8b6606ca91ceac911377a3 clean prompts=none sweep=none story=none trace=78a5dfbdfd8c530aecd1bb436fd096df host=loom-worker-2 base=77eee5cff6744eca33531817ea6a63684f163e5d run=loom-run/v1:timer:loom-worker-2/fleet-resync:67c759f7ef3c43e38d3fa8d5f19a2dd1 installs=0.19.593 658650a4f0eff932ac66a8f690eaedf8123fc83b -->
    Loom-Story: none
    Loom-Trace-Id: 78a5dfbdfd8c530aecd1bb436fd096df
    Loom-Build: unknown 19f4e67fd0a0afbd3d8b6606ca91ceac911377a3 clean
2026-10-01 chore: resync installed Loom surfaces
    <!-- loom:provenance v1 build=unknown 56435bf476452911283e43940ecfd9a30f804af9 clean prompts=none sweep=none story=none trace=342405c5ebc99bdbf17afbd983c0c41c host=loom-worker-2 base=71c3d1cde8659062f269789d593511dd644a6806 run=loom-run/v1:timer:loom-worker-2/fleet-resync:20c09f231d424cd5b57ca7991848dd8a installs=0.19.603 8c39bf7cde8a8c03d1aaee441f397c017b6a3a9e -->
    Loom-Trace-Id: 342405c5ebc99bdbf17afbd983c0c41c
    Loom-Build: unknown 56435bf476452911283e43940ecfd9a30f804af9 clean
    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
2026-10-01 chore: resync installed Loom surfaces
    <!-- loom:provenance v1 build=unknown f2868e6b4d60d11a8ab47d25cad9e248229d2f66 clean prompts=none sweep=none story=none trace=4e2766ed5160781df891476246a9be2e host=robb-studio base=d802774ecc47a6a25bf6fdcfb4e2ae21c5b3c0b6 run=loom-run/v1:timer:robb-studio/fleet-resync:2d3851d5-1673-43ae-bcc6-e5c971b37f33 installs=0.19.603 74778a6aeea5d9e06b489400942b35f33c8bb766 -->
    Loom-Trace-Id: 4e2766ed5160781df891476246a9be2e
    Loom-Build: unknown f2868e6b4d60d11a8ab47d25cad9e248229d2f66 clean
    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
2026-10-01 chore: resync installed Loom surfaces
    <!-- loom:provenance v1 build=unknown d6714830391f7596338b8de40ee2d0f45dcd12f5 clean prompts=none sweep=none story=none trace=af273f717e759e690d07f372734e9278 host=robb-pro base=2d74df35962990c3df82c29ca389ab0be56ff587 run=loom-run/v1:timer:robb-pro/fleet-resync:92e2f9ba-d083-411b-833b-ae52d169ef04 installs=0.19.605 6eb2b65a4496b7becb84ef1f944493a541fd01cd -->
    Loom-Trace-Id: af273f717e759e690d07f372734e9278
    Loom-Build: unknown d6714830391f7596338b8de40ee2d0f45dcd12f5 clean
    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
2026-10-01 chore: resync installed Loom surfaces
    <!-- loom:provenance v1 build=unknown e956e9fee69e53f08b887ca20e14d9058d6f9aee clean prompts=none sweep=none story=none trace=1077dafeb758858c149dd37f4ece3c77 host=loom-worker-2 base=133112ea018dc1117b2568298415d04dd50fdb45 run=loom-run/v1:timer:loom-worker-2/fleet-resync:e3773167b12d4b3aafa1f76848245174 installs=0.19.609 ff30576dacc8c2734b1c7434bedd29c47122caeb -->
    Loom-Trace-Id: 1077dafeb758858c149dd37f4ece3c77
    Loom-Build: unknown e956e9fee69e53f08b887ca20e14d9058d6f9aee clean
    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
2026-10-01 chore: resync installed Loom surfaces
    <!-- loom:provenance v1 build=unknown 617257919edc1b9b9ee27532c5ec1b8a64523388 clean prompts=none sweep=none story=none trace=dbafe4f8526617aa07c890721298a080 host=robb-studio base=9245fea815262f3cecd4c0a0eb0381ab5fd253fb run=loom-run/v1:timer:robb-studio/fleet-resync:1817df66-02cc-4b27-927d-a38485da550a installs=0.19.610 c94891dd526cf6db5ee02045424c6913be522048 -->
    Loom-Trace-Id: dbafe4f8526617aa07c890721298a080
    Loom-Build: unknown 617257919edc1b9b9ee27532c5ec1b8a64523388 clean
    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
2026-10-01 chore: resync installed Loom surfaces
    <!-- loom:provenance v1 build=unknown a2a39ac2736eb2686e2c65412d939e67c0438a7d clean prompts=none sweep=none story=none trace=fc1a121767151aae5bd7427c683b7db6 host=robb-pro base=cc974f24feb37cb157be955fb54112e632047a76 run=loom-run/v1:timer:robb-pro/fleet-resync:708eb7c8-469d-4783-80b7-bafe142df3c4 installs=0.19.612 d25614656adcf70162da95c5e1035e99a0639a1a -->
    Loom-Trace-Id: fc1a121767151aae5bd7427c683b7db6
    Loom-Build: unknown a2a39ac2736eb2686e2c65412d939e67c0438a7d clean
    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
2026-10-01 chore: resync installed Loom surfaces
    <!-- loom:provenance v1 build=unknown 126c80914e42f913c4fc778d3ddce96daa2c7a77 clean prompts=none sweep=none story=none trace=15a20fbea7a00d0922b943088c80e19d host=loom-worker-1 base=08d4a4ea976a9830bfd6e96b4a71a3778793d337 run=loom-run/v1:script:loom-worker-1/fleet-resync:ecc423da-4625-49de-b25a-692fd669a029 installs=0.19.612 53aeb18c5541af6b068247d82f62daed412cc2c6 -->
    Loom-Trace-Id: 15a20fbea7a00d0922b943088c80e19d
    Loom-Build: unknown 126c80914e42f913c4fc778d3ddce96daa2c7a77 clean
    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
2026-10-01 chore: resync installed Loom surfaces
    <!-- loom:provenance v1 build=unknown 126c80914e42f913c4fc778d3ddce96daa2c7a77 clean prompts=none sweep=none story=none trace=a0a42bd10fcfa6d7cbcc9c021c406848 host=loom-worker-2 base=a7c821f2a3c12ad0b5e1c2f398159055efc8aa2d run=loom-run/v1:timer:loom-worker-2/fleet-resync:9e174e6bb0fa41d786e4a86e45632b6f installs=0.19.612 6f0871dc66e62b36d8382ced980d2805bfd97e50 -->
    Loom-Trace-Id: a0a42bd10fcfa6d7cbcc9c021c406848
    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
2026-10-01 chore: resync installed Loom surfaces
    <!-- loom:provenance v1 build=unknown 8891f74a5d568fe3d13937ef37fd64371dd2738f clean prompts=none sweep=none story=none trace=1e216ea76cbd2b72542049c4c18c2817 host=loom-worker-1 base=721219d4f83dbf944d27164c8dd8aadf72f24b91 run=loom-run/v1:timer:loom-worker-1/fleet-resync:679feba6c0f347d39eb5943ed77dc87b installs=0.19.612 62fa67f8756bdf59fdf744be053e5ef1709f1335 -->
    Loom-Trace-Id: 1e216ea76cbd2b72542049c4c18c2817
    Loom-Build: unknown 8891f74a5d568fe3d13937ef37fd64371dd2738f clean
    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
2026-10-01 chore: resync installed Loom surfaces
    <!-- loom:provenance v1 build=unknown 6f3411c8a63e68097dde01bce8a8422230f54218 clean prompts=none sweep=none story=none trace=9aa0a46bb352b9665fdaa5f5b3b85dd7 host=robb-pro base=c4fa8b8719bb98f67bb5f0a656ac1b27ab280c75 run=loom-run/v1:timer:robb-pro/fleet-resync:ca419e1d-6646-4678-ac7a-b263e4b5119e installs=0.19.612 7731400b3e3e1df39074564166edf656feb0999c -->
    Loom-Trace-Id: 9aa0a46bb352b9665fdaa5f5b3b85dd7
    Loom-Build: unknown 6f3411c8a63e68097dde01bce8a8422230f54218 clean
    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
2026-10-02 chore: resync installed Loom surfaces
    <!-- loom:provenance v1 build=unknown 13c0a3ef467a888520a6529ab34486ab8be826be clean prompts=none sweep=none story=none trace=41356080f367e491d5ff03f17bb98c27 host=loom-worker-2 base=06c93641ef6888a6946442f30f8a902528c0d7d4 run=loom-run/v1:timer:loom-worker-2/fleet-resync:44455fbcbab745abb92cea192fafbb1d installs=0.19.614 3c79f7b1d0cc14723e049cff4250ff7330804326 -->
    Loom-Trace-Id: 41356080f367e491d5ff03f17bb98c27
    Loom-Build: unknown 13c0a3ef467a888520a6529ab34486ab8be826be clean
    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
2026-10-02 chore: resync installed Loom surfaces
    <!-- loom:provenance v1 build=unknown ea2dd21f2ba310ec007d047ddfecc6cd27d220ac clean prompts=none sweep=none story=none trace=f04a67f3922788d2ccdd66578c8d18f9 host=loom-worker-1 base=aa0c8b75f1ca7c21d0cfeaada1e546deed874199 run=loom-run/v1:timer:loom-worker-1/fleet-resync:1c3b601dd998488595adc09040c007d4 installs=0.19.614 79f4897c5d3c78dbfc1b022f77d244838dbf4ccb -->
    Loom-Trace-Id: f04a67f3922788d2ccdd66578c8d18f9
    Loom-Build: unknown ea2dd21f2ba310ec007d047ddfecc6cd27d220ac clean
    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
2026-10-02 chore: resync installed Loom surfaces
    <!-- loom:provenance v1 build=unknown 6f3411c8a63e68097dde01bce8a8422230f54218 clean prompts=none sweep=none story=none trace=acb28d0049e0cc75536f96d503f6e814 host=robb-studio base=04ec33ff608c20b783aab3958a3e547be706c69e run=loom-run/v1:timer:robb-studio/fleet-resync:85d2b1b5-e81d-40c3-ab6a-9a00efbc4ee2 installs=0.19.616 d86523eeadb32b95777f3cd3a76dd2f72f0bf792 -->
    Loom-Trace-Id: acb28d0049e0cc75536f96d503f6e814
    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
2026-10-02 chore: resync installed Loom surfaces
    <!-- loom:provenance v1 build=unknown 2b50bd69eddd038dd738465aa58a9ebca11410ac clean prompts=none sweep=none story=none trace=324e4f607054d0396cfdf8fdc01e93ae host=robb-pro base=ad559e2f62c116303564fc95d127a14f15c87758 run=loom-run/v1:timer:robb-pro/fleet-resync:a63799f1-2ad7-4946-b81d-2ec231bc2d2f installs=0.19.617 81cb2ad7e091b19d6a2b95d1add6938c2100d46b -->
    Loom-Trace-Id: 324e4f607054d0396cfdf8fdc01e93ae
    Loom-Build: unknown 2b50bd69eddd038dd738465aa58a9ebca11410ac clean
    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
2026-10-02 chore: resync installed Loom surfaces
    <!-- loom:provenance v1 build=unknown 00d92b326aed50280cd90dc116b7caec27668251 clean prompts=none sweep=none story=none trace=9a5d23cc82b6d3a1c83bfee47bd04970 host=loom-worker-2 base=157cff883e083eb416d0a536e605926c5c60872c run=loom-run/v1:timer:loom-worker-2/fleet-resync:12136a7a025d49f3a60b5edb04a3ff81 installs=0.19.619 4c0f505e4f0b76f8ccec07bda6d8b839030c077b -->
    Loom-Trace-Id: 9a5d23cc82b6d3a1c83bfee47bd04970
    Loom-Build: unknown 00d92b326aed50280cd90dc116b7caec27668251 clean
    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
2026-10-02 chore: resync installed Loom surfaces
    <!-- loom:provenance v1 build=unknown 456dad6d90259846313dc3bb80bf4e5471ef2d76 clean prompts=none sweep=none story=none trace=bb9688c03fb5211d06f48c8838a5505c host=robb-studio base=02224d2655ea681abd480892f9d90a8b69ce4b73 run=loom-run/v1:timer:robb-studio/fleet-resync:e965c017-8ec7-485d-b46e-aeb399b81fb4 installs=0.19.620 0d28ba49f5a88fdb37271de9cb0144eb3442c6e3 -->
    Loom-Trace-Id: bb9688c03fb5211d06f48c8838a5505c
    Loom-Build: unknown 456dad6d90259846313dc3bb80bf4e5471ef2d76 clean
    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
2026-10-02 chore: resync installed Loom surfaces
    <!-- loom:provenance v1 build=unknown 6c6d2b6565dc13eff4c6811b9c670f452106516b clean prompts=none sweep=none story=none trace=539be979ae694d66ede516a7b5d17e41 host=robb-pro base=2c0abc1ce3e6d9d03606382ea897519887308f63 run=loom-run/v1:timer:robb-pro/fleet-resync:9444d216-de08-442f-8352-ba59f6e81bb3 installs=0.19.621 a90dc1d794eb9ff70aaf939ebf495abe716f3bdd -->
    Loom-Trace-Id: 539be979ae694d66ede516a7b5d17e41
    Loom-Build: unknown 6c6d2b6565dc13eff4c6811b9c670f452106516b clean
    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
2026-10-02 chore: resync installed Loom surfaces
    <!-- loom:provenance v1 build=unknown f6d28134bfe476967e005d97424073085f55e8a3 clean prompts=none sweep=none story=none trace=27eb90670d441065f593e941066ee005 host=loom-worker-2 base=0d455cdee625727b80d0815efce53942811e1188 run=loom-run/v1:timer:loom-worker-2/fleet-resync:04001bba930241cf9e325bf304a9270a installs=0.19.623 ccc19c2bbe2aa65328427730fa53f70eb56128c6 -->
    Loom-Trace-Id: 27eb90670d441065f593e941066ee005
    Loom-Build: unknown f6d28134bfe476967e005d97424073085f55e8a3 clean
    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
2026-10-02 chore: resync installed Loom surfaces
    <!-- loom:provenance v1 build=unknown bc461736314499b6c2c4c0ad51fb2294f60336f5 clean prompts=none sweep=none story=none trace=c3ea68717dd3a908dbbd60a35bc8b5d6 host=robb-studio base=c2f0f8dd4dc2be6a8886bafcb6506815315aae72 run=loom-run/v1:timer:robb-studio/fleet-resync:8d4c49e2-3258-4080-b0c8-082499053654 installs=0.19.623 a50aaf70069f8897c41a64b7d90783c5ab8294e0 -->
    Loom-Trace-Id: c3ea68717dd3a908dbbd60a35bc8b5d6
    Loom-Build: unknown bc461736314499b6c2c4c0ad51fb2294f60336f5 clean
    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
2026-10-02 chore: resync installed Loom surfaces
    <!-- loom:provenance v1 build=unknown bc461736314499b6c2c4c0ad51fb2294f60336f5 clean prompts=none sweep=none story=none trace=8bee8a664bfc89e0bbfbb3c2de7342ba host=loom-worker-2 base=5782af1fc9f7138e034d5f67fe640e9120983fb0 run=loom-run/v1:timer:loom-worker-2/fleet-resync:de2ceceb48ea4927a1334d08dc0082fe installs=0.19.624 5f49564fa78ae06f8c48d5224dae9ded04200bb7 -->
    Loom-Trace-Id: 8bee8a664bfc89e0bbfbb3c2de7342ba
    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
2026-10-03 chore: resync installed Loom surfaces
    <!-- loom:provenance v1 build=unknown 752d316233ed1a3da9e4f69ad760eb99bb477747 clean prompts=none sweep=none story=none trace=7851839b67c00a023e97cbdea1f580e1 host=robb-pro base=b042dc65382e9bb74b9fe72ceb134ff744adc16e run=loom-run/v1:timer:robb-pro/fleet-resync:ae492b66-dca0-4da4-acab-8d26778f2d5c installs=0.19.624 121fac45f5006879bf58a18c951b9243d9099a18 -->
    Loom-Trace-Id: 7851839b67c00a023e97cbdea1f580e1
    Loom-Build: unknown 752d316233ed1a3da9e4f69ad760eb99bb477747 clean
    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
2026-10-03 chore: resync installed Loom surfaces
    <!-- loom:provenance v1 build=unknown b34a08286a42f47f917ec46647d4d167c1f5207c clean prompts=none sweep=none story=none trace=a8e453124b899b440f42c9d83837c7b6 host=loom-worker-2 base=f86b021131826df12b04386643e6afd2ccffc8ad run=loom-run/v1:timer:loom-worker-2/fleet-resync:f02dd5df715347fe90fe14b9353a1b66 installs=0.19.624 0162badc662fb30c070e70611aa8ff74a8486d54 -->
    Loom-Trace-Id: a8e453124b899b440f42c9d83837c7b6
    Loom-Build: unknown b34a08286a42f47f917ec46647d4d167c1f5207c clean
    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
2026-10-03 chore: resync installed Loom surfaces
    <!-- loom:provenance v1 build=unknown 3437cece5ab759f772122f8d18a6d2f05d246cde clean prompts=none sweep=none story=none trace=bba21427f750636f851279cfae92b4e5 host=loom-worker-1 base=5109a693d4a00b05bb6bdc623ced8ec276485ad0 run=loom-run/v1:timer:loom-worker-1/fleet-resync:9440cda9476f404caa282e360a81ee03 installs=0.19.636 e41edfbb52c13982f7d8b0577f42957427a6514c -->
    Loom-Trace-Id: bba21427f750636f851279cfae92b4e5
    Loom-Build: unknown 3437cece5ab759f772122f8d18a6d2f05d246cde clean
    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
2026-10-03 chore: resync installed Loom surfaces
    <!-- loom:provenance v1 build=unknown 28040ed11a4369e20f3b7b0154a3fb2a2c35d38c clean prompts=none sweep=none story=none trace=0cd87d01c45d97a2ee57a99363fc0db2 host=robb-studio base=54dbb4a149443c267658cd0f21de02b292606b8b run=loom-run/v1:timer:robb-studio/fleet-resync:74b93657-6b04-4ac5-bc77-e0a1682b0595 installs=0.19.636 e41edfbb52c13982f7d8b0577f42957427a6514c -->
    Loom-Trace-Id: 0cd87d01c45d97a2ee57a99363fc0db2
    Loom-Build: unknown 28040ed11a4369e20f3b7b0154a3fb2a2c35d38c clean
    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
2026-10-03 chore: resync installed Loom surfaces
    <!-- loom:provenance v1 build=unknown 388c7fe0cad997f7a887f70c9f2cfe8781a2d512 clean prompts=none sweep=none story=none trace=2046ffd42f138a06b914f34851de3440 host=loom-worker-2 base=b749fdc5f964ff87a3c94216a4b9b21ac5cb43ef run=loom-run/v1:timer:loom-worker-2/fleet-resync:17c9456bb1934c70a545b12081496cce installs=0.19.647 d1fe5dead4202be12a964ab891fd5980e7836170 -->
    Loom-Trace-Id: 2046ffd42f138a06b914f34851de3440
    Loom-Build: unknown 388c7fe0cad997f7a887f70c9f2cfe8781a2d512 clean
    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
2026-10-03 chore: resync installed Loom surfaces
    <!-- loom:provenance v1 build=unknown 8078c29e691123d91cd761a786f99cfd25f1809d clean prompts=none sweep=none story=none trace=45869a6374635c036a11a6f379fe31a4 host=robb-pro base=a5b749a01da1f16f221ac23c85a1c5633fb8a46d run=loom-run/v1:timer:robb-pro/fleet-resync:b0a94991-052d-4e7d-ba2b-78b971096849 installs=0.19.647 709ca4396e074e5a4d1c5e19721f6ddac7154ca2 -->
    Loom-Trace-Id: 45869a6374635c036a11a6f379fe31a4
    Loom-Build: unknown 8078c29e691123d91cd761a786f99cfd25f1809d clean
    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
2026-10-03 chore: resync installed Loom surfaces
    <!-- loom:provenance v1 build=unknown f9cba29b0602624a23daa17ae04d31d82e10fa91 clean prompts=none sweep=none story=none trace=754b3688f97b6c34894d8cfbf272b81a host=loom-worker-1 base=a1fc98ccf400d211e28a46489dc2a45d6388964b run=loom-run/v1:script:loom-worker-1/fleet-resync:11eb117a-9ff3-4411-88d4-fdd7d6748639 installs=0.19.649 6f2f13b1c31ce420e2250ae040d8e1050c0e761b -->
    Loom-Trace-Id: 754b3688f97b6c34894d8cfbf272b81a
    Loom-Build: unknown f9cba29b0602624a23daa17ae04d31d82e10fa91 clean
    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
2026-10-03 chore: resync installed Loom surfaces
    <!-- loom:provenance v1 build=unknown f9cba29b0602624a23daa17ae04d31d82e10fa91 clean prompts=none sweep=none story=none trace=544a028e3829d4020b8aaa144e5fa628 host=robb-studio base=625808af03d7ccbbfce6950b947915638e27a81c run=loom-run/v1:script:robb-studio/fleet-resync:5b5b8b83-7139-447d-88bd-417dcf375aa6 installs=0.19.649 6f2f13b1c31ce420e2250ae040d8e1050c0e761b -->
    Loom-Trace-Id: 544a028e3829d4020b8aaa144e5fa628
    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
2026-10-03 chore: resync installed Loom surfaces
    <!-- loom:provenance v1 build=unknown f9cba29b0602624a23daa17ae04d31d82e10fa91 clean prompts=none sweep=none story=none trace=1057aaaf811f6dd2d64a3bb6d4b3ac49 host=robb-pro base=8ae66ca449d161f17a67e24583ef1f89a51213d8 run=loom-run/v1:timer:robb-pro/fleet-resync:785c1ea0-d7f2-4810-99e9-cd9368aebe0c installs=0.19.649 2118aabb5a925f1ec4669b4d3d31176a46d8f2a6 -->
    Loom-Trace-Id: 1057aaaf811f6dd2d64a3bb6d4b3ac49
    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
2026-10-03 chore: resync installed Loom surfaces
    <!-- loom:provenance v1 build=unknown 72f61d9aa0fe08f1ef59f1a97a314e474455801e clean prompts=none sweep=none story=none trace=90666a75095c62a013be2ea121ab93f1 host=loom-worker-2 base=2c5422e3f2e3ee19beada2d06712c4f6b8210a61 run=loom-run/v1:script:loom-worker-2/fleet-resync:13865fad-1cac-4838-857f-34878fcba5d1 installs=0.19.652 235a64727b907d65529151af0a962b14f16462a0 -->
    Loom-Trace-Id: 90666a75095c62a013be2ea121ab93f1
    Loom-Build: unknown 72f61d9aa0fe08f1ef59f1a97a314e474455801e clean
    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
2026-10-03 chore: resync installed Loom surfaces
    <!-- loom:provenance v1 build=unknown 72f61d9aa0fe08f1ef59f1a97a314e474455801e clean prompts=none sweep=none story=none trace=845aaa0eb340f80f12095e2e8b421ed1 host=robb-pro base=4c30ac8ae4430ff31460d0d3659d4543d9fcf5b3 run=loom-run/v1:script:robb-pro/fleet-resync:344add4b-df8a-49e8-8563-2765673acc76 installs=0.19.652 235a64727b907d65529151af0a962b14f16462a0 -->
    Loom-Trace-Id: 845aaa0eb340f80f12095e2e8b421ed1
    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
2026-10-03 chore: resync installed Loom surfaces
    <!-- loom:provenance v1 build=unknown 21130104346fe9c464ce8a3fdf82c1d3e9667639 clean prompts=none sweep=none story=none trace=36308fff5a3c323c3d1bf6fffb6cd122 host=robb-studio base=209282ecba609cf3dd05b1e5cdcfe1bc10c1fc69 run=loom-run/v1:timer:robb-studio/fleet-resync:89972fbd-0774-4402-bbb7-26c33a851735 installs=0.19.652 fb69233bd8f1dfc2bdee37d8b934f99274dc0193 -->
    Loom-Trace-Id: 36308fff5a3c323c3d1bf6fffb6cd122
    Loom-Build: unknown 21130104346fe9c464ce8a3fdf82c1d3e9667639 clean
    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
2026-10-04 chore: resync installed Loom surfaces
    <!-- loom:provenance v1 build=unknown 61870b40779d205c1555e801c6e1d95df083cdea clean prompts=none sweep=none story=none trace=fb9213e215442932d2af05f3b14977de host=robb-pro base=b15d737d7353f28c61e8a4cf9beeed68adda5bb2 run=loom-run/v1:timer:robb-pro/fleet-resync:4c70cd1d-08cd-4add-8e2a-9a75160d163f installs=0.19.655 36c39e3c6f56e1979647ec235b4bd19c77db22f3 -->
    Loom-Trace-Id: fb9213e215442932d2af05f3b14977de
    Loom-Build: unknown 61870b40779d205c1555e801c6e1d95df083cdea clean
    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
2026-10-04 chore: resync installed Loom surfaces
    <!-- loom:provenance v1 build=unknown 61870b40779d205c1555e801c6e1d95df083cdea clean prompts=none sweep=none story=none trace=baa6c2cfcae1a320917c00ff2eb8b630 host=loom-worker-2 base=501e94e9b7296393c2a4b591ec1b8acb23421e5a run=loom-run/v1:timer:loom-worker-2/fleet-resync:741a7f0f16df4fb1be4e657aeacd1244 installs=0.19.655 fc667a4faae1227f8a6837431f8a0c2d0aeaa7dd -->
    Loom-Trace-Id: baa6c2cfcae1a320917c00ff2eb8b630
    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
2026-10-04 chore: resync installed Loom surfaces
    <!-- loom:provenance v1 build=unknown b922acb2ac655cbccd71daa9e3f05a325a094ca5 clean prompts=none sweep=none story=none trace=833eeb34d4ca65c3f8c6f7824ddca3a3 host=robb-studio base=56876e8dd958be3f956463b763ca073de2481976 run=loom-run/v1:timer:robb-studio/fleet-resync:0d44f6dc-6a62-4d43-b49d-7cfdd7dbd823 installs=0.19.663 0a51e373e7fe1be156c5774b2c827d4b745368a3 -->
    Loom-Trace-Id: 833eeb34d4ca65c3f8c6f7824ddca3a3
    Loom-Build: unknown b922acb2ac655cbccd71daa9e3f05a325a094ca5 clean
    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
2026-10-04 chore: resync installed Loom surfaces
    <!-- loom:provenance v1 build=unknown 746ecb5f9d7e64ba1d2526f1e997530ad4f3dd43 clean prompts=none sweep=none story=none trace=f09501431241df2ec5688e334ba43dfe host=loom-worker-2 base=96cfee4e394ffbbd4011957140a0769ac1d52b93 run=loom-run/v1:timer:loom-worker-2/fleet-resync:70797dad61fb4e21806716d54f1ce910 installs=0.19.669 59a1f84e3742827a8033bb153ebbedc1759bee72 -->
    Loom-Trace-Id: f09501431241df2ec5688e334ba43dfe
    Loom-Build: unknown 746ecb5f9d7e64ba1d2526f1e997530ad4f3dd43 clean
    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
2026-10-04 chore: resync installed Loom surfaces
    <!-- loom:provenance v1 build=unknown 8080d0485cc1312129ee642b084944c56d1be074 clean prompts=none sweep=none story=none trace=ed180bcab6828041123ad54d8ddb4037 host=robb-pro base=4db148312abe993d6d42e165132403fa954a7e13 run=loom-run/v1:timer:robb-pro/fleet-resync:e97b2f08-4ad9-4b66-a166-5b19820e2d1f installs=0.19.669 59a1f84e3742827a8033bb153ebbedc1759bee72 -->
    Loom-Trace-Id: ed180bcab6828041123ad54d8ddb4037
    Loom-Build: unknown 8080d0485cc1312129ee642b084944c56d1be074 clean
    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
2026-10-04 chore: resync installed Loom surfaces
    <!-- loom:provenance v1 build=unknown 83cb6647167ffc000d2c2f479b4e816b68f863f4 clean prompts=none sweep=none story=none trace=ccabffa1e1ba495895b262086030816c host=robb-studio base=df9da2c7255301e4613d40611c5f7ea640ae8f9f run=loom-run/v1:timer:robb-studio/fleet-resync:88a78f1f-d978-47b5-99c3-2aabde811d17 installs=0.19.676 cd4f30bd892ea2595d8218b08150633504b0dd14 -->
    Loom-Trace-Id: ccabffa1e1ba495895b262086030816c
    Loom-Build: unknown 83cb6647167ffc000d2c2f479b4e816b68f863f4 clean
    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
2026-10-04 chore: resync installed Loom surfaces
    <!-- loom:provenance v1 build=unknown 32174d0f7e80508fa66c1a11a2c0fb28c515607e clean prompts=none sweep=none story=none trace=436d7c19b10cd5807625a7ce7190a82f host=loom-worker-2 base=ad3ab2289774707f045007efa74a27ae08015469 run=loom-run/v1:timer:loom-worker-2/fleet-resync:19ae50771cc04d8db7b1403c1e66bbea installs=0.19.682 9eccfa110fa294fa32a62ffe8eff669cfcf1a3a6 -->
    Loom-Trace-Id: 436d7c19b10cd5807625a7ce7190a82f
    Loom-Build: unknown 32174d0f7e80508fa66c1a11a2c0fb28c515607e clean
    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
2026-10-04 chore: resync installed Loom surfaces
    <!-- loom:provenance v1 build=unknown 72290fa960e0773b2c50d74042e24914c7327637 clean prompts=none sweep=none story=none trace=f7b6952a649a174398a48b90b6ab4793 host=robb-pro base=08351640d106e2c4d29bf44697b2772d1333f7fd run=loom-run/v1:timer:robb-pro/fleet-resync:72f32482-5cc4-4b38-ab9e-4d2ef0b64e94 installs=0.19.684 bdb8fb331eb51c7def4cdd2c38b611af06f25f6d -->
    Loom-Trace-Id: f7b6952a649a174398a48b90b6ab4793
    Loom-Build: unknown 72290fa960e0773b2c50d74042e24914c7327637 clean
    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
2026-10-04 chore: resync installed Loom surfaces
    <!-- loom:provenance v1 build=unknown 76cda58637be0e74c4cb5b4c8dbc2000e2a9c3d4 clean prompts=none sweep=none story=none trace=614cbada5ce873c2b34a511816309cfc host=robb-studio base=0837395dc88e5d954baa8c67446edcef0c6dbc10 run=loom-run/v1:timer:robb-studio/fleet-resync:7e559a3b-ffdd-409b-8dd2-ae906a273b0a installs=0.19.692 d4974b9f5ff7843a3cfc06378ea2a69bc120e0f4 -->
    Loom-Trace-Id: 614cbada5ce873c2b34a511816309cfc
    Loom-Build: unknown 76cda58637be0e74c4cb5b4c8dbc2000e2a9c3d4 clean
    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
2026-10-04 chore: resync installed Loom surfaces
    <!-- loom:provenance v1 build=unknown f84bac5c232c093f83c1adc2533d8c75b021cda2 clean prompts=none sweep=none story=none trace=e687830614e4bd1c551ab6cf6186f8f3 host=loom-worker-2 base=b804b7c105bd581e10f7cc585ba713a762e84134 run=loom-run/v1:timer:loom-worker-2/fleet-resync:2db2c4373ac24de1b7a364e69eaea1ca installs=0.19.695 b0d5b09f207fda439390ea1dd249ad10e7009dfc -->
    Loom-Trace-Id: e687830614e4bd1c551ab6cf6186f8f3
    Loom-Build: unknown f84bac5c232c093f83c1adc2533d8c75b021cda2 clean
    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
2026-10-04 chore: resync installed Loom surfaces
    <!-- loom:provenance v1 build=unknown ac5c275d1c616a9723e747f5a66de93dc80d3512 clean prompts=none sweep=none story=none trace=c777c3912bd31972e9aa3ccab712ae01 host=loom-worker-1 base=9c613f5ed36a583fe9595f821b67e0fae200444a run=loom-run/v1:script:loom-worker-1/fleet-resync:b51a1b33-4958-4408-be36-166e12e8360b installs=0.19.697 ada83a5c7ff66b56b0060ef0be368c9fe56eb3c6 -->
    Loom-Trace-Id: c777c3912bd31972e9aa3ccab712ae01
    Loom-Build: unknown ac5c275d1c616a9723e747f5a66de93dc80d3512 clean
    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
2026-10-04 chore: resync installed Loom surfaces
    <!-- loom:provenance v1 build=unknown a19f642f5c09599c4c64827d81d228eb031be73e clean prompts=none sweep=none story=none trace=34a80e22764eb5055e37faec0eaf65fb host=robb-pro base=3027c01c1b76de7d97d13663a6eda0574caba0af run=loom-run/v1:script:robb-pro/fleet-resync:689be620-3ff2-4ff5-a2ce-f6825f6379e2 installs=0.19.698 aa619a1d07e36e8d90ac01fea63dc39285c93567 -->
    Loom-Trace-Id: 34a80e22764eb5055e37faec0eaf65fb
    Loom-Build: unknown a19f642f5c09599c4c64827d81d228eb031be73e clean
    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
2026-10-04 chore: resync installed Loom surfaces
    <!-- loom:provenance v1 build=unknown 693bdd794cb34afdefd7f0c4596824cd53078a61 clean prompts=none sweep=none story=none trace=7e7be58c80b40f1ac882b00139fb0ca0 host=robb-pro base=0fbf93a5df13270d16c2b63edf00bf0066b8a9d9 run=loom-run/v1:timer:robb-pro/fleet-resync:d64fbd6b-5d9b-491d-9e17-742b375bfba7 installs=0.19.698 b814428b8333c69174c977498d1d2db6bce3145c -->
    Loom-Trace-Id: 7e7be58c80b40f1ac882b00139fb0ca0
    Loom-Build: unknown 693bdd794cb34afdefd7f0c4596824cd53078a61 clean
    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
2026-10-04 chore: resync installed Loom surfaces
    <!-- loom:provenance v1 build=unknown 693bdd794cb34afdefd7f0c4596824cd53078a61 clean prompts=none sweep=none story=none trace=aa18f1ec102a98d77ffc51c9be6ffbb3 host=robb-studio base=1d6046f2781cfaae252a6c661ed20c2a204b7535 run=loom-run/v1:script:robb-studio/fleet-resync:3cb89ca8-62c2-4a69-8434-c4aaa3b64eaf installs=0.19.698 a58f00e0681c50d6bfc5089d0af4b3715198319f -->
    Loom-Trace-Id: aa18f1ec102a98d77ffc51c9be6ffbb3
    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
2026-10-04 chore: resync installed Loom surfaces
    <!-- loom:provenance v1 build=unknown 7a41c2e69ef89d60ed3bd190b94838021bf18d0f clean prompts=none sweep=none story=none trace=d0f04f38b507d85402723643fcf47197 host=loom-worker-1 base=e66691ba61a5ff261075b8324b2c250233f10894 run=loom-run/v1:script:loom-worker-1/fleet-resync:8fdc8c1c-f844-4c33-bc80-b424e5b4cf3d installs=0.19.703 89d5a428c652f957d7fad8a546589042d39911bc -->
    Loom-Trace-Id: d0f04f38b507d85402723643fcf47197
    Loom-Build: unknown 7a41c2e69ef89d60ed3bd190b94838021bf18d0f clean
    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
2026-10-05 chore: resync installed Loom surfaces
    <!-- loom:provenance v1 build=unknown ebb37db560de172930e261675a35bd52e429f650 clean prompts=none sweep=none story=none trace=a40e86a64366c7a1e36aea026901334f host=loom-worker-2 base=0b5b2c51169300ee929f072d75b28c3e97c477c5 run=loom-run/v1:script:loom-worker-2/fleet-resync:90b6cd74-6cc0-4f58-98ee-6ede0ac6f50c installs=0.19.703 f63c3c82e6bf202f2ca7b205b532f681c5ebb2c8 -->
    Loom-Trace-Id: a40e86a64366c7a1e36aea026901334f
    Loom-Build: unknown ebb37db560de172930e261675a35bd52e429f650 clean
    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
2026-10-05 chore: resync installed Loom surfaces
    <!-- loom:provenance v1 build=unknown 7a41c2e69ef89d60ed3bd190b94838021bf18d0f clean prompts=none sweep=none story=none trace=fc04851db12f586b5d58155325131b6e host=robb-studio base=2e40faef31e5c3d53c3ff0724f69109cbad7164f run=loom-run/v1:timer:robb-studio/fleet-resync:a7d5da6f-a896-4d6f-8d00-aebf47f9b266 installs=0.19.703 2ad9a08fb93de4d7dfac9d2b501d12c684c9c2cc -->
    Loom-Trace-Id: fc04851db12f586b5d58155325131b6e
    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
2026-10-05 chore: resync installed Loom surfaces
    <!-- loom:provenance v1 build=unknown afe7e99e397c242cc319fa80702fb3b23e23f5a7 clean prompts=none sweep=none story=none trace=e46782e1dd9c94461b4cf934ce05296b host=loom-worker-2 base=c9ef8c25e578f9a1dee65f527ddfef52d6fced43 run=loom-run/v1:timer:loom-worker-2/fleet-resync:caa89259b1fd414ebd2f07500621166d installs=0.19.703 972fe7321be6a9efe2653579379ea3bc40b899b2 -->
    Loom-Trace-Id: e46782e1dd9c94461b4cf934ce05296b
    Loom-Build: unknown afe7e99e397c242cc319fa80702fb3b23e23f5a7 clean
    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
2026-10-05 chore: resync installed Loom surfaces
    <!-- loom:provenance v1 build=unknown b44cb904ebb599db793066ccc631c846862abfbd clean prompts=none sweep=none story=none trace=9590fed7c1b1c9f549ccf3cba24292d7 host=robb-pro base=857d25f114863329d404725dc3d17b6ceccb0df8 run=loom-run/v1:timer:robb-pro/fleet-resync:dbc6174e-403d-422d-98b6-73a4b6dbf44f installs=0.19.708 dc8faf1eae3143feda6301887c303b1ee45db7f4 -->
    Loom-Trace-Id: 9590fed7c1b1c9f549ccf3cba24292d7
    Loom-Build: unknown b44cb904ebb599db793066ccc631c846862abfbd clean
    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
2026-10-05 chore: resync installed Loom surfaces
    <!-- loom:provenance v1 build=unknown 4548905848fcb7cb875c1c0518f2fd88eb65818e clean prompts=none sweep=none story=none trace=aff5e139797705f6fa0811f102ecd103 host=loom-worker-1 base=a4821b7b4f70e7d51214c130dc7496e00f01f53a run=loom-run/v1:timer:loom-worker-1/fleet-resync:ba6a9e5686a64abaa842d71acaeae2ca installs=0.19.718 00d99344506bcf00e1aec7e910abe3d13df2d240 -->
    Loom-Trace-Id: aff5e139797705f6fa0811f102ecd103
    Loom-Build: unknown 4548905848fcb7cb875c1c0518f2fd88eb65818e clean
    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
2026-10-05 chore: resync installed Loom surfaces
    <!-- loom:provenance v1 build=unknown e7efbaa6e7b97a7d72da6032044c67525291f4d1 clean prompts=none sweep=none story=none trace=d74a33a6f35e329b3e795991e790ebfd host=robb-studio base=582b164942de3afca9c480b037d3d509e9b35341 run=loom-run/v1:timer:robb-studio/fleet-resync:304f49c8-5b3e-46a9-a557-945b9ae177f0 installs=0.19.718 00d99344506bcf00e1aec7e910abe3d13df2d240 -->
    Loom-Trace-Id: d74a33a6f35e329b3e795991e790ebfd
    Loom-Build: unknown e7efbaa6e7b97a7d72da6032044c67525291f4d1 clean
    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
2026-10-05 chore: resync installed Loom surfaces
    <!-- loom:provenance v1 build=unknown 347b71e65e709d9fd49aba75d3fb67877fc08818 clean prompts=none sweep=none story=none trace=f9653dd318724c98136e7cef63e551ed host=robb-pro base=8aed192929d6154bf6e3c6d80a46d43c8497bdfc run=loom-run/v1:timer:robb-pro/fleet-resync:cdc95970-9fb1-49fa-a0e6-037a3fab2099 installs=0.19.728 991dcebf6f6b2de6571f1d3400bec083498c6438 -->
    Loom-Trace-Id: f9653dd318724c98136e7cef63e551ed
    Loom-Build: unknown 347b71e65e709d9fd49aba75d3fb67877fc08818 clean
    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
2026-10-05 Characterize loaded four-row column stored levels and read separation (#45)
    Loom-Story: 2AMLogic/sky130-gcedram#45
    Loom-Trace-Id: 18a4f741e4b218dff5eac33f252a808a
    Loom-Build: 0.19.697 fac089879ca47a594146770a673a594fd7490de9 clean
    [loaded_column_results.csv]
2026-10-05 Correct loaded-column separation summary; guard batched cases (#45)
    README: split fs/27 C (0.286 V fresh / 0.272 V aged, half-window
    0.136-0.143 V) out of the "other points" row; the remaining 12 points are
    0.515-0.654 V fresh / 0.586-0.659 V aged. Rewrite the sense-reference
    section with per-region windows and the common-reference bound set by
    fs/27 C. Note row 0's refresh-bound age is ~100 ps short of the exact
    bound. All numbers re-derived from summary_20261005T102906Z.json.
    Runner: run `destroy all` before each batched tran (a failed tran made
    wrdata re-write the previous case's plot) and reject a case whose last
    timepoint is before its planned tstop. A re-run of the fs/27 C row-0
    batch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
2026-10-05 chore: resync installed Loom surfaces
    <!-- loom:provenance v1 build=unknown 5c0d18101f48fecb656f10fa37afa9b09bf41631 clean prompts=none sweep=none story=none trace=ddcf49552af364cbf6e884bd59584c1f host=loom-worker-1 base=1b1b17e14443ac594169afd403bdb6de00967ae9 run=loom-run/v1:timer:loom-worker-1/fleet-resync:5eb526a05f244f1985770579e7620ff1 installs=0.19.731 7484b71fce5179a025950e71a82855afaf6fd730 -->
    Loom-Trace-Id: ddcf49552af364cbf6e884bd59584c1f
    Loom-Build: unknown 5c0d18101f48fecb656f10fa37afa9b09bf41631 clean
    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
2026-10-05 Add cold-corner variant harness, Phase 2 reproduction and Vth evidence (#47)
    Part of #47 (work in progress on this branch).
    Loom-Story: 2AMLogic/sky130-gcedram#47
    Loom-Trace-Id: 585f3a866c58daefe35ae317219bf184
    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
    [phase2_reproduction.csv, vth_results.csv]
2026-10-05 chore: resync installed Loom surfaces
    <!-- loom:provenance v1 build=unknown 0b160514b6658e3ab26a71c6525791da25b46fcf clean prompts=none sweep=none story=none trace=311c3eb2c0ab9550d3de38df5523f3d7 host=robb-studio base=2b7fee18981c538e86745845be3a6090e85e6fb5 run=loom-run/v1:timer:robb-studio/fleet-resync:e6dec631-b42b-4cf2-b854-cc363cfde6e0 installs=0.19.731 d6146becf339a3d4e55e26e8807ac4571213a00b -->
    Loom-Trace-Id: 311c3eb2c0ab9550d3de38df5523f3d7
    Loom-Build: unknown 0b160514b6658e3ab26a71c6525791da25b46fcf clean
    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
2026-10-05 Attribute cold-corner read failure and compare remedies on full grid (#47)
    Adds the issue #47 cold-corner study under sim/loaded-column/cold-corner/:
    attribution sweeps (one knob at a time), remedy campaigns over the
    15-point x 2-age grid, the write-disabled negative control, the analysis
    summary and pass/fail table, the README with the proposed (not ratified)
    next design contract, and the sim/README index entry. The reproduction
    check uses a last-digit relative tolerance; the unchanged Phase 2 runner
    reproduces the failure bit-identically. Phase 2 evidence is untouched.
    Closes #47
    Loom-Trace-Id: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
    [pass_fail_20261005T145658Z.csv, variant_results.csv]
2026-10-05 chore: resync installed Loom surfaces
    <!-- loom:provenance v1 build=unknown 5c0d18101f48fecb656f10fa37afa9b09bf41631 clean prompts=none sweep=none story=none trace=f1e8d4c6e73b8eec3e87a8da52e10f2d host=robb-pro base=36b5e93bad0898c8c40f8e61578e9ebc7aee7fa6 run=loom-run/v1:timer:robb-pro/fleet-resync:5518fd33-81cb-479f-93f0-287ea4b08876 installs=0.19.733 4e67131ce3a1317d8cb8904ec342541cc2f45665 -->
    Loom-Trace-Id: f1e8d4c6e73b8eec3e87a8da52e10f2d
    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
2026-10-05 chore: resync installed Loom surfaces
    <!-- loom:provenance v1 build=unknown ca170d11544ef499cc9500a45bbad152edacfbd1 clean prompts=none sweep=none story=none trace=6dcfc713b6a851b40932158c2eeb70af host=loom-worker-3 base=9c6fbd765411165569cb15885b120d745a07739f run=loom-run/v1:timer:loom-worker-3/fleet-resync:20ce0908ea5a468a9e055470104047ed installs=0.19.734 7ba6ea50c36dfdd2b5e2922dd22c65560980a5a2 -->
    Loom-Trace-Id: 6dcfc713b6a851b40932158c2eeb70af
    Loom-Build: unknown ca170d11544ef499cc9500a45bbad152edacfbd1 clean
    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
2026-10-05 chore: resync installed Loom surfaces
    <!-- loom:provenance v1 build=unknown 03f1c42302d15f8a83425a84a4e36ca484f3f625 clean prompts=none sweep=none story=none trace=f1bc879f8aa652d550764ffcd36e27d1 host=loom-worker-1 base=0fd40553d460ab55a84a20cfade0641f3507dc59 run=loom-run/v1:timer:loom-worker-1/fleet-resync:f302a3cc8558413492093df510b02418 installs=0.19.734 967abe71d019ce6606018b4e57dee0223b84d96f -->
    Loom-Trace-Id: f1bc879f8aa652d550764ffcd36e27d1
    Loom-Build: unknown 03f1c42302d15f8a83425a84a4e36ca484f3f625 clean
    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
2026-10-05 chore: resync installed Loom surfaces
    <!-- loom:provenance v1 build=unknown ce7557ba58624d48fedbca2bc037dfa8ce3943e7 clean prompts=none sweep=none story=none trace=e1f2558834c47835cd9a53ec8c9a2ffa host=loom-worker-3 base=eaae36e04a6d9099a3ddf51aa3e8e8cd28a06c4b run=loom-run/v1:timer:loom-worker-3/fleet-resync:50f5f0046e2c4890961b3221bd360247 installs=0.19.734 ba9edb650872e5265eaca0c47f75e3cb828ecad2 -->
    Loom-Trace-Id: e1f2558834c47835cd9a53ec8c9a2ffa
    Loom-Build: unknown ce7557ba58624d48fedbca2bc037dfa8ce3943e7 clean
    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
2026-10-05 chore: resync installed Loom surfaces
    <!-- loom:provenance v1 build=unknown f92eaec38470a7b0732e065f4864faec9a1905d6 clean prompts=none sweep=none story=none trace=07aa020a8179d52651250562e9808b98 host=robb-studio base=68488eb66aeb24d3b233274cd4722eafe689be0c run=loom-run/v1:timer:robb-studio/fleet-resync:3b3ebdf2-b5f7-48ed-b7bb-5fb945094061 installs=0.19.734 78f3e99c44d0af6d4598adf7577bb6676baf3e8f -->
    Loom-Trace-Id: 07aa020a8179d52651250562e9808b98
    Loom-Build: unknown f92eaec38470a7b0732e065f4864faec9a1905d6 clean
    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
2026-10-06 chore: resync installed Loom surfaces
    <!-- loom:provenance v1 build=unknown ca170d11544ef499cc9500a45bbad152edacfbd1 clean prompts=none sweep=none story=none trace=fca9c14d74d6d634726f5823c51bc62a host=loom-worker-2 base=b781652154b6c83abe00e44cafd278e66d737c13 run=loom-run/v1:timer:loom-worker-2/fleet-resync:23a23f0878c1494cb720941baddfea81 installs=0.19.741 3cede3920c6b567d5400789187a904970d46b0fb -->
    Loom-Trace-Id: fca9c14d74d6d634726f5823c51bc62a
    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
2026-10-06 chore: resync installed Loom surfaces
    <!-- loom:provenance v1 build=unknown e38a22941348fd8e83d1f4b06130d2a214adfb50 clean prompts=none sweep=none story=none trace=a7fe3a9a1fedfce89846c20f2e98ac31 host=robb-pro base=9fe36a2e759e93ed724ac2a51687dccd88c216cd run=loom-run/v1:timer:robb-pro/fleet-resync:2d770a42-f0e7-4695-abfa-b912e75382e6 installs=0.19.744 8bc5bcce93c4d9721817387afe8b4b6d79f26054 -->
    Loom-Trace-Id: a7fe3a9a1fedfce89846c20f2e98ac31
    Loom-Build: unknown e38a22941348fd8e83d1f4b06130d2a214adfb50 clean
    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
2026-10-06 chore: resync installed Loom surfaces
    <!-- loom:provenance v1 build=unknown f66ea90ff1bdec51aa4c8dc3f4b2e8d26e3dfd2d clean prompts=none sweep=none story=none trace=66d96c3bb00b04fae967865ee02fc4de host=loom-worker-3 base=2dfd2f2ed7c20bc8e5e7cf9039a431f32fec521c run=loom-run/v1:timer:loom-worker-3/fleet-resync:eb2dceb410e848a19d58f96f678c995e installs=0.19.749 6135634b053dc30ef5aa8e6d733bfe79bb2ac734 -->
    Loom-Trace-Id: 66d96c3bb00b04fae967865ee02fc4de
    Loom-Build: unknown f66ea90ff1bdec51aa4c8dc3f4b2e8d26e3dfd2d clean
    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
2026-10-06 chore: resync installed Loom surfaces
    <!-- loom:provenance v1 build=unknown ade8a2c60cc8370d04d72f331141acb6fb32e121 clean prompts=none sweep=none story=none trace=6245fb88b5bdf9f7ccecb6b2168dc335 host=robb-studio base=293951091b5b38110ef98561033dddbc31dd29d6 run=loom-run/v1:timer:robb-studio/fleet-resync:b305aed2-1a25-4576-aca7-9b017ac4377e installs=0.19.755 8d97d322e1cb3723988504337089beca73d0511c -->
    Loom-Trace-Id: 6245fb88b5bdf9f7ccecb6b2168dc335
    Loom-Build: unknown ade8a2c60cc8370d04d72f331141acb6fb32e121 clean
    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
2026-10-06 chore: resync installed Loom surfaces
    <!-- loom:provenance v1 build=unknown 2489bb7d5203844b3fbe8efbe007f44aa074685d clean prompts=none sweep=none story=none trace=0b5c9263a55c09e6fbd870b2d9ff5d9b host=loom-worker-2 base=f8062e835702844e3f077e148b7dc97936f38ebb run=loom-run/v1:timer:loom-worker-2/fleet-resync:d3f5a5beb1144f72ac8be575767b3e03 installs=0.19.760 3a509582b179d91c2d5b5a65a7ba4650c3c08985 -->
    Loom-Trace-Id: 0b5c9263a55c09e6fbd870b2d9ff5d9b
    Loom-Build: unknown 2489bb7d5203844b3fbe8efbe007f44aa074685d clean
    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
2026-10-06 chore: resync installed Loom surfaces
    <!-- loom:provenance v1 build=unknown 986d16b700174622774ff68af4ef323e8d0e23ba clean prompts=none sweep=none story=none trace=cb518f1f5785c258556383940a46c461 host=loom-worker-1 base=b9bc5635eaf2a07cf29d4483c236be7c145fd5bc run=loom-run/v1:timer:loom-worker-1/fleet-resync:97df92c5eca846de85e979810663a94b installs=0.19.765 c6cec65c4f320f11153c72e840e49a5d6a6f1afc -->
    Loom-Trace-Id: cb518f1f5785c258556383940a46c461
    Loom-Build: unknown 986d16b700174622774ff68af4ef323e8d0e23ba clean
    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
2026-10-06 chore: resync installed Loom surfaces
    <!-- loom:provenance v1 build=unknown 85e52221261264d7f7643251de706f00c8db289f clean prompts=none sweep=none story=none trace=a2434124d73d8cca0ca77230fc85adf5 host=robb-pro base=3054735b3989a5e9fa5083944bc4de29af53ba26 run=loom-run/v1:timer:robb-pro/fleet-resync:abffb067-59ed-4a6e-94b6-8cf3500c935c installs=0.19.768 c9f7ca975144d991bce40f492403b8292e8b7fae -->
    Loom-Trace-Id: a2434124d73d8cca0ca77230fc85adf5
    Loom-Build: unknown 85e52221261264d7f7643251de706f00c8db289f clean
    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
2026-10-06 chore: resync installed Loom surfaces
    <!-- loom:provenance v1 build=unknown 31b34ebfd7d4539094523eaa7b56a104bebe5fc0 clean prompts=none sweep=none story=none trace=16fac36f144dc183c71465eb36c89afc host=loom-worker-3 base=6968deeed7ee32ac2dec37c1e6981836d3f39436 run=loom-run/v1:timer:loom-worker-3/fleet-resync:c763e24590314b918c8ee8df5d2de1db installs=0.19.769 af995a5725fdadf708127f006aa8f248b482d7d7 -->
    Loom-Trace-Id: 16fac36f144dc183c71465eb36c89afc
    Loom-Build: unknown 31b34ebfd7d4539094523eaa7b56a104bebe5fc0 clean
    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
2026-10-06 chore: resync installed Loom surfaces
    <!-- loom:provenance v1 build=unknown 7bed309263b3785eae46a9cbc53b3b24a52b10d2 clean prompts=none sweep=none story=none trace=843adbd5eac450c43d3a2c43da1bf729 host=robb-studio base=04fff14050ae509de711c3fcd1ceea2578597822 run=loom-run/v1:timer:robb-studio/fleet-resync:f83d5ba4-81f7-479a-9768-6af33d4cc825 installs=0.19.783 a9b459e0c2b1916ceb116db33053e7eb0df57e7b -->
    Loom-Trace-Id: 843adbd5eac450c43d3a2c43da1bf729
    Loom-Build: unknown 7bed309263b3785eae46a9cbc53b3b24a52b10d2 clean
    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
2026-10-06 chore: resync installed Loom surfaces
    <!-- loom:provenance v1 build=unknown 07bc40ba9ab0f7dfe7cd0990377b7ac07a52d220 clean prompts=none sweep=none story=none trace=563f186108419cf03cef002a62c3b201 host=loom-worker-2 base=39971a61901591ced243f763c0fd5ad13bdf4ade run=loom-run/v1:timer:loom-worker-2/fleet-resync:944beccd157a4197b81feafdd19f443e installs=0.19.785 2f0a9dbb4f06053f747b8a5615a3519f8e30b527 -->
    Loom-Trace-Id: 563f186108419cf03cef002a62c3b201
    Loom-Build: unknown 07bc40ba9ab0f7dfe7cd0990377b7ac07a52d220 clean
    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
2026-10-06 chore: resync installed Loom surfaces
    <!-- loom:provenance v1 build=unknown 31b34ebfd7d4539094523eaa7b56a104bebe5fc0 clean prompts=none sweep=none story=none trace=ea6600df41a4b420b6d8e967f839ccfd host=loom-worker-3 base=5fc3713f08a4000f2c0c27effef46f2764eb5913 run=loom-run/v1:timer:loom-worker-3/fleet-resync:c80415b48fd5404bbd599c4f6cc8a448 installs=0.19.793 7ceff96944c39d33e3c2f1141ca650c2c4c05679 -->
    Loom-Trace-Id: ea6600df41a4b420b6d8e967f839ccfd
    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
2026-10-06 chore: resync installed Loom surfaces
    <!-- loom:provenance v1 build=unknown 596a53e525683919daae1b43e6babe9bf847a02f clean prompts=none sweep=none story=none trace=b9c0cb42a5a72ecc21726229c957ef1f host=loom-worker-2 base=b7139f823427242550c134f7158614530d0ef035 run=loom-run/v1:timer:loom-worker-2/fleet-resync:21d578f5cc0b4b7ba5f10759f5f30ae8 installs=0.19.801 524bdb33cb26c8355454d7550413c89e72c06fae -->
    Loom-Trace-Id: b9c0cb42a5a72ecc21726229c957ef1f
    Loom-Build: unknown 596a53e525683919daae1b43e6babe9bf847a02f clean
    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
2026-10-06 chore: resync installed Loom surfaces
    <!-- loom:provenance v1 build=unknown 40b591a33adb895d4f46977105f9b264d8a2599b clean prompts=none sweep=none story=none trace=e41c725fe0c176312eb412bc69fe5b01 host=robb-studio base=7d65ec016bb5e0e8b58cb87fda3406e436119c50 run=loom-run/v1:timer:robb-studio/fleet-resync:37d704dd-4dfd-4341-adb4-6551637ad147 installs=0.19.803 5af82e9a4b23b68166889a3435b7f3ca8161d0e6 -->
    Loom-Trace-Id: e41c725fe0c176312eb412bc69fe5b01
    Loom-Build: unknown 40b591a33adb895d4f46977105f9b264d8a2599b clean
    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
2026-10-06 chore: resync installed Loom surfaces
    <!-- loom:provenance v1 build=unknown 31b34ebfd7d4539094523eaa7b56a104bebe5fc0 clean prompts=none sweep=none story=none trace=5ad0480c4b21b80f9c852c448319e7a1 host=loom-worker-3 base=5e441e92b27bd653b94c5b6e404aaa4bb038c89a run=loom-run/v1:timer:loom-worker-3/fleet-resync:48e836f11f9547ddb96de5aa0d072a05 installs=0.19.810 933f828e779602e492e4e157812988a4b8128111 -->
    Loom-Trace-Id: 5ad0480c4b21b80f9c852c448319e7a1
    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
2026-10-07 chore: resync installed Loom surfaces
    <!-- loom:provenance v1 build=unknown f71cf25de9e75bae6060da4a599df8fbabe75890 clean prompts=none sweep=none story=none trace=64943e35511da4833bbd385cf288be8a host=loom-worker-2 base=2610c50b73c9520b5e03caecd72a7459dea24b28 run=loom-run/v1:timer:loom-worker-2/fleet-resync:d69eb1b87d4849ae810a145b1b667d2f installs=0.19.822 1c6969ea8726c800a353c236d9f23456a5706f1a -->
    Loom-Trace-Id: 64943e35511da4833bbd385cf288be8a
    Loom-Build: unknown f71cf25de9e75bae6060da4a599df8fbabe75890 clean
    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
2026-10-07 chore: resync installed Loom surfaces
    <!-- loom:provenance v1 build=unknown 31b34ebfd7d4539094523eaa7b56a104bebe5fc0 clean prompts=none sweep=none story=none trace=cb192cb8f72cf6f2711f73f7ee12bebc host=loom-worker-3 base=b44ef7df107c5653aa33430151efe46dddd9beac run=loom-run/v1:timer:loom-worker-3/fleet-resync:c1e385c3607e43ad8bed9c7d29811c66 installs=0.19.830 a966f7b89b714704fa1225b96e2dbee50480a4c6 -->
    Loom-Trace-Id: cb192cb8f72cf6f2711f73f7ee12bebc
    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
2026-10-07 docs: supply/reliability evidence package and PROPOSED decision record (#49)
    Loom-Story: 2AMLogic/sky130-gcedram#49
    Loom-Trace-Id: e7fcec4b699854b38b2b42e68bd6a437
    Loom-Build: 0.19.827 6b5119f48f153d6e74b5815da984b8998af166eb clean
2026-10-07 chore: resync installed Loom surfaces
    <!-- loom:provenance v1 build=unknown 8abdd34fddc879aff407380278baa713eca6b758 clean prompts=none sweep=none story=none trace=ea945665dad5ccb3880de51c4448e8b9 host=robb-pro base=d6a35bd4603a75fc809f7d32cbc9d5052ebdf3dc run=loom-run/v1:timer:robb-pro/fleet-resync:1466e397-b80c-46ea-a42c-26a7fbd4e00e installs=0.19.831 61814c9c1912925cdff7418842ff3ea17cd56fe4 -->
    Loom-Trace-Id: ea945665dad5ccb3880de51c4448e8b9
    Loom-Build: unknown 8abdd34fddc879aff407380278baa713eca6b758 clean
    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
2026-10-07 docs: reliability-source search log and evidence update (#51)
    No primary 1.8 V NMOS overdrive/TDDB/HCI or forward-junction bound found
    in public sources; spec/ stays PROPOSED, supported outcome C.
    Loom-Story: 2AMLogic/sky130-gcedram#51
    Loom-Trace-Id: f9bdfecb35ba8da109f4fc0e0b01df9b
    Loom-Build: 0.19.830 a966f7b89b714704fa1225b96e2dbee50480a4c6 clean
2026-10-07 chore: resync installed Loom surfaces
    <!-- loom:provenance v1 build=unknown 628be5bb140bcff803d159201bd61e1b868901b0 clean prompts=none sweep=none story=none trace=093df1dc315c5e78dcccfca9d699d5f5 host=loom-worker-2 base=a4a6f0698ac8af98f28483f38b5866dda23a772c run=loom-run/v1:timer:loom-worker-2/fleet-resync:0b0ea5e184c0429a9c431fcca6c791ad installs=0.19.832 1a0fc15974bf0575a9155fb8276f7529fc813542 -->
    Loom-Trace-Id: 093df1dc315c5e78dcccfca9d699d5f5
    Loom-Build: unknown 628be5bb140bcff803d159201bd61e1b868901b0 clean
    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
2026-10-07 chore: resync installed Loom surfaces
    <!-- loom:provenance v1 build=unknown 069e3b45d86c08f0d60c8fc2b0096de441e99bdc clean prompts=none sweep=none story=none trace=b1ba9d6b2b581e47827d9c099f717b04 host=loom-worker-1 base=0f78a0699720045e7a16373f90e2d954e5623549 run=loom-run/v1:timer:loom-worker-1/fleet-resync:aada8278bd4843bcaecce69fdf91251e installs=0.19.838 e70aa17f8dead31bda49cf044c3fc28119df6e90 -->
    Loom-Trace-Id: b1ba9d6b2b581e47827d9c099f717b04
    Loom-Build: unknown 069e3b45d86c08f0d60c8fc2b0096de441e99bdc clean
    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
2026-10-07 chore: resync installed Loom surfaces
    <!-- loom:provenance v1 build=unknown 31b34ebfd7d4539094523eaa7b56a104bebe5fc0 clean prompts=none sweep=none story=none trace=ef030e94bce76f728497f5927960865f host=loom-worker-3 base=f4cbf8655e48d7816af7f2e625e7d8786612c767 run=loom-run/v1:timer:loom-worker-3/fleet-resync:28ba4284bfa446c888b501714eda0509 installs=0.19.840 59b533a2a1ed5e186fbf8446b5acbe42d7231854 -->
    Loom-Trace-Id: ef030e94bce76f728497f5927960865f
    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
2026-10-07 chore: resync installed Loom surfaces
    <!-- loom:provenance v1 build=unknown bc59c70c3412a87b31a0dbe65cd6abf968744328 clean prompts=none sweep=none story=none trace=766033e4e881801f24971d664c490ea3 host=robb-studio base=58434233a9369314243e83a87d8cd52faebeaa28 run=loom-run/v1:timer:robb-studio/fleet-resync:6b3b079a-890e-4a79-9c3a-0b4bb33ff7c4 installs=0.19.840 59b533a2a1ed5e186fbf8446b5acbe42d7231854 -->
    Loom-Trace-Id: 766033e4e881801f24971d664c490ea3
    Loom-Build: unknown bc59c70c3412a87b31a0dbe65cd6abf968744328 clean
    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
2026-10-07 chore: resync installed Loom surfaces
    <!-- loom:provenance v1 build=unknown a068938e7a6c13759bcb3943e408273a3d352257 clean prompts=none sweep=none story=none trace=76bec863c8f6aff2d49b3aa2be128619 host=robb-pro base=96e394eb2ceca9592514bed366484df0c36a6c4e run=loom-run/v1:timer:robb-pro/fleet-resync:d9927fc6-ee80-4b6a-ba2b-f13576bd5f9b installs=0.19.847 fcb4e400253cae9c722e568bfd5ec8f0625c5518 -->
    Loom-Trace-Id: 76bec863c8f6aff2d49b3aa2be128619
    Loom-Build: unknown a068938e7a6c13759bcb3943e408273a3d352257 clean
    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
2026-10-07 chore: resync installed Loom surfaces
    <!-- loom:provenance v1 build=unknown 628be5bb140bcff803d159201bd61e1b868901b0 clean prompts=none sweep=none story=none trace=5a6f676b4652a1a750bbce1386c68d06 host=loom-worker-2 base=6aa33eb0405eab7d0ad257c4d8d4ea79f9952f24 run=loom-run/v1:timer:loom-worker-2/fleet-resync:bd416e653be04ef4b13353430625e379 installs=0.19.850 3bb4bfc90603b6ad65cabca9b3eb42a59f1a9d3a -->
    Loom-Trace-Id: 5a6f676b4652a1a750bbce1386c68d06
    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
2026-10-07 chore: resync installed Loom surfaces
    <!-- loom:provenance v1 build=unknown 40215645df8a13508180b248b44244dc488bb078 clean prompts=none sweep=none story=none trace=29fde30615e6e47f39b41aa314c2c883 host=loom-worker-1 base=dc48785c176d0674de4620695ec1f7cb3e5555d3 run=loom-run/v1:timer:loom-worker-1/fleet-resync:d1fbedfcc7824ae59233c0ea94dc4650 installs=0.19.853 2889d5ed585b4da0935543cb916381cc03b19746 -->
    Loom-Trace-Id: 29fde30615e6e47f39b41aa314c2c883
    Loom-Build: unknown 40215645df8a13508180b248b44244dc488bb078 clean
    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
2026-10-07 chore: resync installed Loom surfaces
    <!-- loom:provenance v1 build=unknown 31b34ebfd7d4539094523eaa7b56a104bebe5fc0 clean prompts=none sweep=none story=none trace=cdf49c615da3f5ce46e9fcda1a24f787 host=loom-worker-3 base=d2074cd05238c765b1ed51e540ac4726e2a0f43f run=loom-run/v1:timer:loom-worker-3/fleet-resync:cab31e05b8a24df09bc88f53ee3fb501 installs=0.19.857 7a0b529e6f57a79713f6924bf58d8392ff404259 -->
    Loom-Trace-Id: cdf49c615da3f5ce46e9fcda1a24f787
    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
2026-10-07 chore: resync installed Loom surfaces
    <!-- loom:provenance v1 build=unknown 4b44e7c5db0de1d2b5927de7de229120d546aad3 clean prompts=none sweep=none story=none trace=dfa656ee3483a044378501f49d36f812 host=robb-studio base=f6bd4ba9ede69d27bd73a2022f17e6cc510e3dea run=loom-run/v1:timer:robb-studio/fleet-resync:d80d6bc0-eb68-4a07-8226-2d947d328b3a installs=0.19.859 0aefebd79aba8ab33470f1af4b96847fc794bd0d -->
    Loom-Trace-Id: dfa656ee3483a044378501f49d36f812
    Loom-Build: unknown 4b44e7c5db0de1d2b5927de7de229120d546aad3 clean
    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
2026-10-07 chore: resync installed Loom surfaces
    <!-- loom:provenance v1 build=unknown b591c8cf436f0d4aa5870a9bc7cd5f7194e0e778 dirty prompts=none sweep=none story=none trace=6eca4b0c47205457aae7a3d721c17f17 host=robb-pro base=3891305cf1852141d2590939302dbfe05734f63f run=loom-run/v1:timer:robb-pro/fleet-resync:64af20b3-58cb-47f2-b770-117197cb41e9 installs=0.19.864 128a7eba2bb5f7bcf8891ba284b14cb7ebf8dd3d -->
    Loom-Trace-Id: 6eca4b0c47205457aae7a3d721c17f17
    Loom-Build: unknown b591c8cf436f0d4aa5870a9bc7cd5f7194e0e778 dirty
    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
2026-10-07 chore: resync installed Loom surfaces
    <!-- loom:provenance v1 build=unknown b551219fd5b8347113c0cbc79ea416e81c39fa9d clean prompts=none sweep=none story=none trace=5ac7c8c62dad54841e21dd94f0920de3 host=loom-worker-2 base=521ccc559a55eafb0af3cd904e3aed422ee2002f run=loom-run/v1:timer:loom-worker-2/fleet-resync:d10fb10789e94930ab1af368c15a8f8b installs=0.19.864 128a7eba2bb5f7bcf8891ba284b14cb7ebf8dd3d -->
    Loom-Trace-Id: 5ac7c8c62dad54841e21dd94f0920de3
    Loom-Build: unknown b551219fd5b8347113c0cbc79ea416e81c39fa9d clean
    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
2026-10-07 chore: resync installed Loom surfaces
    <!-- loom:provenance v1 build=unknown 90fbd167e4e376894396e651676cf58fc9aa223a clean prompts=none sweep=none story=none trace=196876656e912171b28029ceca9f772d host=loom-worker-1 base=720b7cf5a9091345d37cee93ee40ef59bd14d429 run=loom-run/v1:timer:loom-worker-1/fleet-resync:7b46720ff3a84a8184f2f2b3bc039260 installs=0.19.868 ee904e1c151bc9cf15b0eb55dfe9d57ad6136cff -->
    Loom-Trace-Id: 196876656e912171b28029ceca9f772d
    Loom-Build: unknown 90fbd167e4e376894396e651676cf58fc9aa223a clean
    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
2026-10-08 chore: resync installed Loom surfaces
    <!-- loom:provenance v1 build=unknown 5a3df331a0612dee585ef905015af01d08e3467f clean prompts=none sweep=none story=none trace=5690fa95febe608e500a46dde8a6ee92 host=loom-worker-2 base=b051894fa4eab167f0caae55f84e6d36a48a0b28 run=loom-run/v1:timer:loom-worker-2/fleet-resync:5c9c35d59b704bff9d8bf096ee7ba7be installs=0.19.876 b16d54e63fbbec4d7f15f13c1f43a5e5b38145ce -->
    Loom-Trace-Id: 5690fa95febe608e500a46dde8a6ee92
    Loom-Build: unknown 5a3df331a0612dee585ef905015af01d08e3467f clean
    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
2026-10-08 chore: resync installed Loom surfaces
    <!-- loom:provenance v1 build=unknown 134eb3ff06c1a86f49a911c6c17464f55e719736 clean prompts=none sweep=none story=none trace=c7df110d490314040dcd1347b2481843 host=loom-worker-1 base=b872675064fec3f11a167fbc88b0373984aa8ad3 run=loom-run/v1:timer:loom-worker-1/fleet-resync:53d0cec2cd61484eb9a0f8fb1f24ac5e installs=0.19.879 c15619905bdd8a24506c3853f45490d26e8f1cad -->
    Loom-Trace-Id: c7df110d490314040dcd1347b2481843
    Loom-Build: unknown 134eb3ff06c1a86f49a911c6c17464f55e719736 clean
    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
2026-10-08 chore: resync installed Loom surfaces
    <!-- loom:provenance v1 build=unknown 8f86de23319d8f6cf049557dcc9cf2e321211d9d clean prompts=none sweep=none story=none trace=17de45f778fbfd714af8afad02c96375 host=loom-worker-3 base=73eb3a64b095990e7892c39054e699800f531bfd run=loom-run/v1:timer:loom-worker-3/fleet-resync:9e3e5d4a08824de3b7bc02940be2a0da installs=0.19.882 c9f85af3d967986cdd7a3f27e088a16f88712b05 -->
    Loom-Trace-Id: 17de45f778fbfd714af8afad02c96375
    Loom-Build: unknown 8f86de23319d8f6cf049557dcc9cf2e321211d9d clean
    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
2026-10-08 chore: resync installed Loom surfaces
    <!-- loom:provenance v1 build=unknown 4a5fb2b6276e17ff26ee1382acfe2ea7360ebea5 clean prompts=none sweep=none story=none trace=67857e1b7189785825a2dfc70921cf85 host=loom-worker-2 base=648a63172177d9b950572da882bf336209ff62c2 run=loom-run/v1:timer:loom-worker-2/fleet-resync:dd6a5f3dceff4d8d8602a07a1dc89c95 installs=0.19.892 ce93e8a919d79a6f027bab268846a52084f9d94e -->
    Loom-Trace-Id: 67857e1b7189785825a2dfc70921cf85
    Loom-Build: unknown 4a5fb2b6276e17ff26ee1382acfe2ea7360ebea5 clean
    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
2026-10-08 chore: resync installed Loom surfaces
    <!-- loom:provenance v1 build=unknown 4642b719c1ebd1e25ab9a120318382d5dee39e24 clean prompts=none sweep=none story=none trace=ccd1e9a8f8444cbe1e3a7875756f6920 host=loom-worker-1 base=dac06b7b01b9c09bc864896d56086515a6c6e5c9 run=loom-run/v1:timer:loom-worker-1/fleet-resync:90a498201f3142e8a28e1df54380a041 installs=0.19.897 d90a0888f37b28cb14f7fe72413a425eb87a6f60 -->
    Loom-Trace-Id: ccd1e9a8f8444cbe1e3a7875756f6920
    Loom-Build: unknown 4642b719c1ebd1e25ab9a120318382d5dee39e24 clean
    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
2026-10-08 chore: resync installed Loom surfaces
    <!-- loom:provenance v1 build=unknown 5684fc8c8ac418d95ad66a002d001eaea1283c9a clean prompts=none sweep=none story=none trace=c864acd3b9a5dbb419fddd8bd2a6283b host=loom-worker-3 base=c1940e08c392e691b07738c4b495c0909a94c0c1 run=loom-run/v1:timer:loom-worker-3/fleet-resync:4771e7c630c34445b7f28539669d76e3 installs=0.19.898 3d55b9a1669c132d130d98f10a292c1325322c30 -->
    Loom-Trace-Id: c864acd3b9a5dbb419fddd8bd2a6283b
    Loom-Build: unknown 5684fc8c8ac418d95ad66a002d001eaea1283c9a clean
    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
2026-10-08 chore: resync installed Loom surfaces
    <!-- loom:provenance v1 build=unknown 04a1189116c7320def7d9ce357d2d9268405ae92 clean prompts=none sweep=none story=none trace=8e55b27fc60ffb045554bd413ad8f3c8 host=robb-pro base=32706e046ef1e2faec92669703e322a632fa39a7 run=loom-run/v1:timer:robb-pro/fleet-resync:83b69005-7c5b-44b3-96f8-33f07bf82f4b installs=0.19.917 d3c1ea3a4c81e01ce5487dc3e4bbdd86534e677e -->
    Loom-Trace-Id: 8e55b27fc60ffb045554bd413ad8f3c8
    Loom-Build: unknown 04a1189116c7320def7d9ce357d2d9268405ae92 clean
    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
2026-10-08 chore: resync installed Loom surfaces
    <!-- loom:provenance v1 build=unknown d2a55ce217b3ad1793611a2c54946676bb55b512 clean prompts=none sweep=none story=none trace=459637e4e8503593bdf58360865a7524 host=robb-pro base=8900630ab58c5e173f958be1e04e5c8af491ce24 run=loom-run/v1:timer:robb-pro/fleet-resync:95b3cf92-9cd9-4c36-8bbd-bdcace7c3874 installs=0.19.935 d347079cd0bad2db2c11ee4f0b760f04b2601d21 -->
    Loom-Trace-Id: 459637e4e8503593bdf58360865a7524
    Loom-Build: unknown d2a55ce217b3ad1793611a2c54946676bb55b512 clean
    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
2026-10-08 feat: cite T1 item 11 (analog) via substrate tie by well assertion; pin klt v0.6.0 (#54)
    Bump KLT_REV to c622e8ad (v0.6.0), declare psub_guard_ring tie (well_layer null,
    well_boxes from committed guard-ring geometry), regenerate ERC/LVS/DRC reports
    against the unchanged array GDS, cite 11.analog, regenerate signoff record.
    Convert partition_boundary to the per-partition object v0.6.0 requires.
    Loom-Story: 2AMLogic/sky130-gcedram#54
    Loom-Trace-Id: 1218768bfdfa5a2a8716fad368f25e58
    Loom-Build: 0.19.868 ee904e1c151bc9cf15b0eb55dfe9d57ad6136cff clean
2026-10-09 ci: run evidence-chain Python checks in CI and npm test (#61)
    Loom-Story: 2AMLogic/sky130-gcedram#61
    Loom-Trace-Id: 7b9dcf30993b0ec5e93623e44948263d
    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
2026-10-09 feat: refresh-overhead envelope over N_rows x t_row_refresh_op (#59)
    Loom-Story: 2AMLogic/sky130-gcedram#59
    Loom-Trace-Id: 1eb45abe18ed93b53dff69c3660d0d57
    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
    [refresh_overhead_breakeven.csv, refresh_overhead_results.csv]
2026-10-09 refactor(sim): consolidate duplicated SPICE/waveform helpers into _evidence_common (#58)
    Loom-Story: 2AMLogic/sky130-gcedram#58
    Loom-Trace-Id: 74e8c66bf3010b8b8421b833d8076e72
    Loom-Build: 0.19.898 3d55b9a1669c132d130d98f10a292c1325322c30 clean
2026-10-09 chore: resync installed Loom surfaces
    <!-- loom:provenance v1 build=unknown 05dba463c5b293d38f0ca071725983862498b3f3 clean prompts=none sweep=none story=none trace=14298316053024bcf5120bff695771ab host=robb-pro base=747143790aa4e0a7848115d9c0fe3f1f9efe9adc run=loom-run/v1:timer:robb-pro/fleet-resync:2f384483-6d77-4ba2-9888-aa1e4b5be36c installs=0.19.953 b93d7a955d63411cb4c94b986fd5138d27dedb0f -->
    Loom-Trace-Id: 14298316053024bcf5120bff695771ab
    Loom-Build: unknown 05dba463c5b293d38f0ca071725983862498b3f3 clean
    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
2026-10-09 fix(signoff): scope items 3/4 evidence to analog partition (#55)
    Rename evidence keys 3 -> 3.analog, 4 -> 4.analog; regenerate signoff
    record with pinned KLT_REV. t1_met_count 5 -> 3 (intended).
    Loom-Story: 2AMLogic/sky130-gcedram#55
    Loom-Trace-Id: d509515ffbb5239fda85d2e5e5ff2359
    Loom-Build: 0.19.950 72047016af9d66c08f900bb94c642a66dfd75fc5 clean
2026-10-09 chore: resync installed Loom surfaces
    <!-- loom:provenance v1 build=unknown 7f06b288b150f2fe0a4b24c331a9b3ec093d709d clean prompts=none sweep=none story=none trace=a90c217ff3a3bd9e3a30282b8cadc24d host=robb-pro base=62bcdd1d5f34c2e3e44f70fb37f6a9cbcccd431b run=loom-run/v1:timer:robb-pro/fleet-resync:6e5ec9f3-d6ef-4953-80f7-c93035e2d359 installs=0.19.967 cc9c6cf61d1aebc3153cd1588ca304445a6b9ced -->
    Loom-Trace-Id: a90c217ff3a3bd9e3a30282b8cadc24d
    Loom-Build: unknown 7f06b288b150f2fe0a4b24c331a9b3ec093d709d clean
    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
2026-10-09 docs(spec): propose restricted operating range for outcome C (#56)
    Loom-Story: 2AMLogic/sky130-gcedram#56
    Loom-Trace-Id: 3f35a5675668f22e0619dd07612c446f
    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
2026-10-09 ci(sim): guard simulation evidence with exact byte-prefix comparisons (#67)
    Add sim/check_append_only.py, a stdlib-only checker that compares committed
    blobs at merge-base(BASE, HEAD) against HEAD. Protected paths come from the
    merge-base tree: every tracked file under a `results` directory in sim/,
    plus entries in sim/append_only_inventory.txt (currently empty). CSV must
    keep its old bytes as an exact prefix (EOF append only; a nonempty CSV
    lacking a final LF may not change); other evidence must be byte-identical;
    deletion, rename and move fail regardless of rename detection. Missing
    commits, shallow history, no merge base and git/blob errors exit 2. No
    bypass.
    sim/test_append_only.py exer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
2026-10-09 docs(spec): correct max '1' latency column and derived statements (#56)
    Regenerate section 4 latency column from pass_fail_20261005T145658Z.csv
    (phase2_baseline; seconds converted to ns), drop false ss/27C 0.15 ns
    claims, restate section 7 via fs/27C as thinnest margin, trim README
    trailing blank line.
    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
2026-10-09 docs(readme): reference proposed restricted operating range and cold-corner evidence (#63)
    Loom-Story: 2AMLogic/sky130-gcedram#63
    Loom-Trace-Id: cc2c5ab4fa105f13a67c22cfbdda4138
    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
2026-10-09 ci: run refresh-overhead and evidence_common tests; make test_refresh_overhead python -I safe (#73)
    Loom-Story: 2AMLogic/sky130-gcedram#73
    Loom-Trace-Id: ebafaebda6446b2179237c327133fb12
    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
2026-10-09 feat(sim): sense-stage characterization at the restricted corners (#60)
    Latch sense stage driven per SENSE_INPUT_CONTRACT.md over the PROPOSED
    (unratified) 27/125 C restricted range; 10-corner grid run as one klt sim
    batch job. Finding on the VDD/2 delta_V assumption recorded without
    editing the spec.
    Loom-Story: 2AMLogic/sky130-gcedram#60
    Loom-Trace-Id: 7bf733880220fcfd0ae1f6b1d62cfb9b
    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
    [sense_points_20261009T131831Z.csv]
2026-10-09 feat(digital): refresh scheduler behavioral model with deadline-invariant testbench (#74)
    Loom-Story: 2AMLogic/sky130-gcedram#74
    Loom-Trace-Id: e55b272f63d0fd3921de2530b877d866
    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
2026-10-09 docs(spec): propose macro-level pass conditions for epic #24 items 2-6 (#82)
    Loom-Story: 2AMLogic/sky130-gcedram#82
    Loom-Trace-Id: f7b3f339f422dc75ddde75981a2b4be3
    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
2026-10-09 feat(digital): proposed SPI control interface behavioral model with mutation-tested testbench (#83)
    Loom-Story: 2AMLogic/sky130-gcedram#83
    Loom-Trace-Id: 451a6c3f5aa8944b08884d23470e8cf1
    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
2026-10-09 feat(layout): extract 4x4 array bitline/wordline/sn parasitics (#80)
    Run klt extract --parasitics on the committed 4x4 shared-tap array with
    every signal net named --critical-net, and commit the extraction beside
    the single-cell one. array_parasitics.py reduces it, plus a scratch
    2x4/4x4/8x4 row-scaling set (each gated on routed/DRC-clean/LVS-match),
    into a summary JSON. layout/README.md gets a write-up.
    Key results (wiring parasitics only):
    - worst rbl_<c>, 4 rows: 0.859 fF total (0.581 ground + 0.278 coupling),
    0.086x the 10 fF C_RBL assumption
    - per-row increment 0.256 fF total; extrapolation labelled ASSUMPTION
    - array sn_<r>_<c>: 0.474-0.502 fF, 17-22% below the single-cell
    0.60535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
2026-10-09 fix(digital): require MAX_INTERVAL to be supplied; drop retyped bound from README (#83)
    Remove the numeric MAX_INTERVAL defaults from spi_slave.v and tb_spi_slave.v
    so a missing override is an elaboration error instead of a stale bound.
    run_tests.sh selects the TB top explicitly (-s) and supplies the value from
    params.py. README points at params.py instead of quoting the numbers.
    Re-ran run_tests.sh (ALL PASS) and run_mutation.sh (8/8 killed); dated
    results are unchanged.
    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
    [spi_slave.v, tb_spi_slave.v]
2026-10-09 feat(sim): Monte Carlo mismatch study of the sense stage (#81)
    Add sim/sense-mismatch/: stage-only latch offset Monte Carlo at
    tt/27, fs/27, ss/125, sf/125 (sky130 *_mm sections, MC_MM_SWITCH=1,
    klt sim monte_carlo n=40 seed 2026100981, batch fleet job
    klt-sim-17a21079e70b) and an end-to-end cell+column variant at the
    least-margin corner fs/27 (job klt-sim-56a2e9d55c36).
    - generator reuses the sense-stage latch/timing by import; 150 replica
    latches per sample, 6000 decisions per corner
    - analysis: probit ML fit with profile-likelihood 95% CIs, Wilson
    intervals per differential, rule-of-three resolution bound,
    extrapolated differential at ASSUMPTION error-rate targets
    - latch offset si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
    [mismatch_cell_points_20261009T141826Z.csv, mismatch_points_20261009T141819Z.csv]
2026-10-09 feat(digital): integrate SPI config with runtime refresh scheduler and verify transitions (#93)
    Adds digital/control-integration: proposed transfer contract, runtime-
    configurable scheduler derived from #74, SPI-to-clk snapshot transfer, combined
    top, self-checking integration bench (per-row monitors, multiple SPI/clk phase
    relationships, both sourced intervals), lockstep equivalence vs the unchanged
    #74 scheduler, and 12-mutant fault injection. spi_slave gains default-off
    MIN_INTERVAL/XSTAT_EN; standalone results re-run and appended. Behavioral only;
    no CDC/synthesis/sign-off claims.
    Loom-Story: 2AMLogic/sky130-gcedram#93
    Loom-Trace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
2026-10-09 docs(spec): density vs public 6T SRAM from the committed 4x4 array (#97)
    Loom-Story: 2AMLogic/sky130-gcedram#97
    Loom-Trace-Id: 134a766ac78ecf4833cb5634e7f57584
    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
2026-10-09 feat(sim): write-disturb study of unselected and half-selected cells in the extracted 4x4 array (#98)
    Generator, flat deck, klt request, analyzer and unit tests for
    sim/write-disturb, plus the batch run of the 10-corner restricted range
    (fleet job klt-sim-9cd63f28e1c1) as append-only evidence. Half-select and
    repeated-toggle cases, both polarities, no-disturb and leaky-device negative
    controls; disturb reported as a fraction of delta_V and as equivalent
    retention loss. sf/125 C flagged at 16.4 % of delta_V (kept, not tuned away).
    Spec and the 5.03 us refresh bound are untouched.
    Loom-Story: 2AMLogic/sky130-gcedram#98
    Loom-Trace-Id: 0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
    [disturb_halfselect_20261009T172606Z.csv, disturb_points_20261009T172606Z.csv]
2026-10-09 docs(sim): define correction-record mechanism for appended evidence (#68)
    Loom-Story: 2AMLogic/sky130-gcedram#68
    Loom-Trace-Id: 8501e26a87281c0c833b900c3565c265
    Loom-Build: 0.19.972 113c7f31d7d16f75d30c470023e0b65b29b1fe94 clean
2026-10-09 ci: run behavioral SPI/refresh/integration Verilog regressions with pinned Icarus (#105)
    Loom-Story: 2AMLogic/sky130-gcedram#105
    Loom-Trace-Id: 6856dd08ccad96d112486cd610984bea
    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
2026-10-09 chore: resync installed Loom surfaces
    <!-- loom:provenance v1 build=unknown 30c7a7ee2f74a6a2b5bb0f19fd9f049ec8ae8b5c clean prompts=none sweep=none story=none trace=7bc5ba399ff199d049d83d711920a157 host=robb-pro base=1a2de5edffafecf8a7cf6602b1d03bb229258e84 run=loom-run/v1:timer:robb-pro/fleet-resync:8e237160-c4d0-4ce3-85ac-c96aff5cf221 installs=0.19.982 2bc4cba624b9053535663441e6f0daf08a7acf2e -->
    Loom-Trace-Id: 7bc5ba399ff199d049d83d711920a157
    Loom-Build: unknown 30c7a7ee2f74a6a2b5bb0f19fd9f049ec8ae8b5c clean
    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
2026-10-09 docs(ci): record uncached hosted run and justify timeout (#105)
    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
2026-10-09 docs(ci): record cache-hit run and injected-fault demonstration (#105)
    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
2026-10-09 design: commit sense latch schematic + derived netlist tied to sense-stage deck (#109)
    Loom-Story: 2AMLogic/sky130-gcedram#109
    Loom-Trace-Id: 2ae99dda46e7515155ec22b4ff243b2d
    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
    [sense_latch.sch]
2026-10-09 feat(digital): behavioral analog phase sequencer, contract and mutation suite (#108)
    Loom-Story: 2AMLogic/sky130-gcedram#108
    Loom-Trace-Id: 1bb30c17b287534822addea61ee6a802
    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
2026-10-09 feat(ci): local auditor bootstrap for pinned Icarus Verilog (#92)
    Loom-Story: 2AMLogic/sky130-gcedram#92
    Loom-Trace-Id: b436feb3449a67058f5590211ba8ef3c
    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
2026-10-09 design: column-periphery slice (precharge PMOS, write driver, isolation) + ideal-vs-real comparison (#114)
    Loom-Story: 2AMLogic/sky130-gcedram#114
    Loom-Trace-Id: 3aeeecf9c02df02c198dcc459b196336
    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
    [column_periphery.sch, periphery_points_20261009T204412Z.csv]
2026-10-09 fix(column-periphery): scale nrd/nrs in precharge width sweep; corrected run (#114)
    set_width rewrote W, ad/as and pd/ps for the MPPRE width sweep but left
    nrd/nrs at the W=4 value (0.0725) for every swept width. It now applies the
    full single-finger convention of the design/ netlists (nrd = nrs = 0.29/W)
    and fails loudly if any geometry key is missing.
    design/test_column_periphery.py now parses and compares every geometry
    parameter (nf, ad/as, pd/ps, nrd/nrs, sa/sb/sd, mult/m) and derives the
    sweep expectation independently; it fails on the previous deck
    (sw_0100/0200/0800) and passes on the regenerated one.
    Re-ran the grid on the batch fleet (klt 0.6.0, job klt-sim-e8a94973d1fc)
    as new r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
    [periphery_points_20261009T205913Z.csv]
2026-10-09 docs: refresh Guide work plan from current backlog
2026-10-10 sim: closed-loop refresh operation, measured t_row_refresh_op (#110)
    New sim/refresh-op study: generator, klt sim request (10 corners, batch fleet job klt-sim-b8eb5b20d95e), analyzer, stdlib test, append-only results. Appends a measured-t_row overhead record to sim/refresh-overhead/results.
    Loom-Story: 2AMLogic/sky130-gcedram#110
    Loom-Trace-Id: 025b8017ebba15b4f965a514a1de0ee2
    Loom-Build: 0.19.996 0d2be7e9ae05753e2c9232a83b7399d45de5396e clean
    [refresh_op_points_20261010T005003Z.csv, refresh_overhead_measured.csv]
2026-10-10 chore: resync installed Loom surfaces
    <!-- loom:provenance v1 build=unknown a7d2b01d8eb7d09e597a4638e5cb3cdd8bab9156 clean prompts=none sweep=none story=none trace=35c1337ee84607e87ba2038523d63198 host=robb-pro base=d600b748e9b0ea78f901529d46eeceac767c6a3e run=loom-run/v1:timer:robb-pro/fleet-resync:6bf32a81-6c4a-48c5-a51e-1ad65c6bedfd installs=0.19.1001 1c1131220b2f5950fe54b7cd02ebd3f1aae488dd -->
    Loom-Trace-Id: 35c1337ee84607e87ba2038523d63198
    Loom-Build: unknown a7d2b01d8eb7d09e597a4638e5cb3cdd8bab9156 clean
    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
2026-10-10 sim(refresh-energy): generator, deck, requests, analyzer and tests for array refresh energy (#115)
    Ideal-driver array-boundary energy of one row refresh replayed on the
    extracted 4x4 array (#110 phases, 10 ns sense, 10 ns write-back), per-source
    signed/gross/recovered integration, matched idle subtraction, restore
    classification, convergence repeat request, scoped scaling. Stdlib tests
    wired into evidence-checks CI and the npm test entry point. Batch evidence
    follows in a separate commit.
    Loom-Story: 2AMLogic/sky130-gcedram#115
    Loom-Trace-Id: 36a18b577b1a07f8b59d083a64808060
    Loom-Build: 0.19.996 0d2be7e9ae05753e2c9232a83b7399d45de5396e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
2026-10-10 sim(refresh-energy): batch evidence, reduction and write-up for array refresh energy (#115)
    Main grid fleet job klt-sim-428eb23d9a2b and 5 ps convergence repeat
    klt-sim-4380e2ec6bd1 (10/10 corners each). Max measured E_row_incremental
    2.46 pJ at sf/125 C all-one, 99 % from deselected-RWL read-path current;
    idle 0.44-0.72 nW at 125 C, 27 C idle at the gmin floor (flagged).
    sf/27 C all-zero and checkerboard are UNRESOLVED (restore status differs by
    resolution); all-zero net energy does not converge (reported). Scaling
    flags infeasible schedules and states that linear scaling likely
    understates taller arrays. Evidence registered in the append-only inventory.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
    [refresh_energy_points_20261010T055142Z.csv, refresh_energy_scaling_20261010T055142Z.csv, refresh_energy_sources_20261010T055142Z.csv]
2026-10-10 chore: resync installed Loom surfaces
    <!-- loom:provenance v1 build=unknown c156f673e072832aaacb4cd1ec65b742e7f45867 clean prompts=none sweep=none story=none trace=9de99c124c651049199abe9a75070dc7 host=robb-pro base=c6420a7eda1ca1af98de26c80860977c76083411 run=loom-run/v1:timer:robb-pro/fleet-resync:f790885c-7154-4b3d-acd9-71fd537cd20b installs=0.19.1010 d1d5fcecb79550fe39658555a4419f98cec060fb -->
    Loom-Trace-Id: 9de99c124c651049199abe9a75070dc7
    Loom-Build: unknown c156f673e072832aaacb4cd1ec65b742e7f45867 clean
    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
2026-10-10 chore: resync installed Loom surfaces
    <!-- loom:provenance v1 build=unknown 52f79668bb5f93c1828b7f1ea4f7013b917b847b clean prompts=none sweep=none story=none trace=7057f3175071f1f6e34b354fab40a0ce host=robb-studio base=f36f99ae1771646d62a9a30b82e1122a60107329 run=loom-run/v1:timer:robb-studio/fleet-resync:d8918779-1625-4202-b151-71f64465e8cd installs=0.19.1010 d1d5fcecb79550fe39658555a4419f98cec060fb -->
    Loom-Trace-Id: 7057f3175071f1f6e34b354fab40a0ce
    Loom-Build: unknown 52f79668bb5f93c1828b7f1ea4f7013b917b847b clean
    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
2026-10-10 docs(sim): narrow 'a PR cannot weaken the check' claim for append-only guard
    Closes #72
    Loom-Story: 2AMLogic/sky130-gcedram#72
    Loom-Trace-Id: b0586b05f82652e6a2f9f3e3fcc6b469
    Loom-Build: 0.19.1009 8889f7bd1eccfb4bc8239e7f5669b65f9815c30e clean
2026-10-10 feat(sim): RTL strobe trace export, PWL converter and replay generator/analyzer (#128)
    Loom-Story: 2AMLogic/sky130-gcedram#128
    Loom-Trace-Id: 38447f951cc9eeff152d8609c62c415e
    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
2026-10-10 docs(sim): refresh-replay run 20261010T094617Z (RTL waveform fails restoration at 10/10 corners)
    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
    [points.csv]
2026-10-10 docs(sim): correct post-WWL-fall SN ranges in refresh-replay README
    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
2026-10-10 feat(sim): refresh-replay release-order attribution experiment (#131)
    Adds five single-edge RWL/latch-release variants, per-edge SN/WBL/latch probes,
    a causal-attribution reducer and tests; new append-only run 20261010T130000Z
    (batch job klt-sim-b8ad51731243). RWL release after WWL fall restores 10/10 in
    the ideal-driver circuit; latch-hold contributes but is not sufficient.
    Loom-Story: 2AMLogic/sky130-gcedram#131
    Loom-Trace-Id: 61a8651d09c9c595ef427f6d3599f3e7
    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
    [points.csv]
2026-10-10 feat(digital): scheduler-to-phase-sequencer integration harness and timing report (#135)
    Loom-Story: 2AMLogic/sky130-gcedram#135
    Loom-Trace-Id: 06ed08328b5f6c7f1b055dc3bba7a084
    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
2026-10-10 feat(sim): RWL driver slew/impedance/release-delay sweep generator, analyzer, tests (#134)
    Loom-Story: 2AMLogic/sky130-gcedram#134
    Loom-Trace-Id: 7b3e340450e12cb6ffcb026a0e00a41a
    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
2026-10-10 feat(sim): RWL driver sweep run 20261010T130833Z (batch job klt-sim-2480fb15ca17) and refine profile (#134)
    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
    [points.csv]
2026-10-10 fix(sim): keep legacy start regime in the RWL driver sweep, add pin-IC artifact check; drop confounded first runs (#134)
    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
    [points.csv]
2026-10-10 fix(sim): lower-case RWL driver sweep point ids (fleet runner .meas case sensitivity)
    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
2026-10-10 fix(sim): sample the series-R pin release instead of .meas WHEN crossings; pin crossings via interpolation
    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
2026-10-10 feat(sim): RWL driver slew/impedance/release-delay sensitivity run 20261010T141816Z (klt-sim-7e6455aebff7) and README (#134)
    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
    [points.csv]
2026-10-10 fix(sim): pattern-aware aggregate pin-release budget, per-driver release-margin wording (#134)
    [points.csv]
2026-10-10 chore: resync installed Loom surfaces
    <!-- loom:provenance v1 build=unknown 525fe43b7b1b2a0271084bba444c934a1541a8d8 clean prompts=none sweep=none story=none trace=0d4424bd058cf912b74934ec0e7bf37e host=robb-pro base=08641f582878b5b4de7617e671f593d506b628ea run=loom-run/v1:timer:robb-pro/fleet-resync:4812047c-8b9b-4da2-a5dc-13e6f6420a04 installs=0.19.1018 13e54f1cfc513507a7ef84ec6908085638d9c187 -->
    Loom-Trace-Id: 0d4424bd058cf912b74934ec0e7bf37e
    Loom-Build: unknown 525fe43b7b1b2a0271084bba444c934a1541a8d8 clean
    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
2026-10-10 chore: resync installed Loom surfaces
    <!-- loom:provenance v1 build=unknown 525fe43b7b1b2a0271084bba444c934a1541a8d8 clean prompts=none sweep=none story=none trace=d4059def94f46d8d158946acddd4d602 host=robb-studio base=f909c69d8bc89e6fbe278f57dea14acb229b48b4 run=loom-run/v1:timer:robb-studio/fleet-resync:4a4d1995-968e-44c5-b5fe-804b4d477795 installs=0.19.1019 febfc4335d0554865fadbecba718245cd88c6678 -->
    Loom-Trace-Id: d4059def94f46d8d158946acddd4d602
    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
2026-10-10 feat(digital): coupled scheduler/sequencer budgets with executed-completion deadline monitors (#138)
    Derive T_ROW/T_ACC from phase durations + launch latency in a separate coupled
    configuration; independent deadline/coverage monitors on executed completions;
    re-derived legal interval floor (per-op decision cycle); config gate, negative
    controls and 14 mutants. Existing suites unchanged and passing.
    Loom-Story: 2AMLogic/sky130-gcedram#138
    Loom-Trace-Id: d0b0a9f0e763c4286899cbbdf2947508
    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
2026-10-10 docs: refresh completed work and current implementation queue
2026-10-10 feat(sim): matched initialization-control generator, analyzer and tests for the refresh replay (#139)
    Three regimes of the unchanged #131 circuit/waveforms (legacy, explicit idle-high
    RWL pin IC, zero-hold physical write/settle preparation) plus a no-write
    initialization negative control. Every instance is verified to differ from its
    legacy counterpart only by its regime's declared changes. The analyzer keeps
    intended level, achieved post-write level, measured pre-read level, signed
    sense decision and restoration fraction separate; a restore ratio can never
    pass an incorrect sense decision.
    Loom-Story: 2AMLogic/sky130-gcedram#139
    Loom-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
2026-10-10 feat(sim): count restoration only among sense-correct records in the init-control analysis (#139)
    Loom-Trace-Id: cb2a8f657d468b01418d6111b918b166
    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
2026-10-10 feat(sim): matched initialization-control run 20261010T163500Z (klt-sim-525deb23471f) and README (#139)
    One klt sim batch request, 10/10 corners. legacy reproduces the #131 controls
    (40/40 verdicts) and pin_ic the #134 ic_artifact_check points (30/30); the
    start-up uplift (+0.10..+0.18 V for stored '1') and the corrected stored-'1'
    0.9 V sense failures at ss/27 and fs/27 are reproduced and retained. A
    zero-hold physical write of the label voltage achieves 0.70-0.74 V for the
    0.9 V label and is sensed wrongly at 9/10 corners. The decision is monotone in
    the measured pre-read level in every corner, so regime differences are
    attributed to preparation. Restoration among sense-correct records is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
    [points.csv]
2026-10-10 chore: resync installed Loom surfaces
    <!-- loom:provenance v1 build=unknown 5d5f41d89eef35adf478b92b96af06c6d86d27a6 clean prompts=none sweep=none story=none trace=05d2a40831b35ba1c48afada00c29519 host=robb-pro base=c6e7c2c070477cdad2b5bffa6416c18792e0d8eb run=loom-run/v1:timer:robb-pro/fleet-resync:c58bb82e-a213-439d-b829-04234e141de9 installs=0.19.1029 eeede923872426614b8def90ca3cf6fd0a4ba07e -->
    Loom-Trace-Id: 05d2a40831b35ba1c48afada00c29519
    Loom-Build: unknown 5d5f41d89eef35adf478b92b96af06c6d86d27a6 clean
    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
2026-10-10 chore: resync installed Loom surfaces
    <!-- loom:provenance v1 build=unknown aa536103d6239818bb974a51d2f7f268eff38bad clean prompts=none sweep=none story=none trace=126a1328a3664e2119a0978086db9bea host=robb-studio base=d09f7dc634ccf482a5e56b38678a0c75c0aa6618 run=loom-run/v1:timer:robb-studio/fleet-resync:fbc4e361-e290-4d81-ae3a-8b5fde796815 installs=0.19.1032 13ca937a7d6ba8768c296b0c126f2ce48f5f7ca4 -->
    Loom-Trace-Id: 126a1328a3664e2119a0978086db9bea
    Loom-Build: unknown aa536103d6239818bb974a51d2f7f268eff38bad clean
    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
2026-10-10 test: run all evidence-checks suites in npm test (#78)
    Loom-Story: 2AMLogic/sky130-gcedram#78
    Loom-Trace-Id: 49f27e84bee6dc16eee360f86ddc3d79
    Loom-Build: 0.19.1026 09a449709f5a1c6ae81b471ef56d466247e50808 clean
2026-10-11 feat(retention): array-context C_SN comparison and proposed spec decision (#89)
    - sim/retention/compare_array_c_sn.py: reduce every sn_<r>_<c> in the
    committed 4x4 extraction with derive_retention.load_extracted_c_sn(),
    select the limiting node deterministically, record input hashes, and
    report a capacitance-only retention sensitivity against the ratified
    pre-layout and isolated-cell extracted baselines (ratios derived from
    reports/CSV rows, not hardcoded). Traces AD/AS/PD/PS of the leakage
    testbench, schematic and extracted devices. Default derivation path and
    retention_results.csv untouched; output is a new append-only JSON.
    - Focused stdlib tests, wired into npm test and evi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
2026-10-11 docs(retention): link geometry-matched leakage follow-up #149 (#89)
    Loom-Story: 2AMLogic/sky130-gcedram#89
    Loom-Trace-Id: 85f888ebe61986086655365102cda3b1
    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
2026-10-11 feat(digital): SPI-configured scheduler driving the phase sequencer with independent per-row completion scoreboard (#146)
    Loom-Story: 2AMLogic/sky130-gcedram#146
    Loom-Trace-Id: 28ce83726702df6d04bcce27287d5a2c
    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
2026-10-11 chore: resync installed Loom surfaces
    <!-- loom:provenance v1 build=unknown cf08873555e2eb95da295dcbee98b0dc34473381 clean prompts=none sweep=none story=none trace=67fbc483c3ca3e442d7928804c11ff06 host=robb-pro base=0e899f1e3d55c0909a3fea0893ad0a72398a49dd run=loom-run/v1:timer:robb-pro/fleet-resync:e3f97888-2b26-404a-bd47-86fd28a4eced installs=0.19.1041 b65c266b47d796bf37d1c04c6f616be0bc699056 -->
    Loom-Trace-Id: 67fbc483c3ca3e442d7928804c11ff06
    Loom-Build: unknown cf08873555e2eb95da295dcbee98b0dc34473381 clean
    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
2026-10-11 chore: resync installed Loom surfaces
    <!-- loom:provenance v1 build=unknown e91831edf7b55b29d3a2d88e266916fab9ce2563 clean prompts=none sweep=none story=none trace=f72dd67520a2c3802aa0495b80ac65a5 host=robb-studio base=d814ae4ebe78f3ce700e7490004848d0a1f341e9 run=loom-run/v1:timer:robb-studio/fleet-resync:91d2434e-eae5-45de-9305-d78c43fc7c7a installs=0.19.1043 1f414afc0388fba3ddd4b792d653b22230c33389 -->
    Loom-Trace-Id: f72dd67520a2c3802aa0495b80ac65a5
    Loom-Build: unknown e91831edf7b55b29d3a2d88e266916fab9ce2563 clean
    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
2026-10-11 feat(layout): pin the array generation toolchain and compare --check output against the committed 4x4
    generate_array.sh and the scaling builds in extract_array_parasitics.sh
    used whatever klt was on PATH. The committed 4x4 array no longer
    reproduced, and --check only gated on routing/DRC/LVS/ERC status.
    - layout/generation-toolchain.json holds the one shared pin. Generation
    uses klayout-tools 2dd24b09e756 with klayout 0.30.12, which scratch
    regeneration showed reproduces all committed generation outputs
    byte-for-byte. Check (drc/lvs/erc) uses c622e8a (0.6.0, the signoff.yml
    revision). The PDK is pinned to open_pdks c6d73a35.
    - layout/generation_toolchain.py verifies the klayout-tool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
2026-10-11 evidence(layout): record the pinned 4x4 reproduction run
    Output of `./layout/generate_array.sh --check --record ...` at 67147e0
    (clean tree). The generation toolchain is klayout-tools 2dd24b09e756 with
    klayout 0.30.12. The check toolchain is c622e8a (0.6.0) with klayout
    0.30.12. The PDK is sky130A at open_pdks c6d73a35. All seven compared
    artifacts are byte-identical to the committed array. The run had no
    unrouted nets, DRC clean, LVS match and ERC clean.
    Closes #91
    Loom-Issue: 2AMLogic/sky130-gcedram#91
    Loom-Story: 2AMLogic/sky130-gcedram#91
    Loom-Trace-Id: 2e190f6c3eef5cabd8620bdf0447ed7b
    Loom-Build: 0.19.1039 e83d19dc0a9b217339ea2f1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
2026-10-11 feat(leakage): geometry-matched access-device leakage at extracted AD/AS/PD/PS (batch, 15 PVT)
    Closes #149
    Loom-Story: 2AMLogic/sky130-gcedram#149
    Loom-Trace-Id: 348a8d190dfd598322bc1965080da797
    Loom-Build: 0.19.1039 e83d19dc0a9b217339ea2f14040c50ad6f46700d clean
2026-10-11 fix(leakage): bind geometry reducer to deck hash, PDK pin and A units
    Reject reports whose netlist hash does not match the generated deck, whose
    PDK provenance differs from the pinned open_pdks commit, or whose
    measurement units are not A. Check the deck renders from the extraction
    geometry before publishing. Add negative regression tests; correct the
    control-agreement bound to 2.3e-6.
2026-10-11 docs(digital): PROPOSED SPI crossing and reset architecture with Icarus protocol model (#157)
    Loom-Story: 2AMLogic/sky130-gcedram#157
    Loom-Trace-Id: c688929db72505d19c444e2ddaf26dc2
    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
2026-10-11 test(digital): exercise the mailbox refusal path with a directed violated-obligation test (#157)
    Judge finding on PR #158: the mailbox-occupied refusal path was never
    exercised; all observed refusals came from the START_SWEEP sweep
    reservation, yet C3 / Sec. 8.2 / Sec. 8.4 credited the bench with
    mailbox refusals.
    - tb_xing.v: new directed T5. sclk half 50 ps, cs_n high 0.1 ns, so the
    mailbox commit right after an accepted one lands 1.8 ns later, before the
    clk side can capture it (>= 2 Tc). Checks: IVL_H and START_SWEEP refused
    by the mailbox (exactly 2), ERR_BUSY set, bundle and applied config
    untouched, exactly-once scoreboard clean, retry applies 0x775A.
    Frame gap is now a run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
2026-10-11 chore: resync installed Loom surfaces
    <!-- loom:provenance v1 build=unknown 5ec729b9f7dd55a2082752611e4c4964f49661fb clean prompts=none sweep=none story=none trace=efc2abc8b72538df6d1a6ea9d329603d host=robb-pro base=35b29372c43084b7406bd5dbe99b694fdbc3ecae run=loom-run/v1:timer:robb-pro/fleet-resync:0d396c06-f26e-423e-97ac-6d3ac04a8e51 installs=0.19.1056 4e44d8f5faa6c6c58d2a3436ce3a983613cf375a -->
    Loom-Trace-Id: efc2abc8b72538df6d1a6ea9d329603d
    Loom-Build: unknown 5ec729b9f7dd55a2082752611e4c4964f49661fb clean
    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
2026-10-11 chore: resync installed Loom surfaces
    <!-- loom:provenance v1 build=unknown 745f69d0daad6c23e76cc006720fa4fbeaa3d887 clean prompts=none sweep=none story=none trace=3baabc4a039fd85029fff227a6ae690a host=robb-studio base=3311cfb29ba1b9066cd64e8f0f835e5f7c0c9d4a run=loom-run/v1:timer:robb-studio/fleet-resync:3b3207d7-055d-49b5-a387-db375213668d installs=0.19.1061 5f9bd7c9c14c4557db7de006b6e0cd318ba7e72d -->
    Loom-Trace-Id: 3baabc4a039fd85029fff227a6ae690a
    Loom-Build: unknown 745f69d0daad6c23e76cc006720fa4fbeaa3d887 clean
    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
2026-10-11 docs: update work log and plan after SPI crossing proposal
2026-10-11 chore: resync installed Loom surfaces
    <!-- loom:provenance v1 build=unknown b37a005ac1889262fb9e5338f7cff4e9ed4987da clean prompts=none sweep=none story=none trace=25c158d7e9591610b251780caaff1c5f host=robb-pro base=0feb811cc9914a6dc69e8430239014e750dd3800 run=loom-run/v1:timer:robb-pro/fleet-resync:7f020bca-6920-47f7-a5e4-bbd5c82d9bb8 installs=0.19.1072 29b48db1ead9c4501304e0114a5c33310e1d589f -->
    Loom-Trace-Id: 25c158d7e9591610b251780caaff1c5f
    Loom-Build: unknown b37a005ac1889262fb9e5338f7cff4e9ed4987da clean
    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
2026-10-11 chore: resync installed Loom surfaces
    <!-- loom:provenance v1 build=unknown 81a6b4499cb57b3620785bc1625c300da34f0735 clean prompts=none sweep=none story=none trace=d08bbd290651d7bcbda8b216c0dfbcdf host=robb-studio base=e9c1fba8d135188edb2480d350b0b2a02ab12c84 run=loom-run/v1:timer:robb-studio/fleet-resync:71e05e3d-931c-46b4-b6d2-5f3f992c1e19 installs=0.19.1074 3f77416f918ffc23fb54dccf18d864073f99b142 -->
    Loom-Trace-Id: d08bbd290651d7bcbda8b216c0dfbcdf
    Loom-Build: unknown 81a6b4499cb57b3620785bc1625c300da34f0735 clean
    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
2026-10-12 chore: resync installed Loom surfaces
    <!-- loom:provenance v1 build=unknown ddfb67ccf9a5115d62dd86924613a468b9328f44 clean prompts=none sweep=none story=none trace=772605234b9d8cafd6a4049200f7425c host=robb-pro base=25b599102640368fb2d6c9a6435dd71834390368 run=loom-run/v1:timer:robb-pro/fleet-resync:1ef28ffc-0277-424f-9224-7ee6eca46377 installs=0.19.1083 77a174ea7fcaddbb25d0082956cd25d8633fc2df -->
    Loom-Trace-Id: 772605234b9d8cafd6a4049200f7425c
    Loom-Build: unknown ddfb67ccf9a5115d62dd86924613a468b9328f44 clean
    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
2026-10-12 chore: resync installed Loom surfaces
    <!-- loom:provenance v1 build=unknown be358990895362019614bd207bcbe36bc9eeff2c clean prompts=none sweep=none story=none trace=f1dc643b95859c8f26e892ddb5e2c5d7 host=robb-studio base=90d3b0569994ecc19ff17e132a735386265b0ca1 run=loom-run/v1:timer:robb-studio/fleet-resync:da486ca2-3e94-4a85-abd3-88707942489a installs=0.19.1087 51ac271f990b317a52ebf27cc21f34561e1179fb -->
    Loom-Trace-Id: f1dc643b95859c8f26e892ddb5e2c5d7
    Loom-Build: unknown be358990895362019614bd207bcbe36bc9eeff2c clean
    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
2026-10-12 chore: resync installed Loom surfaces
    <!-- loom:provenance v1 build=unknown a579728c137cc11d08a48b178e0ff9aa21683e72 clean prompts=none sweep=none story=none trace=10832f2750dbcd63f6c6f301a6f4da9b host=loom-worker-2 base=f335a94644366d1c4c6ebb97f63ac01077ede6b0 run=loom-run/v1:timer:loom-worker-2/fleet-resync:180f6d5054f0479ab3990b86ab4522a5 installs=0.19.1087 51ac271f990b317a52ebf27cc21f34561e1179fb -->
    Loom-Trace-Id: 10832f2750dbcd63f6c6f301a6f4da9b
    Loom-Build: unknown a579728c137cc11d08a48b178e0ff9aa21683e72 clean
    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
2026-10-12 chore: resync installed Loom surfaces
    <!-- loom:provenance v1 build=unknown 02ecafe7734bf5faa945ce88940589f00eca78e9 clean prompts=none sweep=none story=none trace=5f71c537126994dc4c45179122427514 host=robb-pro base=2dacfebe14a6b3d3f9350efe6c6017ac991b0cb2 run=loom-run/v1:timer:robb-pro/fleet-resync:6293e6da-8a67-45aa-b277-c9ef85ddb810 installs=0.19.1102 c27d15b77f4cde3ec9ccad2d751107eee9c55a04 -->
    Loom-Trace-Id: 5f71c537126994dc4c45179122427514
    Loom-Build: unknown 02ecafe7734bf5faa945ce88940589f00eca78e9 clean
    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
2026-10-12 chore: resync installed Loom surfaces
    <!-- loom:provenance v1 build=unknown 5918da96dcd60c9a677a195737c86ea38972d215 clean prompts=none sweep=none story=none trace=49bb7a8942d6a23bf41754ca27ff2368 host=loom-worker-2 base=04b33167be0b8d6241e42a20c3a403541856fc5b run=loom-run/v1:timer:loom-worker-2/fleet-resync:2e973f04abd1447d8ee4b696c2e7d2b4 installs=0.19.1108 72427939d156341080a7006ae6fbb5ec96b2368e -->
    Loom-Trace-Id: 49bb7a8942d6a23bf41754ca27ff2368
    Loom-Build: unknown 5918da96dcd60c9a677a195737c86ea38972d215 clean
    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
2026-10-12 chore: resync installed Loom surfaces
    <!-- loom:provenance v1 build=unknown 01467247f32c59822968bf02d3214d9a3d613452 clean prompts=none sweep=none story=none trace=0e97e9733eef09a33959cf96e6271f40 host=robb-studio base=f04d0952c05f9bead3c8461abc82a940fd255fa0 run=loom-run/v1:timer:robb-studio/fleet-resync:53a4d390-3842-4216-9018-5dced9d0ea17 installs=0.19.1109 d9498fcd419776b2517e30b99c88e76bbe92d2f4 -->
    Loom-Trace-Id: 0e97e9733eef09a33959cf96e6271f40
    Loom-Build: unknown 01467247f32c59822968bf02d3214d9a3d613452 clean
    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
2026-10-12 chore: resync installed Loom surfaces
    <!-- loom:provenance v1 build=unknown acadc2b4b0e852f2d889ac9dec616e1548705802 clean prompts=none sweep=none story=none trace=a69edb348af7f0e67b3bc77bc33b1bfc host=loom-worker-2 base=ed91423f55f43799ba672c7fdbefd8493ae19480 run=loom-run/v1:timer:loom-worker-2/fleet-resync:0923627ffda84cf69ec2486475772b10 installs=0.19.1126 7736d1276b6d01778fba3461114c858ef1bf5e2d -->
    Loom-Trace-Id: a69edb348af7f0e67b3bc77bc33b1bfc
    Loom-Build: unknown acadc2b4b0e852f2d889ac9dec616e1548705802 clean
    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
2026-10-12 chore: resync installed Loom surfaces
    <!-- loom:provenance v1 build=unknown 8d832cc8035d4ba07872510416468da0790332cd clean prompts=none sweep=none story=none trace=09a53bf60e96fc30a753caffd1de8c92 host=robb-studio base=b30cca129d5872fb768de0ad42bcf26a7621a533 run=loom-run/v1:timer:robb-studio/fleet-resync:baf4c30c-65d9-4d4e-a740-f6a80cbb975c installs=0.19.1134 6bde81b9a2c0b5d36d10ba4cedb6a3bb0a564100 -->
    Loom-Trace-Id: 09a53bf60e96fc30a753caffd1de8c92
    Loom-Build: unknown 8d832cc8035d4ba07872510416468da0790332cd clean
    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
2026-10-12 chore: resync installed Loom surfaces
    <!-- loom:provenance v1 build=unknown aa1ed0d7d5499d2705977d971673d919dbbbaf4e clean prompts=none sweep=none story=none trace=2522608826ef5d5e4a88a9667055aeb7 host=loom-worker-2 base=7130f19f9440acf40a8cf47640258cde3c4d1ea4 run=loom-run/v1:timer:loom-worker-2/fleet-resync:8f26b719c712455381744111c50e90b4 installs=0.19.1142 b91ae5d1b5204f499a1abb875a6cf5bffc1d90b1 -->
    Loom-Trace-Id: 2522608826ef5d5e4a88a9667055aeb7
    Loom-Build: unknown aa1ed0d7d5499d2705977d971673d919dbbbaf4e clean
    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
2026-10-12 chore: resync installed Loom surfaces
    <!-- loom:provenance v1 build=unknown 8b64614d017d6ce7491c3a2ac9da51e5e2901c97 clean prompts=none sweep=none story=none trace=66044c049ba635bcd6a4797c3a77e84b host=robb-pro base=8cb8faa07bfeecc540da4d91157d82a824a5a163 run=loom-run/v1:timer:robb-pro/fleet-resync:68f56594-05d0-4cc0-9c07-36263359d698 installs=0.19.1144 9e4381cbbd2386393e44c7a979583252948a3998 -->
    Loom-Trace-Id: 66044c049ba635bcd6a4797c3a77e84b
    Loom-Build: unknown 8b64614d017d6ce7491c3a2ac9da51e5e2901c97 clean
    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
2026-10-13 chore: resync installed Loom surfaces
    <!-- loom:provenance v1 build=unknown e66f00108a9519331aa981da8a01c6569ca623a9 clean prompts=none sweep=none story=none trace=d3e476cf8c03d5ed37f8e146b3632190 host=robb-studio base=b4d4357d4a195abda1dd7b63c35a7a02cd67d7bd run=loom-run/v1:timer:robb-studio/fleet-resync:1d7ace45-2daf-4c92-a752-67b11e982245 installs=0.19.1148 1448fdfa79ac2dcab7fad6b95b72697b450f2a4a -->
    Loom-Trace-Id: d3e476cf8c03d5ed37f8e146b3632190
    Loom-Build: unknown e66f00108a9519331aa981da8a01c6569ca623a9 clean
    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
2026-10-13 chore: resync installed Loom surfaces
    <!-- loom:provenance v1 build=unknown 98d08ab78cc223361354ee9947d996b1cb914b30 clean prompts=none sweep=none story=none trace=8b73addcdeaa8fbd65998649f42a8c50 host=loom-worker-2 base=586bd34e967df4eb310ee9984f8d5734074908c1 run=loom-run/v1:timer:loom-worker-2/fleet-resync:3bfb13d52fca425f9cfced4541954cb6 installs=0.19.1148 1448fdfa79ac2dcab7fad6b95b72697b450f2a4a -->
    Loom-Trace-Id: 8b73addcdeaa8fbd65998649f42a8c50
    Loom-Build: unknown 98d08ab78cc223361354ee9947d996b1cb914b30 clean
    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
2026-10-13 chore: resync installed Loom surfaces
    <!-- loom:provenance v1 build=unknown d0bfbbc7ac309581d7abe02c4a269c7704010ee0 clean prompts=none sweep=none story=none trace=0ad6d167235000f3b5648cbd63d761ce host=robb-pro base=ffbcf02a100bee07b9c7c635897c6d4471489f44 run=loom-run/v1:timer:robb-pro/fleet-resync:4f7cbe22-40b6-49ff-8811-003ae8577c28 installs=0.19.1151 021b947d121929157cd83df0576e7f2aa12500d7 -->
    Loom-Trace-Id: 0ad6d167235000f3b5648cbd63d761ce
    Loom-Build: unknown d0bfbbc7ac309581d7abe02c4a269c7704010ee0 clean
    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
2026-10-13 chore: resync installed Loom surfaces
    <!-- loom:provenance v1 build=unknown 7916c4043a1b57e97a53bc5c111e74c5038a1091 clean prompts=none sweep=none story=none trace=20b27ffb08c4130dc9836ee8d9d97b97 host=loom-worker-2 base=02f5fda1b0ae058c6c30aafae668d94493feee0a run=loom-run/v1:timer:loom-worker-2/fleet-resync:d34532ec625a4162ae8b58dde1a6738f installs=0.19.1151 f7d1deaab02a9c483fce1ced33fadb1af6d86f59 -->
    Loom-Trace-Id: 20b27ffb08c4130dc9836ee8d9d97b97
    Loom-Build: unknown 7916c4043a1b57e97a53bc5c111e74c5038a1091 clean
    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
2026-10-13 chore: resync installed Loom surfaces
    <!-- loom:provenance v1 build=unknown ac0bbcf6eda99918e88a0b8893d9762b106a2e45 clean prompts=none sweep=none story=none trace=8597ab8a51d68f9f8ee864fa71904bff host=robb-studio base=ebcfbb7042f14e3655376a3d3c9964ed7a631205 run=loom-run/v1:timer:robb-studio/fleet-resync:2ea9dd71-a6b2-4d0c-86aa-859a0728c9b3 installs=0.19.1151 f7d1deaab02a9c483fce1ced33fadb1af6d86f59 -->
    Loom-Trace-Id: 8597ab8a51d68f9f8ee864fa71904bff
    Loom-Build: unknown ac0bbcf6eda99918e88a0b8893d9762b106a2e45 clean
    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
2026-10-13 chore: resync installed Loom surfaces
    <!-- loom:provenance v1 build=unknown 7916c4043a1b57e97a53bc5c111e74c5038a1091 clean prompts=none sweep=none story=none trace=773e9e41a5730d2f79f2381ad2cde068 host=robb-pro base=81d0706e5858b9f2a057772676923dbff005bc08 run=loom-run/v1:timer:robb-pro/fleet-resync:b7ca0d34-434e-4536-85b9-57adfa603a8d installs=0.19.1151 1ec34f9bb79942506958a3c18a31368f4e065508 -->
    Loom-Trace-Id: 773e9e41a5730d2f79f2381ad2cde068
    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
2026-10-13 chore: resync installed Loom surfaces
    <!-- loom:provenance v1 build=unknown f57244868aa20ef22c18aa8025972184aaea43e4 clean prompts=none sweep=none story=none trace=8e03b78fe6cb43a017c4a4823362ffa7 host=loom-worker-2 base=f3388ff9003d5f6b68a0dae68adbbbd4d63fb963 run=loom-run/v1:timer:loom-worker-2/fleet-resync:eb553d2fc2a54589aa37879f12b18ed5 installs=0.19.1151 a9d9bfc13e966655d6d847cb6876af523bc4a4c4 -->
    Loom-Trace-Id: 8e03b78fe6cb43a017c4a4823362ffa7
    Loom-Build: unknown f57244868aa20ef22c18aa8025972184aaea43e4 clean
    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
2026-10-13 chore: resync installed Loom surfaces
    <!-- loom:provenance v1 build=unknown f91cd239df41290ba3efb8bc14320984e3392c6f clean prompts=none sweep=none story=none trace=c1345a24765b7e1c5307ef032fd77486 host=loom-worker-3 base=c79157a8f372c58d06535c238150fee1ea6d7029 run=loom-run/v1:timer:loom-worker-3/fleet-resync:c4883600330b4d70afac9e743a4e52e3 installs=0.19.1151 a9d9bfc13e966655d6d847cb6876af523bc4a4c4 -->
    Loom-Trace-Id: c1345a24765b7e1c5307ef032fd77486
    Loom-Build: unknown f91cd239df41290ba3efb8bc14320984e3392c6f clean
    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
2026-10-13 chore: resync installed Loom surfaces
    <!-- loom:provenance v1 build=unknown 6fe43c87955e02019c2bc8dfad4fbd160b89170c clean prompts=none sweep=none story=none trace=49a4590bf54e81899c26d965f682504c host=robb-studio base=263eb40329968e9a42f7cffc100218ce21c24ffc run=loom-run/v1:timer:robb-studio/fleet-resync:459197b3-0050-4335-893e-e47b638eb819 installs=0.19.1151 4bba3857a22eb3081c693ff4c5953e9ffb74072b -->
    Loom-Trace-Id: 49a4590bf54e81899c26d965f682504c
    Loom-Build: unknown 6fe43c87955e02019c2bc8dfad4fbd160b89170c clean
    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
2026-10-13 chore: resync installed Loom surfaces
    <!-- loom:provenance v1 build=unknown 27a266d5a27885323290840d2a837d73fcf4bcc6 clean prompts=none sweep=none story=none trace=e77cdd5477ef6bfc65fba6cc233788e0 host=loom-worker-2 base=d945ed73b405ec7a1b6dfe62e417cbe7a703775a run=loom-run/v1:timer:loom-worker-2/fleet-resync:7fac7d82f298441a91761382ac989183 installs=0.19.1152 a7c20e591a04d4acaeeca29fadd7fa4be7ca3122 -->
    Loom-Trace-Id: e77cdd5477ef6bfc65fba6cc233788e0
    Loom-Build: unknown 27a266d5a27885323290840d2a837d73fcf4bcc6 clean
    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
2026-10-13 chore: resync installed Loom surfaces
    <!-- loom:provenance v1 build=unknown f2b62a2cf576d7d37092147b2281da809f8b5cf5 clean prompts=none sweep=none story=none trace=c75aa8454d7b0e20ddf41b71641175d6 host=loom-worker-1 base=e71dd26172cadff170075604f2f853b04792cd9f run=loom-run/v1:timer:loom-worker-1/fleet-resync:0af96cefe4bb43af82d755dbf36e35bf installs=0.19.1152 6f08d823bb588d3a2c559093589099e54d7b9a2d -->
    Loom-Trace-Id: c75aa8454d7b0e20ddf41b71641175d6
    Loom-Build: unknown f2b62a2cf576d7d37092147b2281da809f8b5cf5 clean
    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
2026-10-13 chore: resync installed Loom surfaces
    <!-- loom:provenance v1 build=unknown 84d11f248d368cae5e04a2255f6897a406c50089 clean prompts=none sweep=none story=none trace=8e50b4ccc3dc58f709a732f69d58fd44 host=robb-studio base=4c0d4909721c5481e2859993d3535a18566fa873 run=loom-run/v1:timer:robb-studio/fleet-resync:05c9f3b1-eee2-412f-8996-5fbf02793d9e installs=0.19.1153 d8429a4fabdc955107af1cbc22c548e23eecf9b1 -->
    Loom-Trace-Id: 8e50b4ccc3dc58f709a732f69d58fd44
    Loom-Build: unknown 84d11f248d368cae5e04a2255f6897a406c50089 clean
    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
2026-10-15 feat(column-periphery): isolation-gate, reference-matching and driver sweep with MC offset (#117)
    Sweep (52 variants, 10 corners) and Monte Carlo run through klt sim on the
    batch fleet. Revised slice: nfet-only 0.42 um isolation, matched reference
    precharge (vref), 5 um precharge, 4.0/2.0 um write-driver stack.
    Loom-Story: 2AMLogic/sky130-gcedram#117
    Loom-Trace-Id: 9692c299b8e888cd0d5bbc8b6709ed5d
    Loom-Build: 0.19.1162 f1ee755eeca1954f35bf83d19f4b84ad51feb9f5 clean
2026-10-15 layout: add reproducible compact 2T bitcell variants and density addendum
    klt gen mos_array has no pitch or shared-diffusion control, so two compact
    layouts of the unchanged 2T topology are generated from
    layout/compact/gen_compact.py with the KLayout Python API: v1 (isolated
    stacked devices, 0.985 x 1.98 um) and v2 (mirrored-pair diffusion sharing,
    0.985 x 1.42 um). Each is checked by klt drc/lvs, the PDK's sky130A_mr KLayout
    runset, a gate-level rule checker and the PDK magic drc(full), all committed.
    area_density.py gains --layout-json/--mos-json/--gds/--issue so it can measure
    the variants (default run still reproduces density_20261009.json); new
    append-only density results are register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
2026-10-15 docs: update WORK_PLAN from current label state
    Automated document maintenance by Guide triage agent.
2026-10-15 feat(pdk): re-pin open_pdks to f6eeac7 via ciel and verify PDK revision on resolve
    Default PDK root moves to ~/.ciel; ~/.volare is never searched. The env
    checks read <variant>/SOURCES and fail on a revision mismatch or a missing
    SOURCES. Evidence-era checkers keep c6d73a3 for the append-only records.
    Loom-Story: 2AMLogic/sky130-gcedram#165
    Loom-Trace-Id: a0925c57cd59289344ce1daeff7acbe5
    Loom-Build: 0.19.1166 8a9aad12e32504cea9a7c7d2ed774749c487f875 clean
2026-10-15 docs(pdk): inventory reference records for open_pdks f6eeac7 re-qualification
    Loom-Story: 2AMLogic/sky130-gcedram#166
    Loom-Trace-Id: e02dca96f1d583b286b5546f8e7dc3e2
    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
2026-10-15 docs(pdk): count stamped files directly and add shared-helper row to requalification inventory
    Stamped-files column now uses direct counts (summing to 47 at bea81bb) with a
    stated convention, and sim/test_evidence_common.py gets a reference row.
    Closes #175
    Loom-Story: 2AMLogic/sky130-gcedram#175
    Loom-Trace-Id: 110074bced609c13f8356f52b2d33763
    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
2026-10-16 docs(layout): re-qualify G5 layout and sign-off records under open_pdks f6eeac7
    Add dated f6eeac7 DRC/LVS/ERC and generation-reproduction records plus a
    per-record decision table. Array GDS is byte-identical and all statuses are
    unchanged; only the pdk.version stamp in two generator reports differs.
    Loom-Story: 2AMLogic/sky130-gcedram#172
    Loom-Trace-Id: 621306e6c9f912ae455ac231886ef6f0
    Loom-Build: 0.19.1167 485f7d1deeb27051ebafb710f0b0cda276b49399 clean
2026-10-16 sim: re-qualify sense-stage under open_pdks f6eeac7 (results unchanged)
    New fleet run 20261016T072807Z of the unchanged 10-corner request; points CSV is
    byte-identical to the c6d73a3 run. Historical notes on three uncited studies.
    Loom-Story: 2AMLogic/sky130-gcedram#170
    Loom-Trace-Id: 4cae673e5aa1e20d70d75472476caa77
    Loom-Build: 0.19.1169 db3504e7df39ed71aa43d66b89851b6fe39f2483 clean
2026-10-16 feat(sim): re-qualify G1 leakage and retention chain under open_pdks f6eeac7
    Run the main and geometry-matched leakage grids as klt sim batch requests, append
    f6eeac7-stamped rows, restrict derive_retention to current-pin leakage rows, and
    re-derive retention. Results match the c6d73a3 records; bitcell-transient is split out.
    Loom-Story: 2AMLogic/sky130-gcedram#168
    Loom-Trace-Id: 25926ff6cd491e6c945285f20eba6250
    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
2026-10-16 Unescape backticks in historical notes (during evaluation)
    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
2026-10-20 feat: re-characterise C_SN, parasitics and leakage for the compact bitcell layouts
    Extract the v1/v2 compact arrays (anonymous storage nodes named via a
    critical-net glob), reduce wiring parasitics and word-line resistance against
    the uniform grid, measure access leakage at each layout's extracted junction
    geometry through a klt sim batch request, and re-derive retention at sf/125 C.
    Result: limiting v2 C_SN 0.317 fF, t = 2.69 us; the ratified 10.06 us budget
    is not shown to hold. Append-only evidence; no spec change.
2026-10-22 feat(sim): measure device-inclusive C_SN of the compact v2 array
    Hold-droop slope on the extracted netlist with the BSIM models in the loop,
    15 PVT points via one klt sim batch request; brackets the channel-poly
    double count. Measurement only: no spec or ratified-number change.
2026-10-23 feat: store new run evidence in the fleet artifact store via manifests
    Add sim/store_evidence.py (fail-closed klt artifact put writer with Markdown
    summary), scripts/check_artifact_manifests.py (schema, artifact: URIs, no
    committed bytes) with fixture tests, CI wiring, scratch-dir ignore rule, docs,
    and one small real smoke manifest.
2026-10-25 ci: wire unlisted test suites into evidence-checks and npm test
    Add sim/test_klt_request.py and sim/test_evidence_common.py to the
    workflow, and bring package.json test in line with the workflow by
    adding those plus the three compact-layout suites.
2026-10-27 build: pin klayout-tools 0.8.0 from PyPI and regenerate check evidence
2026-10-28 fix: regenerate layout with klt 0.8.0 generators for a DRC-clean cell and array
    Move the generation pin to klayout-tools==0.8.0 and regenerate the single
    cell and 4x4 array. Both are DRC clean, LVS match, ERC clean under the 0.8.0
    deck (T1 item 3 met again, t1_met_count 3). No rule waived, no GDS post-edit.
    The cell is 1.84 -> 2.115 um tall, so extracted single-cell C_SN moves
    0.605354 -> 0.672741 fF (geometry, not extractor: the old GDS extracted with
    0.8.0 still gives 0.605354). Per the operator ruling, the ratified spec value
    is untouched; a PROPOSED re-ratification record is added. Retention,
    array/compact C_SN comparisons, density and the refresh-energy fleet run are
    re-derived as new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
2026-10-28 sim: re-run five benches on the post-#244 layout as new dated evidence
    Re-run write-disturb, refresh-op, sense-stage, sense-mismatch (stage and
    cell) and column-periphery (incl. both isolation studies) as klt 0.8.0
    batch requests on the regenerated decks. New files only; each bench README
    gains a dated old-vs-new section. No verdict changes. test_column_periphery
    now accepts the absent fleet bucket field that klt 0.8.0 reports emit.
2026-11-02 ci(digital): run spi-crossing protocol suite in the regression driver
2026-11-04 feat(signoff): attest analog T1 items 2, 9 and 10 with anchored envelopes
    Add klt-produced attestation inventories and envelopes for item 9
    (testbenches, single-corner local cold start) and item 10 (repo hygiene),
    and a hand-written generic envelope for item 2 binding both GDS files and
    their generator scripts. Pin the three in block-manifest.json, regenerate
    the verdict (t1_met_count 3 -> 6), re-run the item 9/10 --check in
    signoff.yml, and record in spec/ why item 1 stays a named gap.
2026-11-04 fix(readme): digital regression driver runs 14 suites, not 13; regenerate item 10 envelope
2026-11-04 feat(signoff): attest digital-partition testbenches for T1 item 9
    Inventory the Icarus Verilog benches, runners and digital/ci scripts, with
    the 14-step regression driver as cold start, and pin the klt 0.8.0
    attestation envelope as 9.digital. Rewrite partition_boundary.digital to
    describe the behavioral RTL that exists. CI re-checks the envelope.
2026-11-11 fix(spi-control): single async clear per flop so Yosys proc accepts spi_slave
    Fold cs_n and rst_n into clr_n = rst_n & ~cs_n for the rx/cnt/tx flops, add
    mid-frame cs_n and reset-while-selected testbench cases, a klt synthesize
    request with its committed report, and the clear-structure note.
2026-11-12 fix(spi-control): reset-order spi-sched-phase TB and re-attest item 9 (#273)
    Pulse cs_n before reset in tb_spi_sched_phase.v so the spi_slave frame flops
    see a clear edge (same fix as tb_ctrl_integ.v); run_tests and run_mutation
    pass, results committed. Refresh attest/item9.digital.envelope.json hashes
    with --skip-local-only (cold_start outcome carried; CI re-runs it).
2026-11-14 docs(roadmap): correct the gate-level absence claim and the item-10 referent
    Judge review on PR #278 found one false claim and one ambiguous referent.
    1. "no gate-level netlist or layout is on `main`" was false: a Yosys
    standard-cell-mapped netlist for `spi_slave` is tracked at
    digital/spi-control/results/spi_slave_synth_2026-11-11_issue273.v (259
    sky130_fd_sc instances). Scope the absence claim to what is actually
    missing - the controller top - and name the committed artifact. Verified
    that digital/control-integration/gc_ctrl_top.v on `main` is behavioral
    only (0 sky130_fd_sc instances), so the `gc_ctrl_top` gate-level netlist,
    gate-level replay and layout are genuinel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
2026-11-14 build: move the signoff klt pin to 0.9.1 and regenerate the layout and attest evidence
    `.github/workflows/signoff.yml` `KLT_VERSION` 0.8.0 -> 0.9.1, with every
    artifact the pin grades regenerated on that release so the job is green on
    the new pin.
    The 0.9.1 sky130 deck is a different deck (`provenance.deck.content_hash`
    ba0f9788... -> 029ef177...), so all four committed DRC/LVS reports read
    `drifted` under `klt drc/lvs --check` until regenerated. Re-run against the
    unchanged committed GDS, every verdict holds: DRC `clean`/0 on both cells,
    LVS `match` on both, ERC `clean`/0 findings. The 0.9.1 deck checks three
    more rules here (`diff.space.1`, `poly.space.1`, `tap.space.1`; 44 -> 47),
    all pa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
